tomas-tavella/Proyecto-Final/README.md

# Proyecto-Final
Repositorio para todo lo que respecta al proyecto final de pilas de hidrogeno
