tomas-tavella/Proyecto-Final/Bibliografia/Datasheets - Notas de aplicacion/Datasheets/DSP/Info ControlCARD TMS320F28335/F28335controlCARD HWDevPkg PGF [R1.0]/TMDSCNCD28335r1.0PGF/README.TXT

README.TXT               C2000 Marketing Group - Texas Instruments
==========				 files supplied by www.wstscorp.com

=====================================================================

=====================================================================

  This file has been divided into the following sections for easy
  reference:

	* =	JOB TRACKING NUMBER		  eg. TEX001DAT.zip

        1.  *DAT.ZIP - Pads V2007.4 Databse and Backups
        2.  *FAB.ZIP - Gerber Data for Fabracation House
        3.  *DWG.ZIP - AutoCad 2000, Assembly and Fabrication Drawings
        4.  *ASY.ZIP - Pads V2007.4 Data for Assembly House
        5.  *LIB.ZIP - Pads V2007.4 Decal and Part Library Files
		6.  *SCH.ZIP - Orcad/Powerlogic Schematic files
