tomas-tavella/Proyecto-Final/Bibliografia/Datasheets - Notas de aplicacion/Datasheets/DSP/Info ControlCARD TMS320F28335/F28335controlCARD HWDevPkg PGF [R1.0]/TMDSCNCD28335r1.0PGF/TEX24FAB/Readme.txt

Company Name:		TEXAS INSTRUMENTS
PC Board Name:		F28335 PGF ControlSTICK BOARD        
PC Board Number:	TMDSCNCD28335PGF
Revision:			1.0
Design House:		Willow Spring Technical Services, Corp.

Designed by:          Carl Sangiolo
Contact Number:       (508) 947 - 2709
e-mail:               carl@wstscorp.com
Files Included:

Filename		Description						Format
--------		-----------						------
L1.PHO			Primary Side Cu					Gerber 8.5
L2.PHO			Gnd Plane						Gerber 8.5
L3.PHO			Internal Signal					Gerber 8.5
L4.PHO			Internal Signal					Gerber 8.5
L5.PHO			Pwr Plane 						Gerber 8.5
L6.PHO			Secondary Side Cu				Gerber 8.5
PSS.PHO			Primary Silkscreen A/W			Gerber 8.5
PSM.PHO			Primary Soldermask A/W			Gerber 8.5
SSM.PHO			Secondary Soldermask A/W 		Gerber 8.5
PST.PHO			Primary Solder Stencil A/W 		Gerber 8.5
DD.PHO			Drill Drawing  					Gerber 8.5
NC_DRILL.DRL		NC Drill Data					NC DRILL ASCII																
NC_DRILL.REP		Drill Tool Listing				ASCII
NC_DRILL.LST		Drill X-Y Listing				ASCII
IPCD356.NET		IPC-D-356 Netlist				IPC-D-356 ASCII
README.TXT   	This File						ASCII

NOTES: 

1) USE FILM OUTLINE CORNERS TO ALIGN ARTWORKS

2) ALL THERMALS ARE O.D.  I.D.= O.D. - .020
   WITH A .015 OPEN AT 45 DEGREES.

3) ALL VIAS SHALL HAVE A DIRECT CONNECTION
   TO THE PLANE. NO THERMALS ON VIAS.
