tomas-tavella/Proyecto-Final/Informe/Secciones/Portada.tex

    \begin{titlepage}
        \AddToShipoutPictureBG*{}
        \begin{center}
            %\vspace*{0.1cm}
            \color{white}
            \HUGE\scshape
            \Bold{Diseño y Desarrollo de una Plataforma Experimental de Evaluación de Sistemas Híbridos Basados en Pilas de Combustible}    % Titulo
            \normalfont
            \\
            \vspace{1cm}
            %\tiny\ \xfill[8pt]{2pt}\ \linebreak
            \Huge
            \texttt{Proyecto Final\hspace{1.8em}\rule[-0.2em]{2pt}{1.1em}\hspace{1.8em}Tomás Tavella}                                       % Subtitulo
            \\
            \vfill
            \begin{figure}[H]
                \centering
                \begin{subfigure}{0.3\textwidth}
                    \centering
                    
                \end{subfigure}
                \hspace{2em}
                \begin{subfigure}{0.3\textwidth}
                    \centering
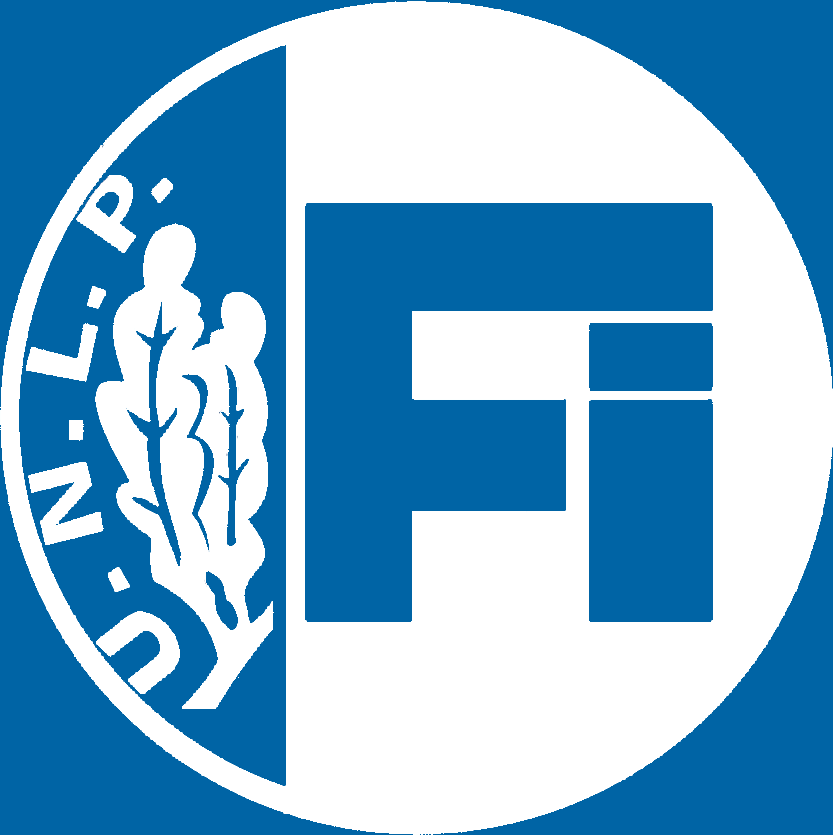
[picture p1: Informe/Imagenes/FI Invertido.png]
                    
                \end{subfigure}
            \end{figure}
            \vspace{0.5cm}
            \begin{multicols}{3}
                \large
                \texttt{Ing. Jorge L. Anderson}
                \\
                \vspace{0.1cm}
                \Large\scshape
                \SemiBold{Director}
                \\
                \normalfont
            \columnbreak
                \Bold\large\scshape
                Instituto LEICI
                \\
                \vspace{0.1cm}
                Facultad de Ingeniería
                \\
                \vspace{0.1cm}
                UNLP
                \\
            \columnbreak
                \vspace{0.1cm}
                \normalfont\large
                \texttt{Dr. Ing. Paul F. Puleston}
                \\
                \vspace{0.1cm}
                \Large\scshape
                \SemiBold{Co-Director}
                \normalfont
            \end{multicols}
        \end{center}
    \end{titlepage}
