tomas-tavella/Proyecto-Final/Informe PPS/Secciones/Portada.tex

    \begin{titlepage}
        \AddToShipoutPictureBG*{}
        \begin{center}
            %\vspace*{0.1cm}
            \color{white}
            \HUGE\scshape
            \Bold{Diseño y Fabricación de una Placa de Circuito Impreso de un Convertidor de Potencia Aislado para Sistema Experimental de Evaluación de Sistemas Híbridos}    % Titulo
            \normalfont
            \\
            \vspace{1cm}
            %\tiny\ \xfill[8pt]{2pt}\ \linebreak
            \Huge
            \texttt{Práctica Profesional Supervisada}\\                                       % Subtitulo
            \vspace{0.2cm}
            \texttt{Tomás Tavella}
            \vfill
            \begin{figure}[H]
                \centering
                \hspace{2.5em}
                \begin{subfigure}
                    \centering
                    
                \end{subfigure}
                \hspace{4em}
                \begin{subfigure}
                    \centering
                    
                \end{subfigure}
            \end{figure}
            \vspace{0.5cm}
            \begin{multicols}{3}
                \large
                \texttt{Ing. Jorge L. Anderson}
                \\
                \vspace{0.1cm}
                \Large\scshape
                \SemiBold{Docente\linebreak Supervisor}
                \\
                \normalfont
            \columnbreak
                \Bold\large\scshape
                Instituto LEICI
                \\
                \vspace{0.1cm}
                Facultad de Ingeniería
                \\
                \vspace{0.1cm}
                UNLP
                \\
            \columnbreak
                \vspace{0.1cm}
                \normalfont\large
                \texttt{Ing. Claus Mancini}
                \\
                \vspace{0.1cm}
                \Large\scshape
                \SemiBold{Profesional Responsable}
                \normalfont
            \end{multicols}
        \end{center}
    \end{titlepage}
