tomas-tavella/Proyecto-Final/Informe PPS/Secciones/2 - Desarrollo/2 - Desarrollo.tex

\section{Desarrollo} \label{desarrollo}
\AddToShipoutPictureBG*{}
\thispagestyle{plain}

\divider

Partiendo de los esquemas circuitales que conforman la plataforma, que en total cuenta con 185 componentes discretos, se procedió a su implementación en una placa de circuito impreso. Como guías generales para su diseño, se estableció que la PCB debía ser de doble capa, con unas dimensiones de aproximadamene \SI[]{15}[]{\centi\metre} x \SI[]{15}[]{\centi\metre}. En tanto a su construcción, se utiliza el sustrato FR-4 estándar (laminado de resina epoxi reforzado con vidrio) y vías de tipo PTH (del inglés \textit{Plated Through-Hole}). En la siguiente figura se puede observar un modelo tridimensional de la plaqueta finalizada, con todos los componentes en sus lugares correspondientes.\\

\begin{figure}[h]
    \centering
    
    \caption{Modelo tridimensional de la implementación en PCB de la plataforma
    con todos sus componentes, vista desde la parte superior.}
    \label{fig:plataforma_det}
\end{figure}

Con este fin se utilizo el software de diseño electrónico {\Medium KiCad}, una suite de software libre, gratuita y de código abierto que incluye todas la funcionalidades necesarias para el diseño electrónico. Cuenta con herramientas de captura de esquemático, diseño de PCB, simulación mediante SPICE o Ngspice, visualización de archivos de fabricación y cálculos de diseño de PCB. Dada la falta de experiencia con este tipo de software, las formas de utilización de la herramienta se aprendieron a medida que se iba completando el trabajo.\\

\newpage

\input{Secciones/2 - Desarrollo/2.1 - Activdades Realizadas.tex}

\newpage

\input{Secciones/2 - Desarrollo/2.2 - Dificultades y Contratiempos.tex}
