tomas-tavella/Proyecto-Final/Reference Designs/Proyecto Irusta-Caravelli/Altium/PCB_2D.PcbDoc.htm

Reporting Options

# File in Previous Format

Date | : | 4/28/2022
Time | : | 11:27:58 PM
Filename | : | D:\Personal\Repositorios\Proyecto-Final\Reference Designs\PF de Convertidor de Potencia\Altium\PCB_2D.PcbDoc

Version | Warning
Release 12 | CAUTION - Air Gap Width previously controlled by Clearance rule is now controlled by Polygon Connect Style rule's newly introduced Air Gap Width (set to default value). Suggest reviewing each Polygon Connect Style rule's Air Gap Width attribute for correctness.
Release 13 | CAUTION - Silkscreen Over Component Pads Rules are converted to Silk To Solder Mask Clearance Rules. Suggest examining rule scopes for accuracy.

This file was generated by an earlier version of the software
