tomas-tavella/Proyecto-Final/Reference Designs/Placa adaptadora TMS320F28335/Proyecto Altium/Project Outputs for Placa adaptadora TMS320F28335/Placa adaptadora TMS320F28335 - PCB.htm

Comment | Description | Designator | Footprint | LibRef | Quantity
C0.1u | Capacitor | C1, C4, C5, C16, C18, C19, C21, C22, C23, C24, C28, C29, C31, C32, C34, C36, C38, C39, C45 | C 1206 | C | 19
C? | Capacitor | C2, C3, C6, C7, C8, C9 | C 1206 | C | 6
C1u | Capacitor | C10, C27, C41 | 0805 | C | 3
C10n | Capacitor | C11, C14, C30, C42 | C 1206 | C | 4
CT2.2u | Tantalum capacitor | C12, C26, C43 | Tantalum | C Tantalum | 3
C27p | Capacitor | C13, C15 | C 1206 | C | 2
C33n | Capacitor | C17 | C 1206 | C | 1
C10u | Capacitor polarzado | C20, C46 | CAP4x7x1.5mm | Capacitor pol | 2
C10u | Capacitor polarzado | C25, C44 | Almn cap | Capacitor pol | 2
C1n | Capacitor | C33 | C 1206 | C | 1
C100p | Capacitor | C35 | C 1206 | C | 1
C0.1uF | Capacitor | C37 | C 1206 | C | 1
C22n | Capacitor | C40 | C 1206 | C | 1
LED | Typical RED GaAs LED | D1 | LED-1 | LED1 | 1
Dpy Amber-CA | 7.62 mm Black Surface Orange 7-Segment Display: CA, RH DP | DS1 | A | Dpy Amber-CA | 1
RJ-45 connector | RJ-45 connector, 8-pins, ethernet | J1 | 15-43-6588 | 15-43-6588 | 1
Jack connector | | J2 | jack | Jack connector | 1
DIM100 | Vertical, DIMM 2P Low Insertion Force, 100 Position | J3 | 390213-1 | 390213-1 | 1
Led smd | LED red, LED green, Led green, Led yellow, Led green, Led yellow | LED1, LED2, LED3, LED4, LED5, LED6 | LED 1206 | LED | 6
USB-B | Conector USB tipo B | P1 | USBB | USB-B | 1
sma | | P2, P3 | sma | sma | 2
Header 5 | Header, 5-Pin | P4, P12 | HDR1X5 | Header 5 | 2
Header 8 | Header, 8-Pin | P5 | HDR1X8 | Header 8 | 1
Header 7X2 | Header, 7-Pin, Dual row | P6 | HDR2X7 | Header 7X2 | 1
5V Header | Header, 2-Pin | P7, P13 | HDR1X2 | Header 2 | 2
5V SW | | P8 | Toggle sw | toggle sw | 1
Jumper 2 | | P9 | Jumper 2 | Jumper 2 | 1
Header 4 | Header, 4-Pin | P10, P11 | HDR1X4 | Header 4 | 2
Header | Header, 3-Pin | P14 | HDR1X3 | Header 3 | 1
IRF7425 | HEXFET Power MOSFET | Q1 | SO-8_L | IRF7425 | 1
R? | Resistencia | R1, R2, R3, R4, R6, R7 | R 1206 | R | 6
R1k | Resistencia | R5, R14, R15, R25, R26, R27, R28, R29, R30, R31, R32, R33, R34, R35, R36, R37, R38, R39, R40 | R 1206 | R | 19
R470 | Resistencia | R8 | R 1206 | R | 1
R27 | Resistencia | R9, R10 | R 1206 | R | 2
R1k5 | Resistencia | R11 | R 1206 | R | 1
R220 | Resistencia | R12, R13, R18, R22, R23, R24 | R 1206 | R | 6
R15 | Resistencia | R16, R17, R20 | R 1206 | R | 3
R10k | Resistencia | R19 | R 1206 | R | 1
R15k | Resistencia | R21, R44 | R 1206 | R | 2
R0 | Resistencia | R41, R42, R43 | R 1206 | R | 3
SW-DIP4 | DIP Switch | S1 | DIP-8 | SW-DIP4 | 1
Switch | | SW1, SW2, SW3, SW4, SW5 | TACT SW | Pulsador NA 4 term | 5
TP TEL3-1211 | | T1 | DIL24 | TP TEL3-1211 | 1
LM324AM | Low Power Quad Operational Amplifier, 14-pin Narrow SOIC | U1 | M14A_N | LM324AM | 1
TXB0104DR | IC VOLT-LEVEL TRANSLATOR 14-SOIC | U2 | SOIC-14 | TXB0104DR | 1
LP2985-33DBVR | Single Output Low Noise LDO, 150 mA, Fixed 3.3 V Output, 2.2 to 16 V Input, with Low IQ, 5-pin SOT-23 (DBV), -40 to 125 degC, Green (RoHS & no Sb/Br) | U3, U7, U10 | TI-DBV5_N | LP2985-10DBVR | 3
FT232BL | USB UART Asynchronous Serial Data Transfer Chip, LQFP-32, Pb-Free | U4 | LQFP-32_N | FT232BL | 1
ISO7631FMDWR | 150 Mbps 6 kVpk Low Power Quad Channels, Digital Isolator, 2.7 V / 3.3 V / 5 V, -40 to +125 degC, 16-pin SOIC (DW), Green (RoHS & no Sb/Br) | U5, U8 | DW0016A_N | ISO7641FMDWR | 2
LM2937-12 | | U6 | DCY4 | LM2937 | 1
uA78M33 | DAC8760 | U9 | PWP | DAC8760 | 1
Jumper | Jumper Wire | W1, W2, W3 | Jumper | Jumper | 3
Cristal de Cuarzo | Cristal de 6Mhz | Y1 | Y TRHU | Cristal de Cuarzo | 1
