tomas-tavella/Proyecto-Final/Reference Designs/Placa adaptadora TMS320F28335/Proyecto Altium/Project Outputs for Placa adaptadora TMS320F28335/Placa adaptadora TMS320F28335.htm

Comment | Description | Designator | Quantity | .PCBCheck
C0.1u | Capacitor | C1, C4, C5, C16, C18, C19, C21, C22, C23, C24, C28, C29, C31, C32, C34, C36, C38, C39, C45 | 19 | Used
C? | Capacitor | C2, C3, C6, C7, C8, C9 | 6 | Used
C1u | Capacitor | C10, C27, C41 | 3 | Used
C10n | Capacitor | C11, C14, C30, C42 | 4 | Used
CT2.2u | Tantalum capacitor | C12, C26, C43 | 3
C27p | Capacitor | C13, C15 | 2 | Used
C33n | Capacitor | C17 | 1 | Used
C10u | Capacitor polarzado | C20, C46 | 2
C10u | Capacitor polarzado | C25, C44 | 2
C1n | Capacitor | C33 | 1 | Used
C100p | Capacitor | C35 | 1 | Used
C0.1uF | Capacitor | C37 | 1 | Used
C22n | Capacitor | C40 | 1 | Used
LED | Typical RED GaAs LED | D1 | 1
Dpy Amber-CA | 7.62 mm Black Surface Orange 7-Segment Display: CA, RH DP | DS1 | 1
RJ-45 connector | RJ-45 connector, 8-pins, ethernet | J1 | 1
Jack connector | | J2 | 1
DIM100 | Vertical, DIMM 2P Low Insertion Force, 100 Position | J3 | 1
Led smd | LED red, LED green, Led green, Led yellow, Led green, Led yellow | LED1, LED2, LED3, LED4, LED5, LED6 | 6 | Used
USB-B | Conector USB tipo B | P1 | 1
sma | | P2, P3 | 2
Header 5 | Header, 5-Pin | P4, P12 | 2
Header 8 | Header, 8-Pin | P5 | 1
Header 7X2 | Header, 7-Pin, Dual row | P6 | 1
5V Header | Header, 2-Pin | P7, P13 | 2
5V SW | | P8 | 1
Jumper 2 | | P9 | 1
Header 4 | Header, 4-Pin | P10, P11 | 2
Header | Header, 3-Pin | P14 | 1
IRF7425 | HEXFET Power MOSFET | Q1 | 1
R? | Resistencia | R1, R2, R3, R4, R6, R7 | 6 | Used
R1k | Resistencia | R5, R14, R15, R25, R26, R27, R28, R29, R30, R31, R32, R33, R34, R35, R36, R37, R38, R39, R40 | 19 | Used
R470 | Resistencia | R8 | 1 | Used
R27 | Resistencia | R9, R10 | 2 | Used
R1k5 | Resistencia | R11 | 1 | Used
R220 | Resistencia | R12, R13, R18, R22, R23, R24 | 6 | Used
R15 | Resistencia | R16, R17, R20 | 3 | Used
R10k | Resistencia | R19 | 1 | Used
R15k | Resistencia | R21, R44 | 2 | Used
R0 | Resistencia | R41, R42, R43 | 3 | Used
SW-DIP4 | DIP Switch | S1 | 1
Switch | | SW1, SW2, SW3, SW4, SW5 | 5 | G
TP TEL3-1211 | | T1 | 1
LM324AM | Low Power Quad Operational Amplifier, 14-pin Narrow SOIC | U1 | 1
TXB0104DR | IC VOLT-LEVEL TRANSLATOR 14-SOIC | U2 | 1
LP2985-33DBVR | Single Output Low Noise LDO, 150 mA, Fixed 3.3 V Output, 2.2 to 16 V Input, with Low IQ, 5-pin SOT-23 (DBV), -40 to 125 degC, Green (RoHS & no Sb/Br) | U3, U7, U10 | 3
FT232BL | USB UART Asynchronous Serial Data Transfer Chip, LQFP-32, Pb-Free | U4 | 1
ISO7631FMDWR | 150 Mbps 6 kVpk Low Power Quad Channels, Digital Isolator, 2.7 V / 3.3 V / 5 V, -40 to +125 degC, 16-pin SOIC (DW), Green (RoHS & no Sb/Br) | U5, U8 | 2
LM2937-12 | | U6 | 1
uA78M33 | DAC8760 | U9 | 1
Jumper | Jumper Wire | W1, W2, W3 | 3
Cristal de Cuarzo | Cristal de 6Mhz | Y1 | 1 | Used
