tomas-tavella/Proyecto-Final/Reference Designs/Placa adaptadora TMS320F28335/Proyecto Altium/Project Outputs for Placa adaptadora TMS320F28335/Placa adaptadora TMS320F28335 - PCB.xls

Sheet: 佂⁍敒潰瑲 UI '
2015-05-13 | 13:56:07
0 | 0:00:00
C 1206 | C0.1u | C | Capacitor
C 1206 | C? | C | Capacitor
0805 | C1u | C | Capacitor
C 1206 | C10n | C | Capacitor
Tantalum | CT2.2u | C Tantalum | Tantalum capacitor
C 1206 | C27p | C | Capacitor
C 1206 | C33n | C | Capacitor
CAP4x7x1.5mm | C10u | Capacitor pol | Capacitor polarzado
Almn cap | C10u | Capacitor pol | Capacitor polarzado
C 1206 | C1n | C | Capacitor
C 1206 | C100p | C | Capacitor
C 1206 | C0.1uF | C | Capacitor
C 1206 | C22n | C | Capacitor
LED-1 | LED | LED1 | Typical RED GaAs LED
A | Dpy Amber-CA | Dpy Amber-CA | 7.62 mm Black Surface Orange 7-Segment Display: CA, RH DP
15-43-6588 | RJ-45 connector | 15-43-6588 | RJ-45 connector, 8-pins, ethernet
jack | Jack connector | Jack connector
390213-1 | DIM100 | 390213-1 | Vertical, DIMM 2P Low Insertion Force, 100 Position
LED 1206 | Led smd | LED | LED red, LED green, Led green, Led yellow, Led green, Led yellow
USBB | USB-B | USB-B | Conector USB tipo B
sma | sma | sma
HDR1X5 | Header 5 | Header 5 | Header, 5-Pin
HDR1X8 | Header 8 | Header 8 | Header, 8-Pin
HDR2X7 | Header 7X2 | Header 7X2 | Header, 7-Pin, Dual row
HDR1X2 | 5V Header | Header 2 | Header, 2-Pin
Toggle sw | 5V SW | toggle sw
Jumper 2 | Jumper 2 | Jumper 2
HDR1X4 | Header 4 | Header 4 | Header, 4-Pin
HDR1X3 | Header | Header 3 | Header, 3-Pin
SO-8_L | IRF7425 | IRF7425 | HEXFET Power MOSFET
R 1206 | R? | R | Resistencia
R 1206 | R1k | R | Resistencia
R 1206 | R470 | R | Resistencia
R 1206 | R27 | R | Resistencia
R 1206 | R1k5 | R | Resistencia
R 1206 | R220 | R | Resistencia
R 1206 | R15 | R | Resistencia
R 1206 | R10k | R | Resistencia
R 1206 | R15k | R | Resistencia
R 1206 | R0 | R | Resistencia
DIP-8 | SW-DIP4 | SW-DIP4 | DIP Switch
TACT SW | Switch | Pulsador NA 4 term
DIL24 | TP TEL3-1211 | TP TEL3-1211
M14A_N | LM324AM | LM324AM | Low Power Quad Operational Amplifier, 14-pin Narrow SOIC
SOIC-14 | TXB0104DR | TXB0104DR | IC VOLT-LEVEL TRANSLATOR 14-SOIC
TI-DBV5_N | LP2985-33DBVR | LP2985-10DBVR | Single Output Low Noise LDO, 150 mA, Fixed 3.3 V Output, 2.2 to 16 V Input, with Low IQ, 5-pin SOT-23 (DBV), -40 to 125 degC, Green (RoHS & no Sb/Br)
LQFP-32_N | FT232BL | FT232BL | USB UART Asynchronous Serial Data Transfer Chip, LQFP-32, Pb-Free
DW0016A_N | ISO7631FMDWR | ISO7641FMDWR | 150 Mbps 6 kVpk Low Power Quad Channels, Digital Isolator, 2.7 V / 3.3 V / 5 V, -40 to +125 degC, 16-pin SOIC (DW), Green (RoHS & no Sb/Br)
DCY4 | LM2937-12 | LM2937
PWP | uA78M33 | DAC8760 | DAC8760
Jumper | Jumper | Jumper | Jumper Wire
Y TRHU | Cristal de Cuarzo | Cristal de Cuarzo | Cristal de 6Mhz
 |  |  |  | 0

Sheet: 牐橯捥⁴湉潦浲瑡潩netPreview
13:56:07
2015-05-13
2015-05-13 13:56
