tomas-tavella/Proyecto-Final/Informe/Informe Trabajo Final.tex

\documentclass[10pt,twoside]{article}                           % Twoside para poder poner números en lados alternados

\usepackage[spanish,es-tabla]{babel}                                     % Configuración de lenguaje
\usepackage[a4paper,top=2cm,bottom=2cm,left=3cm,right=3cm,marginparwidth=1.75cm]{geometry}          % Configurar tamaño de pagina y márgenes
%\usepackage[a4paper, top=2cm, bottom=2cm, outer=0cm, inner=0cm]{geometry}
\usepackage{fancyhdr}
\usepackage[autostyle=true]{csquotes}
\usepackage[backend=biber,sorting=none]{biblatex}               % Paquete para bibliografía 
\addbibresource{Bibliografia.bib}                               % Llamo al archivo que contiene las referencias
\usepackage{amsmath}
\usepackage{amsfonts}
\usepackage{makecell}                                           % Para poder poner line breaks en tablas
\renewcommand\cellgape{\Gape[4pt]}
\usepackage{caption}                                            % Para que "Figura x.y" este en bold
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
    \hspace{-0.05em}\xfill[0.6ex]{1pt}\hspace{-0.05em}%
    \rule[-0.2em]{1pt}{1.1em}\color{AzulFI_dark}\hspace{0.5em}\rightmark\normalcolor\hspace{0.5em}\rule[-0.2em]{1pt}{1.1em}%
    }

\fancyhead[R,L]{}

\renewcommand{\headrulewidth}{0pt}
\setlength{\headheight}{12.60013pt}

\fancypagestyle{plain}{
    \fancyhead[L,C,R]{}
    %\fancyfoot[C]{}                                                    % Sólo va con el estilo viejo
    \renewcommand{\headrulewidth}{0pt}                                  % Para que no haya linea horizontal de encabezado en las páginas de índice y título de sección
}

% Parametros para setear como se muestra el codigo

\lstdefinestyle{mystyle}{                       
    backgroundcolor=\color{backcolour},
    commentstyle=\color{codegreen},
    keywordstyle=\color{magenta},
    numberstyle=\tiny\color{codegray},
    stringstyle=\color{codepurple},
    basicstyle=\ttfamily\scriptsize,
    breakatwhitespace=false,         
    breaklines=true,                 
    captionpos=b,                    
    keepspaces=true,                 
    numbers=left,                    
    numbersep=5pt,                  
    showspaces=false,                
    showstringspaces=false,
    showtabs=false,                  
    tabsize=4
}

\lstset{style=mystyle}

% Macro para divisores horizontales

\newcommand{\divider}                           
{
\vspace{0.4cm}
\begin{center}
    \tiny\ \xfill[8pt]{1pt}\ \ \linebreak
\end{center}
%\vspace{0.25cm}
\normalsize
}

% Macro para usar colorbox en ecuaciones

\newcommand{\highlight}[1]{\colorbox{AzulFI_light}{$\displaystyle #1$}}

% Macro para comillas

\newcommand{\quotes}[1]{``#1''}                 % Comando para double quotes

% Números de figura y ecuación por seccion (1.1 , 2.1, etc.)

\numberwithin{figure}{section}                  % Numeros de figura por seccion
\numberwithin{equation}{section}                % Numeros de ecuacion por seccion
\numberwithin{table}{section}

% Definir formato de titulos de secciones y subsecciones

\titleformat{\section}[display]                                     % display permite el numero en linea separada del nombre
{\raggedright\color{AzulFI_dark}\scshape\Bold\Huge\centering}       % Formato del título de seccion
{\normalcolor\tiny\ \Huge\xfill[8pt]{1pt}\rule[-0.2em]{1pt}{1.1em}\hspace{0.5em}\color{white}\thesection\normalcolor\hspace{0.5em}\rule[-0.2em]{1pt}{1.1em}\xfill[8pt]{1pt}\tiny\ }{0.5em}{}       % Formato del número de seccion

\titleformat{\subsection}[hang]{\raggedright\color{AzulFI_dark}\scshape\huge\Bold}{\thesubsection\quad}{0.5em}{}                      % Se agrega raggedright a todos para que no separe palabras en dos cuando tiene que hacer un line break

\titleformat{\subsubsection}[hang]{\raggedright\color{AzulFI_dark}\scshape\Large\Bold}{\thesubsubsection\quad}{0.5em}{}
\titleformat{\paragraph}[hang]{\raggedright\color{AzulFI_dark}\large\SemiBold}{}{0.5em}{}
\titleformat*{\subparagraph}{\raggedright\SemiBold}

% Formato de captions de figuras

\DeclareCaptionFormat{custom}
{%
    \SemiBold\scshape\color{AzulFI_dark} #1#2 \normalfont\normalcolor \textit{#3}                     % #1 es el número, #2 el separador y #3 el texto
}
\captionsetup{format=custom}

% Formato de Table of Contents (ToC)

\contentsmargin{1em}
\dottedcontents{section}[1.5em]{\large\vspace{0.4cm}\Bold\scshape\color{AzulFI_dark}}{1.5em}{0pc}      % Secciones en Bold en TableofContents
\dottedcontents{subsection}[4em]{\vspace{0.1cm}\Medium}{2.5em}{0.6pc}
\dottedcontents{subsubsection}[7.5em]{}{3.5em}{0.6pc}

\hyphenation{KiCad}         % Para que no separe KiCad en sílabas

%---------------------------------------------------------------------------------------------------------%
%------------------------------------------ Inicio de Documento ------------------------------------------%
%---------------------------------------------------------------------------------------------------------%

\begin{document}

    \nocite{*}                                                      % Se usa para que aparezcan todas la referencias del .bib sin tener que citarlas en el texto

    \newgeometry{top=2.3cm,bottom=2cm,left=1cm,right=1cm,marginparwidth=1.75cm}
    %\newpagecolor{AzulFI}\afterpage{\restorepagecolor\blankpage}    % Página en blanco entre portada y agradecimientos

    \input{Secciones/Portada.tex}
    \restoregeometry\blankpage
    
    \addtocounter{page}{-1}
    \newpage 
    \thispagestyle{empty}                                           % Para que no se muestre el número de página al final (igual contribuye a la cuenta total)
    \afterpage{\ncblankpage}

    \input{Secciones/Agradecimientos.tex}

    \newpage
    \thispagestyle{empty}
    \afterpage{\blankpage}

    \input{Secciones/Abstract.tex}

    \newpage
    \afterpage{\thispagestyle{plain}} 
    \thispagestyle{plain}
    \tableofcontents
    %\afterpage{\blankpage}
    \newpage

    \input{Secciones/1 - Introduccion/1 - Introduccion.tex}
    
    \newpage

    \input{Secciones/2 - Analisis de la Plataforma/2 - Analisis de la Plataforma.tex}

    \newpage

    \input{Secciones/3 - Diseno de la Plataforma/3 - Diseno de la Plataforma.tex}

    \newpage

    \input{Secciones/4 - Implementacion de la Plataforma/4 - Implementacion de la Plataforma.tex}

    \newpage

    \input{Secciones/5 - Puebas y Ensayos/5 - Pruebas y Ensayos.tex}

    \newpage

    \input{Secciones/Conclusiones.tex}

    \afterpage{\blankpage}\newpage
    \thispagestyle{plain}
    \printbibliography[heading=bibintoc,title={Referencias}]
    \thispagestyle{plain}
    
\end{document}
