tomas-tavella/Proyecto-Final/Informe/Secciones/Agradecimientos.tex

\huge
\scshape\color{AzulFI_dark}
\Bold{Agradecimientos}\\

\normalsize\normalfont\normalcolor

\itshape

\noindent
A mis padres, que desde siempre están a mi lado ayudándome para lo que sea,\\
tanto en las buenas como en las malas.\\

\noindent
A mi hermano y mi hermana, los mejores compañeros que podría haber pedido,\\
y con quienes comparto todos mis recuerdos.\\

\noindent
A todos mis amigos, que hicieron de esta fase de mi vida más alegre y disfrutable,\\
y sin quienes no la podría haber completado.\\
