tomas-tavella/Proyecto-Final/Informe/Secciones/5 - Puebas y Ensayos/5.4 - Resumen.tex

\subsection{Resumen}

En este capítulo, se pudo dar un cierre satisfactorio al trabajo llevado a cabo en este proyecto, ya que se pudo comprobar su funcionamiento correcto, operando dentro de los parámetros esperables.\\

Se comenzó por evaluar el funcionamiento de los circuitos de excitación sin ningún tipo de carga ni corriente significativa, de manera de realizar un ensayo inicial seguro, protegiendo los componentes de la placa. El ensayo fue exitoso, y procedió sin fallas, mostrando un comportamiento adecuado de los circuitos evaluados.\\

Una vez exitosos los primeros ensayos, se procedió a relevar el comportamiento del convertidor completo, en condiciones de carga bajas y moderadas que se podrían presentar en el uso de la plataforma. Si bien se identificó un problema significativo en el ringing, que podría amenazar la integridad de los componentes en ciertas condiciones, también se propuso una posible solución de fácil implementación para mitigar el problema. Además, se pudo comprobar el funcionamiento eficiente del sistema, que en ningún ensayo bajó de 90\% su eficiencia energética, incluso para bajas cargas.\\
