tomas-tavella/Proyecto-Final/Informe/Secciones/2 - Analisis de la Plataforma/2 - Analisis de la Plataforma.tex

\section{Análisis de la Plataforma} \label{analisis}
\AddToShipoutPictureBG*{}
\thispagestyle{plain}

\vspace{0.5cm}

\Large\scshape
\begin{center}
    {\Medium Planteo y estudio de la plataforma de evaluación\\ de celdas de combustible}
\end{center}
\normalfont
%\normalsize

\divider

En este capítulo, se realiza un detallado análisis de la Plataforma Experimental de Evaluación de Módulos de Celdas de Combustible de la figura \ref{diag_plataforma}, la cuál consiste en cuatro subsistemas o bloques distintos: 

\begin{itemize}
    \Medium \item Emulador de Celdas de Combustible
    \Medium \item Convertidor CC-CC Conmutado
    \Medium \item Sistema de Control
    \Medium \item Carga Electrónica Variable\\
\end{itemize}

\begin{figure}[h]
    \centering
    
    \caption{Diagrama de la plataforma experimental de evaluación, con sus cuatro bloques principales.}
    \label{diag_plataforma}
\end{figure}

Esta plataforma, con sus distintos bloques, se encarga de evaluar la \textit{performance} de celdas de combustible conectadas a un sistema híbrido de generación. Con este fin, un emulador de celdas de combustible toma el puesto de celdas de combustible reales, y una carga electrónica variable se utiliza para simular cualquier tipo de condiciones de carga que se deseen en el bus de CC. Para poder conectar el emulador a la carga, se debe implementar un subsistema (Convertidor CC-CC Conmutado) que adapte los niveles de tensión de salida del emulador de celdas a la tensión fija de salida en la carga, adicionando un módulo de control que monitorea los estados del convertidor, y los controla mediante los disparos de las llaves del puente completo.\\

El principal objetivo de este proyecto es el diseño e implementación de la etapa de adaptación de tensión (es decir, el convertidor con su sistema de control), pero se hace un estudio detallado de todas los componentes de la plataforma, de manera de obtener un entendimiento más completo de todo el sistema. Por esta razón, a continuación se hace un análisis en profundidad de cada una de las partes individuales, comenzando por el emulador de celdas de combustible.\\

\input{Secciones/2 - Analisis de la Plataforma/2.1 - Celdas de Combustible.tex}

\newpage

\input{Secciones/2 - Analisis de la Plataforma/2.2 - Convertidor CC-CC Conmutado.tex}

\newpage

\input{Secciones/2 - Analisis de la Plataforma/2.3 - Sistema de Control.tex}

\newpage

\input{Secciones/2 - Analisis de la Plataforma/2.4 - Carga Electronica Variable.tex}

\newpage

\input{Secciones/2 - Analisis de la Plataforma/2.5 - Resumen.tex}

\newpage
