tomas-tavella/Proyecto-Final/Informe/Imagenes/Git.pdf

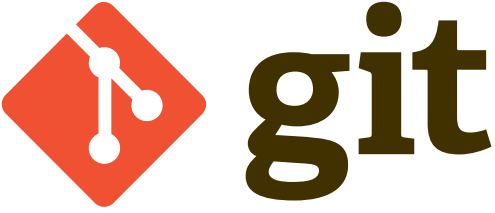
[picture p88: figure]
