tomas-tavella/Proyecto-Final/Informe/Imagenes/Duty Cycle.pdf

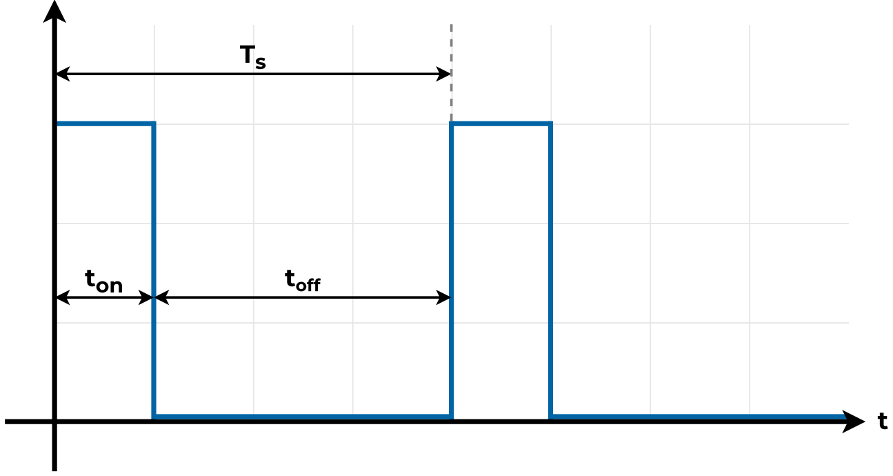
[picture p89: figure]
