tomas-tavella/Proyecto-Final/Reference Designs/Proyecto Irusta-Caravelli/Hojas de datos y notas de aplicación/Capacitores REC SR.pdf

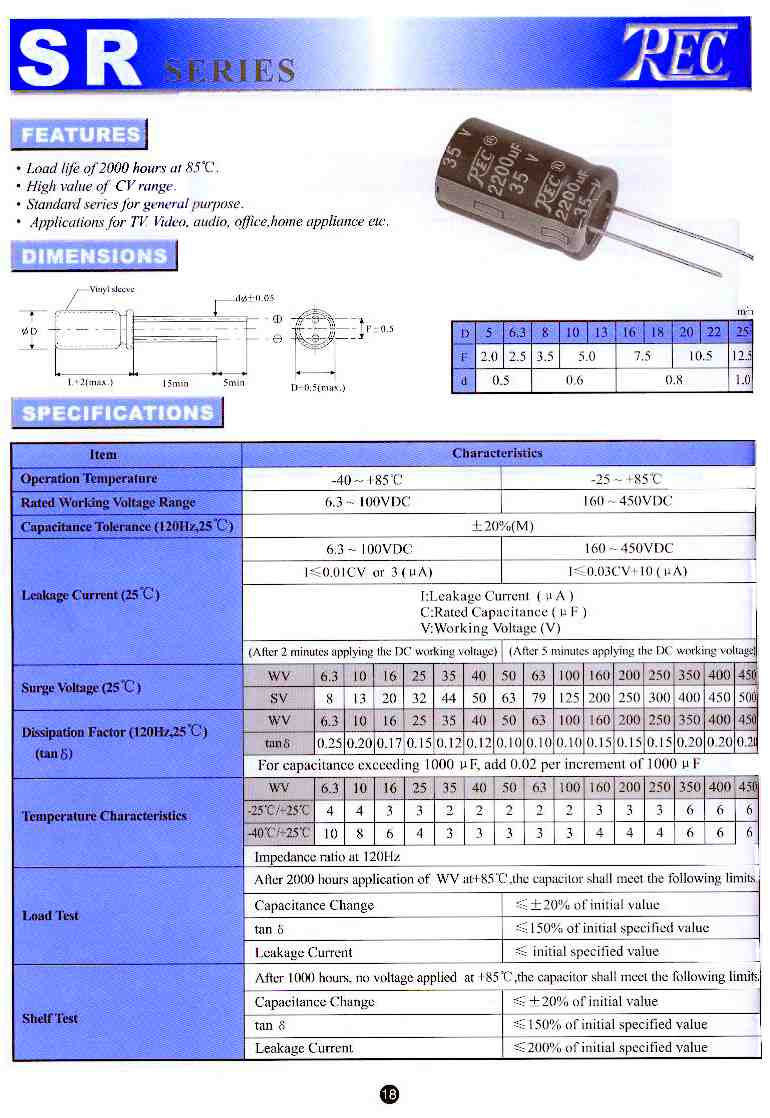
[picture p90: page 1]
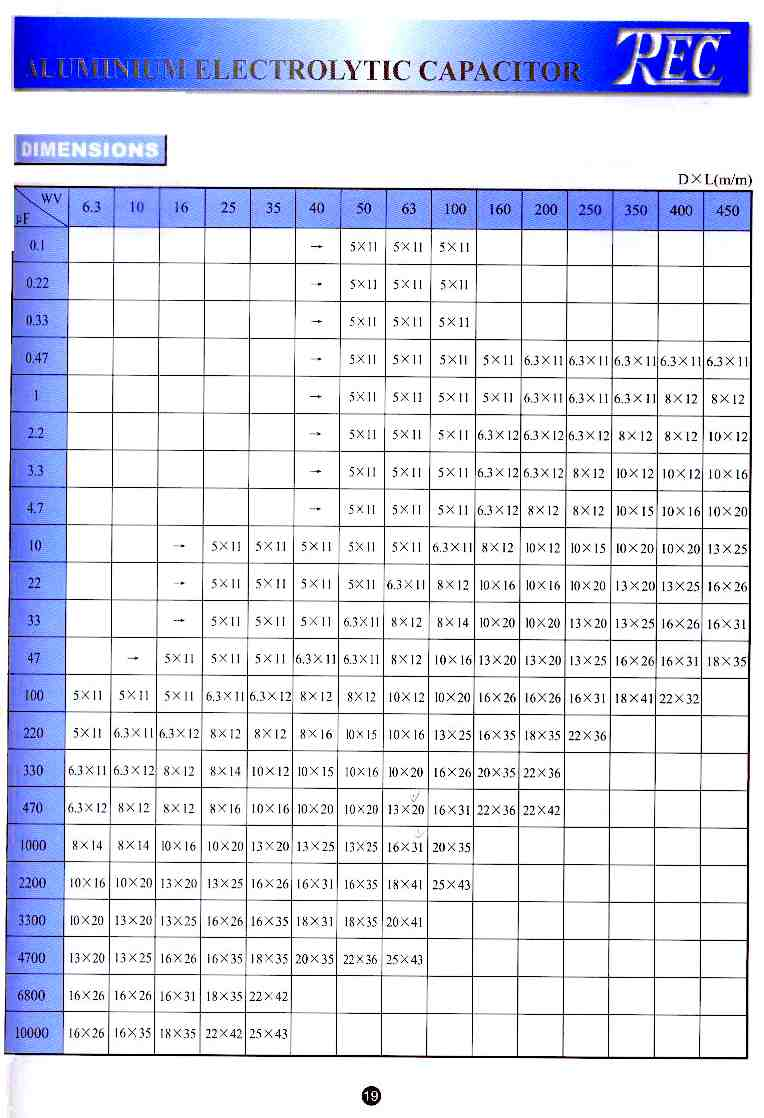
[picture p91: page 2]
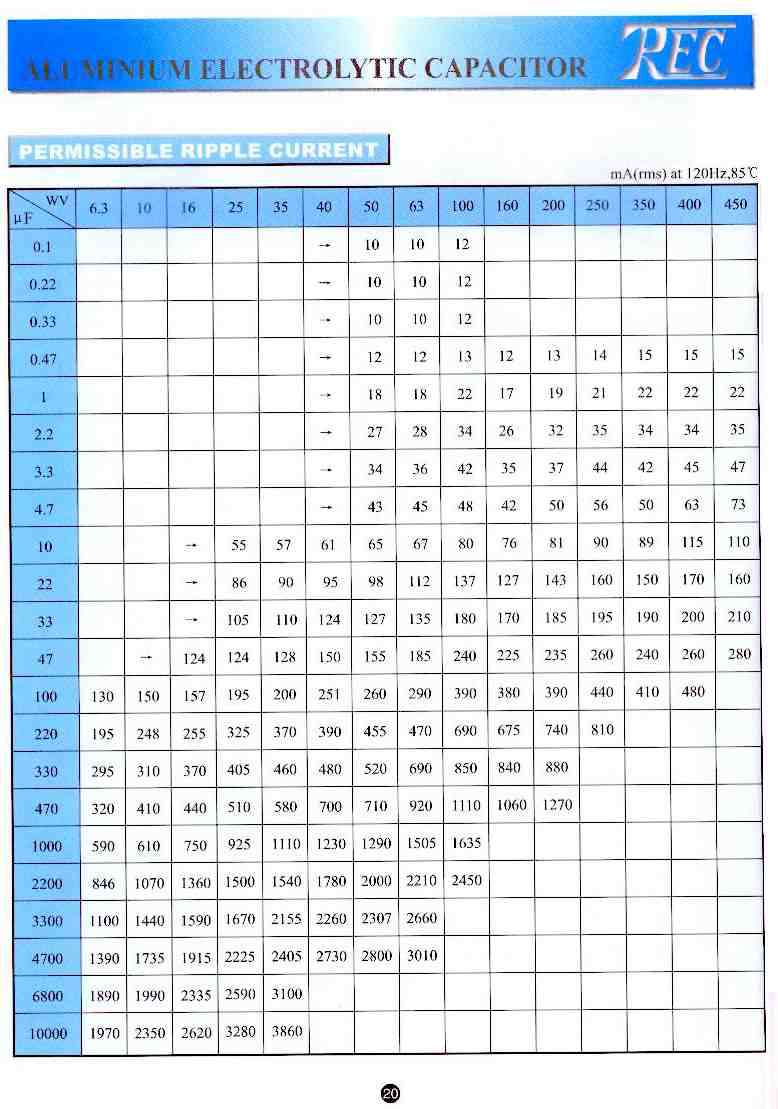
[picture p92: page 3]
