tomas-tavella/Proyecto-Final/Reference Designs/Firmware DSP/Librerias/f2833x/examples/eqep_freqcal/Example_freqcal.xls

150 MHz
 | CPU Freq | 150000000 |  |  | Inputs
 | Maximum Required Freq | 10000 | BaseFreq |  | Output information needed for configuration
 | Minimum Required Freq | 50 |  |  | Information
FREQ_UTIME | Freq measurement rate (Hz) | 100 | UTPRD | Unit Time period to be programmed for100Hz
 | Freq Resolution | 50
 | QEP Count at Max Freq | 200 | freqScalar_fr
FREQ_PRD | QEP edges for avg time measurement(2^k) | 4 | QCAPCTL.UPPS | Unit position prescalar to 1/4
 | Time for selected QEP edges at min RPM(s) | 0.04 | T= edges/(2*Fmin)
 | QEP CAP clock to avoid overflow(Hz) | 1638375 | Fcapmax=maxcnt/T
 | Minimum QEP Clock pre-scalar | 91.55413138
 | QEP Prescalar | 128 | QCAPCTL.CCPS | Capture clock prescaler to 1/128
 | CAP Count value at MAX freq(Freq Scalar) | 234 | freqScaler_pr
100 MHz
 | CPU Freq | 100000000 |  |  | Inputs
 | Maximum Required Freq | 10000 | BaseFreq |  | Output information needed for configuration
 | Minimum Required Freq | 50 |  |  | Information
FREQ_UTIME | Freq measurement rate (Hz) | 100 | UTPRD | Unit Time period to be programmed for100Hz
 | Freq Resolution | 50
 | QEP Count at Max Freq | 200 | freqScalar_fr
FREQ_PRD | QEP edges for avg time measurement(2^k) | 8 | QCAPCTL.UPPS | Unit position prescalar to 1/8
 | Time for selected QEP edges at min RPM(s) | 0.08 | T= edges/(2*Fmin)
 | QEP CAP clock to avoid overflow(Hz) | 819188 | Fcapmax=maxcnt/T
 | Minimum QEP Clock pre-scalar | 122.0721007
 | QEP Prescalar | 128 | QCAPCTL.CCPS | Capture clock prescaler to 1/128
 | CAP Count value at MAX freq(Freq Scalar) | 313 | freqScaler_pr
