tomas-tavella/Proyecto-Final/Reference Designs/Firmware DSP/Librerias/f2833x/examples/eqep_pos_speed/Example_posspeed.xls

150 MHz
 | CPU Freq | 150000000 |  |  | Inputs
 | Encoder Resolution (4xQEP Lines) | 4000 |  |  | Output information needed for configuration
 | Maximum Required Speed (RPM) | 6000 | BaseRpm |  | Information
 | Minimum Required Speed (Rpm) | 10
SPEED_FREQ | Speed measurement rate (Hz) | 100 | UTPRD | Unit Time period to be programmed for100Hz
 | Speed Resolutions(Rpm) | 1.5
SPEED_PRD | QEP edges for avg time measurement(2^k) | 32 | QCAPCTL.UPPS | Unit position prescalar to 1/32
 | Time for selected QEP edges at min RPM(s) | 0.048 | T=(edgecnt/enc_resol)* (fmin_prd) | Time it takes 32 edges to occur
 | QEP CAP clock to avoid overflow(Hz) | 1365313 | QPOSCNTmax/T
 | Minimum QEP Clock pre-scalar | 109.8649174 | SYSCLKOUT/CAPCLK
 | QEP Prescalar | 128 | QCAPCTL.CCPS | Capture clock prescaler to 1/128
 | CAP Count value at MAX speed(Speed Scalar) | 94 | SpeedScaler
100 MHz
 | CPU Freq | 100000000 |  |  | Inputs
 | Encoder Resolution (4xQEP Lines) | 4000 |  |  | Output information needed for configuration
 | Maximum Required Speed (RPM) | 6000 | BaseRpm |  | Information
 | Minimum Required Speed (Rpm) | 10
SPEED_FREQ | Speed measurement rate (Hz) | 100 | UTPRD | Unit Time period to be programmed for100Hz
 | Speed Resolutions(Rpm) | 1.5
SPEED_PRD | QEP edges for avg time measurement(2^k) | 32 | QCAPCTL.UPPS | Unit position prescalar to 1/32
 | Time for selected QEP edges at min RPM(s) | 0.048 | T=(edgecnt/enc_resol)* (fmin_prd) | Time it takes 32 edges to occur
 | QEP CAP clock to avoid overflow(Hz) | 1365313 | QPOSCNTmax/T
 | Minimum QEP Clock pre-scalar | 73.24327828 | SYSCLKOUT/CAPCLK
 | QEP Prescalar | 128 | QCAPCTL.CCPS | Capture clock prescaler to 1/128
 | CAP Count value at MAX speed(Speed Scalar) | 63 | SpeedScaler
