tomas-tavella/Proyecto-Final/Conversor/Cuentas Circuito Proteccion.png

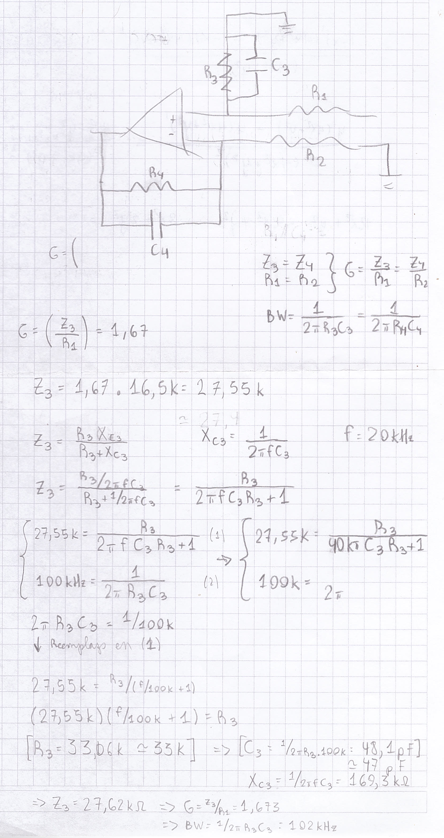
Conversor/Cuentas Circuito Proteccion.png
