tomas-tavella/Proyecto-Final/Conversor/Esquematico/Diagrama.png

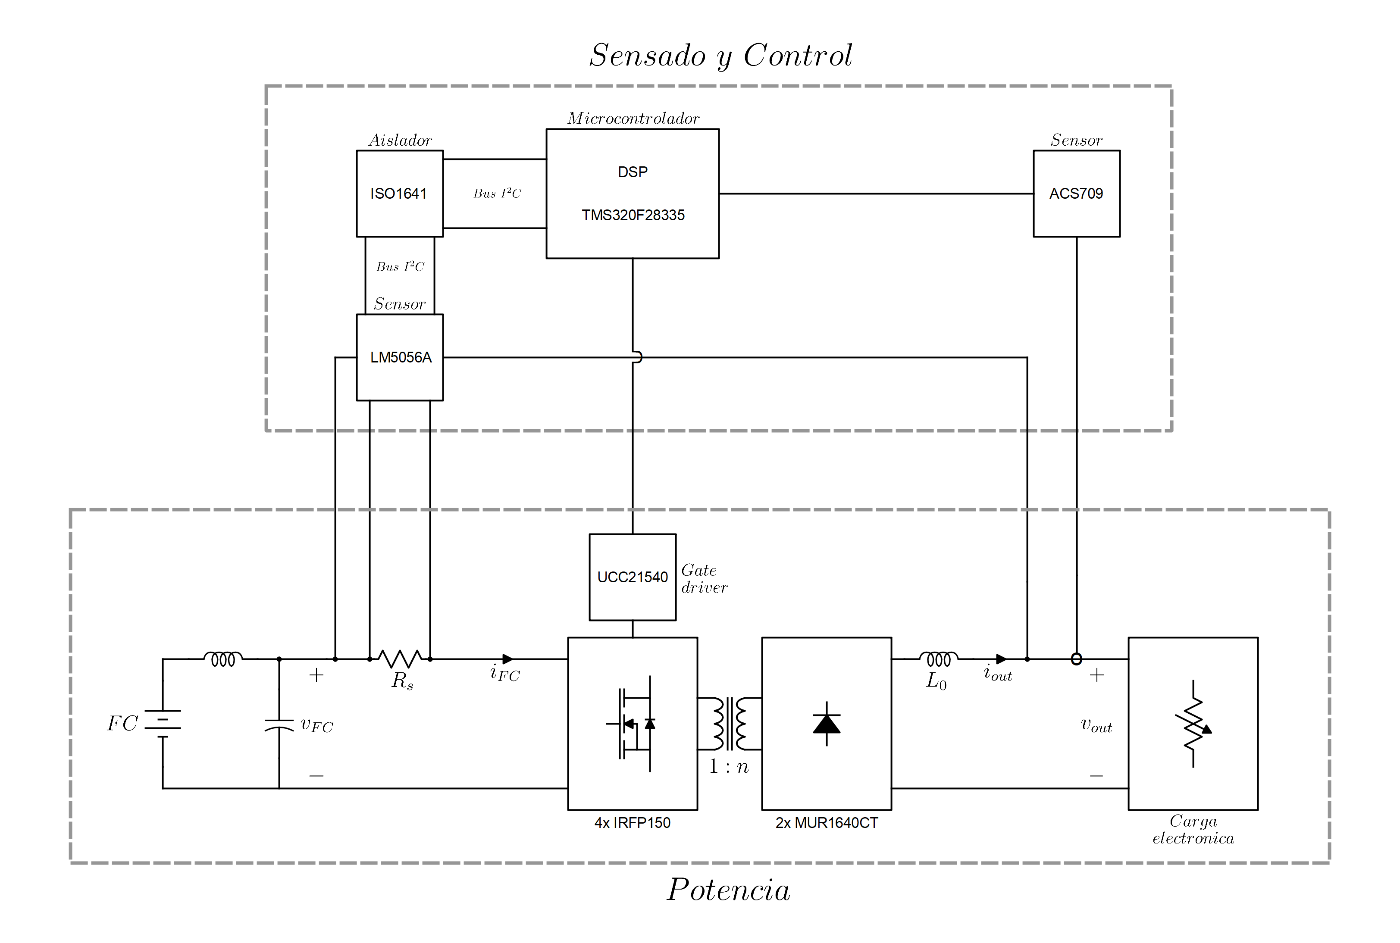
Conversor/Esquematico/Diagrama.png
