tomas-tavella/Proyecto-Final/Reference Designs/Proyecto Irusta-Caravelli/Fotos/P1020036.JPG

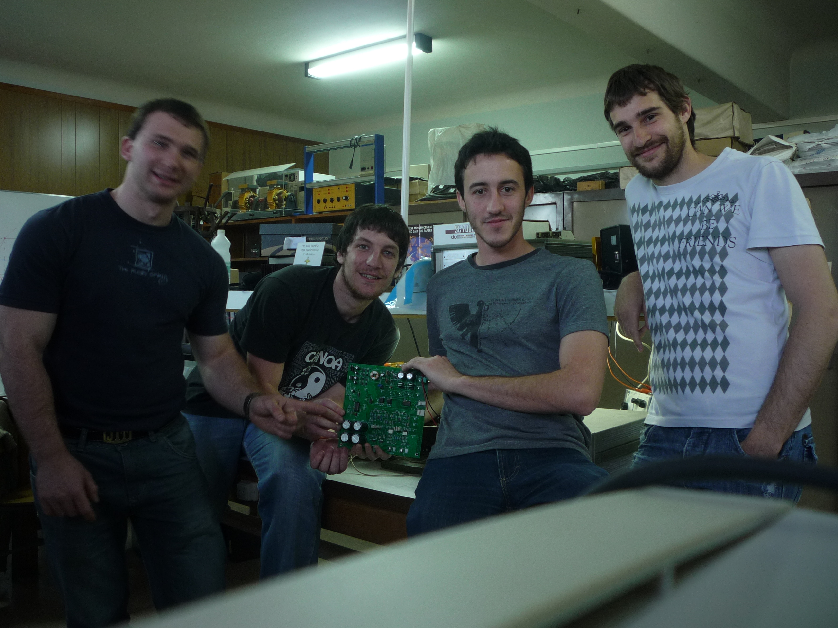
Reference Designs/Proyecto Irusta-Caravelli/Fotos/P1020036.JPG
