tomas-tavella/Proyecto-Final/Reference Designs/Proyecto Irusta-Caravelli/Fotos/P1020132.JPG

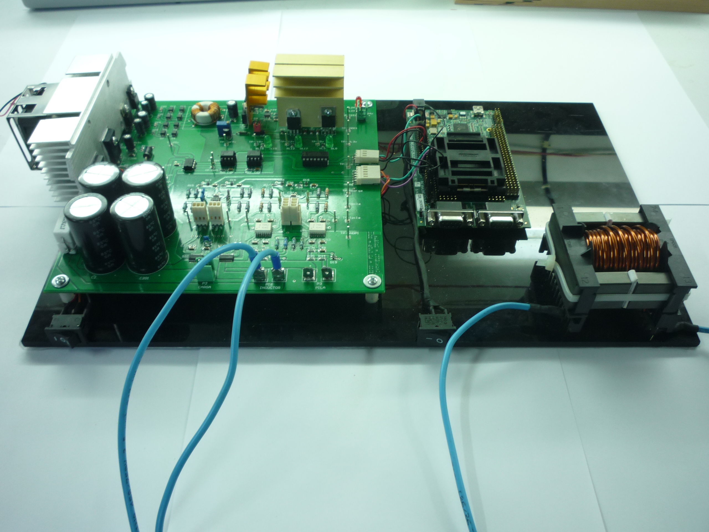
Reference Designs/Proyecto Irusta-Caravelli/Fotos/P1020132.JPG
