tomas-tavella/Proyecto-Final/componentes.md

# Eleccion de componentes para el circuito

- Diodos: MUR860 x4 Ultrafast rectifiers 8.0A, 600V -- Disponible en Elemon (para diodos del puente)
		  MUR160 x2 Ultrafast rectifiers 1.0A, 600V (para Dboot)
		  1N4148 x4 High-speed diodes (para Roff en los drivers)
		  MBR0520 Schottky diode (proteccion de sobretension en salida de op-amp)

- Llaves: MOSFET IRFP150 x4 (100V de Vdsmax, 30A de Idmax y Rds(on) de 55mohm) -- Hay en el laboratorio -- Paquete TO-247AC

- Drivers: Infineon Technologies 2ED21834-S06J 650 V half-bridge gate driver with integrated bootstrap diode -- Paquete DSO-14

- Isolator: Texas Instruments ISO7242C Quad-Channel Digital Isolator -- Paquete SOIC-16 (En el laboratorio)
 	   
- Optoacopladores: Broadcom ACPL-P480 High CMR Intelligent Power Module and Gate Drive Interface Optocoupler  -- Paquete SO-6

- Sensor I/V/P: Texas Instuments LM5056A 3 to 80V, 12-bit, I2C output -- Paquete HSSTOP-28 (con pad abajo)

- Sensor efecto hall: Texas Instruments TMCS1100A4 1% High-Precision, Basic Isolation Hall-Effect Current Sensor With ±600V Working Voltage -- Paquete SOIC-8

- DSP/MCU: Plaqueta Texas Instruments TMDSCNCD28335 -- TMS320F28335 DSP -- Slot DIMM100

- Fuente aislada para parte digital: TRACO THB 3-1211 9-18 Vdc in

- Reguladores: Fairchild Semi LM7805 3-Terminal 1A Positive Voltage Regulator (para +5VP) -- Paquete TO-252/D-PAK
               Texas Instruments LP2985 150-mA, Low-Noise, Low-Dropout Regulator With Shutdown -- Paquete SOT-23-5 (Usado en placa adaptadora)

- Op-Amp: Texas Instruments OPA365AID 50-MHz, Zerø-Crossover, Low-Distortion, High CMRR, RRI/O, Single-Supply Operational Amplifier -- Paquete SOIC-8
