tomas-tavella/Proyecto-Final/Conversor/Compra Componentes/Componentes DICOMSE.xlsx

Capacitores
Tipo | Valor | Cantidad | Empaquetado
Tantalio SMD | 4.7uF - 25V | 10 | 3528
Resistencias
Tipo | Valor | Cantidad | Empaquetado
Diodos
Tipo | Valor | Cantidad | Empaquetado
Transistores
Tipo | Valor | Cantidad | Empaquetado
Circuitos integrados
Tipo | Valor | Cantidad | Empaquetado
Otros
Tipo | Valor | Cantidad | Empaquetado
Tira pines macho | 1x40 | 10 | THT P2.54mm
