tomas-tavella/Proyecto-Final/Conversor/Compra Componentes/Componentes Microelectronica.xlsx

Capacitores
Tipo | Valor | Cantidad | Empaquetado
Cerámico SMD | 0.1uF | 50 | 1206 (3216) | Faltan
Aluminio SMD | 10uF - 10V | 10 | D=3mm L=5.4mm | Hay de 10uF pero son electroliticos THT
Resistencias
Tipo | Valor | Cantidad | Empaquetado
Resistencia SMD | 3.3k (5%) | 50 | 1206 (3216)
Diodos
Tipo | Valor | Cantidad | Empaquetado
Otros
Tipo | Valor | Cantidad | Empaquetado
Cristal | 6MHz | 2 | THT
Switch Pulsador 4 pines | - | 20 | THT
Llave Palanca 3 patas | - | 5 | LP-SW-213CI | https://www.microelectronicash.com/lp-sw-213ci--det--LP-SW-213CI
Conector jack | - | 2 | JK-DC021 | https://www.microelectronicash.com/jk-dc021--det--JK-DC021
