tomas-tavella/Proyecto-Final/Bibliografia/Datasheets - Notas de aplicacion/Datasheets/DSP/DIM100ExperimentersKit-HWdevPkg_v2_0/R2/BH28xxxDockingStn-BOM[R2].xls

Sheet: Sheet1
BH28xxx Docking Station [R2]
Item | Description | Digikey Part # | Mouser Part # | Comments
U1 | Linear - 3.3 Vreg - TPS79533 | 296-13810-1
C1 | Cer. Cap - 1u, 16V, X7R, 0805 | 399-1284-2
C2 | Cer. Cap - 4u7, 10V, X7R, 0805 | 445-1605-2
C3 | Cer. Cap - 100n, X7R, 0805, decoupling
R1 | Res. - 470R, 5%, 0.1W, 0805
LD1 | LED, green, low current, 0805 | P516CT
JP1 | Power jack 2.5 x 5.5 mm | CP-002BH
SW1 | Miniture SPDT switch PCB mount | CKN1072
J1 | 100 pin DIMM socket - Molex 0876301001 |  | 538-87630-1001
J2 | standard 0.1" pin (DIL) headers 14 pin (2x7) |  |  | Remove pin 6
J3, 4,5,6,7,8 | standard 0.1" pin (SIL) headers cut to length
Boot-280xx | standard 0.1" pin (DIL) headers 6 pin (2x3)
Boot-2833x | standard 0.1" pin (DIL) headers 8 pin (2x4)

Sheet: Sheet2
BH28044 | DIM100
C1 | 22u
C1 | 1u
C1 | 4u7
C2 | 10u
C2 | 100n
C2 | 47u
C3 | 330u
C3 | 4u7
C4 | 10n
C4 | 100n
C5 | 330u
C5 | 47u
C6 | 330u
C7 | 330u
C8 | 330u
C9 | 1u
COMMS
J1 | JMP
JP1 | 12V in
JTAG | DIL-14
LED
LED1
LED2
LED3
LED4
LED5
LED6
LED7
LED8
M1 | PTH08D110W
M2 | PTH08D110W
M3 | PTH08D110W
M4 | PTH08D110W
M5 | PTH08D110W
M6 | PTH08D110W
M7 | PTH08D110W
M8 | PTH08D110W
M9 | PTH08080
PR1 | ?
PR2 | ?
PR3 | ?
Q1 | IRFR024N
R1 | 5K
R1 | 330R
R1 | 270R
R1 | 100R
R2 | 10R
R2 | 1K5
R2 | 330R
R3 | 330R
R4 | 5K
R5 | 5K
RL | 330R
RN1 | RNx9
SW1 | SPDT
U1 | TPS79533
U1 | TSOP32238
U1 | UCC27424
U2 | HC595
U3 | SN74LV4051A
