tomas-tavella/Proyecto-Final/Conversor/Proyecto-KiCAD/Proyecto-KiCAD.ods

Component Count: | 185
Ref | Q | Value | Footprint | Description
C1, C2, C3, | 3 | C | Capacitor_THT:CP_Radial_D4.0mm_P2.00mm | Electrolítico pitch 2mm
C4, | 1 | 1nF | Capacitor_SMD:C_1206_3216Metric_Pad1.33x1.80mm_HandSolder | Cerámico SMD 1206 (3216)
C5, C6, C10, C11, C13, C18, C20, C25, C26, C27, C28, C37, C48, C49, C50, C55, C56, C59, | 18 | 0.1uF | Capacitor_SMD:C_1206_3216Metric_Pad1.33x1.80mm_HandSolder | Cerámico SMD 1206 (3216)
C7, | 1 | 10pF | Capacitor_SMD:C_1206_3216Metric_Pad1.33x1.80mm_HandSolder | Cerámico SMD 1206 (3216)
C8, C9, | 2 | 47pF | Capacitor_SMD:C_1206_3216Metric_Pad1.33x1.80mm_HandSolder | Cerámico SMD 1206 (3216)
C12, C23, C29, C30, C54, C58, | 6 | 10nF | Capacitor_SMD:C_1206_3216Metric_Pad1.33x1.80mm_HandSolder | Cerámico SMD 1206 (3216)
C14, C15, C22, C31, C32, C53, | 6 | 1uF | Capacitor_SMD:C_1206_3216Metric_Pad1.33x1.80mm_HandSolder | Cerámico SMD 1206 (3216)
C16, | 1 | 0.33uF | Capacitor_SMD:C_1206_3216Metric_Pad1.33x1.80mm_HandSolder | Cerámico SMD 1206 (3216)
C17, | 1 | 4.7uF | Capacitor_Tantalum_SMD:CP_EIA-3528-12_Kemet-T | Tantalio SMD (3528)
C19, | 1 | 4.7uF | Capacitor_SMD:CP_Elec_3x5.4 | Aluminio SMD pitch 3mm
C21, | 1 | 10uF | Capacitor_SMD:CP_Elec_3x5.4 | Aluminio SMD pitch 3mm
C24, | 1 | 2.2uF | Capacitor_SMD:C_1206_3216Metric_Pad1.33x1.80mm_HandSolder | Cerámico SMD 1206 (3216)
C33, C34, | 2 | 0.2uF | Capacitor_SMD:C_1206_3216Metric_Pad1.33x1.80mm_HandSolder | Cerámico SMD 1206 (3216)
C35, C36, | 2 | 3.3uF | Capacitor_THT:CP_Radial_D4.0mm_P2.00mm | Electrolítico pitch 2mm
C38, C47, | 2 | 680uF | Capacitor_THT:CP_Radial_D25.0mm_P10.00mm_SnapIn | Electrolítico pitch 10mm D25mm (de filtrado de entrada y salida)
C39, C40, C41, C42, | 4 | C | Capacitor_SMD:C_1206_3216Metric_Pad1.33x1.80mm_HandSolder | Cerámico SMD 1206 (3216)
C43, C44, C45, C46, | 4 | C | Capacitor_THT:CP_Radial_Tantal_D4.5mm_P2.50mm | Tantalio THT pitch 2.5mm
C51, C52, | 2 | 27pF | Capacitor_SMD:C_1206_3216Metric_Pad1.33x1.80mm_HandSolder | Cerámico SMD 1206 (3216)
C57, | 1 | 10uF | Capacitor_THT:CP_Radial_D4.0mm_P1.50mm | Electrolítico pitch 1.5mm
C60, | 1 | 2.2uF | Capacitor_THT:CP_Radial_D4.0mm_P2.00mm | Electrolítico pitch 2mm
C61, | 1 | 33nF | Capacitor_SMD:C_1206_3216Metric_Pad1.33x1.80mm_HandSolder | Cerámico SMD 1206 (3216)
D1, D2, D3, D4, | 4 | MUR860 | Package_TO_SOT_THT:TO-220F-2_Vertical | Diodo Potencia TO-220 Vertical
D5, D6, D7, D8, | 4 | 1N4148 | Diode_THT:D_DO-35_SOD27_P7.62mm_Horizontal | Diodo THT pitch 7.62mm
D9, | 1 | MBR0520 | Diode_SMD:D_SOD-123 | Diodo Schottky SMD
D10, D11, | 2 | BAS40-04 | Package_TO_SOT_SMD:SOT-23 | Diodo Schottky SMD SOT-23 (3 Pines)
J3, | 1 | Barrel_Jack_Switch | Connector_BarrelJack:BarrelJack_GCT_DCJ200-10-A_Horizontal | Barrel Jack 3 Pines
J4, J5 | 2 | Header Screw | Phoenix-Contact-2P:Phoenix-Contact-2P | Screw Terminal de +5VD y VDDA (12V)
J6, J7, J8, J9, J10 | 5 | Screw Terminal | DegsonScrewTerminal:Degson_Screw_Terminal_block_01x02 | Screw Terminal Grande (Emulador, trafo, inductor y carga)
J11, | 1 | DIMM100 | 5390213-1:TE_5390213-1
LED1, LED2, LED3, LED4, LED5, LED6, | 6 | Led smd | Diode_SMD:D_1206_3216Metric_Pad1.42x1.75mm_HandSolder | LED SMD 1206 (3216)
P1, P2, | 2 | Switch | Connector_PinHeader_2.54mm:PinHeader_1x03_P2.54mm_Vertical | Switch Selector 5V y VDDA
P3, | 1 | 5V Header | Connector_PinHeader_2.54mm:PinHeader_1x02_P2.54mm_Vertical | Header Vertical pitch 2.54mm – 1x2
P4, | 1 | Jumper 2 | Connector_PinHeader_2.54mm:PinHeader_1x03_P2.54mm_Vertical | Jumper/Header pitch 2.54mm – 1x3
P5, | 1 | Header 7X2 | Connector_PinSocket_2.54mm:PinSocket_2x07_P2.54mm_Vertical | Conector J-TAG pitch 2.54mm – 2x7
P6, | 1 | Header UART | Connector_PinSocket_2.54mm:PinSocket_1x04_P2.54mm_Vertical | Header Vertical pitch 2.54mm - 1x4
P7, | 1 | Header I2C | Connector_PinHeader_2.54mm:PinHeader_1x04_P2.54mm_Vertical | Header Vertical pitch 2.54mm – 1x4
P8, | 1 | Header PWM | Connector_PinHeader_2.54mm:PinHeader_1x08_P2.54mm_Vertical | Header Vertical pitch 2.54mm – 1x8
P9, | 1 | Header ADC | Connector_PinHeader_2.54mm:PinHeader_1x05_P2.54mm_Vertical | Header Vertical pitch 2.54mm – 1x5
P10, | 1 | Header GPIO | Connector_PinHeader_2.54mm:PinHeader_1x08_P2.54mm_Vertical | Header Vertical pitch 2.54mm – 1x8
P11, | 1 | Header SD | Connector_PinSocket_2.54mm:PinSocket_1x06_P2.54mm_Horizontal | Header Socket Horizontal pitch 2.54mm – 1x6 (Lector de SD)
P12, | 1 | USB-B | Connector_USB:USB_B_Lumberg_2411_02_Horizontal | USB Type B connector
Q1, Q2, Q3, Q4, | 4 | IRFP150 | Package_TO_SOT_THT:TO-247-3_Vertical | MOSFET THT TO-247 Vertical - 3 pines (Transistores Potencia)
Q5, | 1 | MMBT3904 | Package_TO_SOT_SMD:SOT-23 | BJT SMD SOT-23 – 3 pines (Adaptación de I2C)
Q6, | 1 | IRF7425 | Package_SO:SOIC-8_3.9x4.9mm_P1.27mm | Power MOSFET SMD SOIC-8 (Circuito del FTDI)
R1, R2, R3, R23, R24, R25, R26, | 7 | R | Resistor_SMD:R_1206_3216Metric_Pad1.30x1.75mm_HandSolder | SMD 1206 (3216)
R4, R5, R15, R49, | 4 | 4.7k | Resistor_SMD:R_1206_3216Metric_Pad1.30x1.75mm_HandSolder | SMD 1206 (3216)
R6, | 1 | 2.49k | Resistor_SMD:R_1206_3216Metric_Pad1.30x1.75mm_HandSolder | SMD 1206 (3216)
R7, | 1 | 612 | Resistor_SMD:R_1206_3216Metric_Pad1.30x1.75mm_HandSolder | SMD 1206 (3216)
R8, | 1 | 22 | Resistor_SMD:R_1206_3216Metric_Pad1.30x1.75mm_HandSolder | SMD 1206 (3216)
R9, | 1 | 3.12k | Resistor_SMD:R_1206_3216Metric_Pad1.30x1.75mm_HandSolder | SMD 1206 (3216)
R10, | 1 | 84.5 | Resistor_SMD:R_1206_3216Metric_Pad1.30x1.75mm_HandSolder | SMD 1206 (3216)
R11, R12, | 2 | 27.4k | Resistor_SMD:R_1206_3216Metric_Pad1.30x1.75mm_HandSolder | SMD 1206 (3216)
R13, R14, | 2 | 16.5k | Resistor_SMD:R_1206_3216Metric_Pad1.30x1.75mm_HandSolder | SMD 1206 (3216)
R16, R17, R18, R19, | 4 | 5.6 | Resistor_SMD:R_1206_3216Metric_Pad1.30x1.75mm_HandSolder | SMD 1206 (3216)
R20, R21, | 2 | 2 | Resistor_SMD:R_1206_3216Metric_Pad1.30x1.75mm_HandSolder | SMD 1206 (3216)
R22, | 1 | 0.004 | Resistor_SMD:R_Shunt_Vishay_WSK2512_6332Metric_T2.21mm | Shunt SMD 2512 (6332) (Resistor 4mohm MercadoLibre)
R27, R28, R29, R30, | 4 | R | Resistor_THT:R_Axial_DIN0204_L3.6mm_D1.6mm_P5.08mm_Horizontal | THT pitch 5.08mm (Paralelo diodos potencia)
R31, R33, R35, R37, R45, R46, | 6 | 220 | Resistor_SMD:R_1206_3216Metric_Pad1.30x1.75mm_HandSolder | SMD 1206 (3216)
R32, R34, R36, R38, R39, R41, | 6 | 1k | Resistor_SMD:R_1206_3216Metric_Pad1.30x1.75mm_HandSolder | SMD 1206 (3216)
R40, | 1 | 470 | Resistor_SMD:R_1206_3216Metric_Pad1.30x1.75mm_HandSolder | SMD 1206 (3216)
R42, R43, | 2 | 27 | Resistor_SMD:R_1206_3216Metric_Pad1.30x1.75mm_HandSolder | SMD 1206 (3216)
R44, | 1 | 1k5 | Resistor_SMD:R_1206_3216Metric_Pad1.30x1.75mm_HandSolder | SMD 1206 (3216)
R47, R48, R50, | 3 | 0 | Resistor_SMD:R_1206_3216Metric_Pad1.30x1.75mm_HandSolder | SMD 1206 (3216)
SW1, SW2, SW3, SW4, SW5, | 5 | Switch | Button_Switch_THT:SW_PUSH_6mm | Pulsador THT pitch 6mm
TP1, | 1 | TP-GNDD | TestPoint:TestPoint_THTPad_2.0x2.0mm_Drill1.0mm | test point
TP2, | 1 | TP-VG1 | TestPoint:TestPoint_THTPad_2.0x2.0mm_Drill1.0mm | test point
TP3, | 1 | TP-VG3 | TestPoint:TestPoint_THTPad_2.0x2.0mm_Drill1.0mm | test point
TP4, | 1 | TP-VG2 | TestPoint:TestPoint_THTPad_2.0x2.0mm_Drill1.0mm | test point
TP5, | 1 | TP-VG4 | TestPoint:TestPoint_THTPad_2.0x2.0mm_Drill1.0mm | test point
TP6, | 1 | TP-GND1 | TestPoint:TestPoint_THTPad_2.0x2.0mm_Drill1.0mm | test point
TP7, | 1 | TP-GND2 | TestPoint:TestPoint_THTPad_2.0x2.0mm_Drill1.0mm | test point
TP8, | 1 | VAUX | TestPoint:TestPoint_THTPad_2.0x2.0mm_Drill1.0mm | test point
U1, | 1 | OPA365xxD | Package_SO:SOIC-8_3.9x4.9mm_P1.27mm | Op-Amp Acondicionamiento ADC
U2, | 1 | ISO7242C | Package_SO:SOIC-16W_7.5x10.3mm_P1.27mm | Aislador I2C
U3, | 1 | LM5056APMH/NOPB | Package_SO:HTSSOP-28-1EP_4.4x9.7mm_P0.65mm_EP2.85x5.4mm | Sensor Tensión/Corriente
U4, | 1 | TMCS1100A4 | Package_SO:SOIC-8_3.9x4.9mm_P1.27mm | Sensor Corriente Efecto Hall
U5, | 1 | LM7805_TO252 | Package_TO_SOT_SMD:TO-252-2 | Regulador Lineal +5VP
U6, | 1 | THB3-1211 | Package_DIP:DIP-24_W15.24mm | Fuente TRACO
U7, U15, | 2 | LP2985-3.3 | Package_TO_SOT_SMD:SOT-23-5 | Regulador Lineal 3V3
U8, U9, U10, U11, | 4 | ACPL-P480 | Package_SO:SSO-6_6.8x4.6mm_P1.27mm_Clearance7mm | Optoacopladores para drivers
U12, U13, | 2 | 2ED21834-S06J | Package_SO:SO-14_3.9x8.65mm_P1.27mm | Drivers de MOSET
U14, | 1 | FT232BL | Package_QFP:LQFP-32_7x7mm_P0.8mm | FTDI
Y1, | 1 | 6 MHz | Crystal:Crystal_HC18-U_Vertical | Cristal/Oscilador
