tomas-tavella/Proyecto-Final/Conversor/Cuentas componentes conversor.pdf

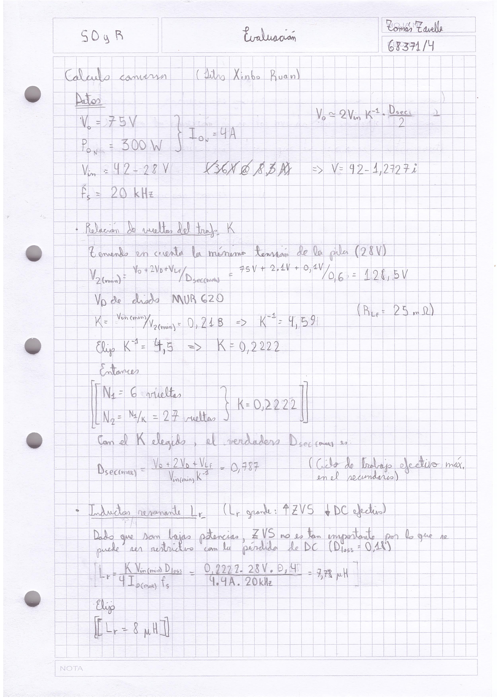
[picture p98: page 1]
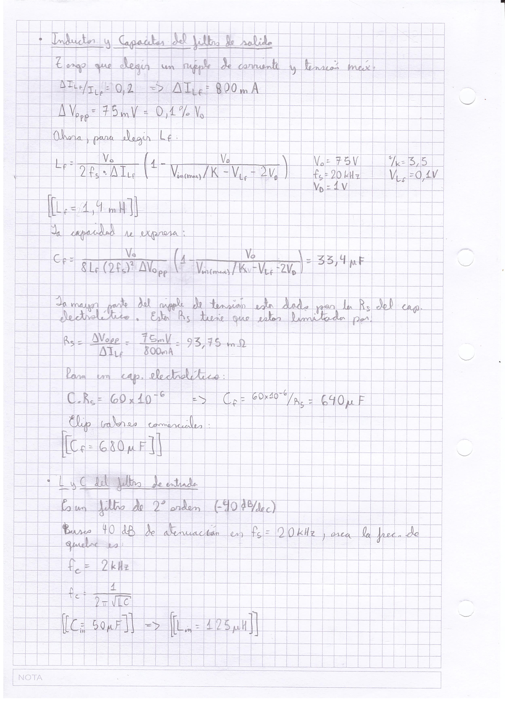
[picture p99: page 2]
