tomas-tavella/Proyecto-Final/Reference Designs/Placa adaptadora TMS320F28335/Proyecto Altium/Models 3d/BT/User Library-HC-06.STEP

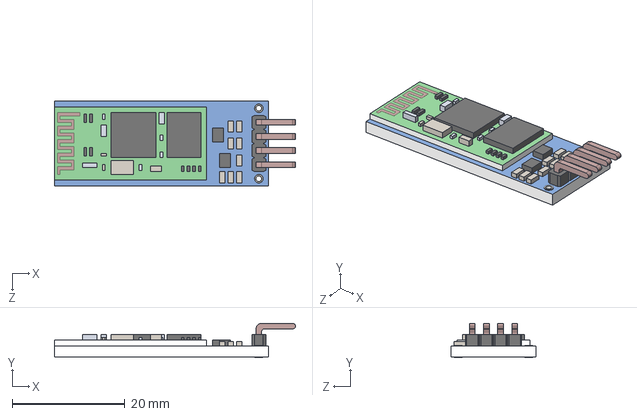
[picture p100: CAD file, 2022-05-13]
Reference Designs/Placa adaptadora TMS320F28335/Proyecto Altium/Models 3d/BT/User Library-HC-06.STEP
42.8 x 6.10 x 15.0 mm
