tomas-tavella/Proyecto-Final/Reference Designs/Placa adaptadora TMS320F28335/Proyecto Altium/Models 3d/C0805/User Library-0805(2012M) Cap.STEP

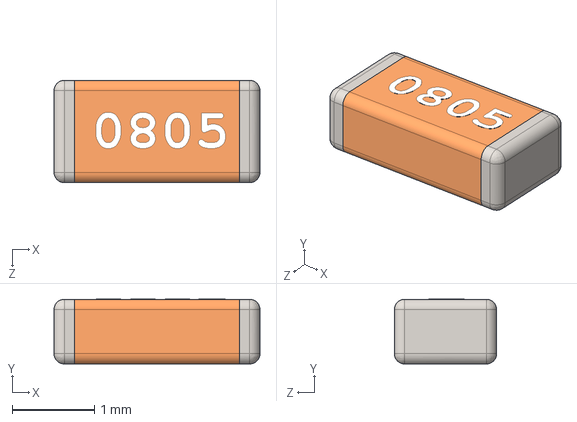
[picture p101: CAD file, 2022-05-13]
Reference Designs/Placa adaptadora TMS320F28335/Proyecto Altium/Models 3d/C0805/User Library-0805(2012M) Cap.STEP
2.51 x 0.79 x 1.24 mm
