tomas-tavella/Proyecto-Final/Reference Designs/Placa adaptadora TMS320F28335/Proyecto Altium/Models 3d/Card control/SW3dPS-pc2100s_256mb.STEP

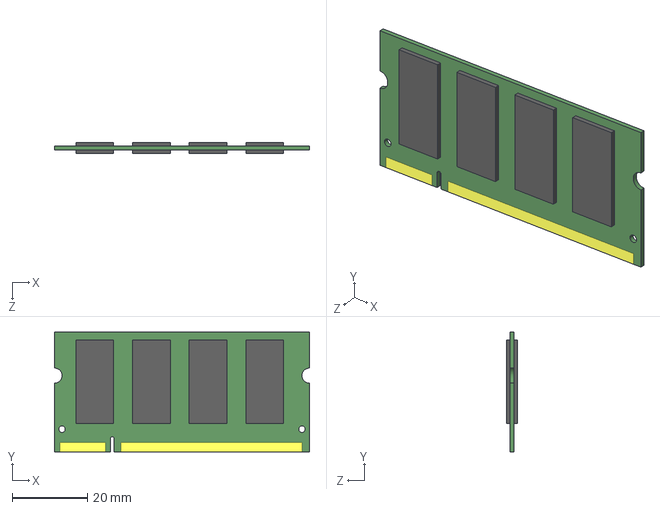
[picture p102: CAD file, 2022-05-13]
Reference Designs/Placa adaptadora TMS320F28335/Proyecto Altium/Models 3d/Card control/SW3dPS-pc2100s_256mb.STEP
67.6 x 31.7 x 3.00 mm
