tomas-tavella/Proyecto-Final/Reference Designs/Placa adaptadora TMS320F28335/Proyecto Altium/Models 3d/Header 10/User Library-SIL_Socket10_.STEP

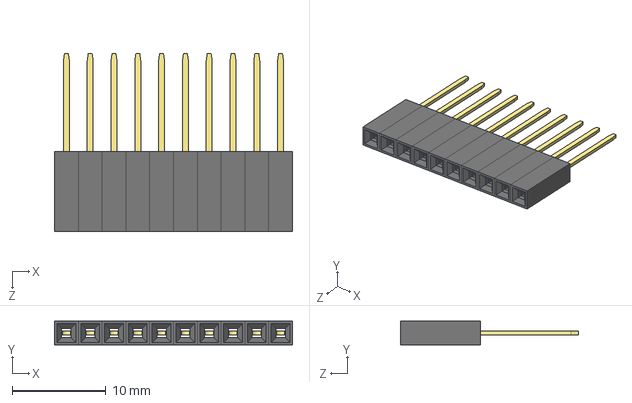
[picture p103: CAD file, 2022-05-13]
Reference Designs/Placa adaptadora TMS320F28335/Proyecto Altium/Models 3d/Header 10/User Library-SIL_Socket10_.STEP
25.4 x 2.54 x 19.0 mm
User Library-SIL_Socket10__SIL_Socket_Body x 10
User Library-SIL_Socket10__SIL_SocketPin x 10
