tomas-tavella/Proyecto-Final/Reference Designs/Placa adaptadora TMS320F28335/Proyecto Altium/Models 3d/Header 14/5915.stp

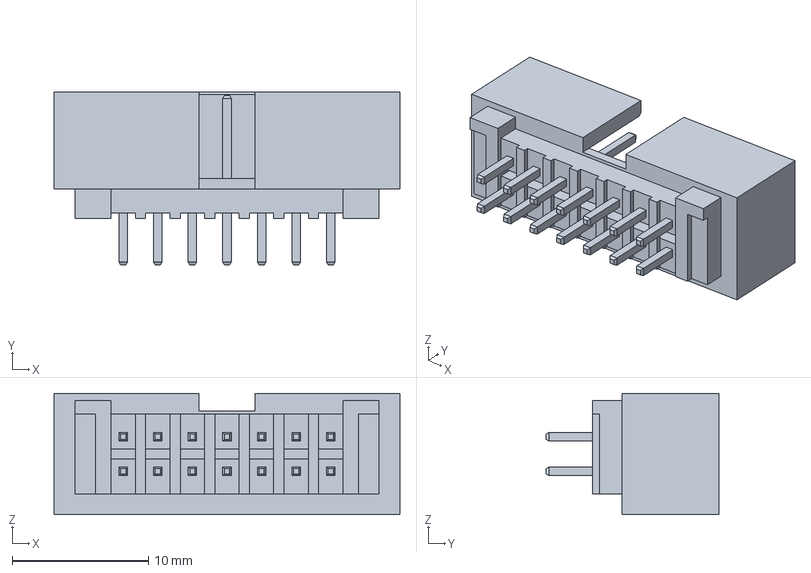
[picture p104: CAD file, 2022-05-13]
Reference Designs/Placa adaptadora TMS320F28335/Proyecto Altium/Models 3d/Header 14/5915.stp
25.4 x 12.7 x 8.89 mm
