tomas-tavella/Proyecto-Final/Reference Designs/Placa adaptadora TMS320F28335/Proyecto Altium/Models 3d/Jack/User Library-KLDVX-0202-A Kycon.step

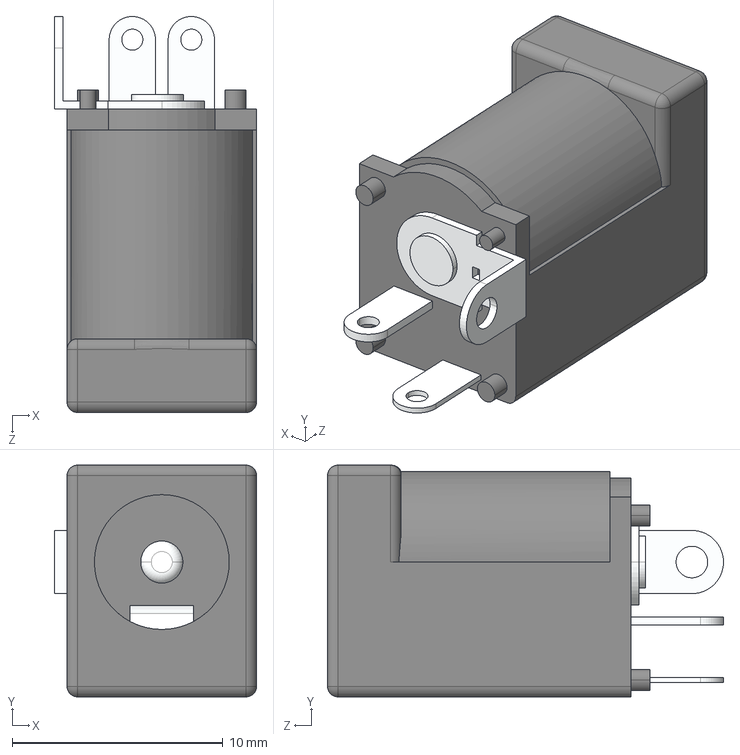
[picture p105: CAD file, 2022-05-13]
Reference Designs/Placa adaptadora TMS320F28335/Proyecto Altium/Models 3d/Jack/User Library-KLDVX-0202-A Kycon.step
9.60 x 11.0 x 18.8 mm
