tomas-tavella/Proyecto-Final/Reference Designs/Placa adaptadora TMS320F28335/Proyecto Altium/Models 3d/RJ-45/SW3dPS-bothhandusalu1t516-43-lf.STEP

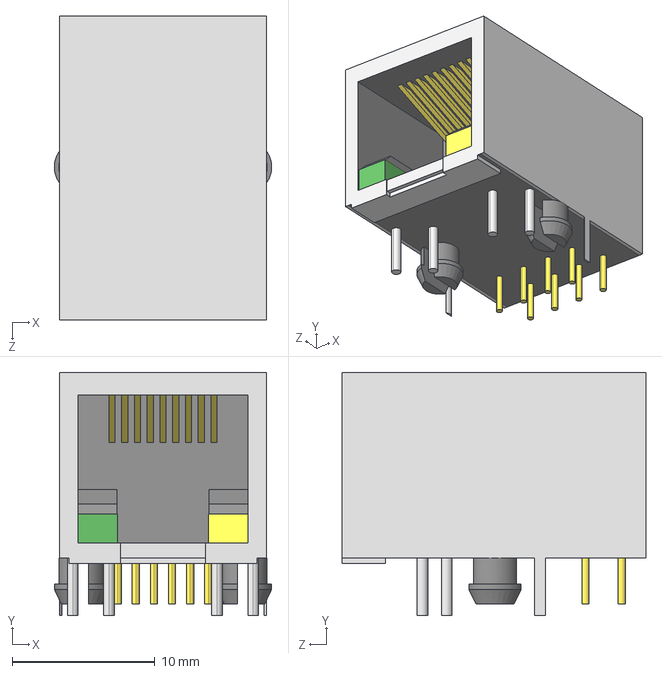
[picture p106: CAD file, 2022-05-13]
Reference Designs/Placa adaptadora TMS320F28335/Proyecto Altium/Models 3d/RJ-45/SW3dPS-bothhandusalu1t516-43-lf.STEP
15.2 x 17.0 x 21.3 mm
