tomas-tavella/Proyecto-Final/Reference Designs/Placa adaptadora TMS320F28335/Proyecto Altium/Models 3d/SOC-16/User Library-SOIC-16-1.step

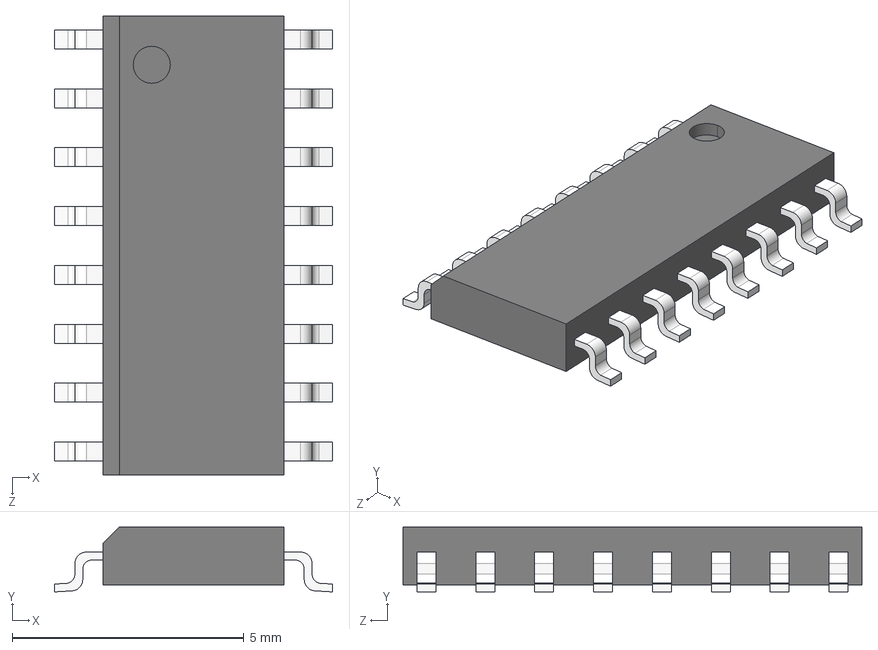
[picture p107: CAD file, 2022-05-13]
Reference Designs/Placa adaptadora TMS320F28335/Proyecto Altium/Models 3d/SOC-16/User Library-SOIC-16-1.step
6.00 x 1.40 x 9.90 mm
