tomas-tavella/Proyecto-Final/Reference Designs/Placa adaptadora TMS320F28335/Proyecto Altium/Models 3d/Toggle sw/SW3dPS-m2011ss1w01.STEP

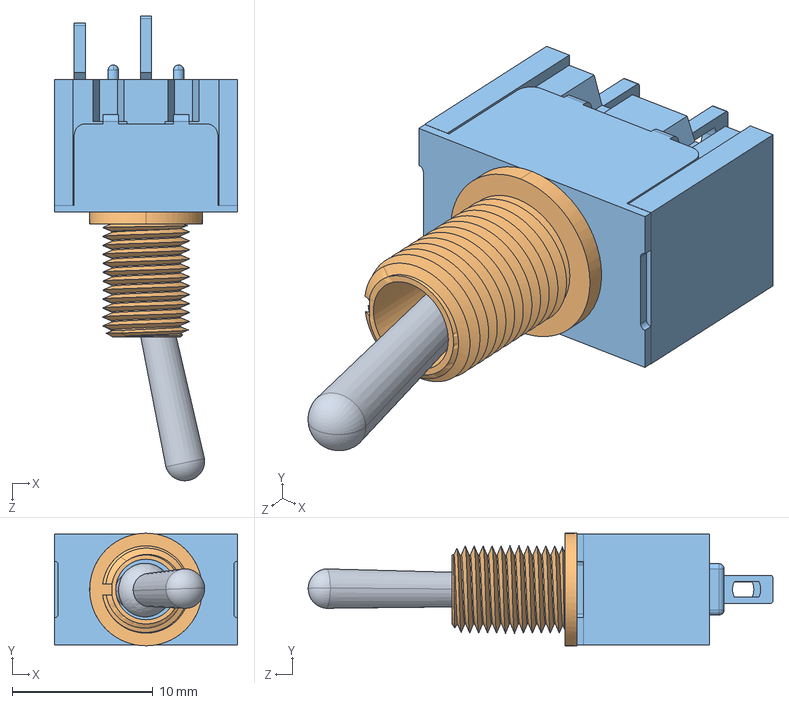
[picture p108: CAD file, 2022-05-13]
Reference Designs/Placa adaptadora TMS320F28335/Proyecto Altium/Models 3d/Toggle sw/SW3dPS-m2011ss1w01.STEP
13.0 x 8.00 x 33.0 mm
SW3dPS-m2011ss1w01_SToggle-
SW3dPS-m2011ss1w01_S1-Barrel
SW3dPS-m2011ss1w01_Body&Terminals
