tomas-tavella/Proyecto-Final/Reference Designs/Placa adaptadora TMS320F28335/Proyecto Altium/Models 3d/User Library-CONB127P-2R-20W_TH.step

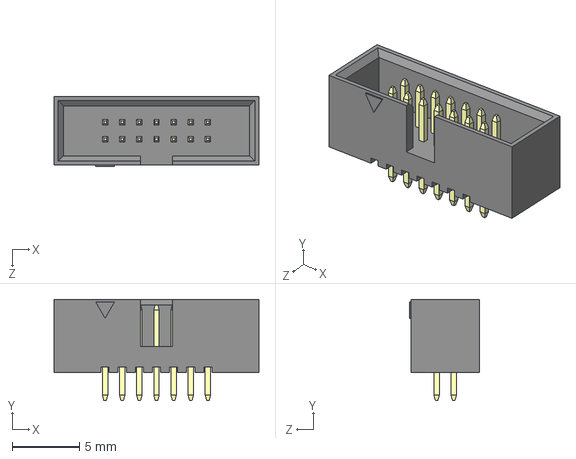
[picture p109: CAD file, 2022-05-13]
Reference Designs/Placa adaptadora TMS320F28335/Proyecto Altium/Models 3d/User Library-CONB127P-2R-20W_TH.step
15.2 x 7.50 x 5.20 mm
