tomas-tavella/Proyecto-Final/Reference Designs/Proyecto Irusta-Caravelli/Altium/ALTIUM_EMBEDDED_MODELS/jumper_akspt_z-black.stp

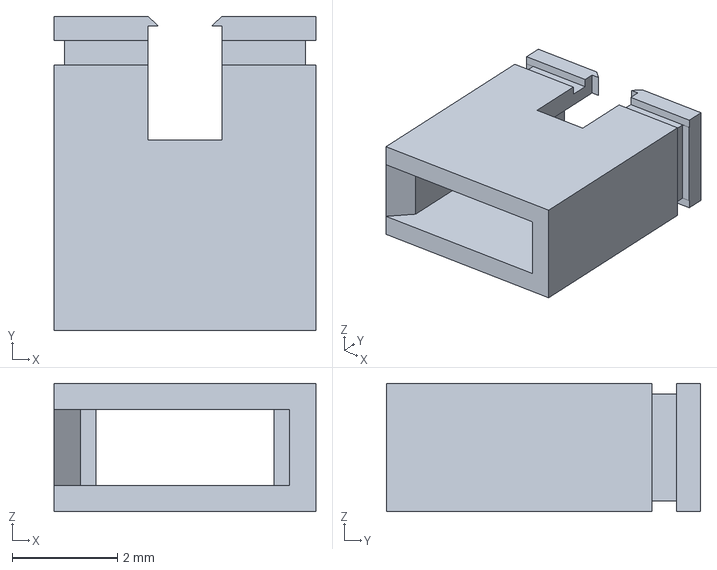
[picture p110: CAD file, 2022-04-29]
Reference Designs/Proyecto Irusta-Caravelli/Altium/ALTIUM_EMBEDDED_MODELS/jumper_akspt_z-black.stp
4.98 x 5.97 x 2.44 mm
