tomas-tavella/Proyecto-Final/Reference Designs/Placa adaptadora TMS320F28335/Proyecto Altium/ALTIUM_EMBEDDED_MODELS/H-1X2.STEP

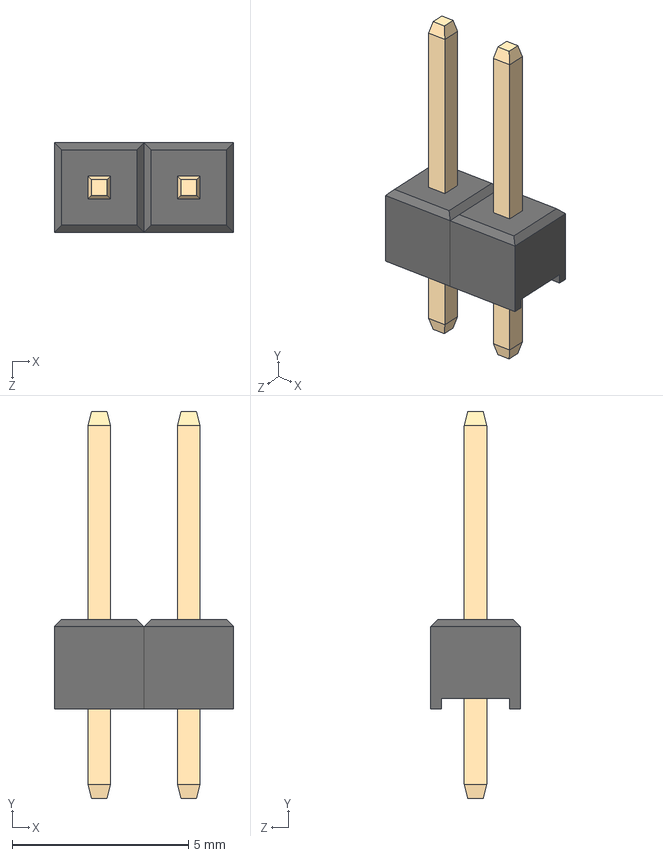
[picture p111: CAD file, 2022-05-13]
Reference Designs/Placa adaptadora TMS320F28335/Proyecto Altium/ALTIUM_EMBEDDED_MODELS/H-1X2.STEP
5.08 x 11.0 x 2.54 mm
User Library-Header1x2_Header1_1 x 2
