tomas-tavella/Proyecto-Final/Reference Designs/Placa adaptadora TMS320F28335/Proyecto Altium/Models 3d/C0805/User Library-0805 SMD Capacitor.STEP

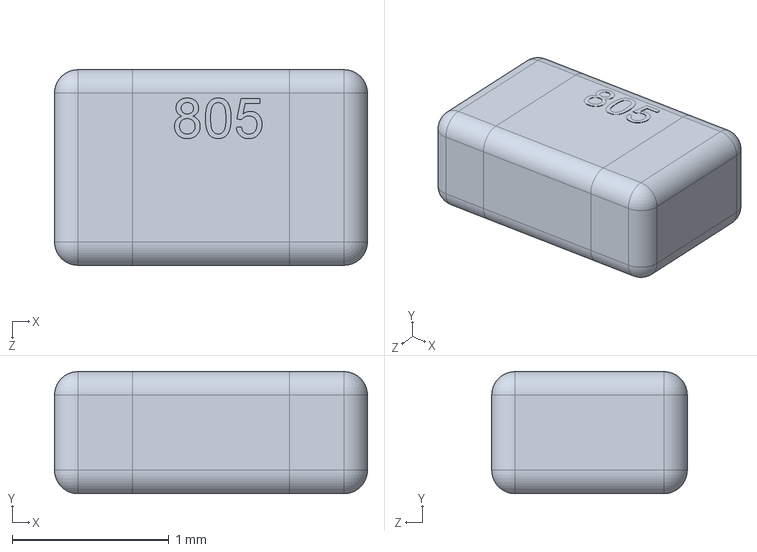
[picture p112: CAD file, 2022-05-13]
Reference Designs/Placa adaptadora TMS320F28335/Proyecto Altium/Models 3d/C0805/User Library-0805 SMD Capacitor.STEP
2.00 x 0.782 x 1.25 mm
