tomas-tavella/Proyecto-Final/Reference Designs/Placa adaptadora TMS320F28335/Proyecto Altium/Models 3d/Toggle sw/User Library-P2011B-RO.STEP

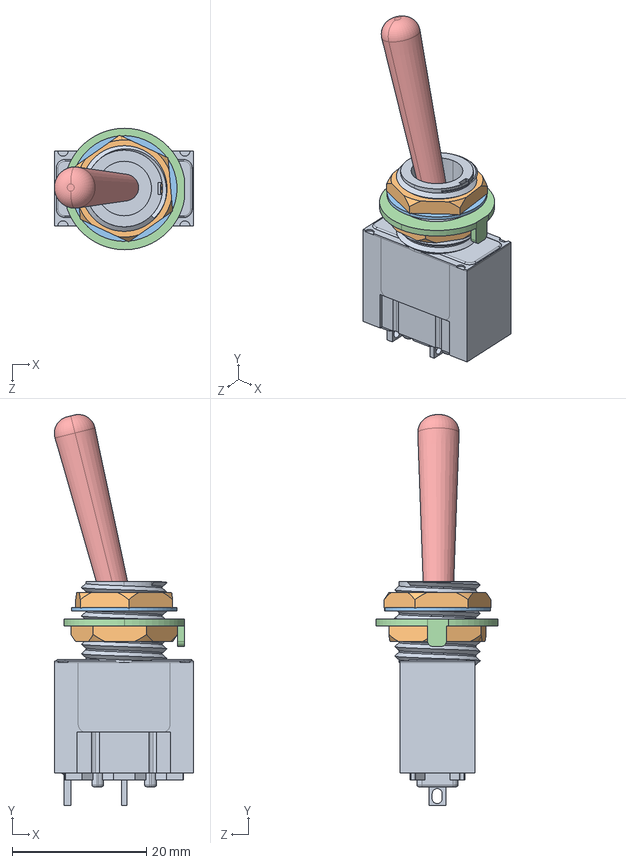
[picture p113: CAD file, 2022-05-13]
Reference Designs/Placa adaptadora TMS320F28335/Proyecto Altium/Models 3d/Toggle sw/User Library-P2011B-RO.STEP
20.8 x 58.3 x 18.1 mm
User Library-P2011B-RO_Body
User Library-P2011B-RO_Nut x 2
User Library-P2011B-RO_washer
User Library-P2011B-RO_anti-rotation
User Library-P2011B-RO_stem
