tomas-tavella/Proyecto-Final/Reference Designs/Proyecto Irusta-Caravelli/Altium/ALTIUM_EMBEDDED_MODELS/cap 12.5mm lead.STEP

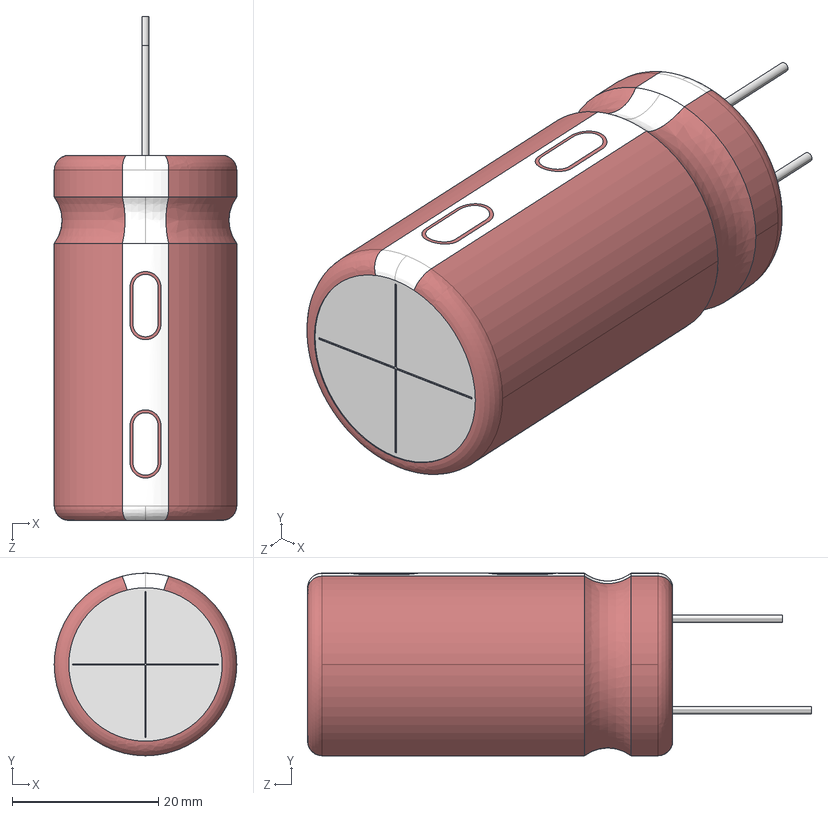
[picture p114: CAD file, 2022-04-29]
Reference Designs/Proyecto Irusta-Caravelli/Altium/ALTIUM_EMBEDDED_MODELS/cap 12.5mm lead.STEP
25.0 x 25.0 x 69.0 mm
User Library-Cap 25x50_9_1
User Library-Cap 25x50_3_1
User Library-Cap 25x50_4_1
User Library-Cap 25x50_2_1
User Library-Cap 25x50_5_1
User Library-Cap 25x50_1_1
User Library-Cap 25x50_10_1
User Library-Cap 25x50_6_1
User Library-Cap 25x50_8_1
User Library-Cap 25x50_7_1
