tomas-tavella/Proyecto-Final/Reference Designs/Placa adaptadora TMS320F28335/Proyecto Altium/ALTIUM_EMBEDDED_MODELS/C-1206.STEP

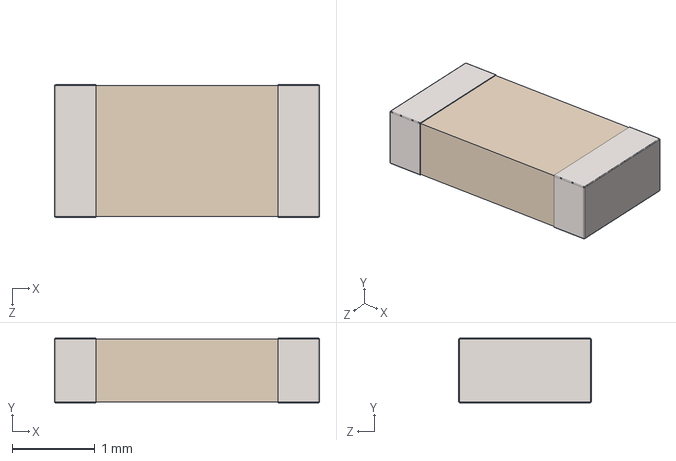
[picture p115: CAD file, 2022-05-13]
Reference Designs/Placa adaptadora TMS320F28335/Proyecto Altium/ALTIUM_EMBEDDED_MODELS/C-1206.STEP
3.20 x 0.78 x 1.60 mm
