tomas-tavella/Proyecto-Final/Reference Designs/Proyecto Irusta-Caravelli/Altium/ALTIUM_EMBEDDED_MODELS/SOT143.STEP

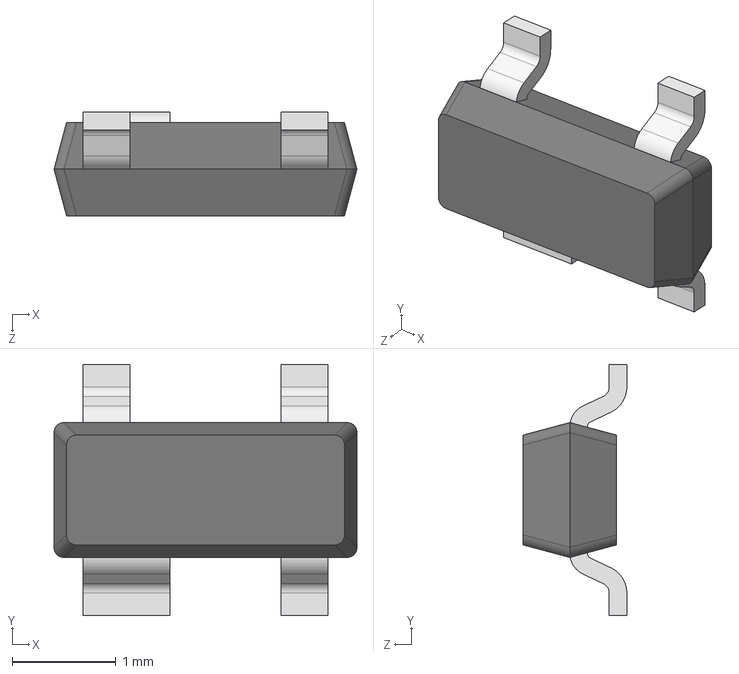
[picture p116: CAD file, 2022-04-29]
Reference Designs/Proyecto Irusta-Caravelli/Altium/ALTIUM_EMBEDDED_MODELS/SOT143.STEP
2.92 x 2.42 x 1.00 mm
