tomas-tavella/Proyecto-Final/Reference Designs/Placa adaptadora TMS320F28335/Proyecto Altium/ALTIUM_EMBEDDED_MODELS/SMA SMD.STEP

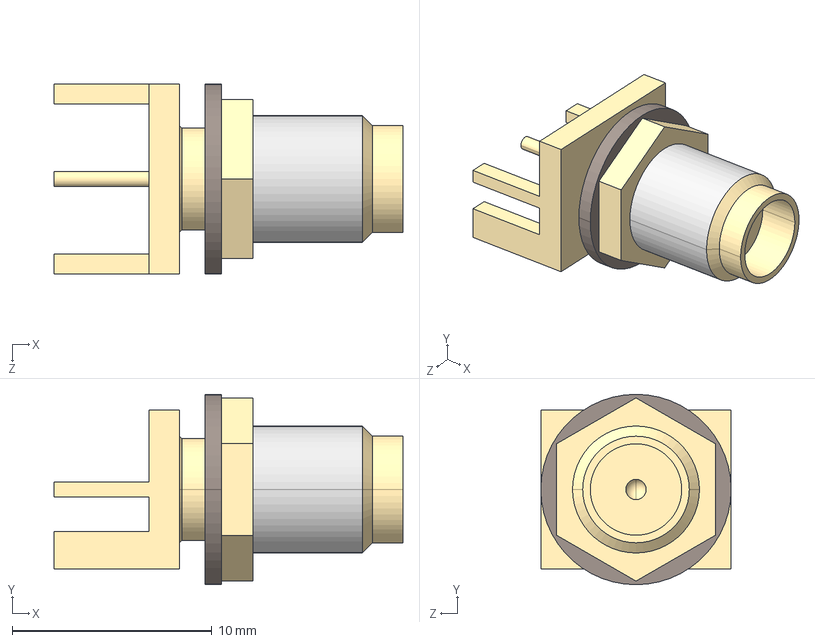
[picture p117: CAD file, 2022-05-13]
Reference Designs/Placa adaptadora TMS320F28335/Proyecto Altium/ALTIUM_EMBEDDED_MODELS/SMA SMD.STEP
17.5 x 9.53 x 9.53 mm
