tomas-tavella/Proyecto-Final/Reference Designs/Proyecto Irusta-Caravelli/Altium/ALTIUM_EMBEDDED_MODELS/User Library-Diode Molded Body3.STEP

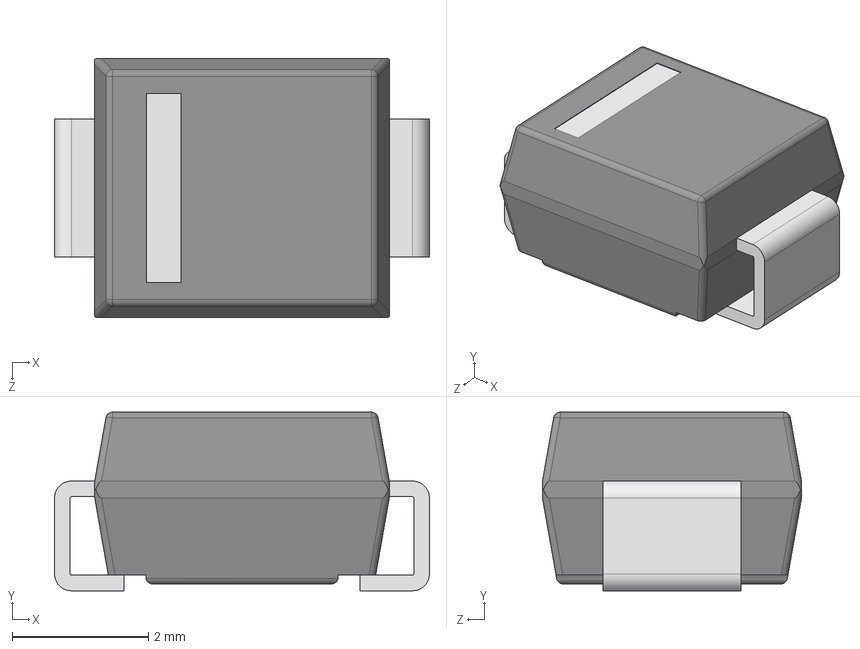
[picture p118: CAD file, 2022-04-29]
Reference Designs/Proyecto Irusta-Caravelli/Altium/ALTIUM_EMBEDDED_MODELS/User Library-Diode Molded Body3.STEP
5.50 x 2.62 x 3.80 mm
