tomas-tavella/Proyecto-Final/Reference Designs/Placa adaptadora TMS320F28335/Proyecto Altium/ALTIUM_EMBEDDED_MODELS/User Library-Cap 4x7.STEP

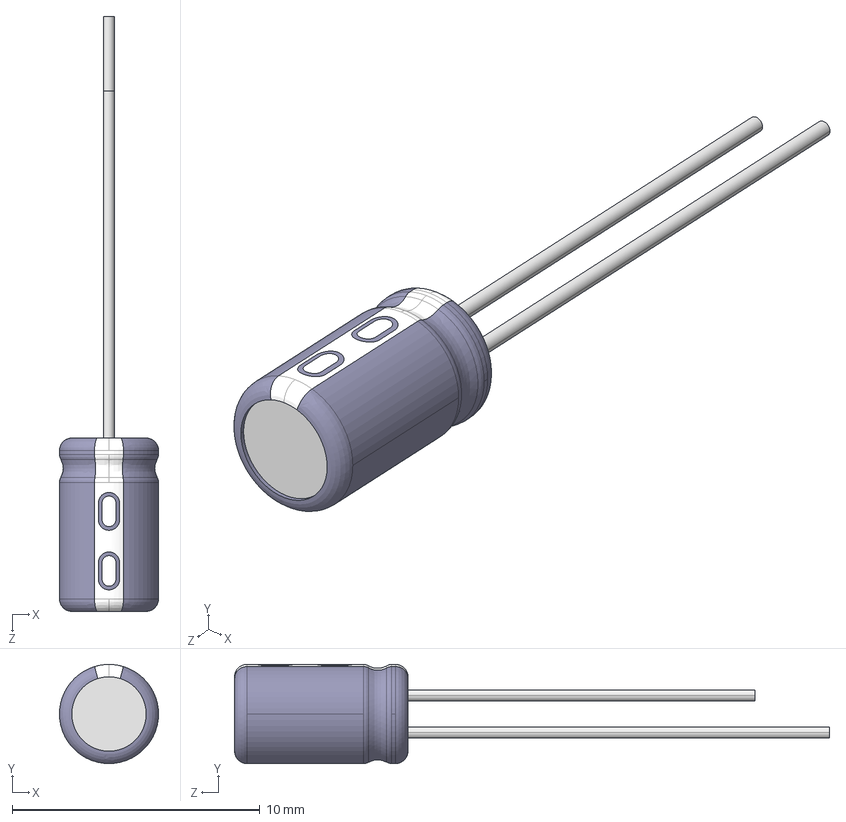
[picture p119: CAD file, 2022-05-13]
Reference Designs/Placa adaptadora TMS320F28335/Proyecto Altium/ALTIUM_EMBEDDED_MODELS/User Library-Cap 4x7.STEP
4.00 x 4.00 x 24.0 mm
User Library-Cap 4x7_1_1
User Library-Cap 4x7_2_1
User Library-Cap 4x7_3_1
User Library-Cap 4x7_4_1
User Library-Cap 4x7_5_1
User Library-Cap 4x7_6_1
User Library-Cap 4x7_7_1
User Library-Cap 4x7_8_1
User Library-Cap 4x7_9_1
User Library-Cap 4x7_10_1
