tomas-tavella/Proyecto-Final/Reference Designs/Proyecto Irusta-Caravelli/Altium/ALTIUM_EMBEDDED_MODELS/SW3dPS-LEDd5R.STEP

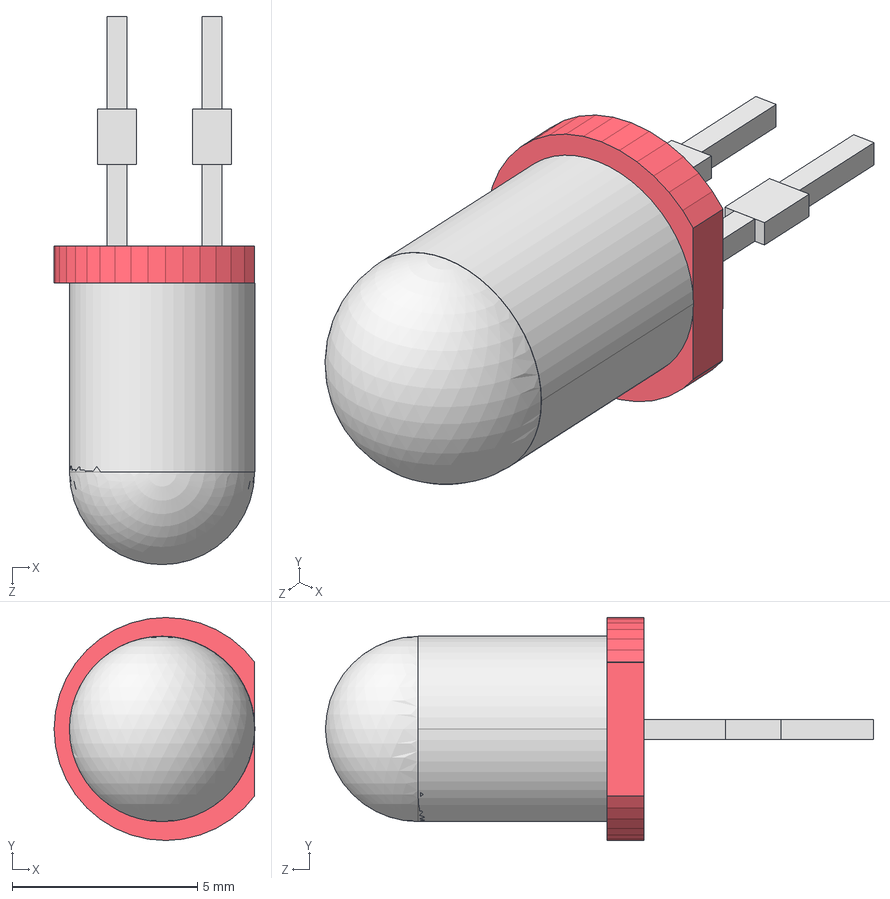
[picture p120: CAD file, 2022-04-29]
Reference Designs/Proyecto Irusta-Caravelli/Altium/ALTIUM_EMBEDDED_MODELS/SW3dPS-LEDd5R.STEP
5.42 x 6.02 x 14.8 mm
SW3dPS-LEDd5R_Extruded3
SW3dPS-LEDd5R_Extruded x 2
SW3dPS-LEDd5R_Cylinder
SW3dPS-LEDd5R_Extruded4
SW3dPS-LEDd5R_Sphere
SW3dPS-LEDd5R_Extruded2 x 2
SW3dPS-LEDd5R_Extruded1
