tomas-tavella/Proyecto-Final/Reference Designs/Placa adaptadora TMS320F28335/Proyecto Altium/ALTIUM_EMBEDDED_MODELS/User Library-so14-1.step

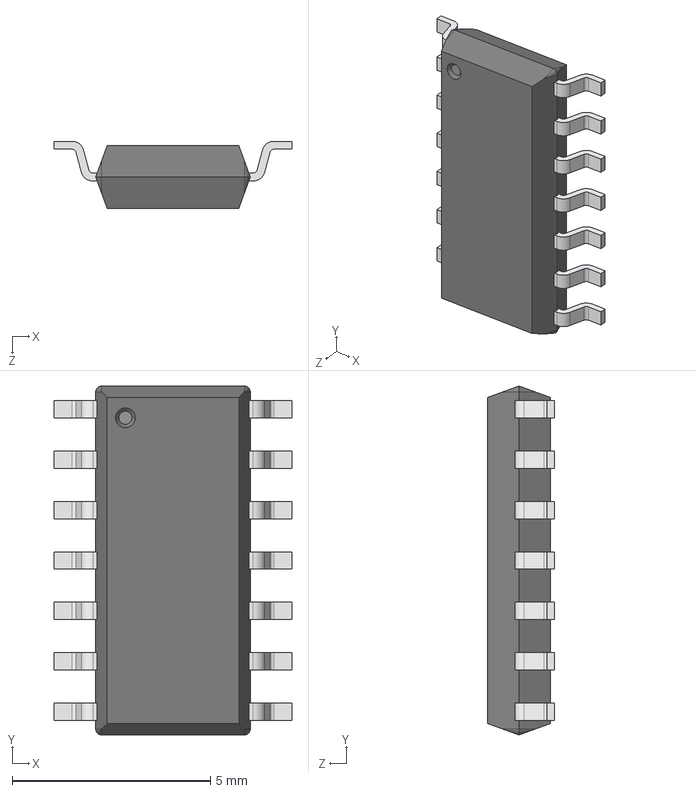
[picture p121: CAD file, 2022-05-13]
Reference Designs/Placa adaptadora TMS320F28335/Proyecto Altium/ALTIUM_EMBEDDED_MODELS/User Library-so14-1.step
6.00 x 8.80 x 1.70 mm
