tomas-tavella/Proyecto-Final/Reference Designs/Proyecto Irusta-Caravelli/Altium/ALTIUM_EMBEDDED_MODELS/SW3dPS-222-0001.STEP

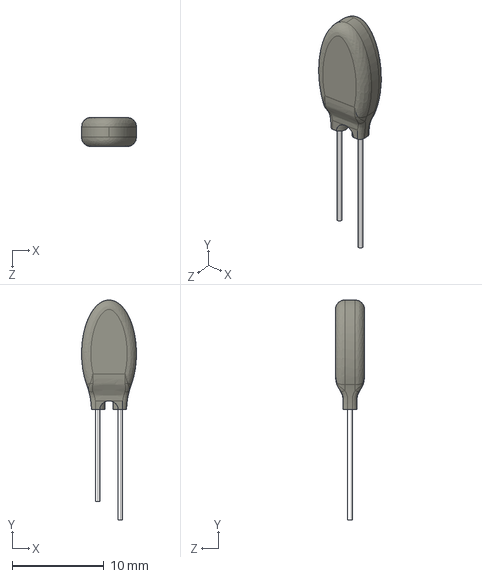
[picture p122: CAD file, 2022-04-29]
Reference Designs/Proyecto Irusta-Caravelli/Altium/ALTIUM_EMBEDDED_MODELS/SW3dPS-222-0001.STEP
5.99 x 24.0 x 3.18 mm
