tomas-tavella/Proyecto-Final/Reference Designs/Proyecto Irusta-Caravelli/Altium/ALTIUM_EMBEDDED_MODELS/SOP-8 - TLC2272.STEP

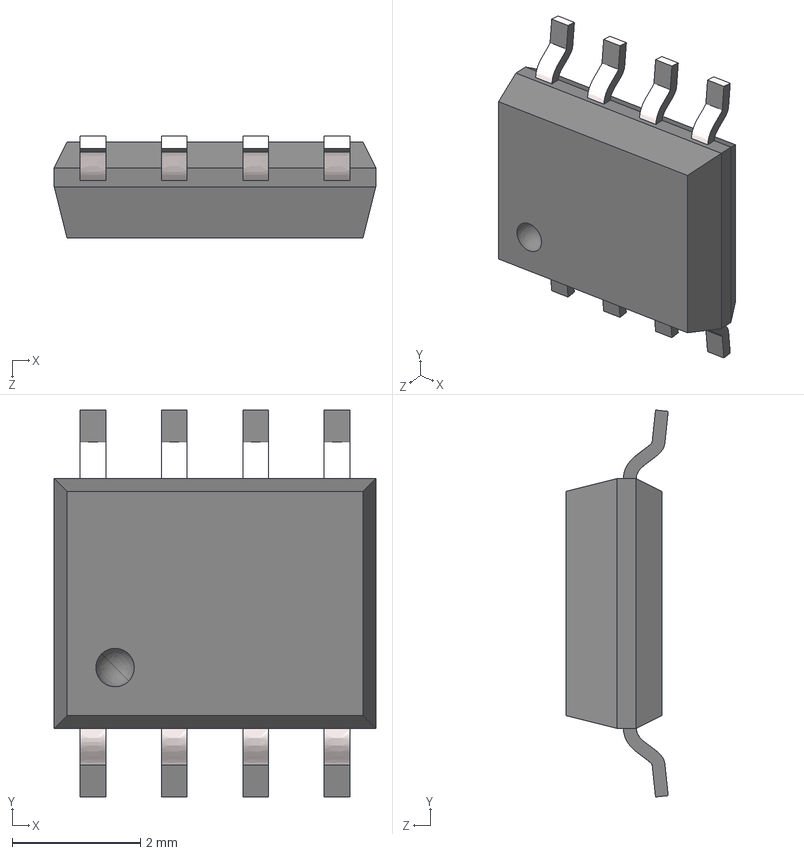
[picture p124: CAD file, 2022-04-29]
Reference Designs/Proyecto Irusta-Caravelli/Altium/ALTIUM_EMBEDDED_MODELS/SOP-8 - TLC2272.STEP
5.02 x 6.04 x 1.60 mm
