tomas-tavella/Proyecto-Final/Reference Designs/Proyecto Irusta-Caravelli/Altium/ALTIUM_EMBEDDED_MODELS/DIP-14-HC7400.STEP

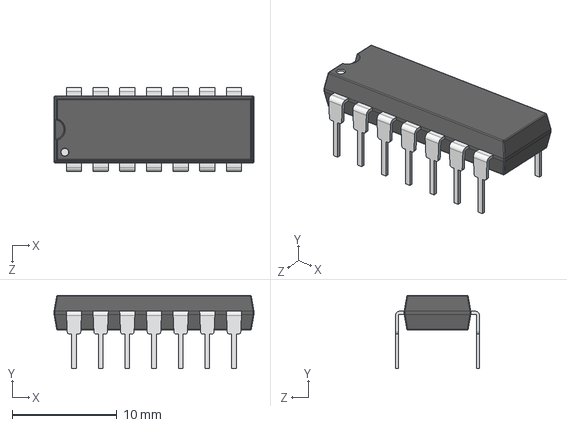
[picture p127: CAD file, 2022-04-29]
Reference Designs/Proyecto Irusta-Caravelli/Altium/ALTIUM_EMBEDDED_MODELS/DIP-14-HC7400.STEP
19.1 x 6.98 x 8.00 mm
