tomas-tavella/Proyecto-Final/Reference Designs/Placa adaptadora TMS320F28335/Proyecto Altium/ALTIUM_EMBEDDED_MODELS/User Library-DISPLAY KIMBRIGHT MINI.STEP

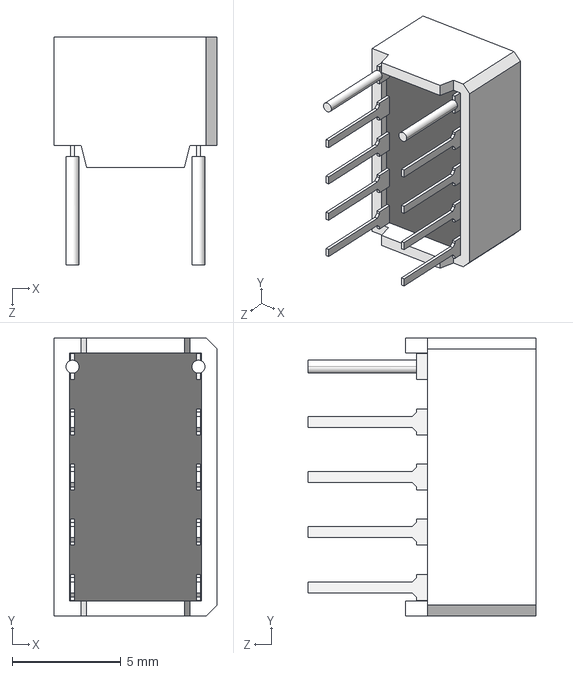
[picture p128: CAD file, 2022-05-13]
Reference Designs/Placa adaptadora TMS320F28335/Proyecto Altium/ALTIUM_EMBEDDED_MODELS/User Library-DISPLAY KIMBRIGHT MINI.STEP
7.50 x 12.8 x 10.5 mm
