tomas-tavella/Proyecto-Final/Reference Designs/Proyecto Irusta-Caravelli/Altium/ALTIUM_EMBEDDED_MODELS/User Library-DIP8test.STEP

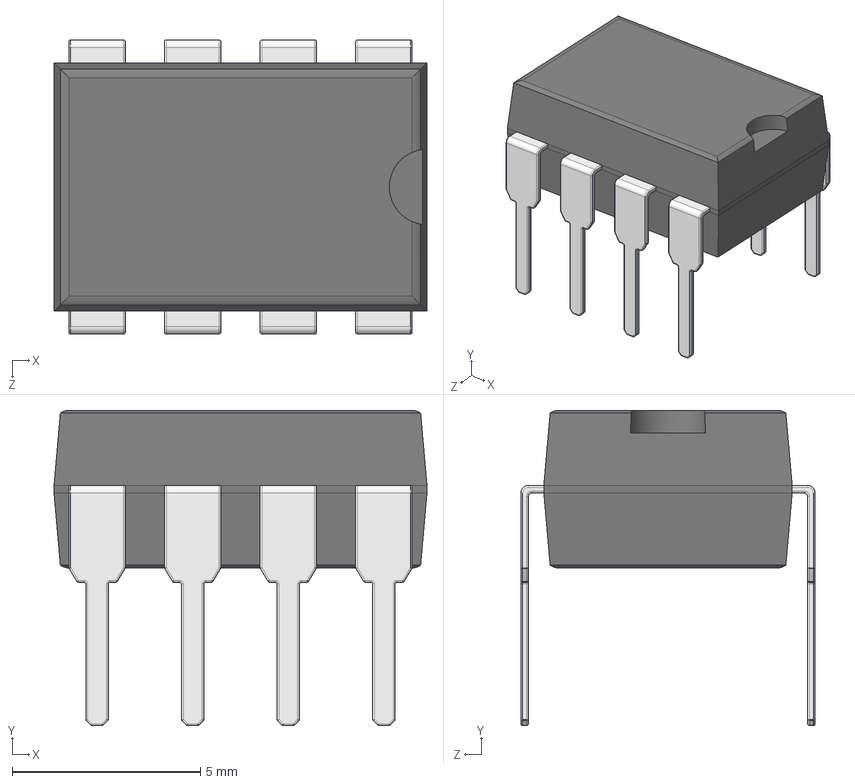
[picture p130: CAD file, 2022-04-29]
Reference Designs/Proyecto Irusta-Caravelli/Altium/ALTIUM_EMBEDDED_MODELS/User Library-DIP8test.STEP
9.91 x 8.38 x 7.82 mm
User Library-DIP8test_Pins Narrow_1 x 8
User Library-DIP8test_K_X_F6rper DIP8_1
