tomas-tavella/Proyecto-Final/Reference Designs/Proyecto Irusta-Caravelli/Altium/ALTIUM_EMBEDDED_MODELS/RESISTOR, 0.25 W, 0.4 .STEP

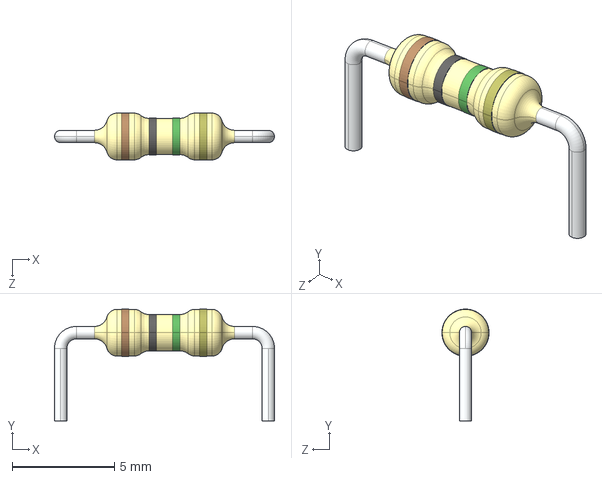
[picture p132: CAD file, 2022-04-29]
Reference Designs/Proyecto Irusta-Caravelli/Altium/ALTIUM_EMBEDDED_MODELS/RESISTOR, 0.25 W, 0.4 .STEP
10.8 x 5.47 x 2.31 mm
