tomas-tavella/Proyecto-Final/Reference Designs/Proyecto Irusta-Caravelli/Altium/ALTIUM_EMBEDDED_MODELS/User Library-INDUCTOR - 2100HT series SOFT-LEAD.STEP

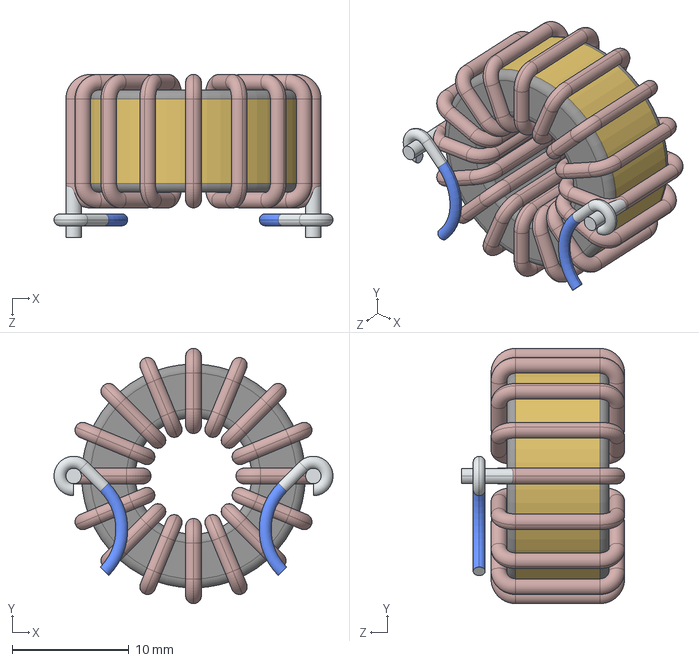
[picture p134: CAD file, 2022-04-29]
Reference Designs/Proyecto Irusta-Caravelli/Altium/ALTIUM_EMBEDDED_MODELS/User Library-INDUCTOR - 2100HT series SOFT-LEAD.STEP
23.9 x 21.8 x 14.0 mm
