tomas-tavella/Proyecto-Final/Reference Designs/Placa adaptadora TMS320F28335/Proyecto Altium/ALTIUM_EMBEDDED_MODELS/H1X3.STEP

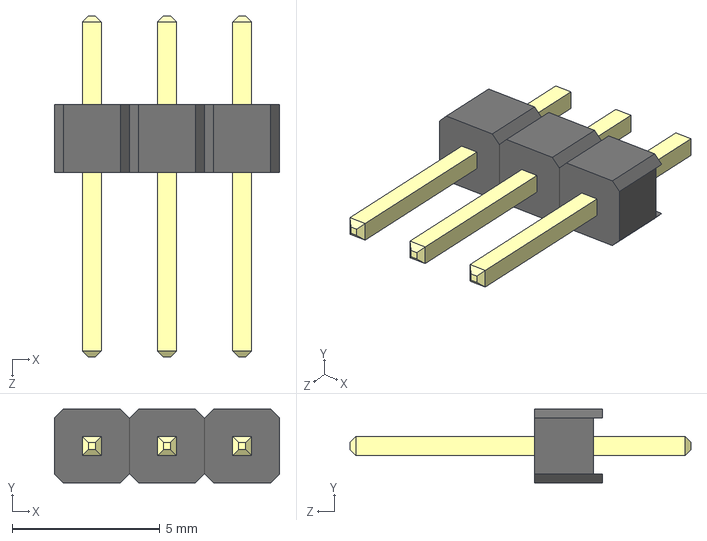
[picture p137: CAD file, 2022-05-13]
Reference Designs/Placa adaptadora TMS320F28335/Proyecto Altium/ALTIUM_EMBEDDED_MODELS/H1X3.STEP
7.62 x 2.49 x 11.5 mm
User Library-Header_Male_3Pin_PinArray
User Library-Header_Male_3Pin_BodyArray
