tomas-tavella/Proyecto-Final/Reference Designs/Proyecto Irusta-Caravelli/Altium/ALTIUM_EMBEDDED_MODELS/1206 SMD Capacitor.STEP

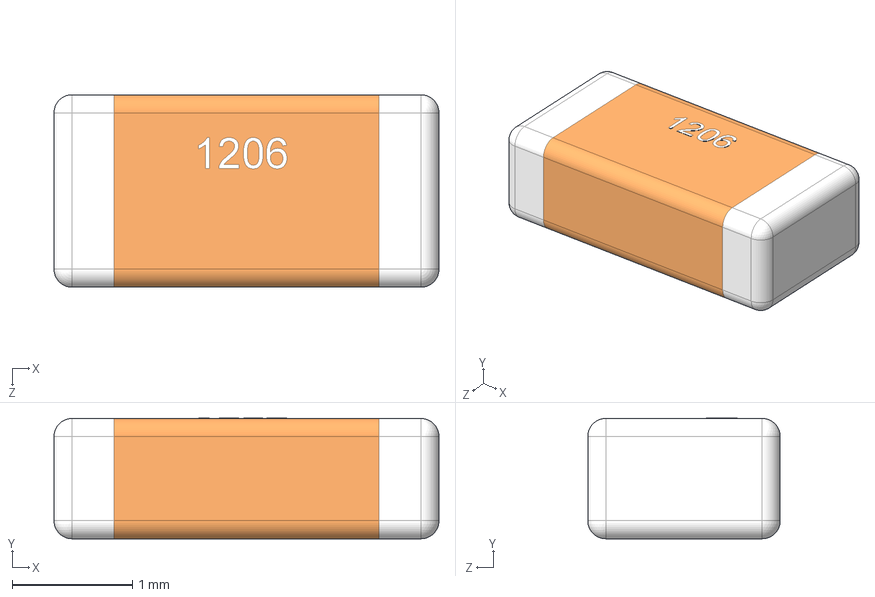
[picture p139: CAD file, 2022-04-29]
Reference Designs/Proyecto Irusta-Caravelli/Altium/ALTIUM_EMBEDDED_MODELS/1206 SMD Capacitor.STEP
3.20 x 1.00 x 1.60 mm
