tomas-tavella/Proyecto-Final/Reference Designs/Proyecto Irusta-Caravelli/Altium/ALTIUM_EMBEDDED_MODELS/cap 7.5mm lead.STEP

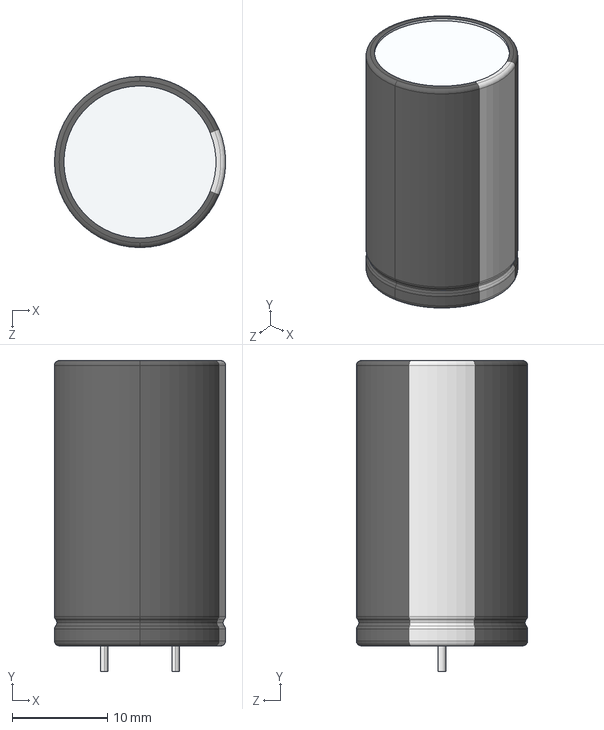
[picture p141: CAD file, 2022-04-29]
Reference Designs/Proyecto Irusta-Caravelli/Altium/ALTIUM_EMBEDDED_MODELS/cap 7.5mm lead.STEP
18.0 x 32.7 x 18.0 mm
