tomas-tavella/Proyecto-Final/Reference Designs/Placa adaptadora TMS320F28335/Proyecto Altium/ALTIUM_EMBEDDED_MODELS/User Library-SOIC16_Wide_JEDEC_MS-013AA.step

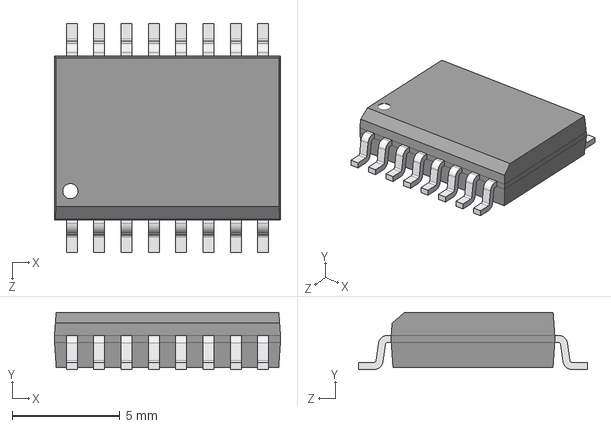
[picture p142: CAD file, 2022-05-13]
Reference Designs/Placa adaptadora TMS320F28335/Proyecto Altium/ALTIUM_EMBEDDED_MODELS/User Library-SOIC16_Wide_JEDEC_MS-013AA.step
10.5 x 2.65 x 10.6 mm
