tomas-tavella/Proyecto-Final/Reference Designs/Placa adaptadora TMS320F28335/Proyecto Altium/ALTIUM_EMBEDDED_MODELS/Tact Switch THT 5.0mm stem.STEP

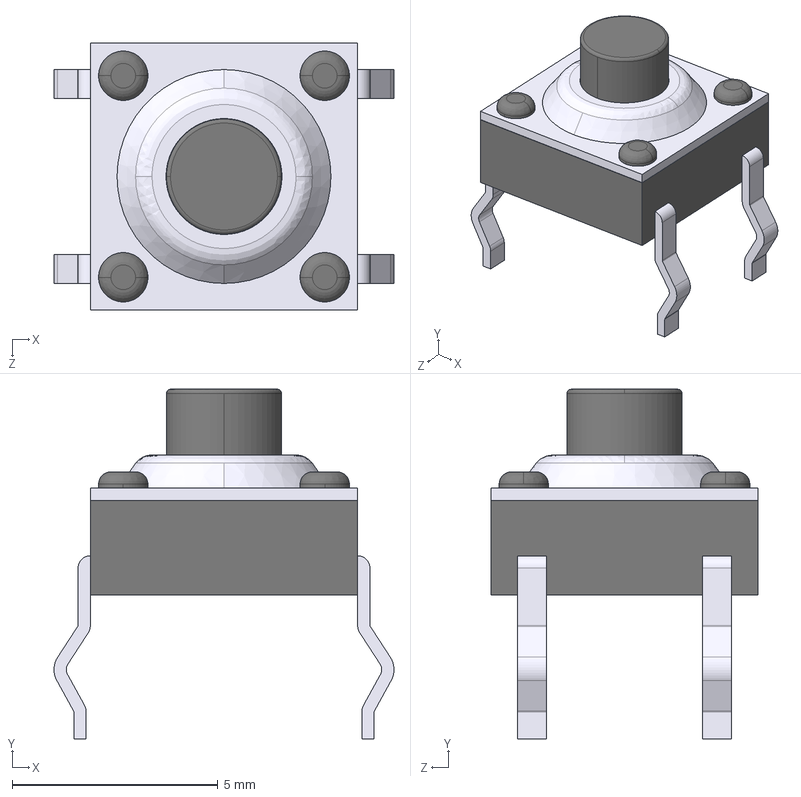
[picture p143: CAD file, 2022-05-13]
Reference Designs/Placa adaptadora TMS320F28335/Proyecto Altium/ALTIUM_EMBEDDED_MODELS/Tact Switch THT 5.0mm stem.STEP
8.27 x 8.50 x 6.50 mm
User Library-TS-1150-WP_TS-1180-WP_Plastic_1
User Library-TS-1150-WP_TS-1180-WP_Metal_1
