tomas-tavella/Proyecto-Final/Reference Designs/Proyecto Irusta-Caravelli/Altium/ALTIUM_EMBEDDED_MODELS/SW3DPS-DIODE0_71-DEFAULT.STEP

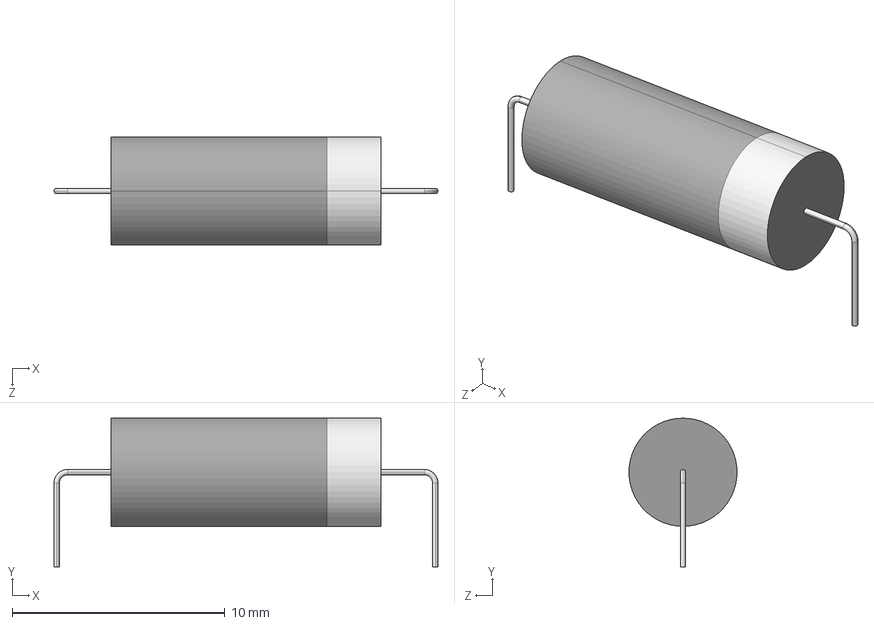
[picture p144: CAD file, 2022-04-29]
Reference Designs/Proyecto Irusta-Caravelli/Altium/ALTIUM_EMBEDDED_MODELS/SW3DPS-DIODE0_71-DEFAULT.STEP
18.0 x 6.99 x 5.08 mm
