tomas-tavella/Proyecto-Final/Reference Designs/Placa adaptadora TMS320F28335/Proyecto Altium/ALTIUM_EMBEDDED_MODELS/CircuitWorks-SOT-23-5.step

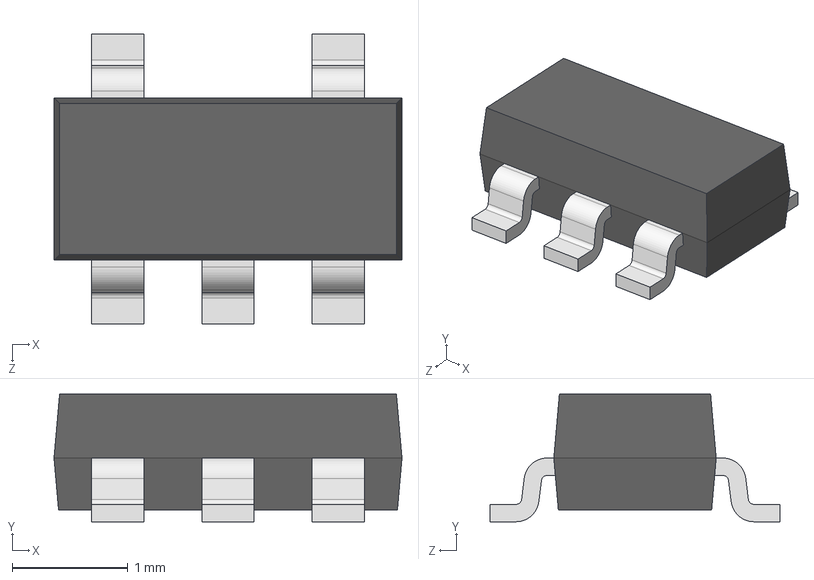
[picture p145: CAD file, 2022-05-13]
Reference Designs/Placa adaptadora TMS320F28335/Proyecto Altium/ALTIUM_EMBEDDED_MODELS/CircuitWorks-SOT-23-5.step
3.00 x 1.10 x 2.50 mm
