tomas-tavella/Proyecto-Final/Reference Designs/Proyecto Irusta-Caravelli/Altium/ALTIUM_EMBEDDED_MODELS/SW3dPS-SOIC16-300.STEP

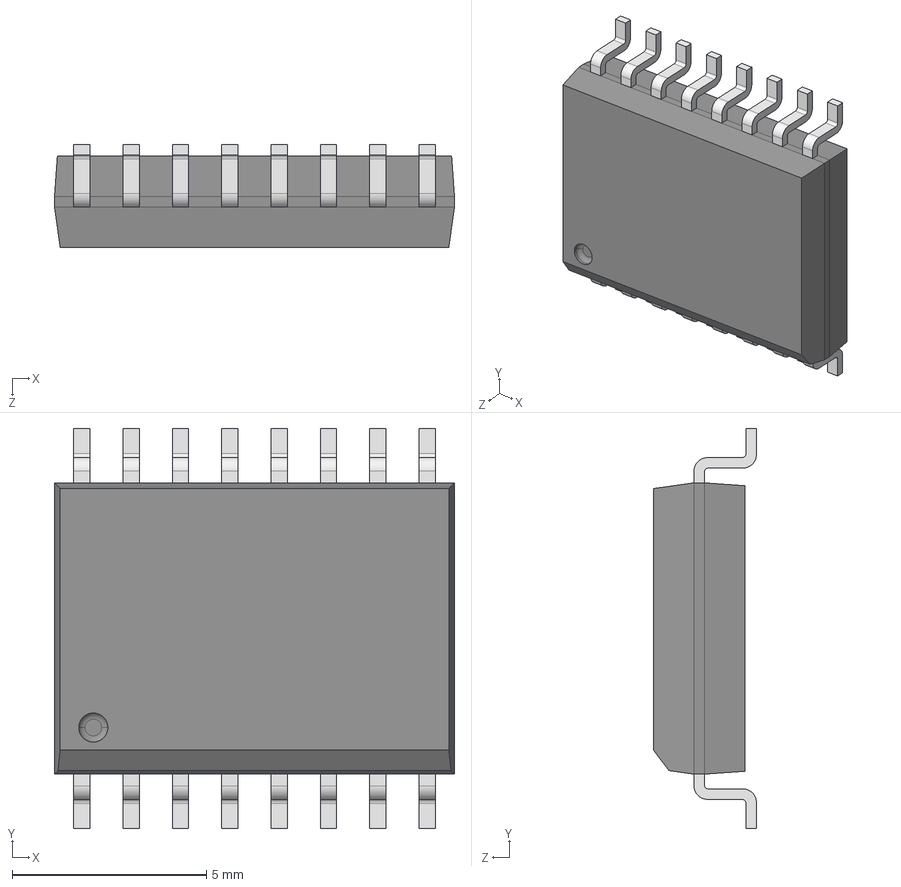
[picture p148: CAD file, 2022-04-29]
Reference Designs/Proyecto Irusta-Caravelli/Altium/ALTIUM_EMBEDDED_MODELS/SW3dPS-SOIC16-300.STEP
10.3 x 10.3 x 2.65 mm
