tomas-tavella/Proyecto-Final/Reference Designs/Proyecto Irusta-Caravelli/Altium/ALTIUM_EMBEDDED_MODELS/User Library-1n4148-1.STEP

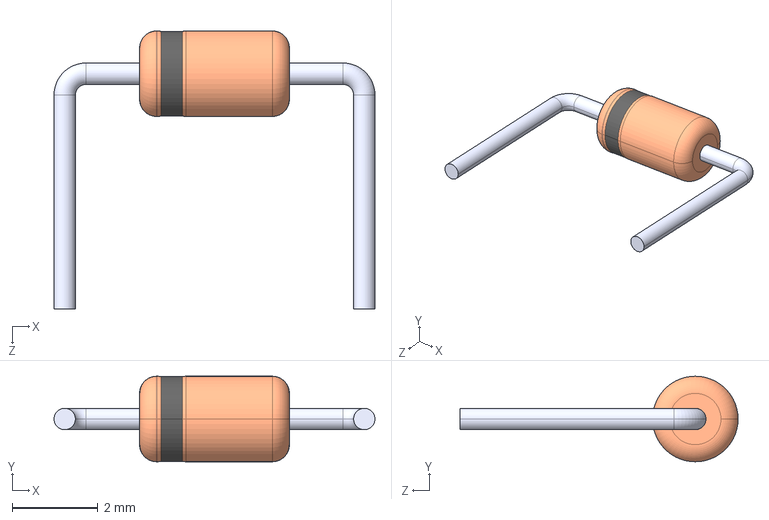
[picture p150: CAD file, 2022-04-29]
Reference Designs/Proyecto Irusta-Caravelli/Altium/ALTIUM_EMBEDDED_MODELS/User Library-1n4148-1.STEP
7.50 x 2.00 x 6.50 mm
