tomas-tavella/Proyecto-Final/Reference Designs/Proyecto Irusta-Caravelli/Altium/ALTIUM_EMBEDDED_MODELS/User Library-Header Vertical 2_54mm Pitch2-1.STEP

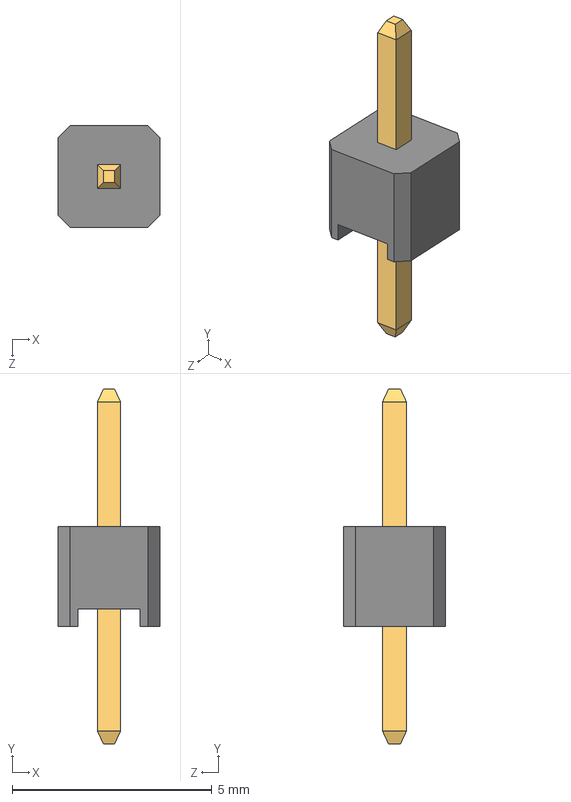
[picture p155: CAD file, 2022-04-29]
Reference Designs/Proyecto Irusta-Caravelli/Altium/ALTIUM_EMBEDDED_MODELS/User Library-Header Vertical 2_54mm Pitch2-1.STEP
2.54 x 8.88 x 2.54 mm
