tomas-tavella/Proyecto-Final/Reference Designs/Proyecto Irusta-Caravelli/Altium/ALTIUM_EMBEDDED_MODELS/SW3dPS-Potenciometro Vertical.STEP

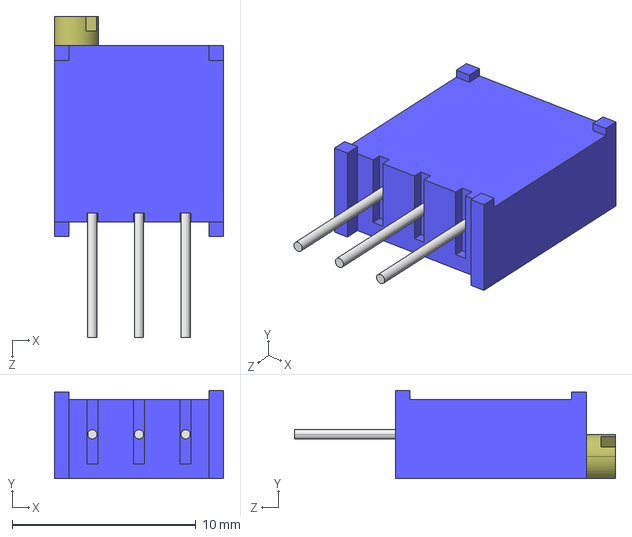
[picture p156: CAD file, 2022-04-29]
Reference Designs/Proyecto Irusta-Caravelli/Altium/ALTIUM_EMBEDDED_MODELS/SW3dPS-Potenciometro Vertical.STEP
9.20 x 4.80 x 17.5 mm
