tomas-tavella/Proyecto-Final/Reference Designs/Proyecto Irusta-Caravelli/Altium/ALTIUM_EMBEDDED_MODELS/SW3dPS-POWER MOSFET, NON-SURFACE-MOUNT.STEP

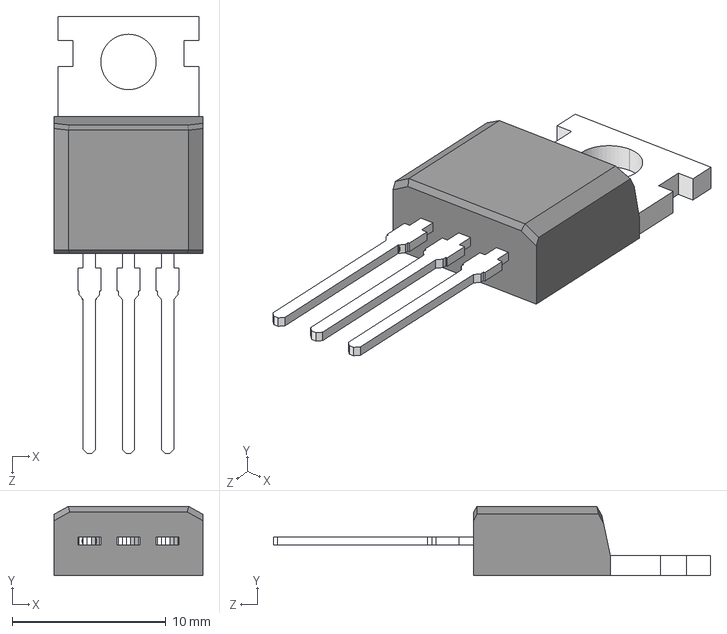
[picture p157: CAD file, 2022-04-29]
Reference Designs/Proyecto Irusta-Caravelli/Altium/ALTIUM_EMBEDDED_MODELS/SW3dPS-POWER MOSFET, NON-SURFACE-MOUNT.STEP
9.65 x 4.50 x 28.4 mm
