tomas-tavella/Proyecto-Final/Reference Designs/Proyecto Irusta-Caravelli/Altium/ALTIUM_EMBEDDED_MODELS/User Library-Capacitor Radial Electrolitic.STEP

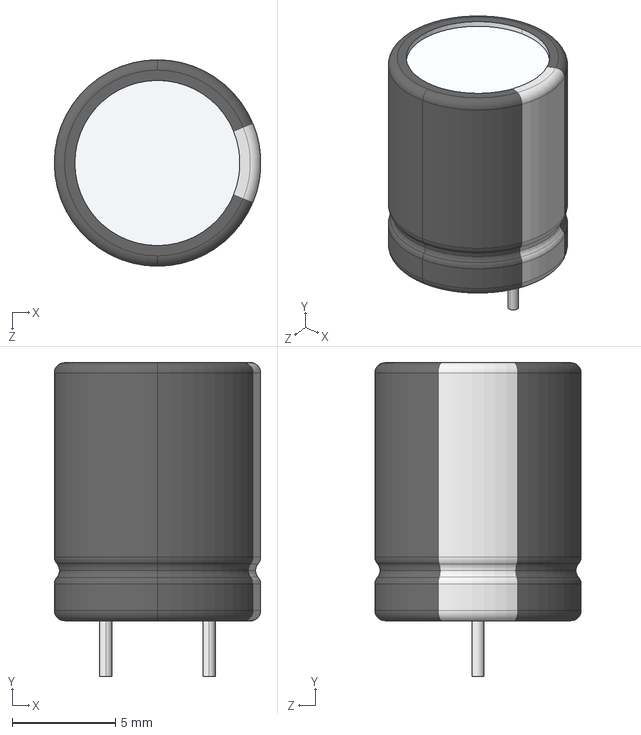
[picture p158: CAD file, 2022-04-29]
Reference Designs/Proyecto Irusta-Caravelli/Altium/ALTIUM_EMBEDDED_MODELS/User Library-Capacitor Radial Electrolitic.STEP
10.0 x 15.2 x 10.00 mm
