tomas-tavella/Proyecto-Final/(list of files, cad)

Other CAD files:
Reference Designs/Placa adaptadora TMS320F28335/Proyecto Altium/Models 3d/7 seg/User Library-FYS-3912.STEP
Reference Designs/Placa adaptadora TMS320F28335/Proyecto Altium/ALTIUM_EMBEDDED_MODELS/SW3dPS-0805 SMD Capacitor.STEP
Reference Designs/Proyecto Irusta-Caravelli/Altium/ALTIUM_EMBEDDED_MODELS/LED 5mm VERDE.STEP
Reference Designs/Placa adaptadora TMS320F28335/Proyecto Altium/ALTIUM_EMBEDDED_MODELS/R1206.STEP
Reference Designs/Placa adaptadora TMS320F28335/Proyecto Altium/ALTIUM_EMBEDDED_MODELS/14640.stp
Reference Designs/Placa adaptadora TMS320F28335/Proyecto Altium/ALTIUM_EMBEDDED_MODELS/19623.stp
Reference Designs/Placa adaptadora TMS320F28335/Proyecto Altium/Models 3d/HTSSOP/29207.stp
Reference Designs/Proyecto Irusta-Caravelli/Altium/ALTIUM_EMBEDDED_MODELS/11386.stp
Reference Designs/Proyecto Irusta-Caravelli/Altium/ALTIUM_EMBEDDED_MODELS/12664.stp
