tomas-tavella/Proyecto-Final/Informe/Secciones/5 - Puebas y Ensayos/5 - Pruebas y Ensayos.tex

\section{Pruebas y Ensayos} \label{ensayos}
\AddToShipoutPictureBG*{}
\thispagestyle{plain}

\vspace{0.5cm}

\Large\scshape
\begin{center}
    {\Medium Relevamiento experimental del funcionamiento\\ de la plataforma resultante}
\end{center}
\normalfont
%\normalsize

\divider

Para darle cierre a este proyecto, con la plataforma ya diseñada e implementada exitosamente en la placa de circuito impreso, incluyendo el soldado de todos sus componentes, se avanzó con una serie de pruebas y ensayos con el fin de verificar el diseño que se desarrolló. Estas son pruebas apuntadas a verificar que las distintas partes del sistema funcionen de la manera que se espera.\\

\begin{figure}[h]
    \centering
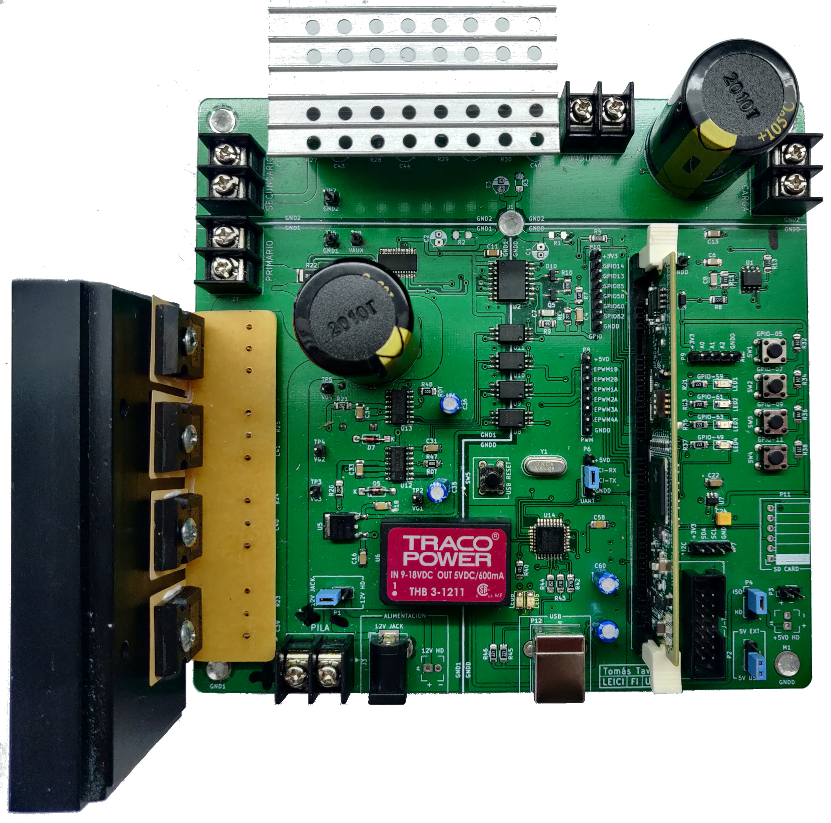
[picture p159: Informe/Imagenes/Placa Final.jpg]
    
    \caption{La plataforma de evaluación en su estado final. Se puede ver el puente de MOSFET montado sobre la placa adaptadora a la izquierda, el rectificador en la parte superior, ocultado por el disipador, y la controlCARD en su socket a la derecha.}
    \label{plataforma_completa}
\end{figure}

Por limitaciones de tiempo, no se pudieron hacer las pruebas de todos los componentes: se realizaron ensayos sobre módulo de generación de ondas PWM, el circuito driver para el disparo de las llaves, y finalmente se llevó a cabo una evaluación del convertidor CC-CC puente completo para distintas condiciones de carga. Con el éxito de estos ensayos, también se demostró indirectamente el funcionamiento satisfactorio de todos los circuitos de alimentación y del controlador digital de señales.\\

\input{Secciones/5 - Puebas y Ensayos/5.1 - Configuracion Experimental.tex}

\newpage

\input{Secciones/5 - Puebas y Ensayos/5.2 - Ensayo sin Carga.tex}

\newpage

\input{Secciones/5 - Puebas y Ensayos/5.3 - Ensayo con Carga.tex}

\newpage

\input{Secciones/5 - Puebas y Ensayos/5.4 - Resumen.tex}

\afterpage{\blankpage}\newpage
