tomas-tavella/Proyecto-Final/Capturas y Ensayos/Capturas Osciloscopio/Pruebas Sistema Completo - Con Carga/ALL0001/F0001CH1.CSV

Record Length | 2.500000e+03 | 0.015971000000 | -0.20000
Sample Interval | 2.000000e-08 | 0.015971020000 | 0.00000
Trigger Point | -7.985500000000e+05 | 0.015971040000 | -0.20000
 |  | 0.015971060000 | -0.20000
 |  | 0.015971080000 | 0.00000
 |  | 0.015971100000 | -0.20000
Source | CH1 | 0.015971120000 | 0.00000
Vertical Units | V | 0.015971140000 | 0.00000
Vertical Scale | 5.000000e+00 | 0.015971160000 | -0.20000
Vertical Offset | 0.000000e+00 | 0.015971180000 | -0.20000
Horizontal Units | s | 0.015971200000 | 0.00000
Horizontal Scale | 5.000000e-06 | 0.015971220000 | -0.20000
Pt Fmt | Y | 0.015971240000 | -0.20000
Yzero | 0.000000e+00 | 0.015971260000 | 0.00000
Probe Atten | 1.000000e+01 | 0.015971280000 | -0.40000
Model Number | TBS1102B | 0.015971300000 | -0.20000
Serial Number | C033696 | 0.015971320000 | -0.20000
Firmware Version | FV:v4.06 | 0.015971340000 | 0.00000
 |  | 0.015971360000 | 0.00000
 |  | 0.015971380000 | -0.20000
 |  | 0.015971400000 | 0.00000
 |  | 0.015971420000 | -0.20000
 |  | 0.015971440000 | 0.00000
 |  | 0.015971460000 | -0.20000
 |  | 0.015971480000 | 0.00000
 |  | 0.015971500000 | -0.20000
 |  | 0.015971520000 | 0.20000
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
