tomas-tavella/Proyecto-Final/Capturas y Ensayos/Capturas Osciloscopio/Pruebas Sistema Completo - Con Carga/ALL0014/F0014CH2.CSV

Record Length | 2.500000e+03 | 0.015943200000 | 0.09600
Sample Interval | 4.000000e-08 | 0.015943240000 | 0.09600
Trigger Point | -3.985800000000e+05 | 0.015943280000 | 0.09800
 |  | 0.015943320000 | 0.09600
 |  | 0.015943360000 | 0.09800
 |  | 0.015943400000 | 0.09800
Source | CH2 | 0.015943440000 | 0.10400
Vertical Units | V | 0.015943480000 | 0.09600
Vertical Scale | 5.000000e-02 | 0.015943520000 | 0.09200
Vertical Offset | 5.000000e-02 | 0.015943560000 | 0.09400
Horizontal Units | s | 0.015943600000 | 0.09800
Horizontal Scale | 1.000000e-05 | 0.015943640000 | 0.09600
Pt Fmt | Y | 0.015943680000 | 0.09200
Yzero | 0.000000e+00 | 0.015943720000 | 0.09800
Probe Atten | 1.000000e+00 | 0.015943760000 | 0.10000
Model Number | TBS1102B | 0.015943800000 | 0.09800
Serial Number | C033696 | 0.015943840000 | 0.10000
Firmware Version | FV:v4.06 | 0.015943880000 | 0.09800
 |  | 0.015943920000 | 0.09600
 |  | 0.015943960000 | 0.09600
 |  | 0.015944000000 | 0.09600
 |  | 0.015944040000 | 0.09200
 |  | 0.015944080000 | 0.09400
 |  | 0.015944120000 | 0.09600
 |  | 0.015944160000 | 0.09600
 |  | 0.015944200000 | 0.09600
 |  | 0.015944240000 | 0.09800
 |  | 0.015944280000 | 0.09200
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
