tomas-tavella/Proyecto-Final/Capturas y Ensayos/Capturas Osciloscopio/Pruebas Sistema Completo - Con Carga/ALL0018/F0018CH1.CSV

Record Length | 2.500000e+03 | 0.015968400000 | 14.80000
Sample Interval | 4.000000e-08 | 0.015968440000 | 15.00000
Trigger Point | -3.992100000000e+05 | 0.015968480000 | 14.80000
 |  | 0.015968520000 | 14.60000
 |  | 0.015968560000 | 15.00000
 |  | 0.015968600000 | 15.00000
Source | CH1 | 0.015968640000 | 14.80000
Vertical Units | V | 0.015968680000 | 14.80000
Vertical Scale | 5.000000e+00 | 0.015968720000 | 14.80000
Vertical Offset | 0.000000e+00 | 0.015968760000 | 14.80000
Horizontal Units | s | 0.015968800000 | 14.60000
Horizontal Scale | 1.000000e-05 | 0.015968840000 | 14.60000
Pt Fmt | Y | 0.015968880000 | 15.00000
Yzero | 0.000000e+00 | 0.015968920000 | 15.20000
Probe Atten | 1.000000e+01 | 0.015968960000 | 14.80000
Model Number | TBS1102B | 0.015969000000 | 14.80000
Serial Number | C033696 | 0.015969040000 | 14.80000
Firmware Version | FV:v4.06 | 0.015969080000 | 15.00000
 |  | 0.015969120000 | 15.00000
 |  | 0.015969160000 | 14.80000
 |  | 0.015969200000 | 15.00000
 |  | 0.015969240000 | 15.00000
 |  | 0.015969280000 | 15.00000
 |  | 0.015969320000 | 15.20000
 |  | 0.015969360000 | 14.60000
 |  | 0.015969400000 | 14.80000
 |  | 0.015969440000 | 15.00000
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
