tomas-tavella/Proyecto-Final/Capturas y Ensayos/Capturas Osciloscopio/Pruebas Sistema Completo - Con Carga/ALL0020/F0020CH1.CSV

Record Length | 2.500000e+03 | 0.015999400000 | -0.80000
Sample Interval | 2.000000e-08 | 0.015999420000 | -0.80000
Trigger Point | -7.999700000000e+05 | 0.015999440000 | -0.80000
 |  | 0.015999460000 | -0.80000
 |  | 0.015999480000 | 0.00000
 |  | 0.015999500000 | -0.80000
Source | CH1 | 0.015999520000 | -0.80000
Vertical Units | V | 0.015999540000 | 0.00000
Vertical Scale | 2.000000e+01 | 0.015999560000 | -1.60000
Vertical Offset | -3.920000e+01 | 0.015999580000 | -0.80000
Horizontal Units | s | 0.015999600000 | -0.80000
Horizontal Scale | 5.000000e-06 | 0.015999620000 | -1.60000
Pt Fmt | Y | 0.015999640000 | -0.80000
Yzero | 0.000000e+00 | 0.015999660000 | -1.60000
Probe Atten | 1.000000e+01 | 0.015999680000 | -0.80000
Model Number | TBS1102B | 0.015999700000 | -0.80000
Serial Number | C033696 | 0.015999720000 | -1.60000
Firmware Version | FV:v4.06 | 0.015999740000 | -0.80000
 |  | 0.015999760000 | -0.80000
 |  | 0.015999780000 | -0.80000
 |  | 0.015999800000 | 0.00000
 |  | 0.015999820000 | 0.00000
 |  | 0.015999840000 | -1.60000
 |  | 0.015999860000 | -0.80000
 |  | 0.015999880000 | -0.80000
 |  | 0.015999900000 | 0.00000
 |  | 0.015999920000 | -1.60000
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
