tomas-tavella/Proyecto-Final/Capturas y Ensayos/Capturas Osciloscopio/Pruebas Sistema Completo - Con Carga/ALL0022/F0022CH2.CSV

Record Length | 2.500000e+03 | 0.015993600000 | 0.29200
Sample Interval | 2.000000e-08 | 0.015993620000 | 0.29200
Trigger Point | -7.996800000000e+05 | 0.015993640000 | 0.29200
 |  | 0.015993660000 | 0.28400
 |  | 0.015993680000 | 0.28800
 |  | 0.015993700000 | 0.28800
Source | CH2 | 0.015993720000 | 0.28400
Vertical Units | V | 0.015993740000 | 0.28800
Vertical Scale | 1.000000e-01 | 0.015993760000 | 0.28000
Vertical Offset | -3.760000e-01 | 0.015993780000 | 0.29200
Horizontal Units | s | 0.015993800000 | 0.28800
Horizontal Scale | 5.000000e-06 | 0.015993820000 | 0.28800
Pt Fmt | Y | 0.015993840000 | 0.28400
Yzero | 0.000000e+00 | 0.015993860000 | 0.28800
Probe Atten | 1.000000e+00 | 0.015993880000 | 0.28400
Model Number | TBS1102B | 0.015993900000 | 0.28800
Serial Number | C033696 | 0.015993920000 | 0.28400
Firmware Version | FV:v4.06 | 0.015993940000 | 0.28000
 |  | 0.015993960000 | 0.27600
 |  | 0.015993980000 | 0.28000
 |  | 0.015994000000 | 0.28400
 |  | 0.015994020000 | 0.28000
 |  | 0.015994040000 | 0.28400
 |  | 0.015994060000 | 0.28800
 |  | 0.015994080000 | 0.29200
 |  | 0.015994100000 | 0.28400
 |  | 0.015994120000 | 0.28000
 |  | 0.015994140000 | 0.28800
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
