tomas-tavella/Proyecto-Final/Capturas y Ensayos/Capturas Osciloscopio/Pruebas Sistema Completo - Con Carga/ALL0023/F0023CH2.CSV

Record Length | 2.500000e+03 | 0.015981200000 | 0.00800
Sample Interval | 4.000000e-08 | 0.015981240000 | 0.00400
Trigger Point | -3.995300000000e+05 | 0.015981280000 | 0.00400
 |  | 0.015981320000 | 0.00400
 |  | 0.015981360000 | 0.00800
 |  | 0.015981400000 | 0.00000
Source | CH2 | 0.015981440000 | 0.01200
Vertical Units | V | 0.015981480000 | 0.00800
Vertical Scale | 1.000000e-01 | 0.015981520000 | 0.00400
Vertical Offset | -3.760000e-01 | 0.015981560000 | 0.00800
Horizontal Units | s | 0.015981600000 | 0.00400
Horizontal Scale | 1.000000e-05 | 0.015981640000 | 0.00800
Pt Fmt | Y | 0.015981680000 | 0.01200
Yzero | 0.000000e+00 | 0.015981720000 | 0.00800
Probe Atten | 1.000000e+00 | 0.015981760000 | 0.00400
Model Number | TBS1102B | 0.015981800000 | 0.00800
Serial Number | C033696 | 0.015981840000 | 0.00800
Firmware Version | FV:v4.06 | 0.015981880000 | 0.00400
 |  | 0.015981920000 | 0.00800
 |  | 0.015981960000 | 0.00400
 |  | 0.015982000000 | 0.00800
 |  | 0.015982040000 | 0.00800
 |  | 0.015982080000 | 0.00800
 |  | 0.015982120000 | 0.00800
 |  | 0.015982160000 | 0.00800
 |  | 0.015982200000 | 0.00800
 |  | 0.015982240000 | 0.00800
 |  | 0.015982280000 | 0.00800
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
