tomas-tavella/Proyecto-Final/Capturas y Ensayos/Capturas Osciloscopio/Pruebas Sistema Completo - Con Carga/ALL0024/F0024CH1.CSV

Record Length | 2.500000e+03 | 0.015981200000 | -102.00000
Sample Interval | 4.000000e-08 | 0.015981240000 | -106.00000
Trigger Point | -3.995300000000e+05 | 0.015981280000 | -102.00000
 |  | 0.015981320000 | -104.00000
 |  | 0.015981360000 | -106.00000
 |  | 0.015981400000 | -106.00000
Source | CH1 | 0.015981440000 | -104.00000
Vertical Units | V | 0.015981480000 | -106.00000
Vertical Scale | 5.000000e+01 | 0.015981520000 | -102.00000
Vertical Offset | 0.000000e+00 | 0.015981560000 | -104.00000
Horizontal Units | s | 0.015981600000 | -104.00000
Horizontal Scale | 1.000000e-05 | 0.015981640000 | -106.00000
Pt Fmt | Y | 0.015981680000 | -104.00000
Yzero | 0.000000e+00 | 0.015981720000 | -104.00000
Probe Atten | 1.000000e+01 | 0.015981760000 | -104.00000
Model Number | TBS1102B | 0.015981800000 | -102.00000
Serial Number | C033696 | 0.015981840000 | -102.00000
Firmware Version | FV:v4.06 | 0.015981880000 | -104.00000
 |  | 0.015981920000 | -104.00000
 |  | 0.015981960000 | -104.00000
 |  | 0.015982000000 | -104.00000
 |  | 0.015982040000 | -104.00000
 |  | 0.015982080000 | -104.00000
 |  | 0.015982120000 | -106.00000
 |  | 0.015982160000 | -104.00000
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
