tomas-tavella/Proyecto-Final/Capturas y Ensayos/Capturas Osciloscopio/Pruebas Sistema Completo - Con Carga/ALL0026/F0026CH2.CSV

Record Length | 2.500000e+03 | 0.015981200000 | 0.38800
Sample Interval | 4.000000e-08 | 0.015981240000 | 0.38400
Trigger Point | -3.995300000000e+05 | 0.015981280000 | 0.38400
 |  | 0.015981320000 | 0.38800
 |  | 0.015981360000 | 0.38800
 |  | 0.015981400000 | 0.38800
Source | CH2 | 0.015981440000 | 0.38800
Vertical Units | V | 0.015981480000 | 0.38400
Vertical Scale | 1.000000e-01 | 0.015981520000 | 0.37600
Vertical Offset | -3.800000e-01 | 0.015981560000 | 0.38400
Horizontal Units | s | 0.015981600000 | 0.38400
Horizontal Scale | 1.000000e-05 | 0.015981640000 | 0.38400
Pt Fmt | Y | 0.015981680000 | 0.38000
Yzero | 0.000000e+00 | 0.015981720000 | 0.37600
Probe Atten | 1.000000e+00 | 0.015981760000 | 0.37600
Model Number | TBS1102B | 0.015981800000 | 0.38000
Serial Number | C033696 | 0.015981840000 | 0.38400
Firmware Version | FV:v4.06 | 0.015981880000 | 0.38400
 |  | 0.015981920000 | 0.38000
 |  | 0.015981960000 | 0.38800
 |  | 0.015982000000 | 0.38400
 |  | 0.015982040000 | 0.38000
 |  | 0.015982080000 | 0.38400
 |  | 0.015982120000 | 0.38400
 |  | 0.015982160000 | 0.38800
 |  | 0.015982200000 | 0.38400
 |  | 0.015982240000 | 0.38400
 |  | 0.015982280000 | 0.38400
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
