tomas-tavella/Proyecto-Final/Capturas y Ensayos/Capturas Osciloscopio/Pruebas Sistema Completo - Con Carga/ALL0030/F0030CH1.CSV

Record Length | 2.500000e+03 | 0.015971000000 | -0.80000
Sample Interval | 4.000000e-08 | 0.015971040000 | -0.80000
Trigger Point | -3.992750000000e+05 | 0.015971080000 | 0.00000
 |  | 0.015971120000 | 0.00000
 |  | 0.015971160000 | -0.80000
 |  | 0.015971200000 | 0.00000
Source | CH1 | 0.015971240000 | 0.00000
Vertical Units | V | 0.015971280000 | 0.00000
Vertical Scale | 2.000000e+01 | 0.015971320000 | 0.00000
Vertical Offset | -7.200000e+01 | 0.015971360000 | 0.00000
Horizontal Units | s | 0.015971400000 | -0.80000
Horizontal Scale | 1.000000e-05 | 0.015971440000 | 0.00000
Pt Fmt | Y | 0.015971480000 | -0.80000
Yzero | 0.000000e+00 | 0.015971520000 | -1.60000
Probe Atten | 1.000000e+01 | 0.015971560000 | -0.80000
Model Number | TBS1102B | 0.015971600000 | 0.80000
Serial Number | C033696 | 0.015971640000 | 0.00000
Firmware Version | FV:v4.06 | 0.015971680000 | 0.00000
 |  | 0.015971720000 | 0.00000
 |  | 0.015971760000 | 0.80000
 |  | 0.015971800000 | 0.00000
 |  | 0.015971840000 | -0.80000
 |  | 0.015971880000 | 0.00000
 |  | 0.015971920000 | -0.80000
 |  | 0.015971960000 | -0.80000
 |  | 0.015972000000 | 0.00000
 |  | 0.015972040000 | -0.80000
 |  | 0.015972080000 | -0.80000
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
