tomas-tavella/Proyecto-Final/Capturas y Ensayos/Capturas Osciloscopio/Pruebas Sistema Completo - Con Carga/ALL0032/F0032CH1.CSV

Record Length | 2.500000e+03 | 0.015996200000 | -0.80000
Sample Interval | 2.000000e-08 | 0.015996220000 | -0.80000
Trigger Point | -7.998100000000e+05 | 0.015996240000 | -0.80000
 |  | 0.015996260000 | 0.00000
 |  | 0.015996280000 | -1.60000
 |  | 0.015996300000 | 0.00000
Source | CH1 | 0.015996320000 | -0.80000
Vertical Units | V | 0.015996340000 | 0.00000
Vertical Scale | 2.000000e+01 | 0.015996360000 | -0.80000
Vertical Offset | -7.200000e+01 | 0.015996380000 | 0.00000
Horizontal Units | s | 0.015996400000 | -0.80000
Horizontal Scale | 5.000000e-06 | 0.015996420000 | 0.00000
Pt Fmt | Y | 0.015996440000 | -0.80000
Yzero | 0.000000e+00 | 0.015996460000 | -0.80000
Probe Atten | 1.000000e+01 | 0.015996480000 | -1.60000
Model Number | TBS1102B | 0.015996500000 | -0.80000
Serial Number | C033696 | 0.015996520000 | -0.80000
Firmware Version | FV:v4.06 | 0.015996540000 | -0.80000
 |  | 0.015996560000 | -0.80000
 |  | 0.015996580000 | 0.00000
 |  | 0.015996600000 | 0.00000
 |  | 0.015996620000 | 0.00000
 |  | 0.015996640000 | -0.80000
 |  | 0.015996660000 | -0.80000
 |  | 0.015996680000 | -0.80000
 |  | 0.015996700000 | -0.80000
 |  | 0.015996720000 | -1.60000
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
