tomas-tavella/Proyecto-Final/Capturas y Ensayos/Capturas Osciloscopio/Pruebas Llaves/12 - Tensión Pata - Neutro (Fase 0°)/F0012MTH.CSV

Record Length | 2.500000e+03 | -0.000074800000 | -2.00000
Sample Interval | 4.000000e-08 | -0.000074760000 | 0.00000
Trigger Point | 1.870000000000e+03 | -0.000074720000 | -20.00000
 |  | -0.000074680000 | -2.00000
 |  | -0.000074640000 | 2.00000
 |  | -0.000074600000 | -2.00000
Source | MATH | -0.000074560000 | 0.00000
Vertical Units | V | -0.000074520000 | 2.00000
Vertical Scale | 5.000000e+01 | -0.000074480000 | -4.00000
Vertical Offset | 2.000000e+00 | -0.000074440000 | 0.00000
Horizontal Units | s | -0.000074400000 | -2.00000
Horizontal Scale | 1.000000e-05 | -0.000074360000 | -2.00000
Pt Fmt | Y | -0.000074320000 | -2.00000
Yzero | 0.000000e+00 | -0.000074280000 | -2.00000
Probe Atten | 1.000000e+00 | -0.000074240000 | -2.00000
Model Number | TBS1102B | -0.000074200000 | -4.00000
Serial Number | C033696 | -0.000074160000 | -2.00000
Firmware Version | FV:v4.06 | -0.000074120000 | -2.00000
 |  | -00.000074080000 | 0.00000
 |  | -00.000074040000 | -2.00000
 |  | -00.000074000000 | 0.00000
 |  | -00.000073960000 | -2.00000
 |  | -00.000073920000 | 0.00000
 |  | -00.000073880000 | -4.00000
 |  | -00.000073840000 | -2.00000
 |  | -00.000073800000 | -4.00000
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
