tomas-tavella/Proyecto-Final/Capturas y Ensayos/Capturas Osciloscopio/Pruebas PWM y Drivers/3 - Dead-Time DSP RE/F0002CH2.CSV

Record Length | 2.500000e+03 | -0.000000500000 | 0.04000
Sample Interval | 4.000000e-10 | -0.000000499600 | 0.04000
Trigger Point | 1.250000000000e+03 | -0.000000499200 | 0.08000
 |  | -0.000000498800 | 0.08000
 |  | -0.000000498400 | 0.08000
 |  | -0.000000498000 | 0.12000
Source | CH2 | -0.000000497600 | 0.08000
Vertical Units | V | -0.000000497200 | 0.08000
Vertical Scale | 1.000000e+00 | -0.000000496800 | 0.12000
Vertical Offset | -1.640000e+00 | -0.000000496400 | 0.08000
Horizontal Units | s | -0.000000496000 | 0.04000
Horizontal Scale | 1.000000e-07 | -0.000000495600 | 0.08000
Pt Fmt | Y | -0.000000495200 | 0.12000
Yzero | 0.000000e+00 | -0.000000494800 | 0.12000
Probe Atten | 1.000000e+01 | -0.000000494400 | 0.08000
Model Number | TBS1102B | -0.000000494000 | 0.08000
Serial Number | C033696 | -0.000000493600 | 0.08000
Firmware Version | FV:v4.06 | -0.000000493200 | 0.04000
 |  | -00.000000492800 | 0.04000
 |  | -00.000000492400 | 0.04000
 |  | -00.000000492000 | 0.04000
 |  | -00.000000491600 | 0.04000
 |  | -00.000000491200 | 0.04000
 |  | -00.000000490800 | 0.04000
 |  | -00.000000490400 | 0.04000
 |  | -00.000000490000 | 0.08000
 |  | -00.000000489600 | 0.04000
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
