tomas-tavella/Proyecto-Final/Capturas y Ensayos/Capturas Osciloscopio/Pruebas PWM y Drivers/4 - Dead-Time DSP FE/F0003CH1.CSV

Record Length | 2.500000e+03 | 0.000024300000 | 3.32000
Sample Interval | 4.000000e-10 | 0.000024300400 | 3.32000
Trigger Point | -6.075000000000e+04 | 0.000024300800 | 3.32000
 |  | 0.000024301200 | 3.28000
 |  | 0.000024301600 | 3.28000
 |  | 0.000024302000 | 3.28000
Source | CH1 | 0.000024302400 | 3.28000
Vertical Units | V | 0.000024302800 | 3.32000
Vertical Scale | 1.000000e+00 | 0.000024303200 | 3.28000
Vertical Offset | -1.640000e+00 | 0.000024303600 | 3.24000
Horizontal Units | s | 0.000024304000 | 3.28000
Horizontal Scale | 1.000000e-07 | 0.000024304400 | 3.28000
Pt Fmt | Y | 0.000024304800 | 3.28000
Yzero | 0.000000e+00 | 0.000024305200 | 3.28000
Probe Atten | 1.000000e+01 | 0.000024305600 | 3.28000
Model Number | TBS1102B | 0.000024306000 | 3.32000
Serial Number | C033696 | 0.000024306400 | 3.32000
Firmware Version | FV:v4.06 | 0.000024306800 | 3.32000
 |  | 0.000024307200 | 3.32000
 |  | 0.000024307600 | 3.32000
 |  | 0.000024308000 | 3.32000
 |  | 0.000024308400 | 3.36000
 |  | 0.000024308800 | 3.36000
 |  | 0.000024309200 | 3.36000
 |  | 0.000024309600 | 3.32000
 |  | 0.000024310000 | 3.32000
 |  | 0.000024310400 | 3.32000
 |  | 0.000024310800 | 3.32000
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
