tomas-tavella/Proyecto-Final/Capturas y Ensayos/Capturas Osciloscopio/Pruebas PWM y Drivers/5 - Salidas Driver Izq/F0004CH1.CSV

Record Length | 2.500000e+03 | -0.000100200000 | 0.20000
Sample Interval | 1.000000e-07 | -0.000100100000 | 0.00000
Trigger Point | 1.002000000000e+03 | -0.000100000000 | 0.00000
 |  | -0.000099900000 | -0.20000
 |  | -0.000099800000 | 0.00000
 |  | -0.000099700000 | 0.00000
Source | CH1 | -0.000099600000 | -0.20000
Vertical Units | V | -0.000099500000 | 0.20000
Vertical Scale | 5.000000e+00 | -0.000099400000 | 0.20000
Vertical Offset | 1.000000e+00 | -0.000099300000 | 12.60000
Horizontal Units | s | -0.000099200000 | 12.20000
Horizontal Scale | 2.500000e-05 | -0.000099100000 | 12.40000
Pt Fmt | Y | -0.000099000000 | 12.40000
Yzero | 0.000000e+00 | -0.000098900000 | 12.40000
Probe Atten | 1.000000e+01 | -0.000098800000 | 12.40000
Model Number | TBS1102B | -0.000098700000 | 12.40000
Serial Number | C033696 | -0.000098600000 | 12.40000
Firmware Version | FV:v4.06 | -0.000098500000 | 12.40000
 |  | -00.000098400000 | 12.20000
 |  | -00.000098300000 | 12.40000
 |  | -00.000098200000 | 12.60000
 |  | -00.000098100000 | 12.40000
 |  | -00.000098000000 | 12.60000
 |  | -00.000097900000 | 12.40000
 |  | -00.000097800000 | 12.20000
 |  | -00.000097700000 | 12.40000
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
