tomas-tavella/Proyecto-Final/Capturas y Ensayos/Capturas Osciloscopio/Pruebas PWM y Drivers/6 - Dead-Time Driver Izq/F0005CH2.CSV

Record Length | 2.500000e+03 | -0.000012600000 | 11.40000
Sample Interval | 2.000000e-08 | -0.000012580000 | 11.60000
Trigger Point | 6.300000000000e+02 | -0.000012560000 | 11.60000
 |  | -0.000012540000 | 11.60000
 |  | -0.000012520000 | 11.20000
 |  | -0.000012500000 | 11.60000
Source | CH2 | -0.000012480000 | 11.40000
Vertical Units | V | -0.000012460000 | 11.40000
Vertical Scale | 5.000000e+00 | -0.000012440000 | 11.60000
Vertical Offset | -1.240000e+01 | -0.000012420000 | 11.40000
Horizontal Units | s | -0.000012400000 | 11.40000
Horizontal Scale | 5.000000e-06 | -0.000012380000 | 11.20000
Pt Fmt | Y | -0.000012360000 | 11.40000
Yzero | 0.000000e+00 | -0.000012340000 | 11.60000
Probe Atten | 1.000000e+01 | -0.000012320000 | 11.60000
Model Number | TBS1102B | -0.000012300000 | 11.40000
Serial Number | C033696 | -0.000012280000 | 11.40000
Firmware Version | FV:v4.06 | -0.000012260000 | 11.40000
 |  | -00.000012240000 | 11.20000
 |  | -00.000012220000 | 11.80000
 |  | -00.000012200000 | 11.60000
 |  | -00.000012180000 | 11.60000
 |  | -00.000012160000 | 11.60000
 |  | -00.000012140000 | 11.80000
 |  | -00.000012120000 | 11.80000
 |  | -00.000012100000 | 11.20000
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
