tomas-tavella/Proyecto-Final/Capturas y Ensayos/Capturas Osciloscopio/Pruebas PWM y Drivers/7 - Dead-Time Driver Izq (FE y RE)/F0006CH1.CSV

Record Length | 2.500000e+03 | 0.000023326000 | 12.60000
Sample Interval | 1.000000e-09 | 0.000023327000 | 12.40000
Trigger Point | -2.332600000000e+04 | 0.000023328000 | 12.60000
 |  | 0.000023329000 | 12.60000
 |  | 0.000023330000 | 12.60000
 |  | 0.000023331000 | 12.40000
Source | CH1 | 0.000023332000 | 12.40000
Vertical Units | V | 0.000023333000 | 12.40000
Vertical Scale | 5.000000e+00 | 0.000023334000 | 12.60000
Vertical Offset | 1.000000e+00 | 0.000023335000 | 12.60000
Horizontal Units | s | 0.000023336000 | 12.60000
Horizontal Scale | 2.500000e-07 | 0.000023337000 | 12.60000
Pt Fmt | Y | 0.000023338000 | 12.40000
Yzero | 0.000000e+00 | 0.000023339000 | 12.60000
Probe Atten | 1.000000e+01 | 0.000023340000 | 12.60000
Model Number | TBS1102B | 0.000023341000 | 12.80000
Serial Number | C033696 | 0.000023342000 | 12.60000
Firmware Version | FV:v4.06 | 0.000023343000 | 12.60000
 |  | 0.000023344000 | 12.60000
 |  | 0.000023345000 | 12.60000
 |  | 0.000023346000 | 12.60000
 |  | 0.000023347000 | 12.40000
 |  | 0.000023348000 | 12.40000
 |  | 0.000023349000 | 12.60000
 |  | 0.000023350000 | 12.40000
 |  | 0.000023351000 | 12.40000
 |  | 0.000023352000 | 12.60000
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
