tomas-tavella/Proyecto-Final/Capturas y Ensayos/Capturas Osciloscopio/Pruebas PWM y Drivers/7 - Dead-Time Driver Izq (RE y FE)/F0007CH1.CSV

Record Length | 2.500000e+03 | -0.000001610000 | 0.20000
Sample Interval | 1.000000e-09 | -0.000001609000 | 0.40000
Trigger Point | 1.610000000000e+03 | -0.000001608000 | 0.20000
 |  | -0.000001607000 | 0.00000
 |  | -0.000001606000 | 0.20000
 |  | -0.000001605000 | 0.00000
Source | CH1 | -0.000001604000 | 0.20000
Vertical Units | V | -0.000001603000 | 0.20000
Vertical Scale | 5.000000e+00 | -0.000001602000 | 0.20000
Vertical Offset | 1.000000e+00 | -0.000001601000 | 0.00000
Horizontal Units | s | -0.000001600000 | 0.20000
Horizontal Scale | 2.500000e-07 | -0.000001599000 | 0.20000
Pt Fmt | Y | -0.000001598000 | 0.00000
Yzero | 0.000000e+00 | -0.000001597000 | 0.00000
Probe Atten | 1.000000e+01 | -0.000001596000 | 0.20000
Model Number | TBS1102B | -0.000001595000 | 0.20000
Serial Number | C033696 | -0.000001594000 | 0.20000
Firmware Version | FV:v4.06 | -0.000001593000 | 0.00000
 |  | -00.000001592000 | 0.00000
 |  | -00.000001591000 | 0.20000
 |  | -00.000001590000 | 0.40000
 |  | -00.000001589000 | 0.20000
 |  | -00.000001588000 | 0.20000
 |  | -00.000001587000 | 0.00000
 |  | -00.000001586000 | 0.20000
 |  | -00.000001585000 | 0.00000
 |  | -00.000001584000 | 0.00000
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
