tomas-tavella/Proyecto-Final/Capturas y Ensayos/Capturas Osciloscopio/Pruebas PWM y Drivers/7 - Dead-Time Driver Izq (RE y FE)/F0007CH2.CSV

Record Length | 2.500000e+03 | -0.000001610000 | 11.20000
Sample Interval | 1.000000e-09 | -0.000001609000 | 11.60000
Trigger Point | 1.610000000000e+03 | -0.000001608000 | 11.40000
 |  | -0.000001607000 | 11.60000
 |  | -0.000001606000 | 11.00000
 |  | -0.000001605000 | 11.20000
Source | CH2 | -0.000001604000 | 11.60000
Vertical Units | V | -0.000001603000 | 11.40000
Vertical Scale | 5.000000e+00 | -0.000001602000 | 11.00000
Vertical Offset | -1.240000e+01 | -0.000001601000 | 11.20000
Horizontal Units | s | -0.000001600000 | 11.40000
Horizontal Scale | 2.500000e-07 | -0.000001599000 | 11.40000
Pt Fmt | Y | -0.000001598000 | 11.60000
Yzero | 0.000000e+00 | -0.000001597000 | 11.40000
Probe Atten | 1.000000e+01 | -0.000001596000 | 11.40000
Model Number | TBS1102B | -0.000001595000 | 11.60000
Serial Number | C033696 | -0.000001594000 | 11.40000
Firmware Version | FV:v4.06 | -0.000001593000 | 11.40000
 |  | -00.000001592000 | 11.40000
 |  | -00.000001591000 | 11.40000
 |  | -00.000001590000 | 11.40000
 |  | -00.000001589000 | 11.40000
 |  | -00.000001588000 | 11.40000
 |  | -00.000001587000 | 11.80000
 |  | -00.000001586000 | 11.60000
 |  | -00.000001585000 | 11.60000
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
