tomas-tavella/Proyecto-Final/Capturas y Ensayos/Capturas Osciloscopio/Pruebas PWM y Drivers/8 - Salidas Driver Der/F0008CH1.CSV

Record Length | 2.500000e+03 | -0.000125000000 | 12.20000
Sample Interval | 1.000000e-07 | -0.000124900000 | 12.20000
Trigger Point | 1.250000000000e+03 | -0.000124800000 | -0.20000
 |  | -0.000124700000 | -0.20000
 |  | -0.000124600000 | -0.20000
 |  | -0.000124500000 | -0.20000
Source | CH1 | -0.000124400000 | -0.20000
Vertical Units | V | -0.000124300000 | -0.40000
Vertical Scale | 5.000000e+00 | -0.000124200000 | 0.00000
Vertical Offset | 1.000000e+00 | -0.000124100000 | 0.00000
Horizontal Units | s | -0.000124000000 | -0.20000
Horizontal Scale | 2.500000e-05 | -0.000123900000 | 0.00000
Pt Fmt | Y | -0.000123800000 | 0.00000
Yzero | 0.000000e+00 | -0.000123700000 | 0.40000
Probe Atten | 1.000000e+01 | -0.000123600000 | -0.20000
Model Number | TBS1102B | -0.000123500000 | 0.00000
Serial Number | C033696 | -0.000123400000 | 0.00000
Firmware Version | FV:v4.06 | -0.000123300000 | 0.00000
 |  | -00.000123200000 | 0.00000
 |  | -00.000123100000 | 0.00000
 |  | -00.000123000000 | -0.20000
 |  | -00.000122900000 | 0.00000
 |  | -00.000122800000 | 0.00000
 |  | -00.000122700000 | -0.20000
 |  | -00.000122600000 | 0.00000
 |  | -00.000122500000 | 0.20000
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
