tomas-tavella/Proyecto-Final/Capturas y Ensayos/Capturas Osciloscopio/Pruebas PWM y Drivers/9 - Dead-Time Driver Der (FE y RE)/F0009CH2.CSV

Record Length | 2.500000e+03 | 0.000023330000 | 0.20000
Sample Interval | 1.000000e-09 | 0.000023331000 | 0.20000
Trigger Point | -2.333000000000e+04 | 0.000023332000 | 0.00000
 |  | 0.000023333000 | 0.20000
 |  | 0.000023334000 | 0.20000
 |  | 0.000023335000 | 0.20000
Source | CH2 | 0.000023336000 | 0.20000
Vertical Units | V | 0.000023337000 | 0.40000
Vertical Scale | 5.000000e+00 | 0.000023338000 | 0.20000
Vertical Offset | -1.240000e+01 | 0.000023339000 | 0.20000
Horizontal Units | s | 0.000023340000 | 0.40000
Horizontal Scale | 2.500000e-07 | 0.000023341000 | 0.40000
Pt Fmt | Y | 0.000023342000 | 0.00000
Yzero | 0.000000e+00 | 0.000023343000 | 0.20000
Probe Atten | 1.000000e+01 | 0.000023344000 | 0.40000
Model Number | TBS1102B | 0.000023345000 | 0.40000
Serial Number | C033696 | 0.000023346000 | 0.20000
Firmware Version | FV:v4.06 | 0.000023347000 | 0.20000
 |  | 0.000023348000 | 0.20000
 |  | 0.000023349000 | 0.00000
 |  | 0.000023350000 | 0.20000
 |  | 0.000023351000 | 0.20000
 |  | 0.000023352000 | 0.00000
 |  | 0.000023353000 | 0.20000
 |  | 0.000023354000 | 0.20000
 |  | 0.000023355000 | 0.00000
 |  | 0.000023356000 | 0.20000
 |  | 0.000023357000 | 0.20000
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
