tomas-tavella/Proyecto-Final/Capturas y Ensayos/Capturas Osciloscopio/Pruebas PWM y Drivers/10 - Dead-Time Driver Der (RE y FE)/F0010CH1.CSV

Record Length | 2.500000e+03 | -0.000001620000 | 0.00000
Sample Interval | 1.000000e-09 | -0.000001619000 | 0.20000
Trigger Point | 1.620000000000e+03 | -0.000001618000 | 0.20000
 |  | -0.000001617000 | 0.00000
 |  | -0.000001616000 | 0.00000
 |  | -0.000001615000 | 0.00000
Source | CH1 | -0.000001614000 | 0.40000
Vertical Units | V | -0.000001613000 | 0.40000
Vertical Scale | 5.000000e+00 | -0.000001612000 | 0.20000
Vertical Offset | 1.000000e+00 | -0.000001611000 | 0.00000
Horizontal Units | s | -0.000001610000 | 0.00000
Horizontal Scale | 2.500000e-07 | -0.000001609000 | 0.20000
Pt Fmt | Y | -0.000001608000 | 0.00000
Yzero | 0.000000e+00 | -0.000001607000 | 0.20000
Probe Atten | 1.000000e+01 | -0.000001606000 | 0.20000
Model Number | TBS1102B | -0.000001605000 | 0.00000
Serial Number | C033696 | -0.000001604000 | 0.20000
Firmware Version | FV:v4.06 | -0.000001603000 | 0.20000
 |  | -00.000001602000 | -0.20000
 |  | -00.000001601000 | -0.20000
 |  | -00.000001600000 | 0.00000
 |  | -00.000001599000 | 0.00000
 |  | -00.000001598000 | 0.00000
 |  | -00.000001597000 | 0.20000
 |  | -00.000001596000 | 0.00000
 |  | -00.000001595000 | 0.20000
 |  | -00.000001594000 | 0.40000
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
