tomas-tavella/Proyecto-Final/Capturas y Ensayos/Capturas Osciloscopio/Pruebas PWM y Drivers/1 - Pata Izq DSP/F0000TEK.JPG

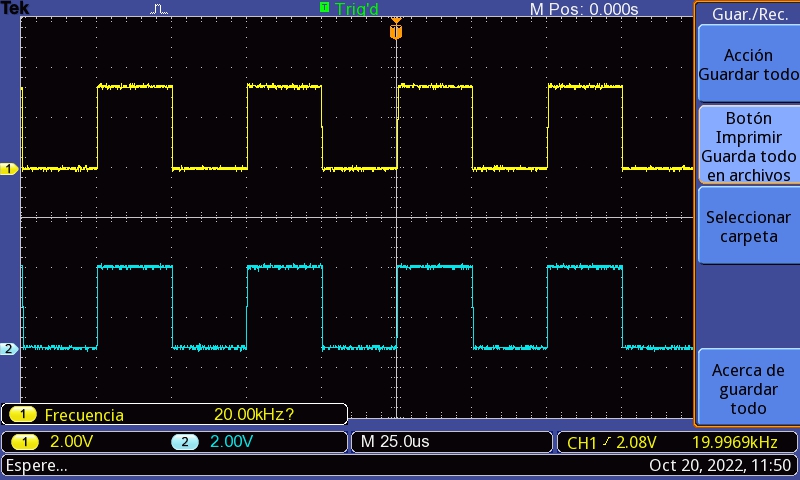
Capturas y Ensayos/Capturas Osciloscopio/Pruebas PWM y Drivers/1 - Pata Izq DSP/F0000TEK.JPG
