tomas-tavella/Proyecto-Final/Capturas y Ensayos/Capturas Osciloscopio/Pruebas PWM y Drivers/2 - PWM Diagonales DSP/F0001TEK.JPG

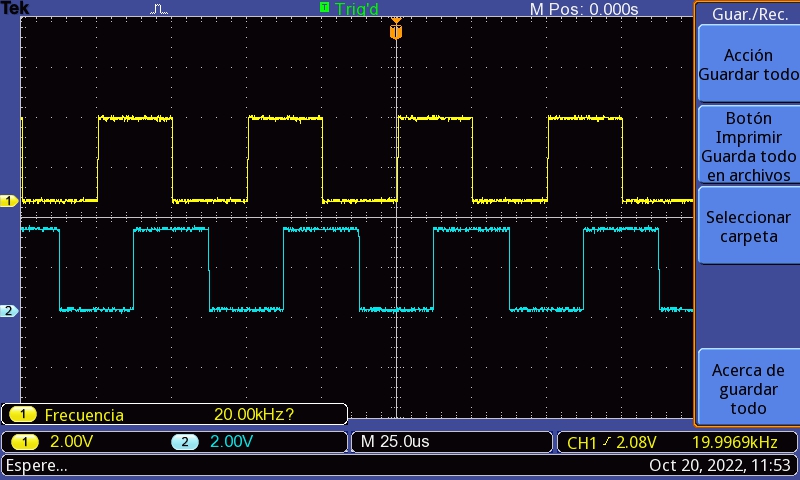
Capturas y Ensayos/Capturas Osciloscopio/Pruebas PWM y Drivers/2 - PWM Diagonales DSP/F0001TEK.JPG
