tomas-tavella/Proyecto-Final/Capturas y Ensayos/Capturas Osciloscopio/Pruebas PWM y Drivers/3 - Dead-Time DSP RE/F0002TEK.JPG

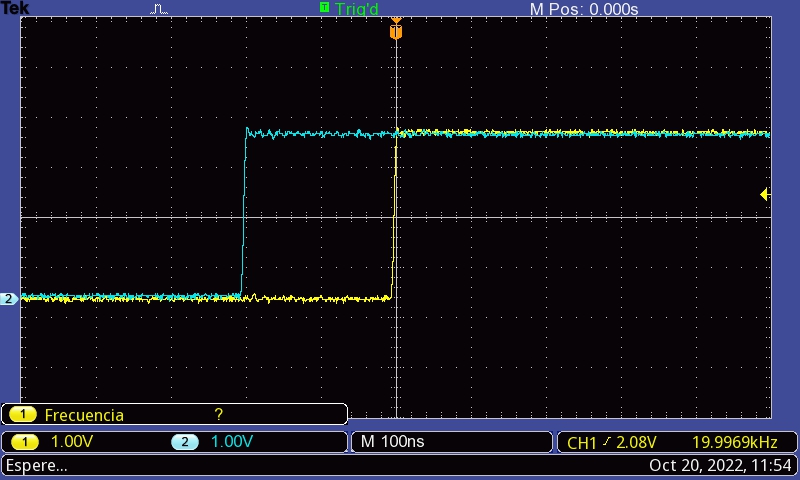
Capturas y Ensayos/Capturas Osciloscopio/Pruebas PWM y Drivers/3 - Dead-Time DSP RE/F0002TEK.JPG
