tomas-tavella/Proyecto-Final/Capturas y Ensayos/Capturas Osciloscopio/Pruebas PWM y Drivers/4 - Dead-Time DSP FE/F0003TEK.JPG

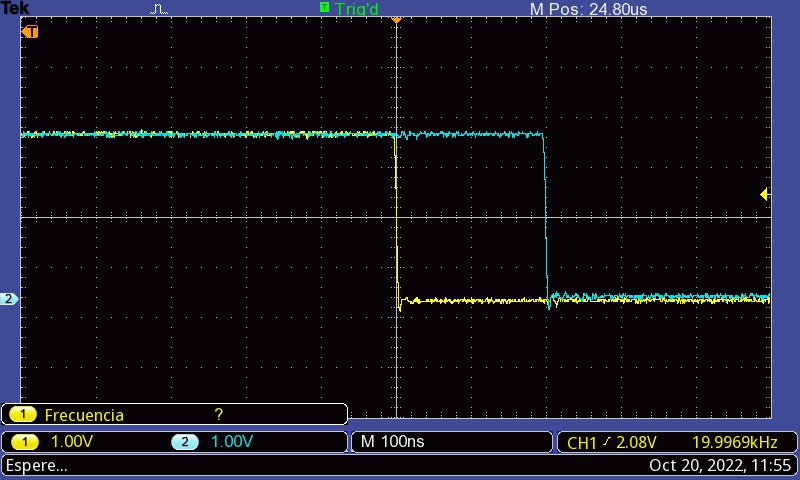
Capturas y Ensayos/Capturas Osciloscopio/Pruebas PWM y Drivers/4 - Dead-Time DSP FE/F0003TEK.JPG
