tomas-tavella/Proyecto-Final/Capturas y Ensayos/Capturas Osciloscopio/Pruebas PWM y Drivers/5 - Salidas Driver Izq/F0004TEK.JPG

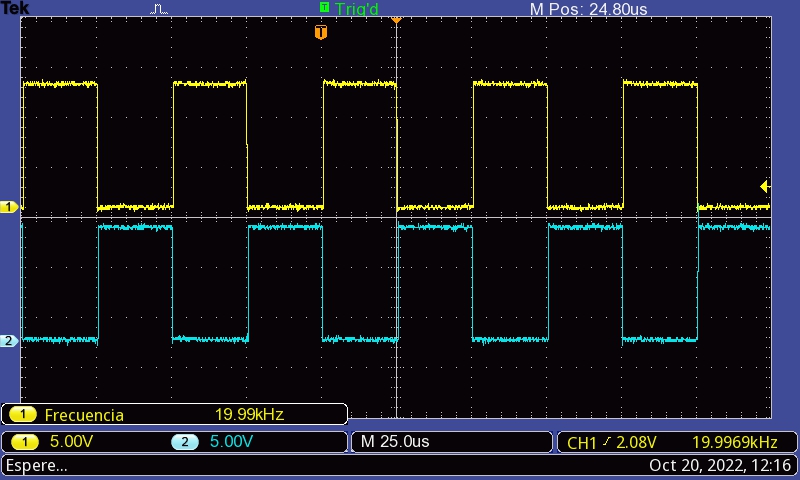
Capturas y Ensayos/Capturas Osciloscopio/Pruebas PWM y Drivers/5 - Salidas Driver Izq/F0004TEK.JPG
