tomas-tavella/Proyecto-Final/Capturas y Ensayos/Capturas Osciloscopio/Pruebas PWM y Drivers/6 - Dead-Time Driver Izq/F0005TEK.JPG

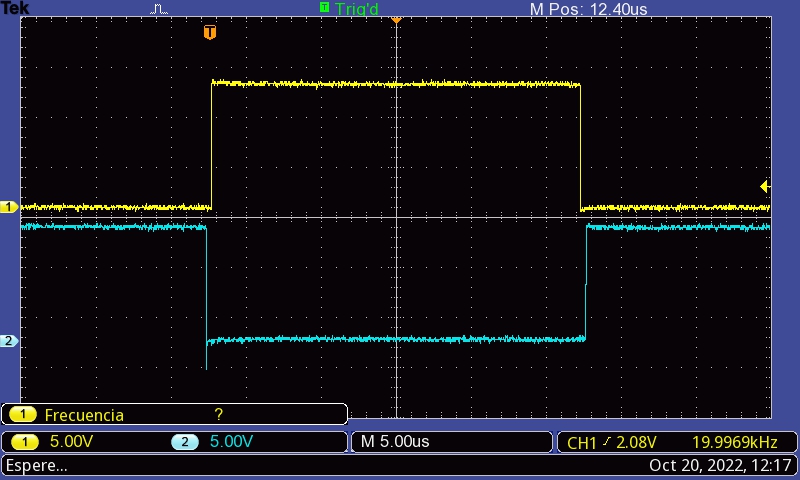
Capturas y Ensayos/Capturas Osciloscopio/Pruebas PWM y Drivers/6 - Dead-Time Driver Izq/F0005TEK.JPG
