tomas-tavella/Proyecto-Final/Capturas y Ensayos/Capturas Osciloscopio/Pruebas PWM y Drivers/7 - Dead-Time Driver Izq (FE y RE)/F0006TEK.JPG

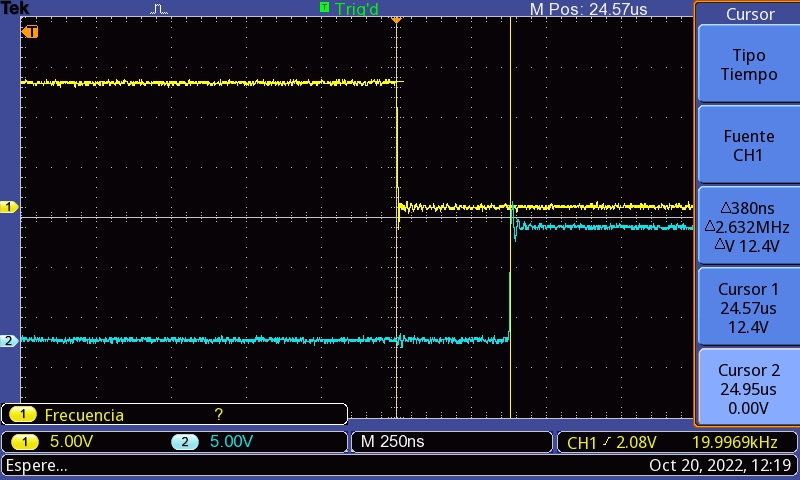
Capturas y Ensayos/Capturas Osciloscopio/Pruebas PWM y Drivers/7 - Dead-Time Driver Izq (FE y RE)/F0006TEK.JPG
