tomas-tavella/Proyecto-Final/Capturas y Ensayos/Capturas Osciloscopio/Pruebas PWM y Drivers/9 - Dead-Time Driver Der (FE y RE)/F0009TEK.JPG

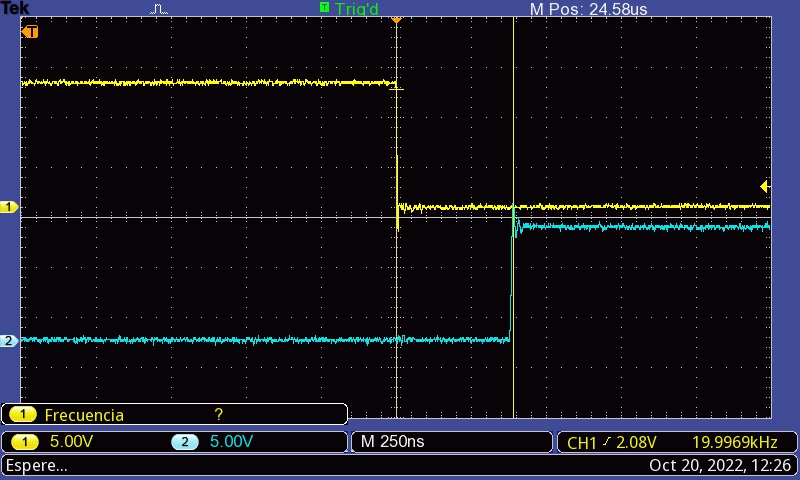
Capturas y Ensayos/Capturas Osciloscopio/Pruebas PWM y Drivers/9 - Dead-Time Driver Der (FE y RE)/F0009TEK.JPG
