tomas-tavella/Proyecto-Final/Capturas y Ensayos/Capturas Osciloscopio/Pruebas PWM y Drivers/10 - Dead-Time Driver Der (RE y FE)/F0010TEK.JPG

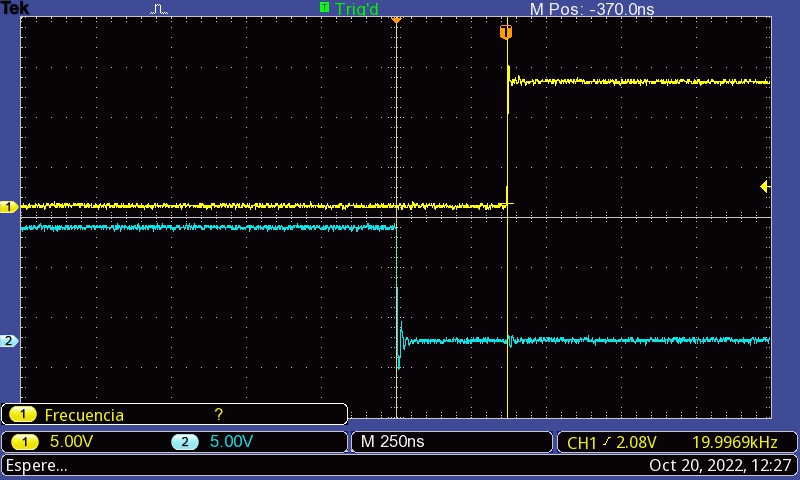
Capturas y Ensayos/Capturas Osciloscopio/Pruebas PWM y Drivers/10 - Dead-Time Driver Der (RE y FE)/F0010TEK.JPG
