tomas-tavella/Proyecto-Final/Informe PPS/Imagenes/Plataforma Detallada.pdf

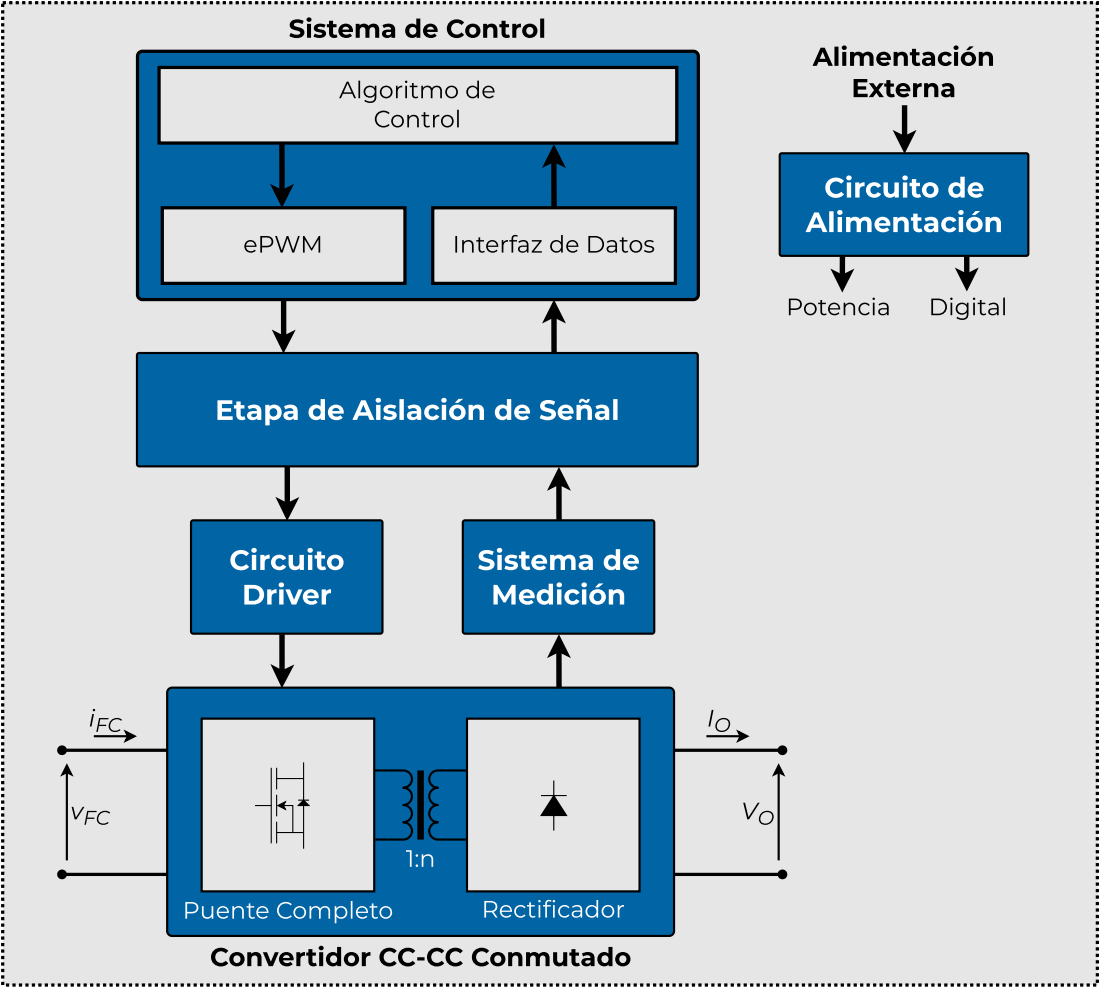
[picture p200: page 1]
Rectificador; Puente Completo; Circuito; Driver; Algoritmo de; Control; ePWM; Interfaz de Datos; Sistema de; Medición; Circuito de; Alimentación; vFC; iFC; Externa; Potencia; Digital

Sistema de Control

Etapa de Aislación de Señal

Convertidor CC-CC Conmutado
