tomas-tavella/Proyecto-Final/Reference Designs/Placa adaptadora TMS320F28335/Proyecto Altium/Placa adaptadora TMS320F28335.pdf

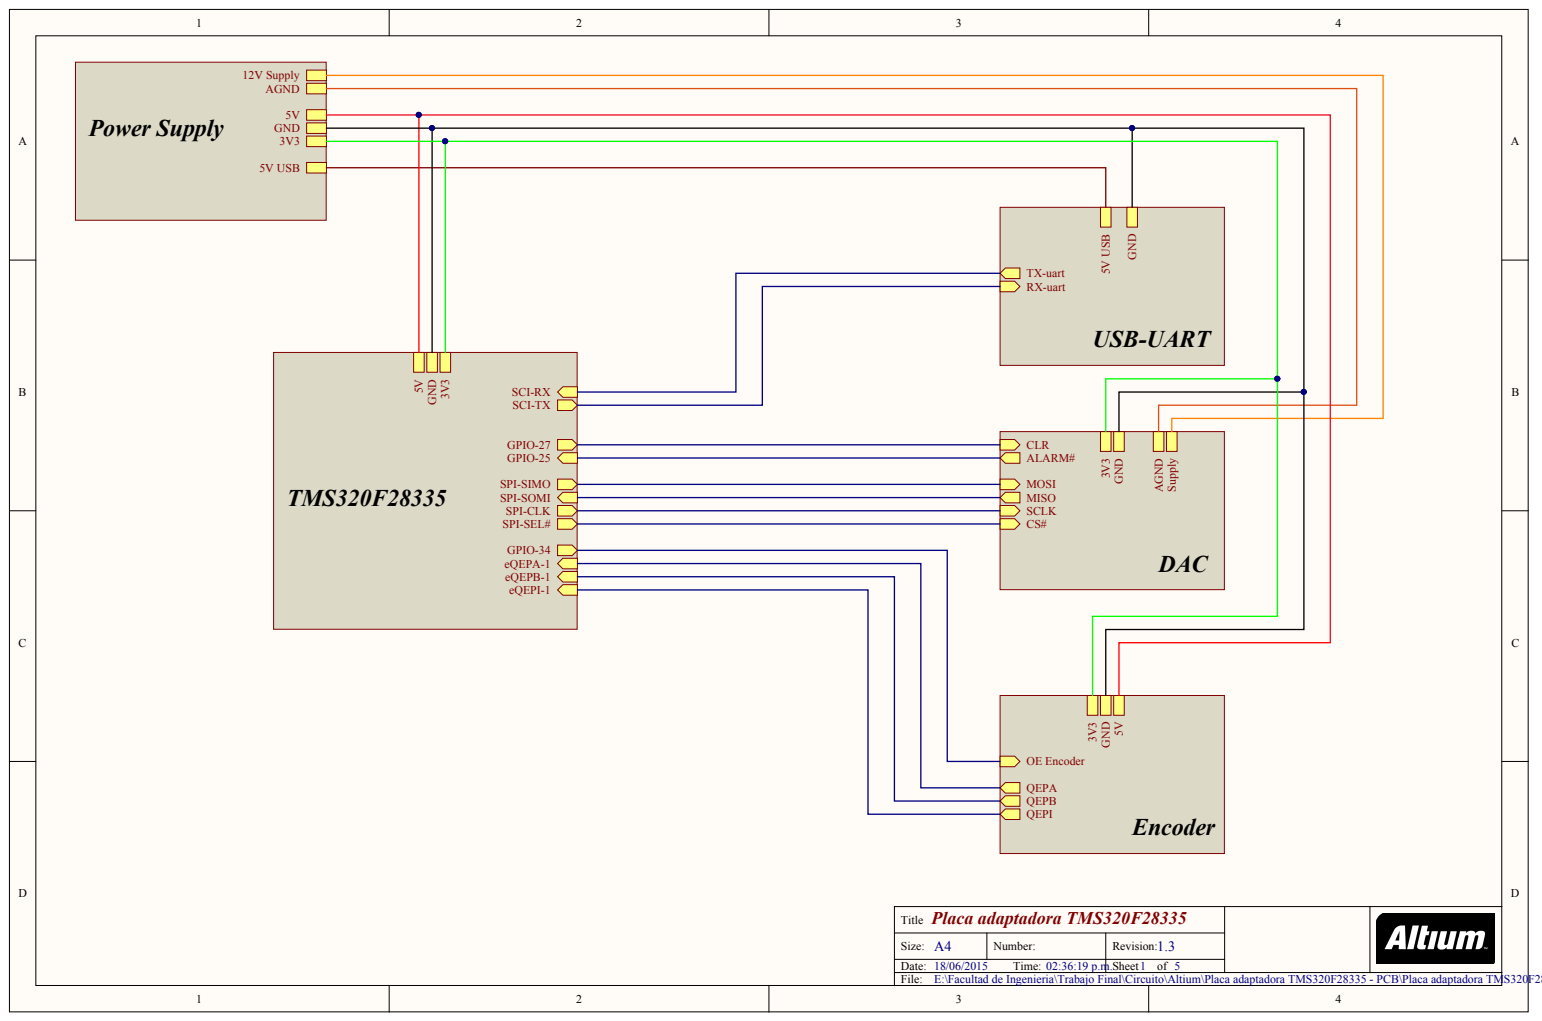
[picture p201: page 1]

Placa adaptadora TMS320F28335 Title

Size: A4 | Number: | Revision: 1.3
Date: 18/06/2015 Time: 02:36:19 p.m. | | Sheet of

E:\Facultad de Ingenieria\Trabajo Final\Circuito\Altium\Placa adaptadora TMS320F28335 - PCB\Placa adaptadora TMS320F28335.SchDoc

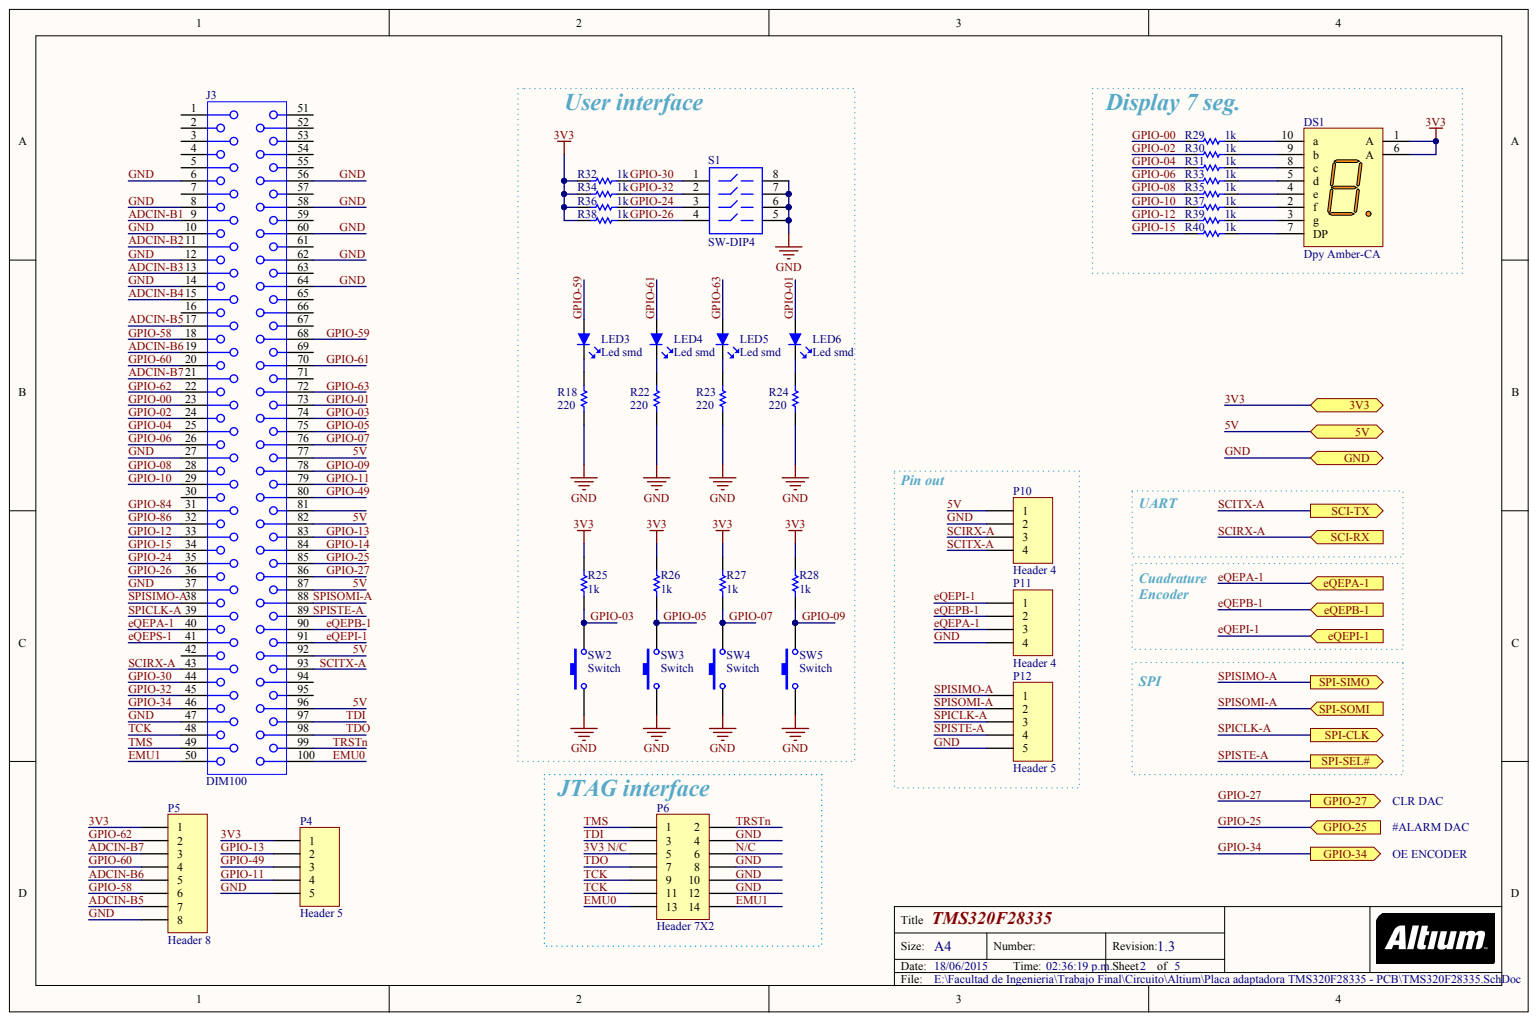
[picture p202: page 2]

TMS320F28335 Title

Size: A4 | Number: | Revision: 1.3

E:\Facultad de Ingenieria\Trabajo Final\Circuito\Altium\Placa adaptadora TMS320F28335 - PCB\TMS320F28335.SchDoc

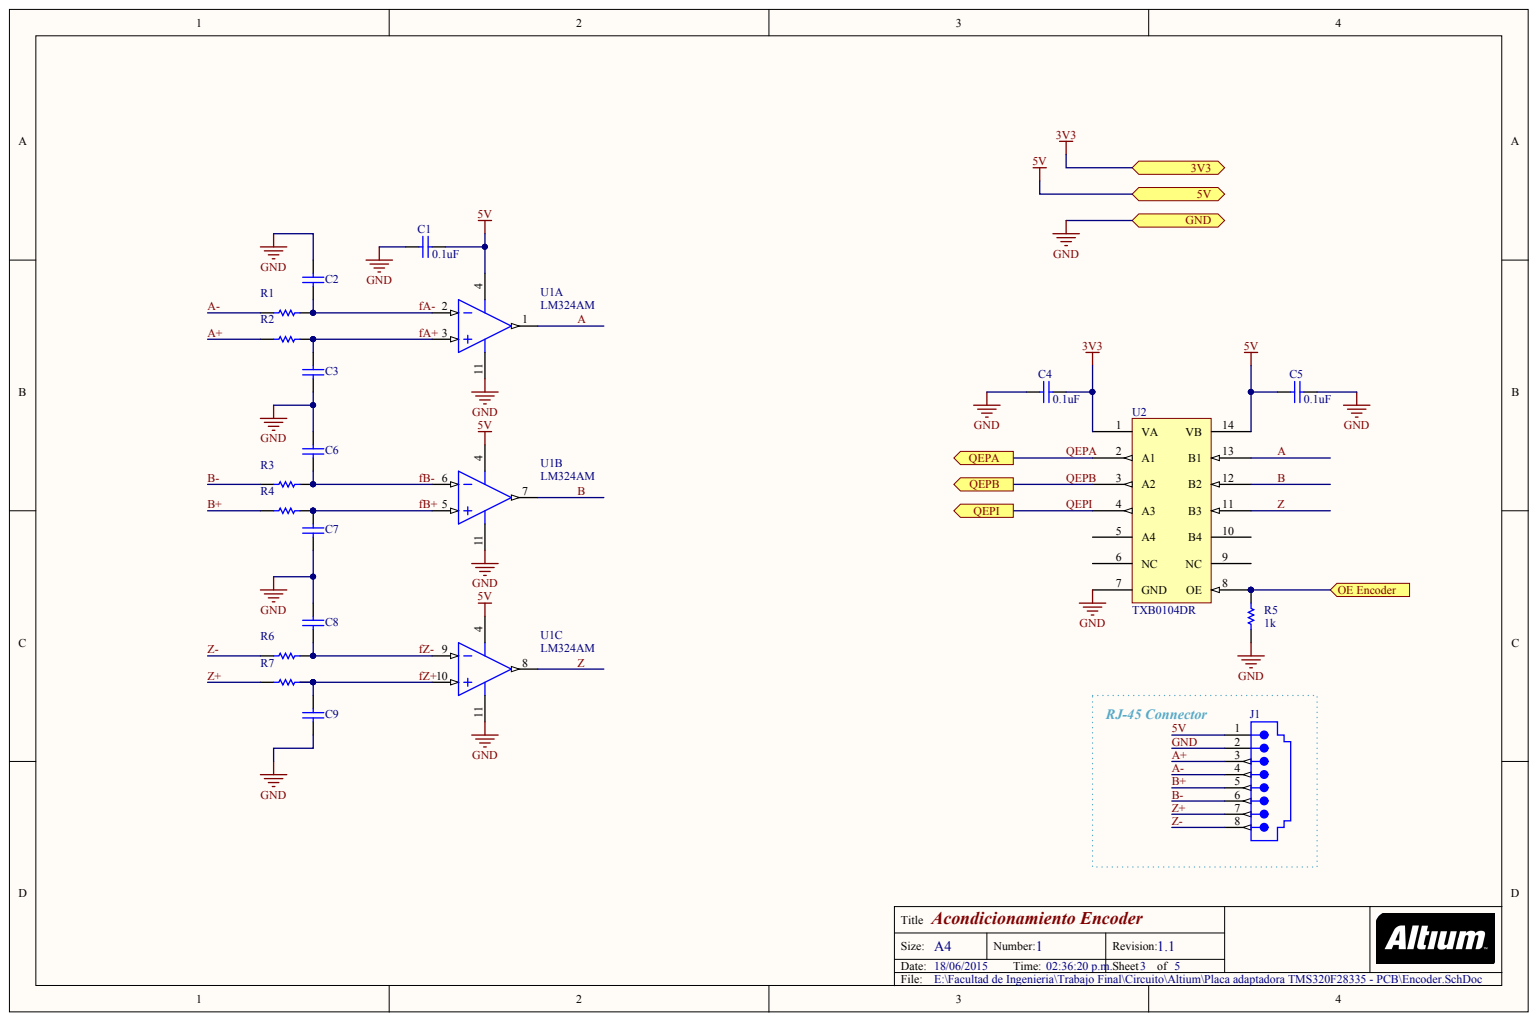
[picture p203: page 3]

Title

Size: A4 | Number: | Revision:

E:\Facultad de Ingenieria\Trabajo Final\Circuito\Altium\Placa adaptadora TMS320F28335 - PCB\Encoder.SchDoc

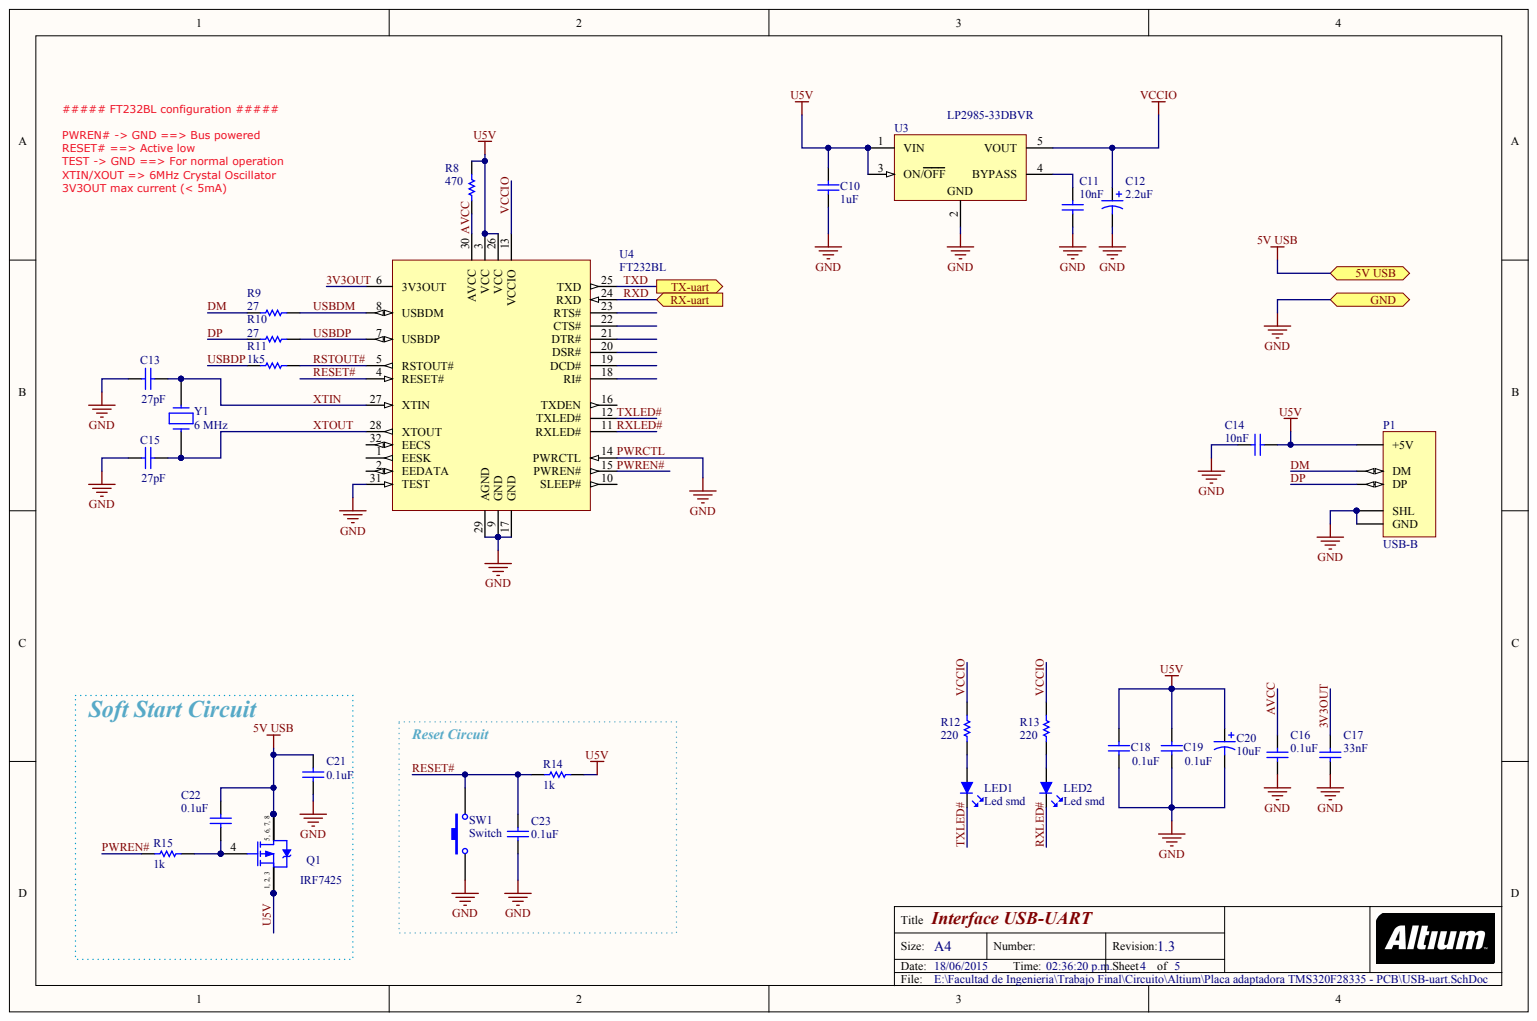
[picture p204: page 4]

PWREN# -> GND ==> Bus powered
RESET# ==> Active low
TEST -> GND ==> For normal operation
XTIN/XOUT => 6MHz Crystal Oscillator
3V3OUT max current (< 5mA)

Interface USB-UART Title

Size: A4 | Number: | Revision: 1.3

E:\Facultad de Ingenieria\Trabajo Final\Circuito\Altium\Placa adaptadora TMS320F28335 - PCB\USB-uart.SchDoc

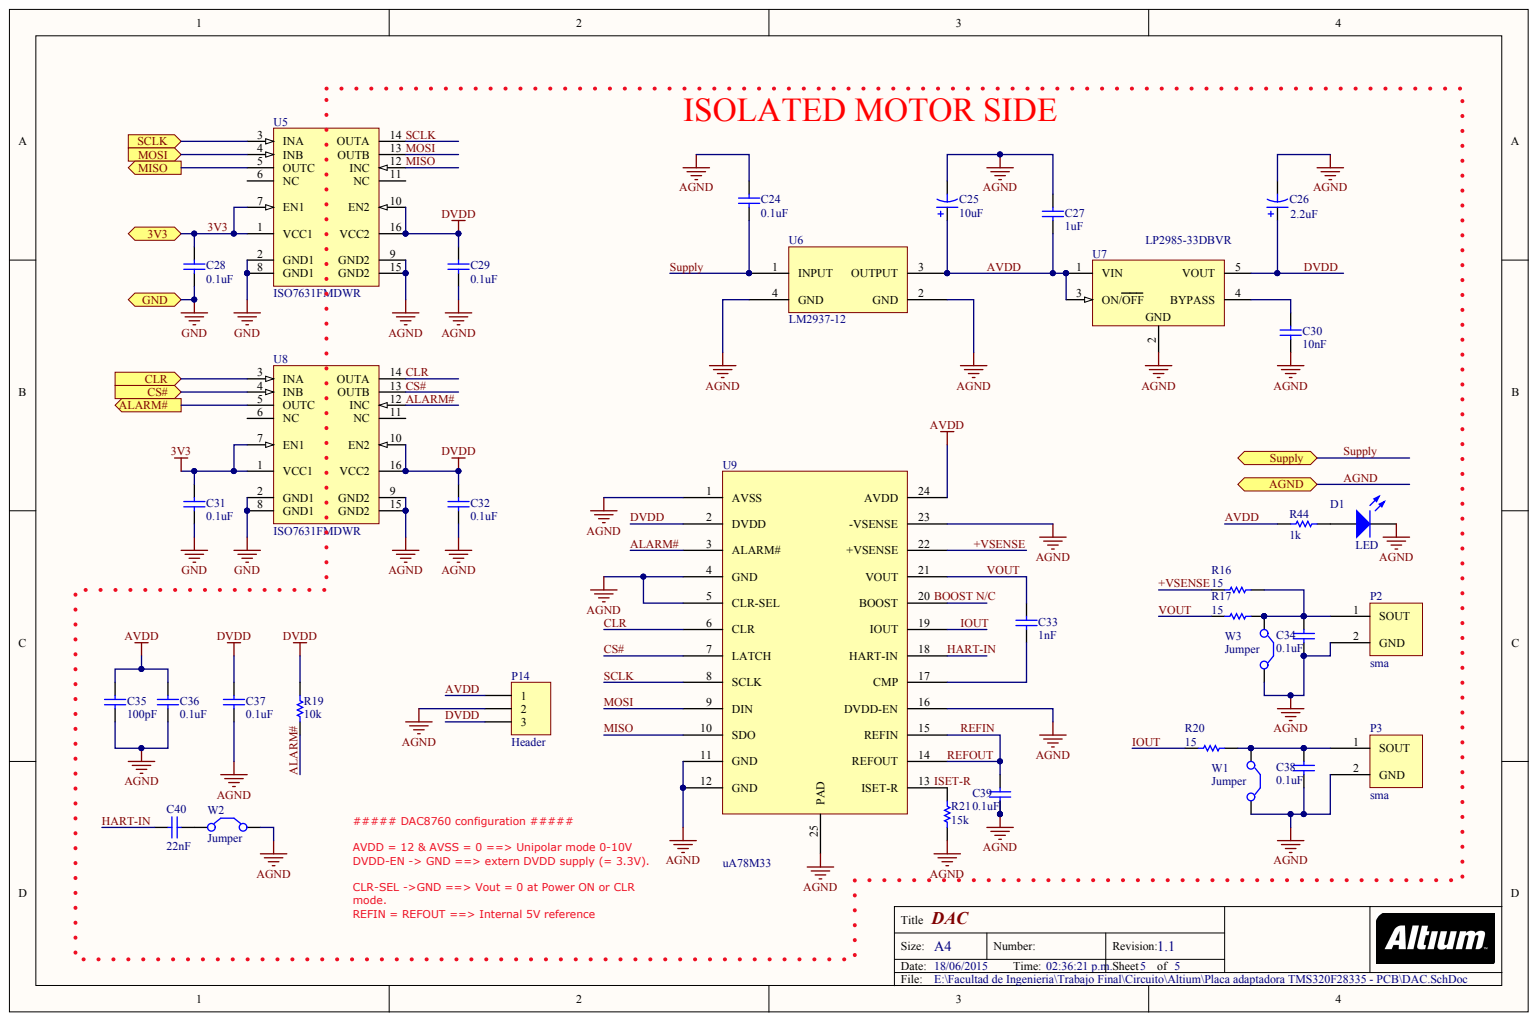
[picture p205: page 5]

1 | | DVDD

AVDD = 12 & AVSS = 0 ==> Unipol
DVDD-EN -> GND ==> extern DVDD supply (= 3.3V). CLR-SEL ->GND ==> Vout = 0 at Power ON or CLR

DAC Title

Size: A4 | Number: | Revision: 1.1

E:\Facultad de Ingenieria\Trabajo Final\Circuito\Altium\Placa adaptadora TMS320F28335 - PCB\DAC.SchDoc

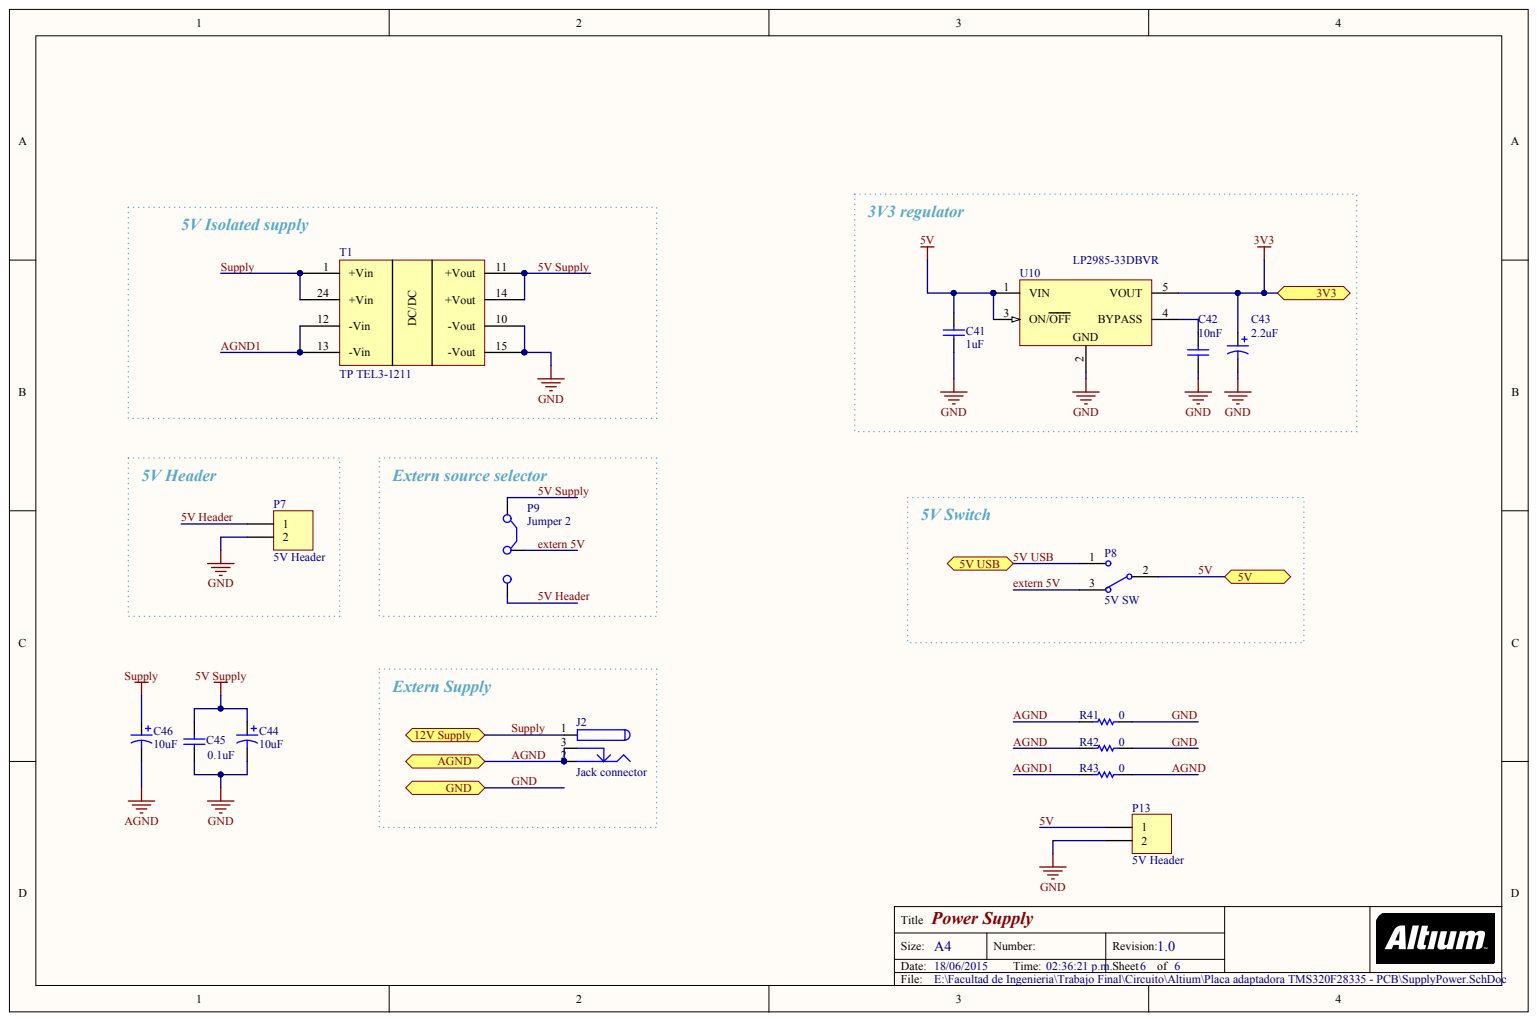
[picture p206: page 6]

Power Supply Title

Size: A4 | Number: | Revision: 1.0

E:\Facultad de Ingenieria\Trabajo Final\Circuito\Altium\Placa adaptadora TMS320F28335 - PCB\SupplyPower.SchDoc

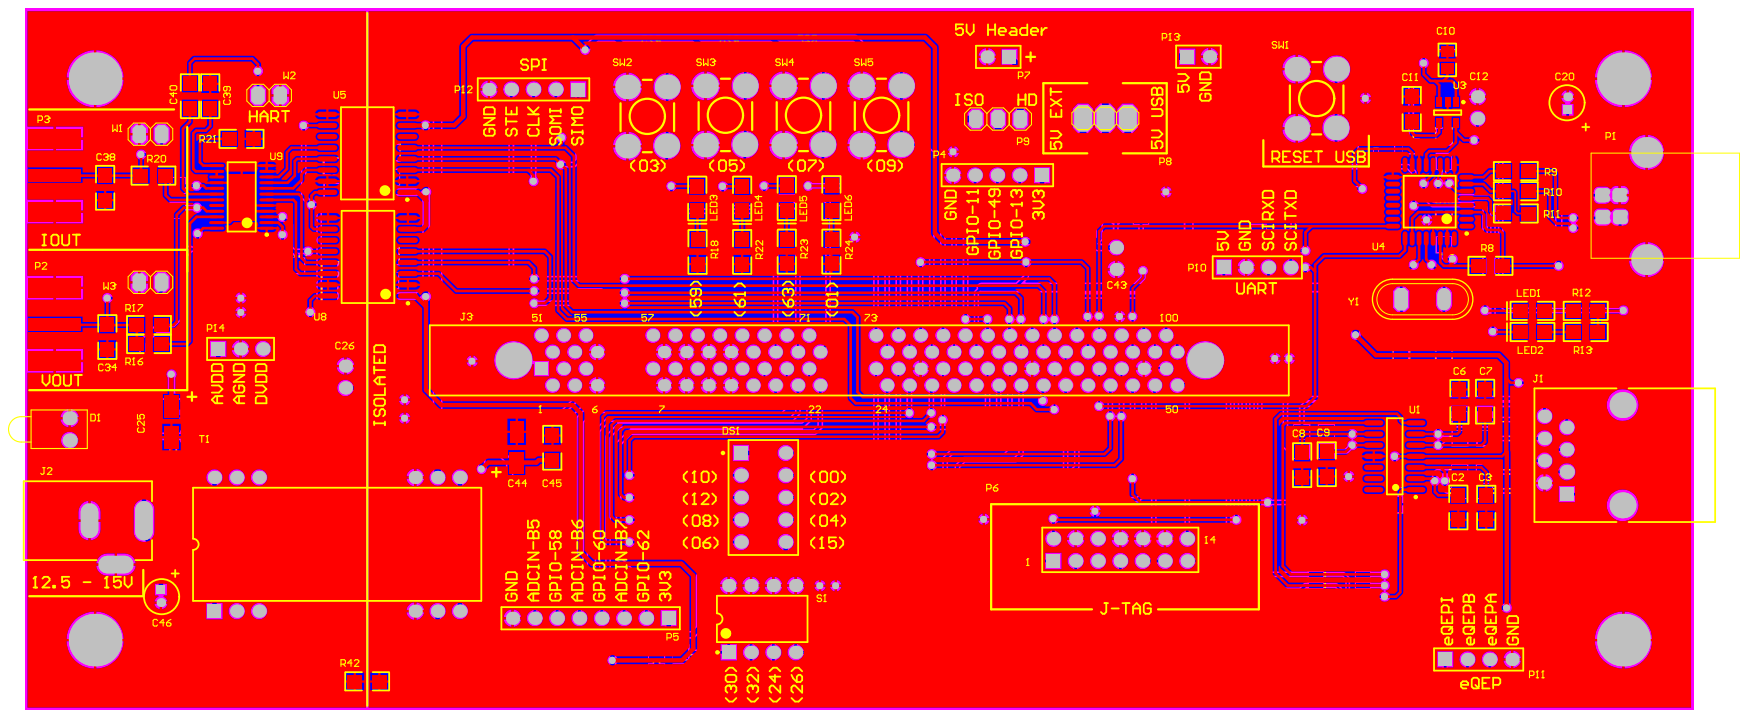
[picture p207: page 7]
