tomas-tavella/Proyecto-Final/Reference Designs/Proyecto Irusta-Caravelli/Altium/Esquematicos/sensor de corriente.pdf

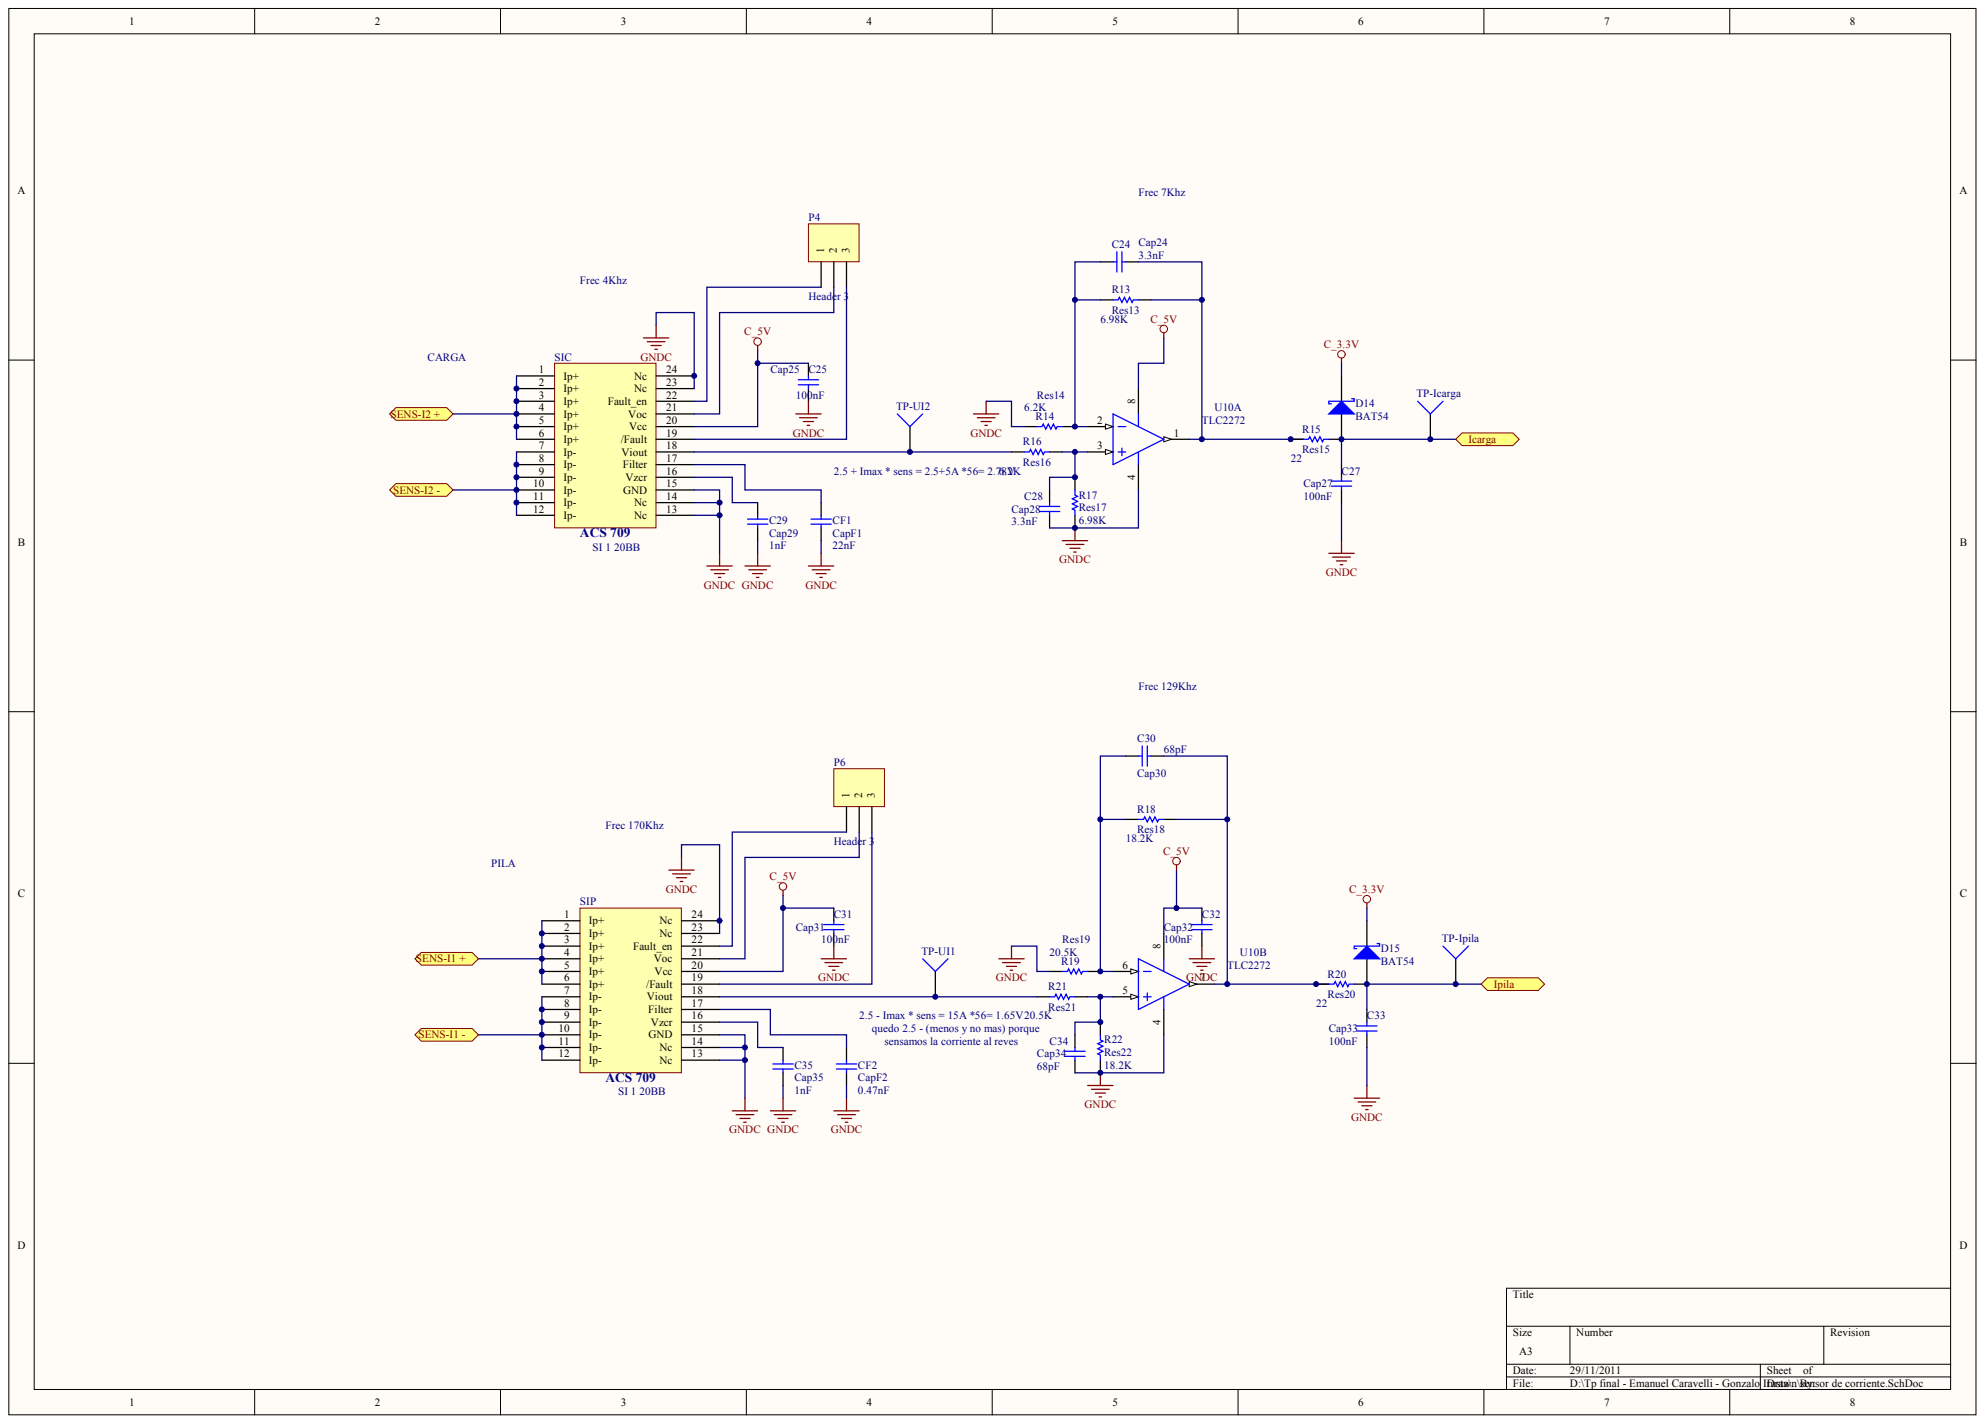
[picture p208: page 1]

2.5 - Imax * sens = 15A *56= 1.65V
quedo 2.5 - (menos y no mas) porque
sensamos la corriente al reves
