tomas-tavella/Proyecto-Final/Reference Designs/Proyecto Irusta-Caravelli/Altium/Esquematicos/sensor de tension.pdf

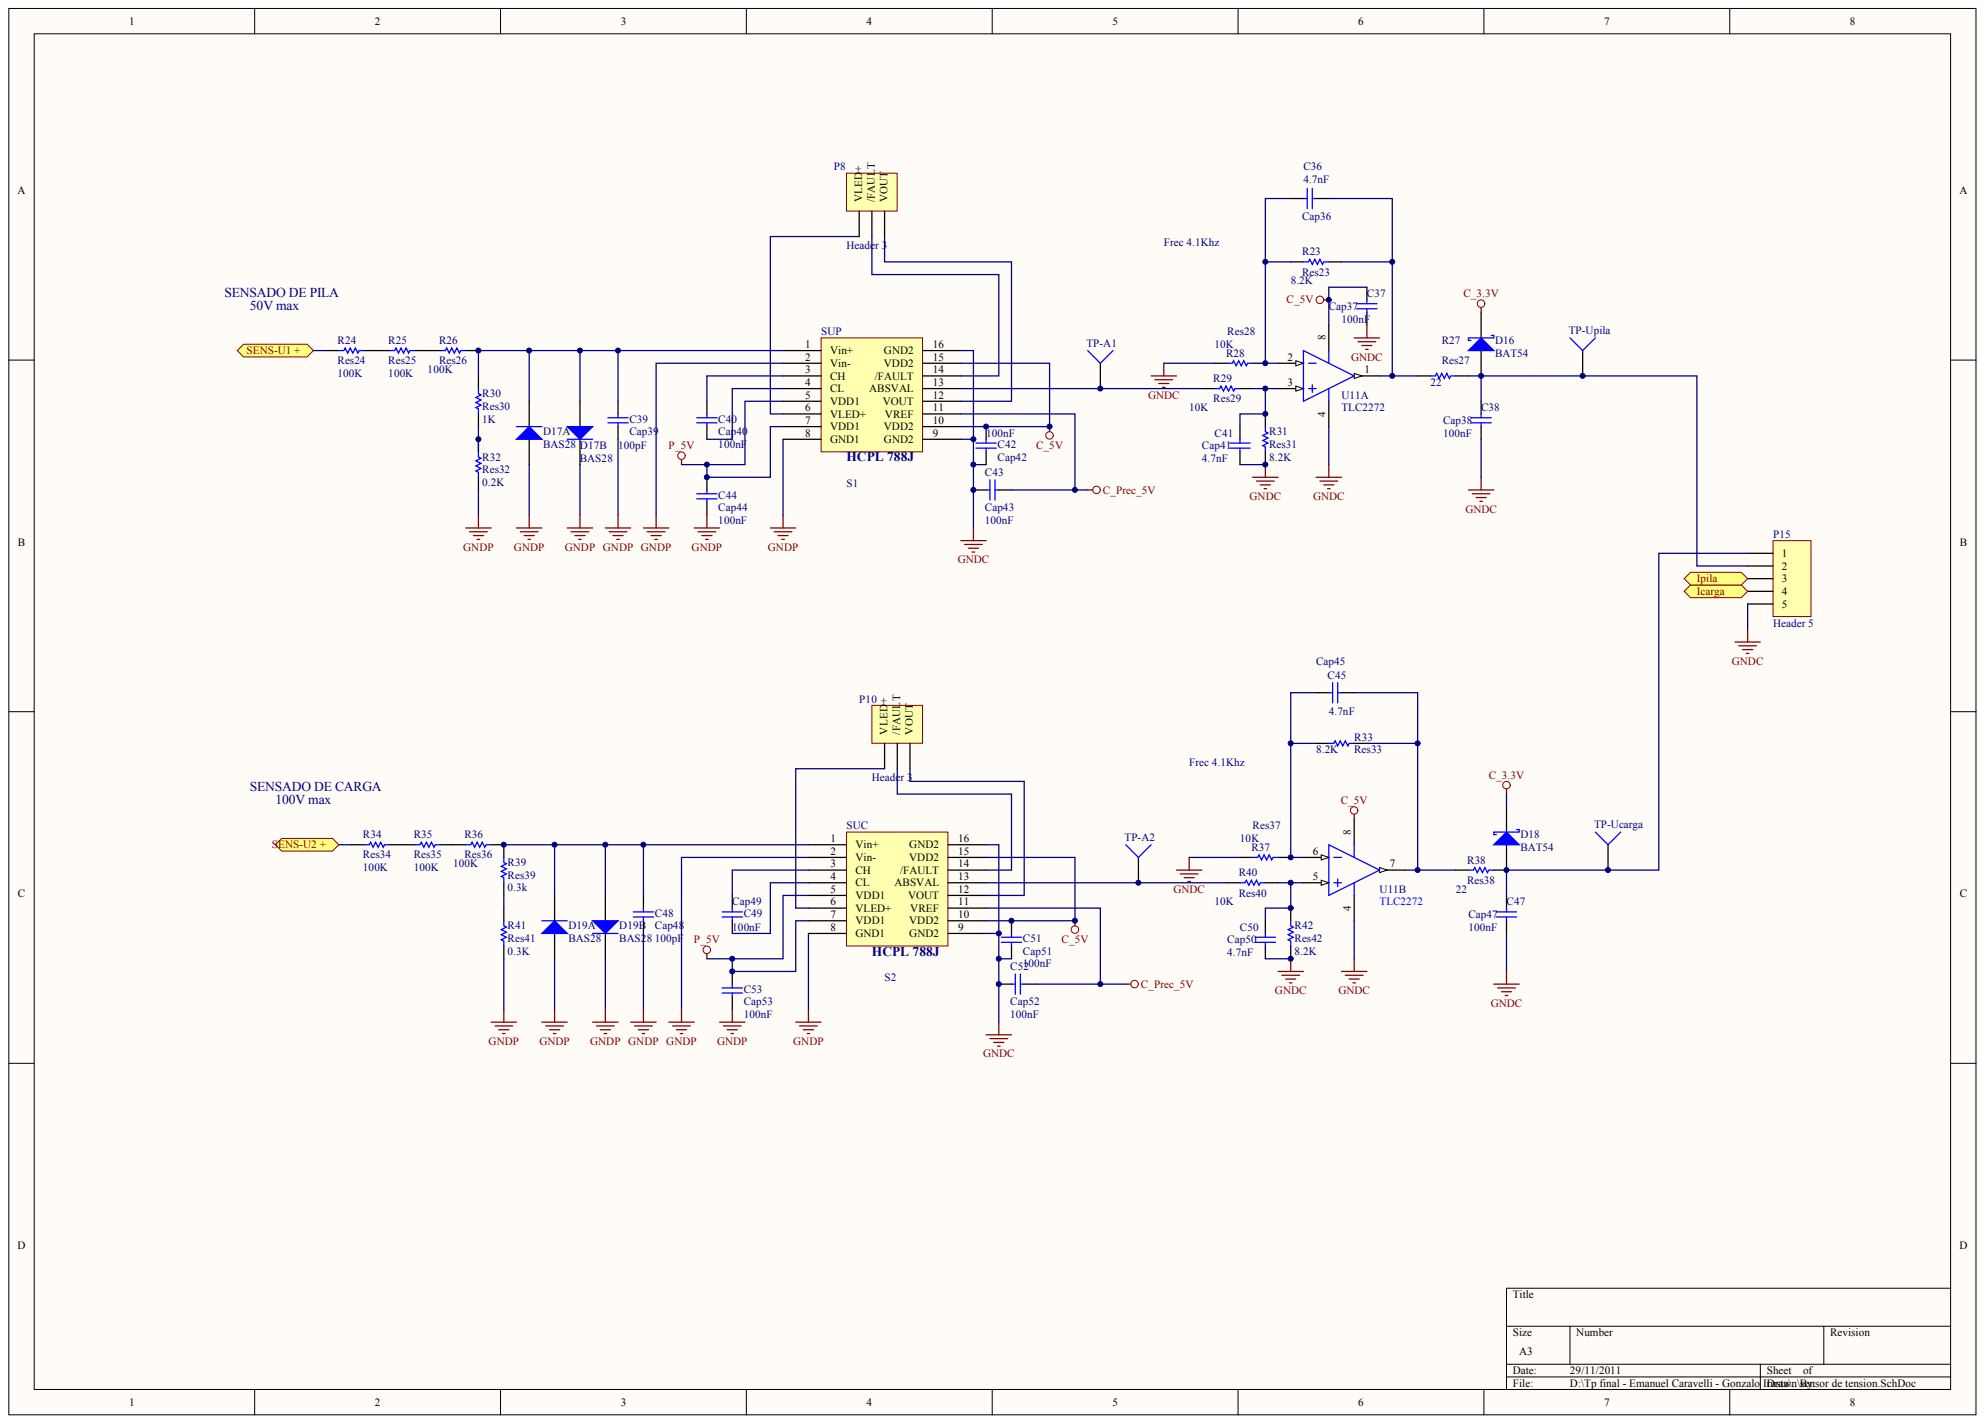
[picture p209: page 1]

Vin+ 1 Vin- 2

Header 3 SENSADO DE CARGA
100V max

CH 3
CL 4
VDD1 5

C49 | | VLED+ 6
