tomas-tavella/Proyecto-Final/Informe/Imagenes/Con Carga - Caso 3.pdf

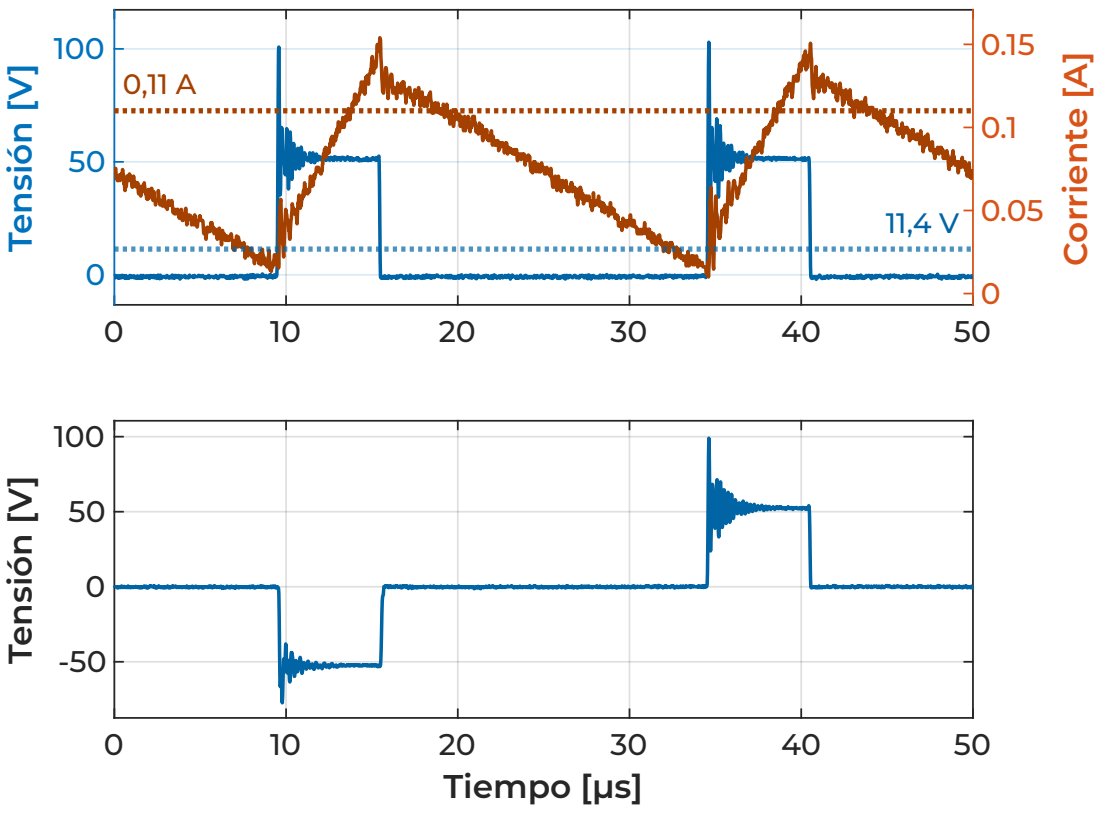
[picture p210: page 1]
sió; orrie; nte [A]; Tiempo [μs]
