tomas-tavella/Proyecto-Final/Informe/Imagenes/Con Carga - Caso 1.pdf

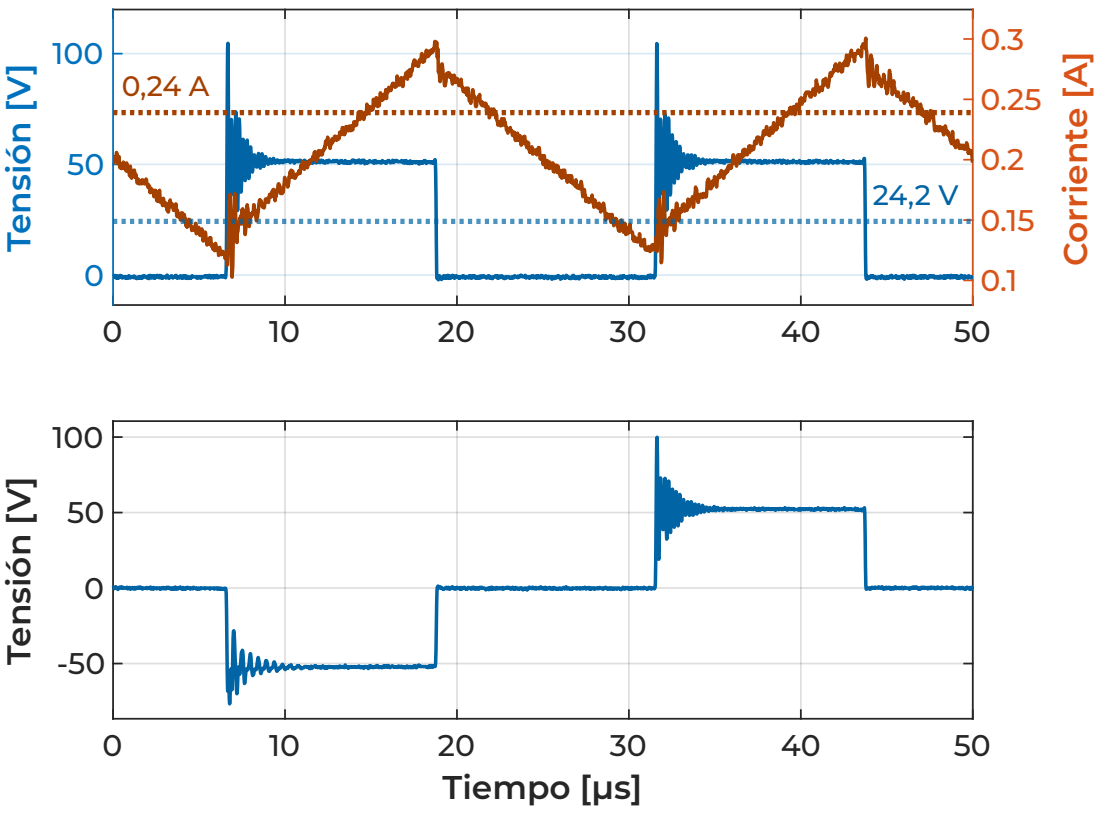
[picture p211: page 1]
sió; orrie; nte [A]; Tiempo [μs]
