tomas-tavella/Proyecto-Final/Informe/Imagenes/Con Carga - Caso 10.pdf

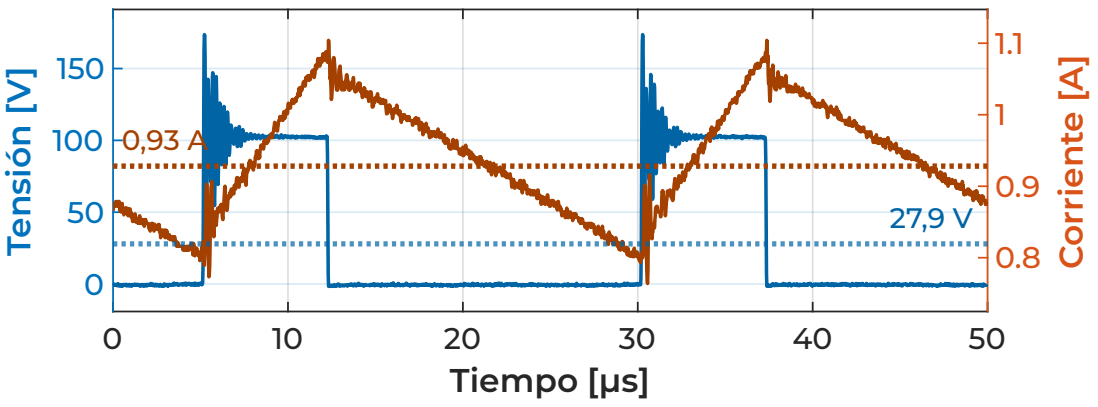
[picture p212: page 1]
Tiempo [μs]; sió; orrie; nte [A]
