tomas-tavella/Proyecto-Final/Informe/Imagenes/Con Carga - Caso 2.pdf

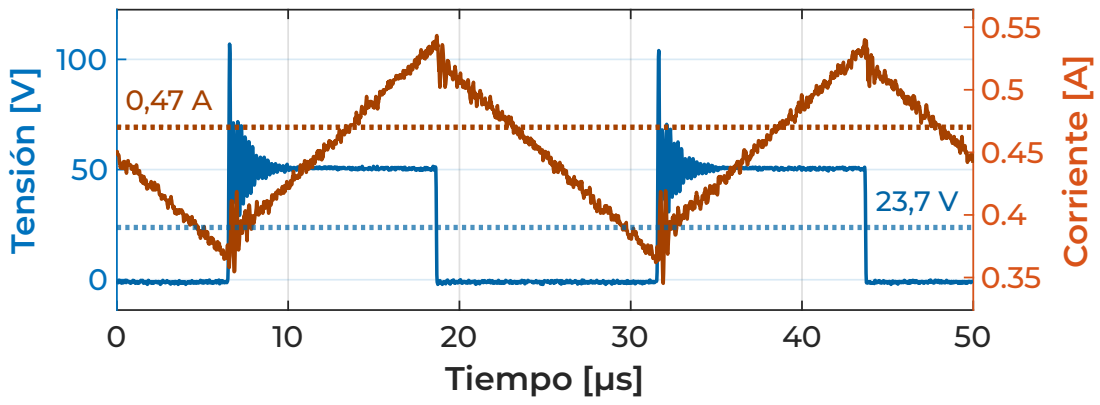
[picture p213: page 1]
Tiempo [μs]; sió; orrie; nte [A]
