tomas-tavella/Proyecto-Final/Informe/Imagenes/Con Carga - Caso 5.pdf

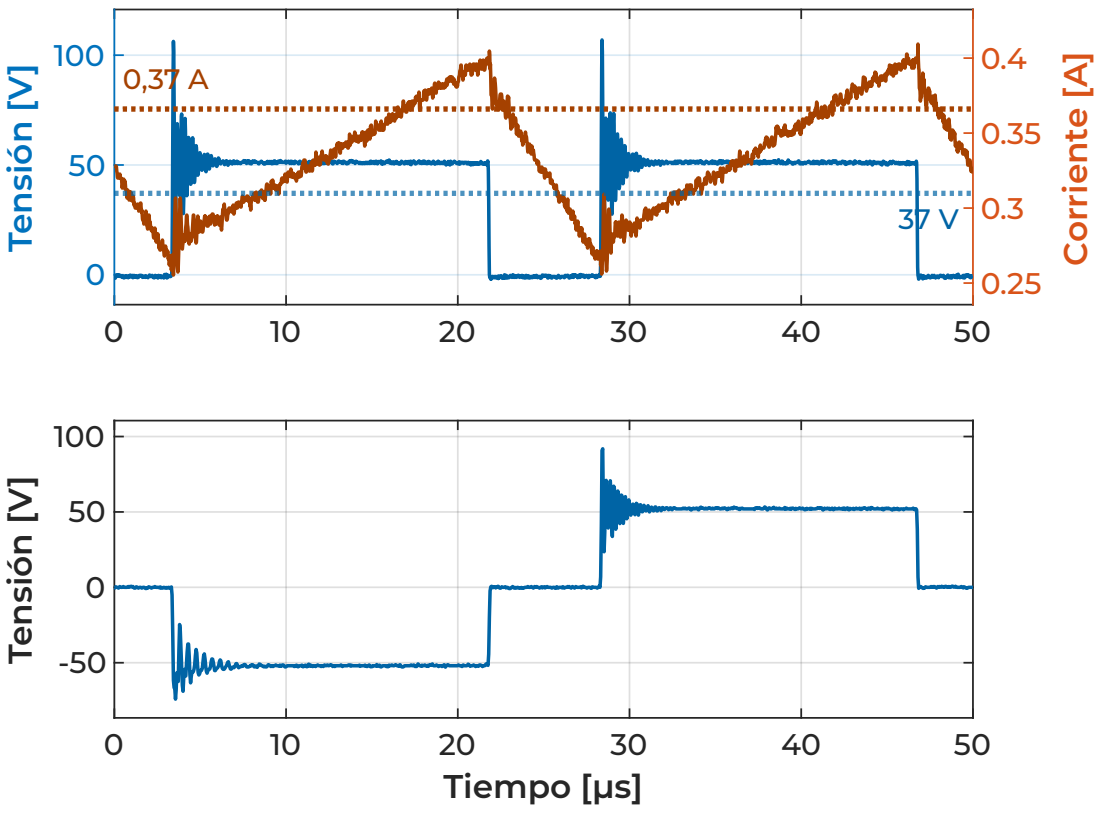
[picture p214: page 1]
sió; orrie; nte [A]; Tiempo [μs]
