tomas-tavella/Proyecto-Final/Informe/Imagenes/Con Carga - Caso 7.pdf

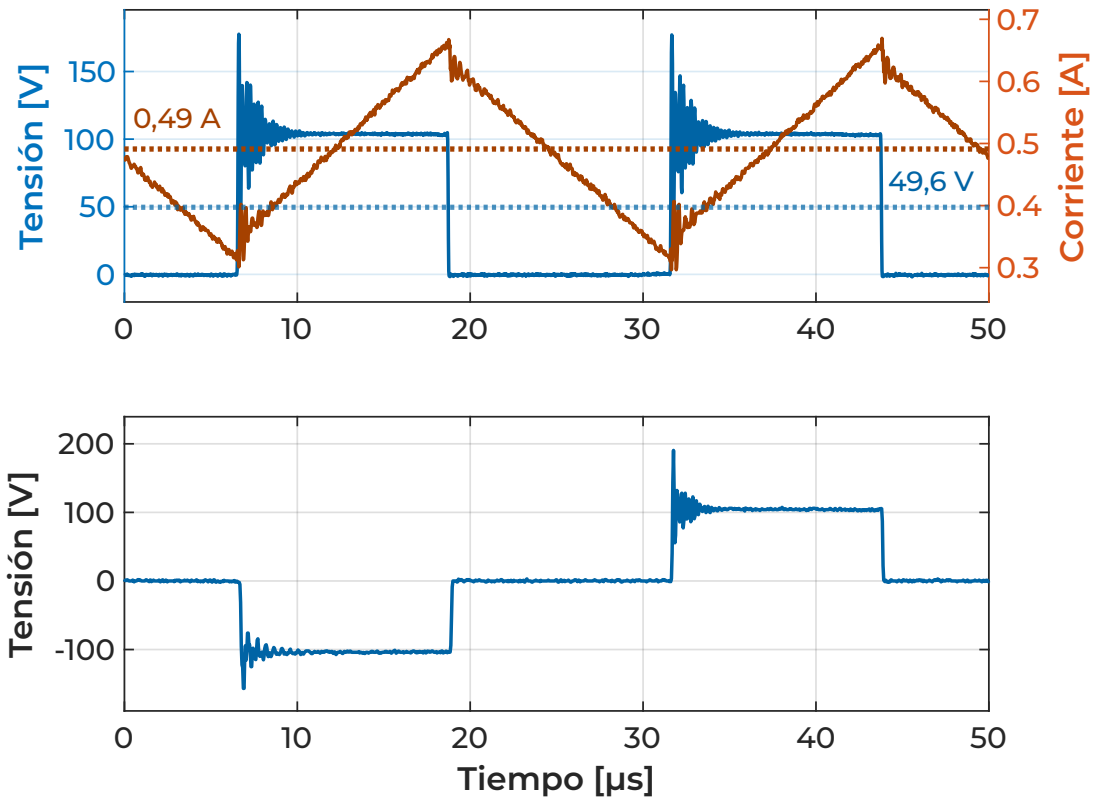
[picture p215: page 1]
sió; orrie; nte [A]; Tiempo [μs]
