tomas-tavella/Proyecto-Final/Informe/Imagenes/Con Carga - Caso 9.pdf

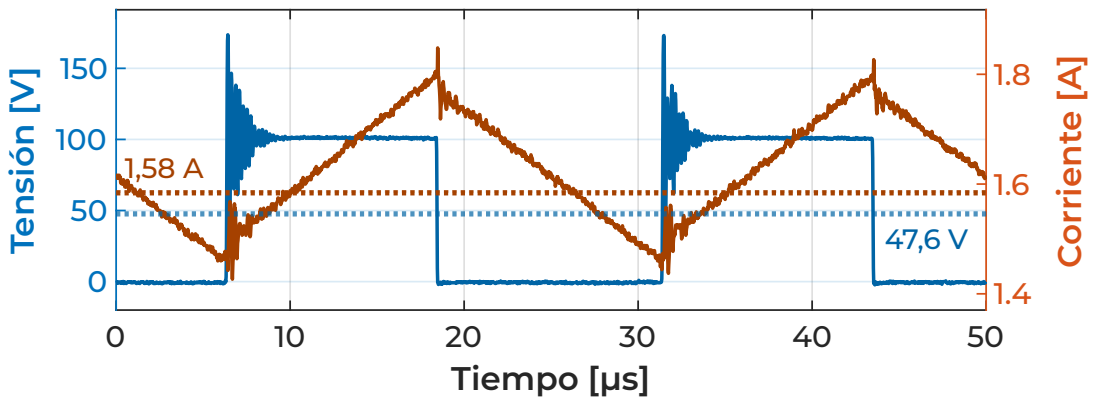
[picture p216: page 1]
Tiempo [μs]; sió; orrie; nte [A]
