tomas-tavella/Proyecto-Final/Informe/Imagenes/Sin Carga - Fase 0.pdf

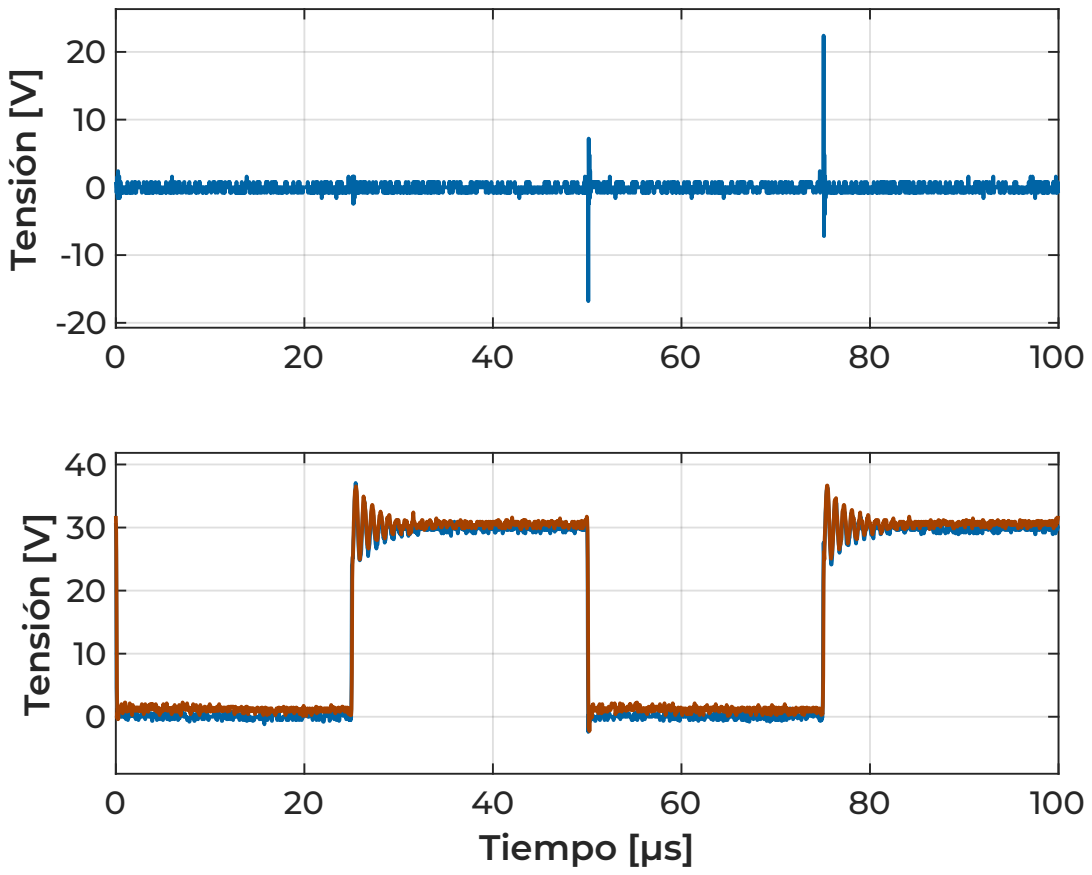
[picture p217: page 1]
sió; Tiempo [μs]
