tomas-tavella/Proyecto-Final/Informe/Imagenes/Sin Carga - Fase 120.pdf

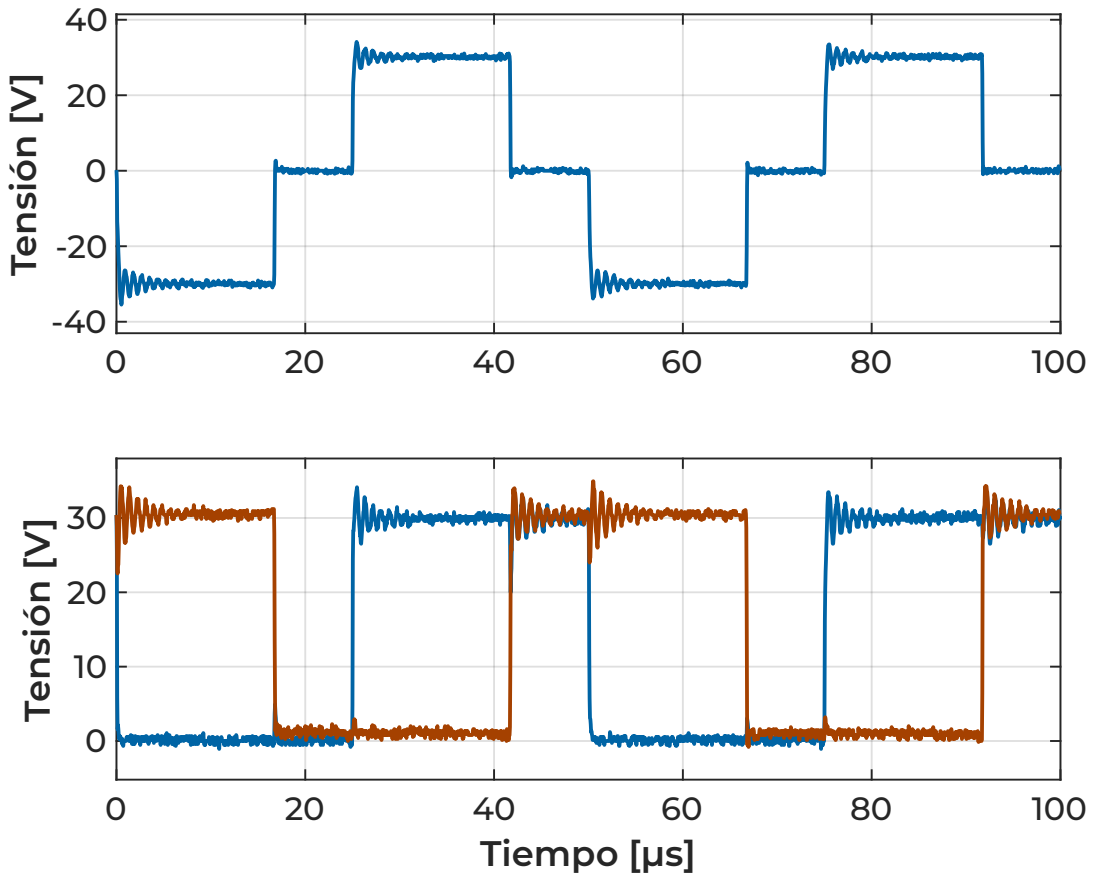
[picture p218: page 1]
sió; Tiempo [μs]
