tomas-tavella/Proyecto-Final/Informe/Imagenes/Sin Carga - Fase 180.pdf

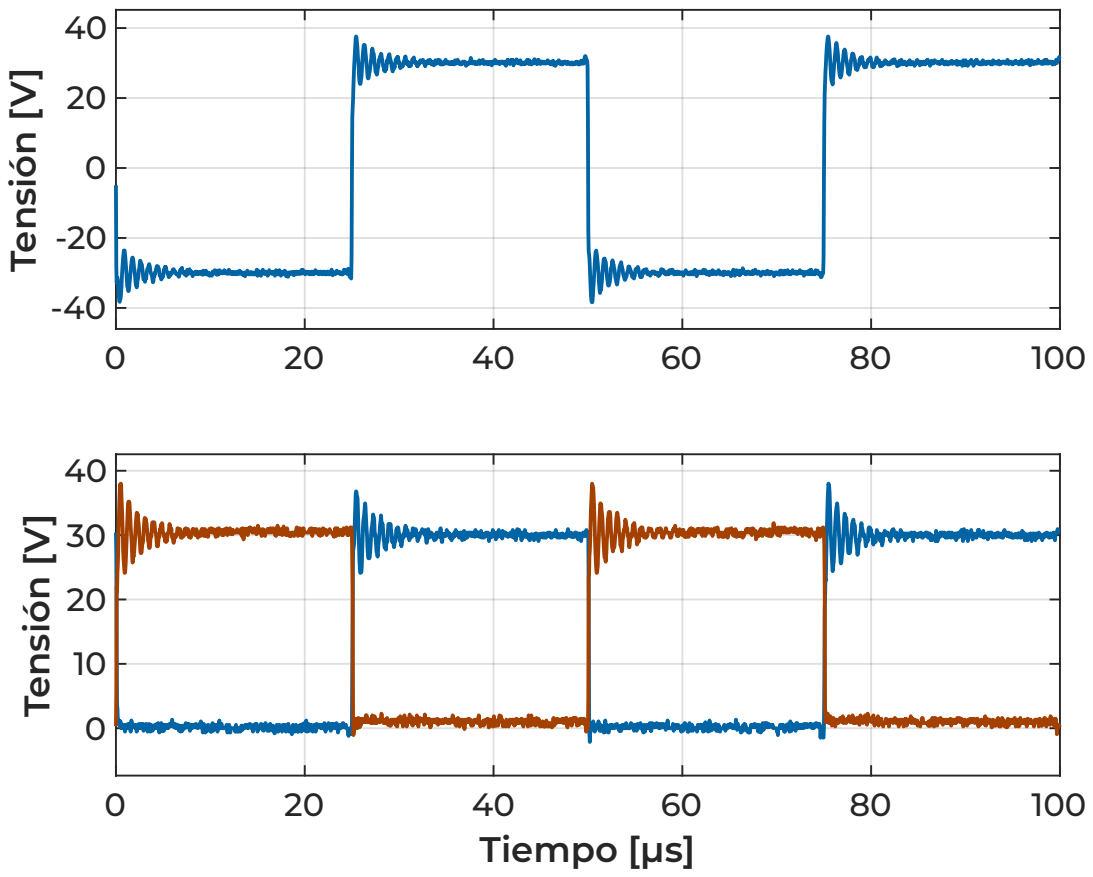
[picture p219: page 1]
sió; Tiempo [μs]
