tomas-tavella/Proyecto-Final/Informe/Imagenes/Sin Carga - Fase 30.pdf

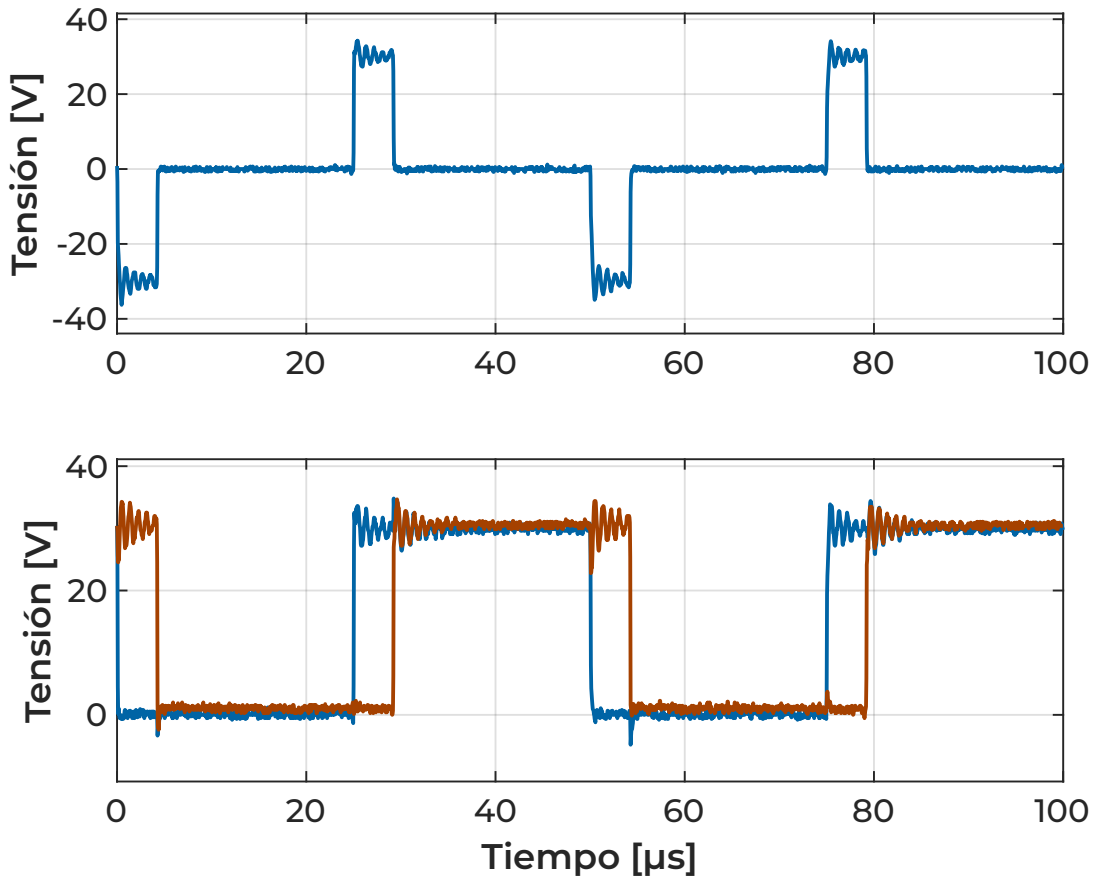
[picture p220: page 1]
sió; Tiempo [μs]
