tomas-tavella/Proyecto-Final/Informe/Imagenes/Sin Carga - Fase 60.pdf

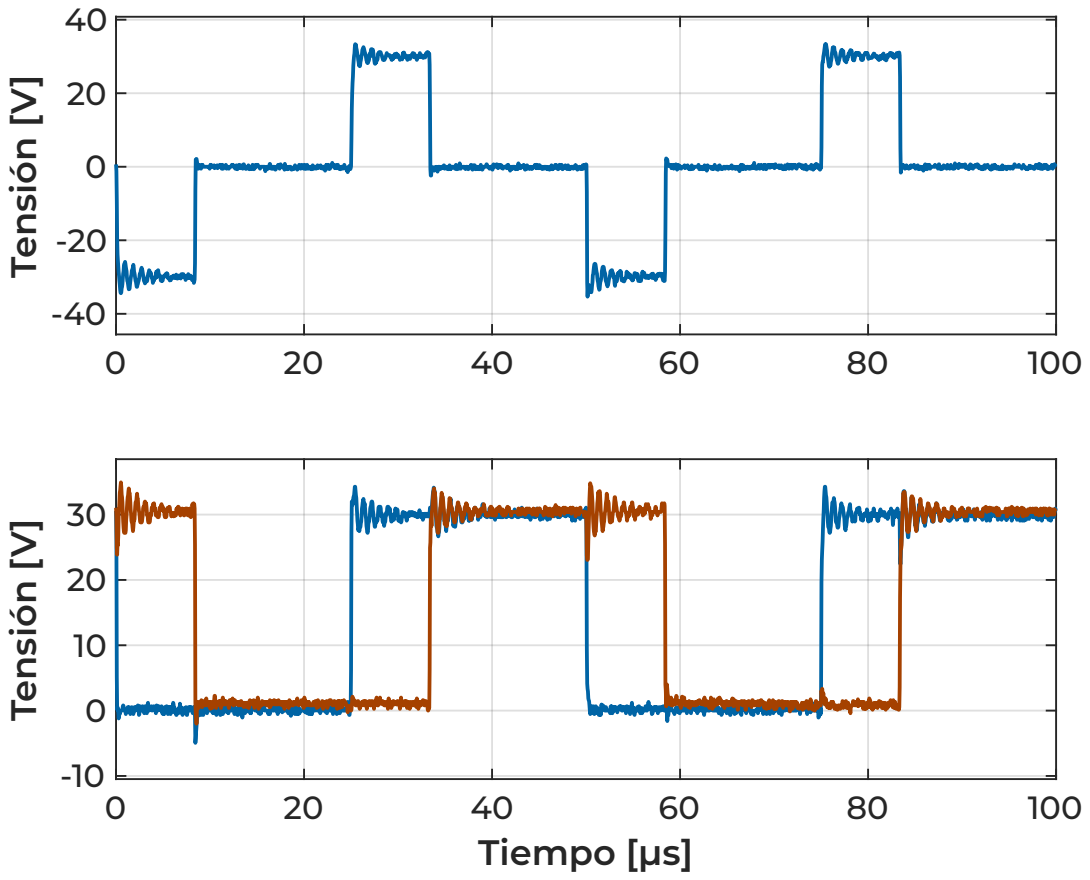
[picture p221: page 1]
sió; Tiempo [μs]
