tomas-tavella/Proyecto-Final/Informe/Imagenes/Sin Carga - Fase 90.pdf

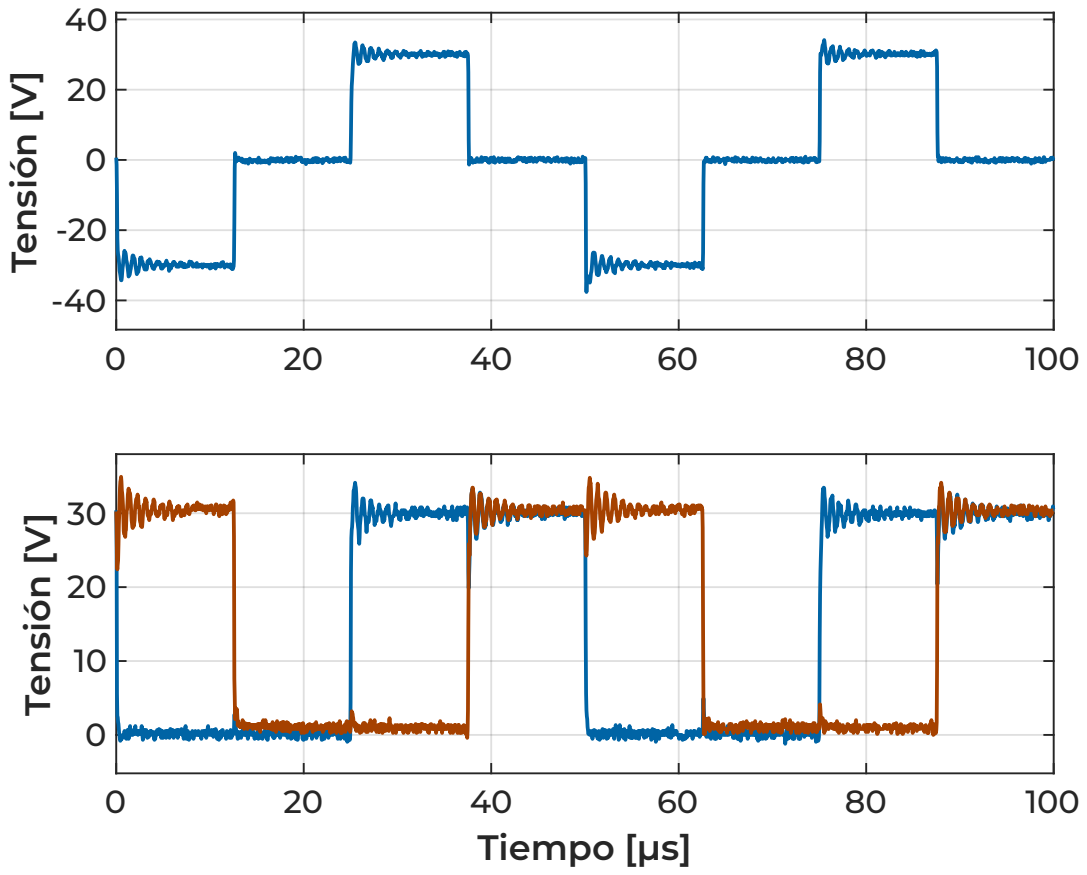
[picture p222: page 1]
sió; Tiempo [μs]
