tomas-tavella/Proyecto-Final/Informe/Imagenes/Placa Adaptadora.pdf

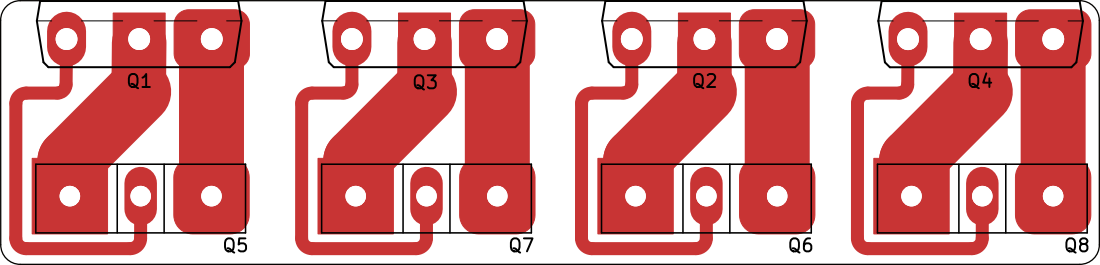
[picture p223: page 1]
