tomas-tavella/Proyecto-Final/Informe PPS/Imagenes/Fondo Portada.pdf

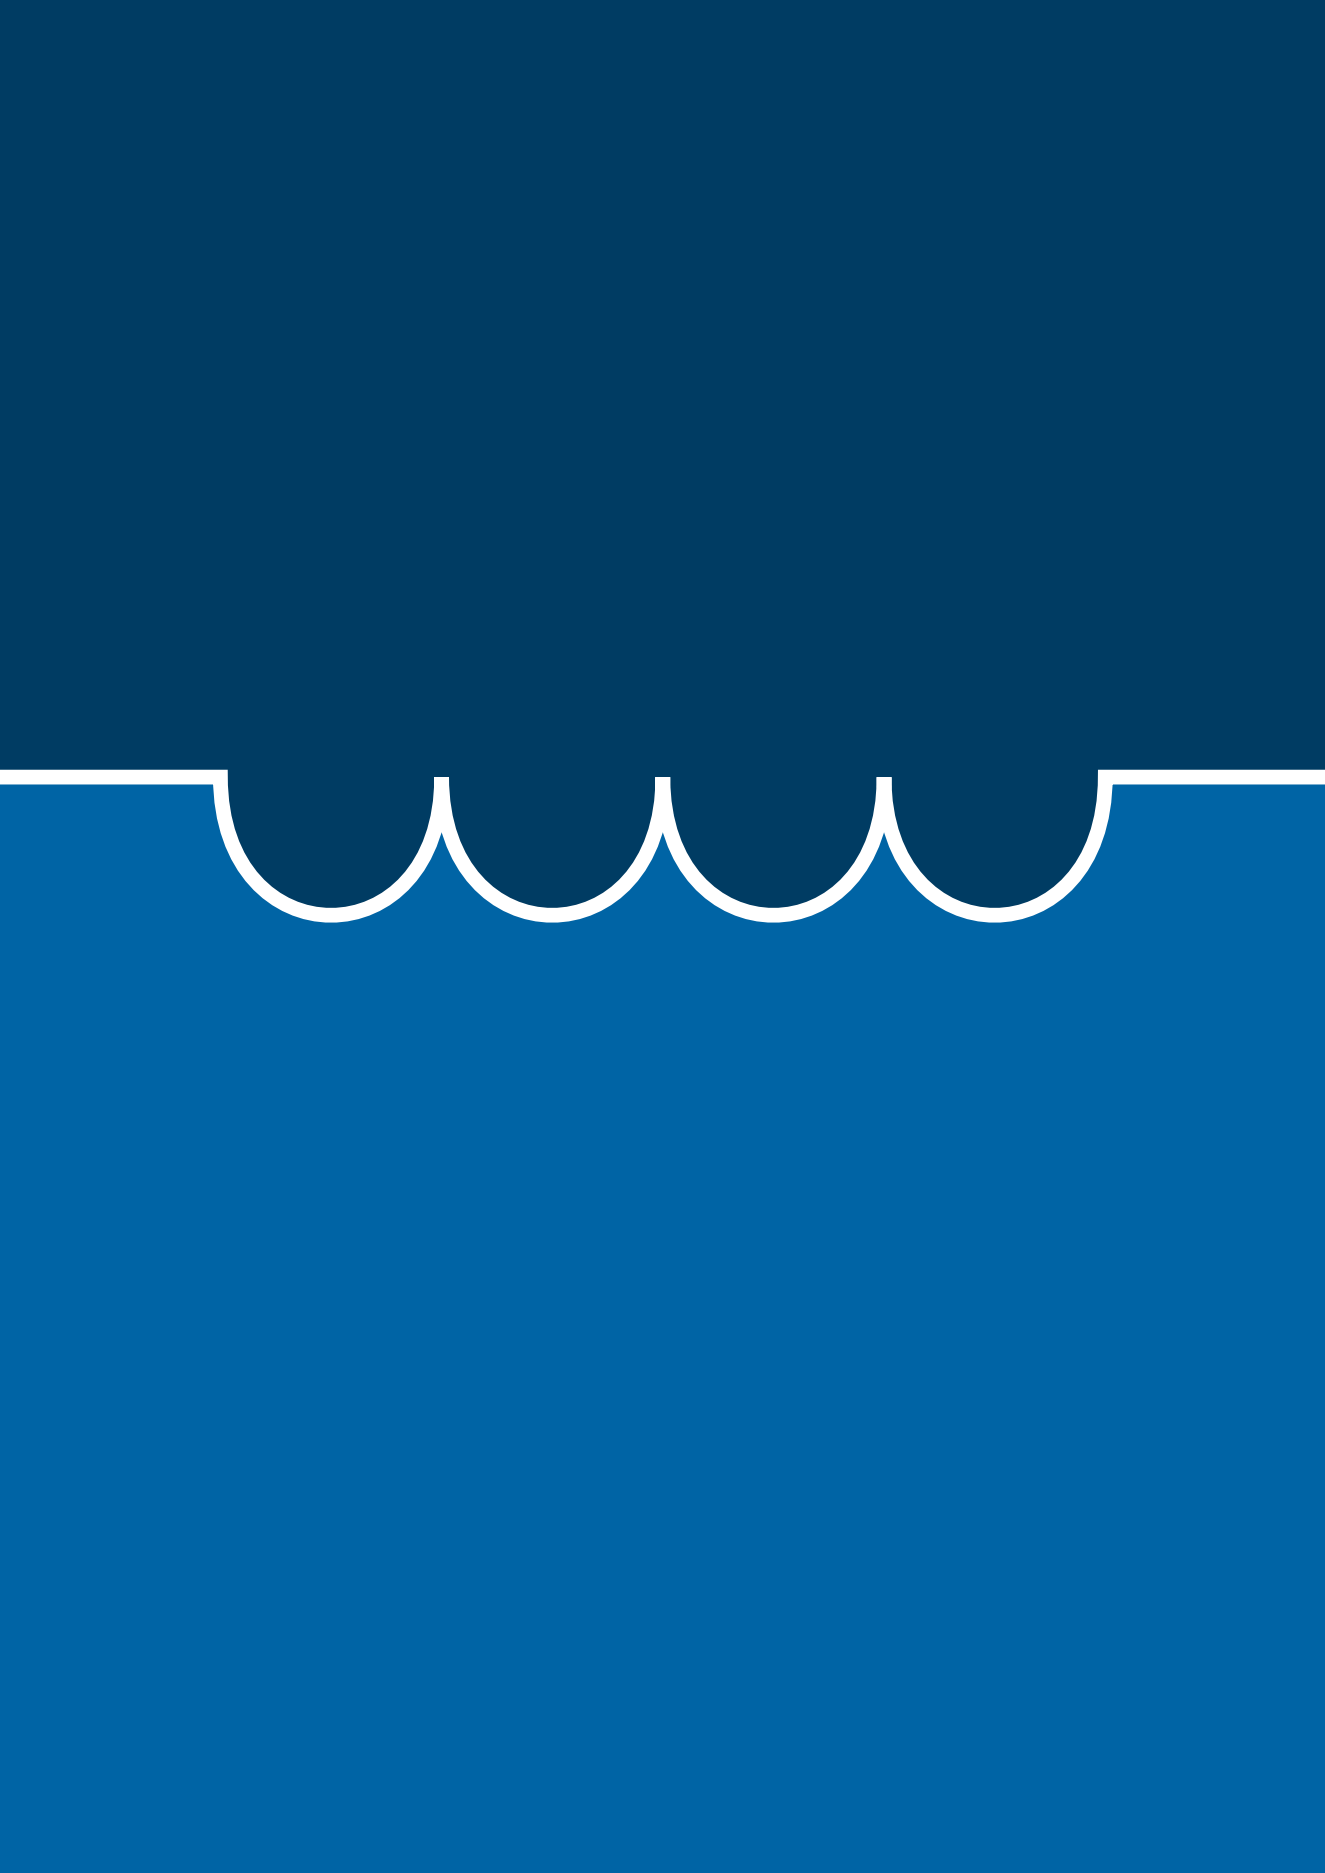
[picture p224: page 1]
