tomas-tavella/Proyecto-Final/Informe/Imagenes/Desarrollo Full-Bridge.pdf

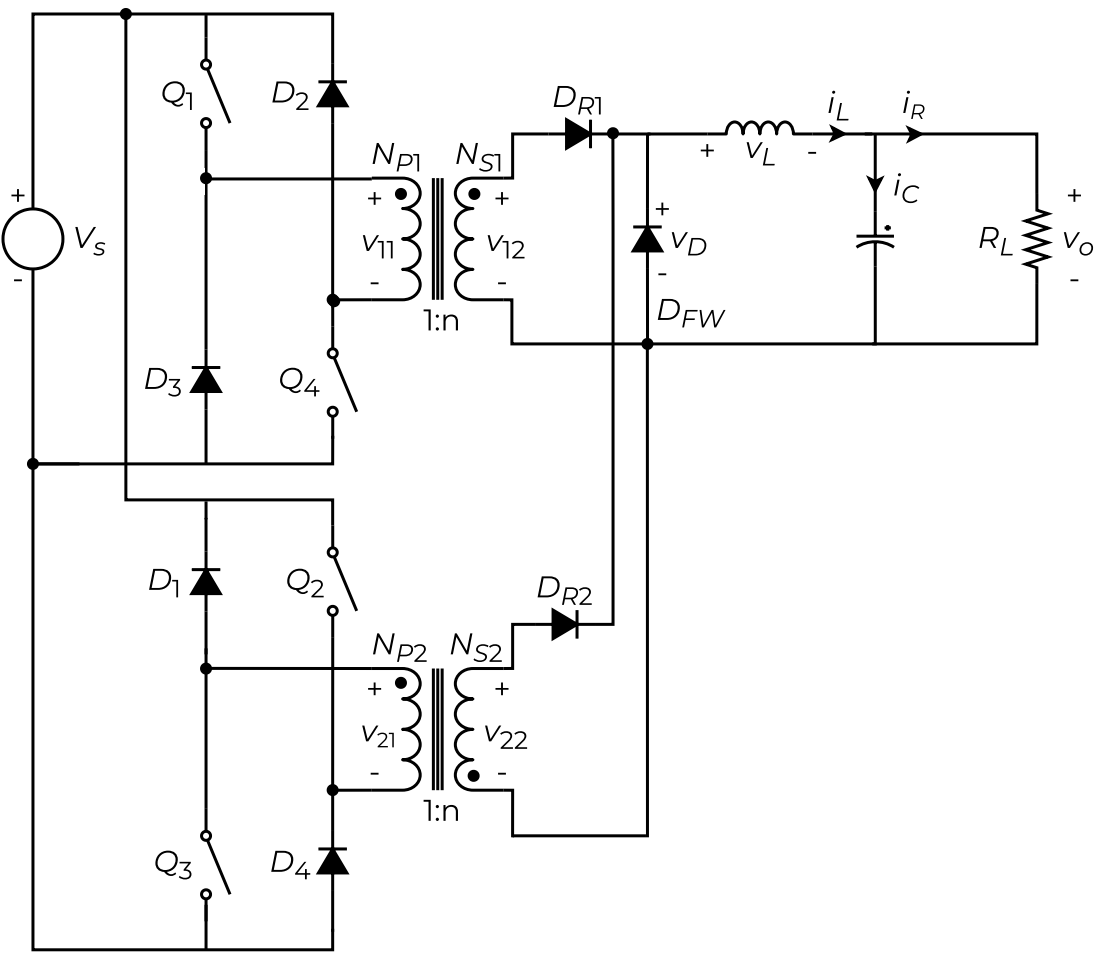
[picture p225: page 1]
