tomas-tavella/Proyecto-Final/Informe/Imagenes/Full Bridge Onda Completa.pdf

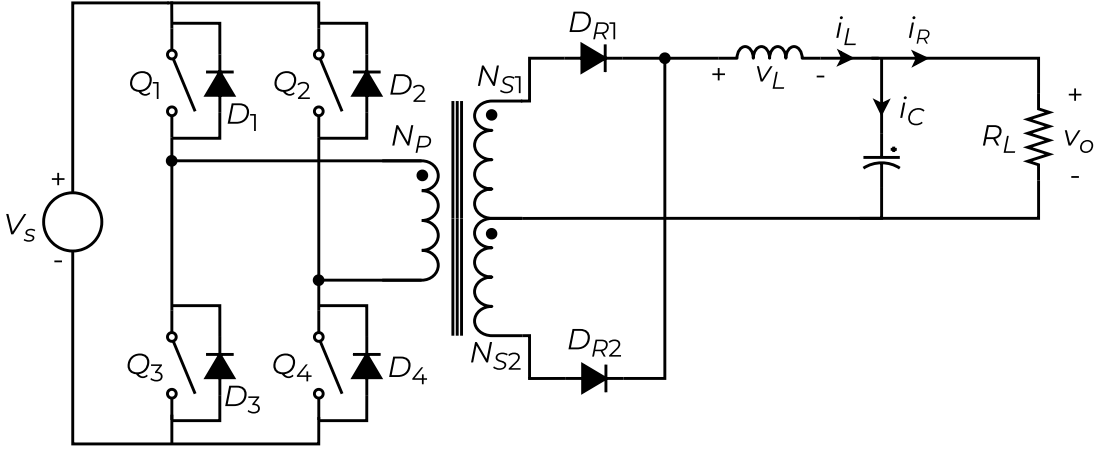
[picture p226: page 1]
