tomas-tavella/Proyecto-Final/Informe/Imagenes/Logo I2C.pdf

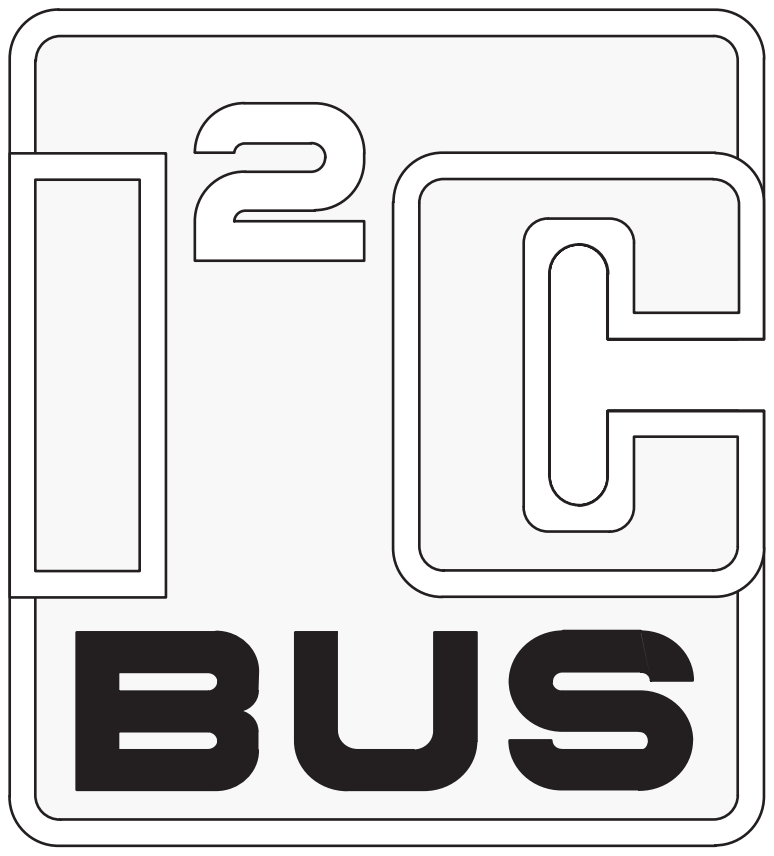
[picture p227: page 1]
