tomas-tavella/Proyecto-Final/Informe/Imagenes/Sistema Medicion.pdf

# Sistema de Medición

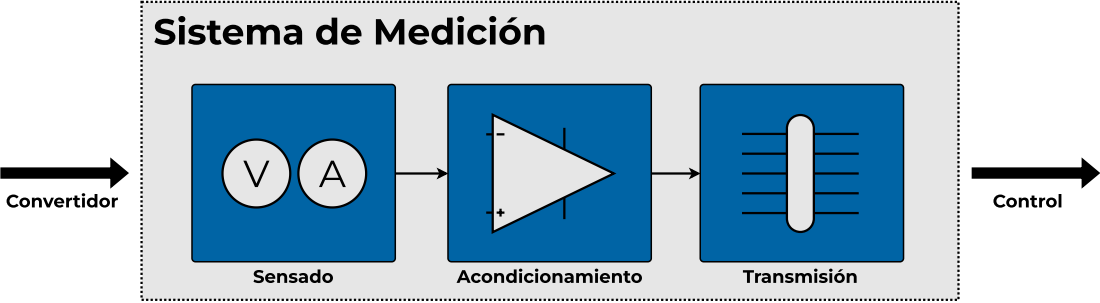
[picture p228: page 1]
Sensado; Acondicionamiento; Transmisión; Convertidor; Control
