tomas-tavella/Proyecto-Final/Informe/Imagenes/Fondo Portada.pdf

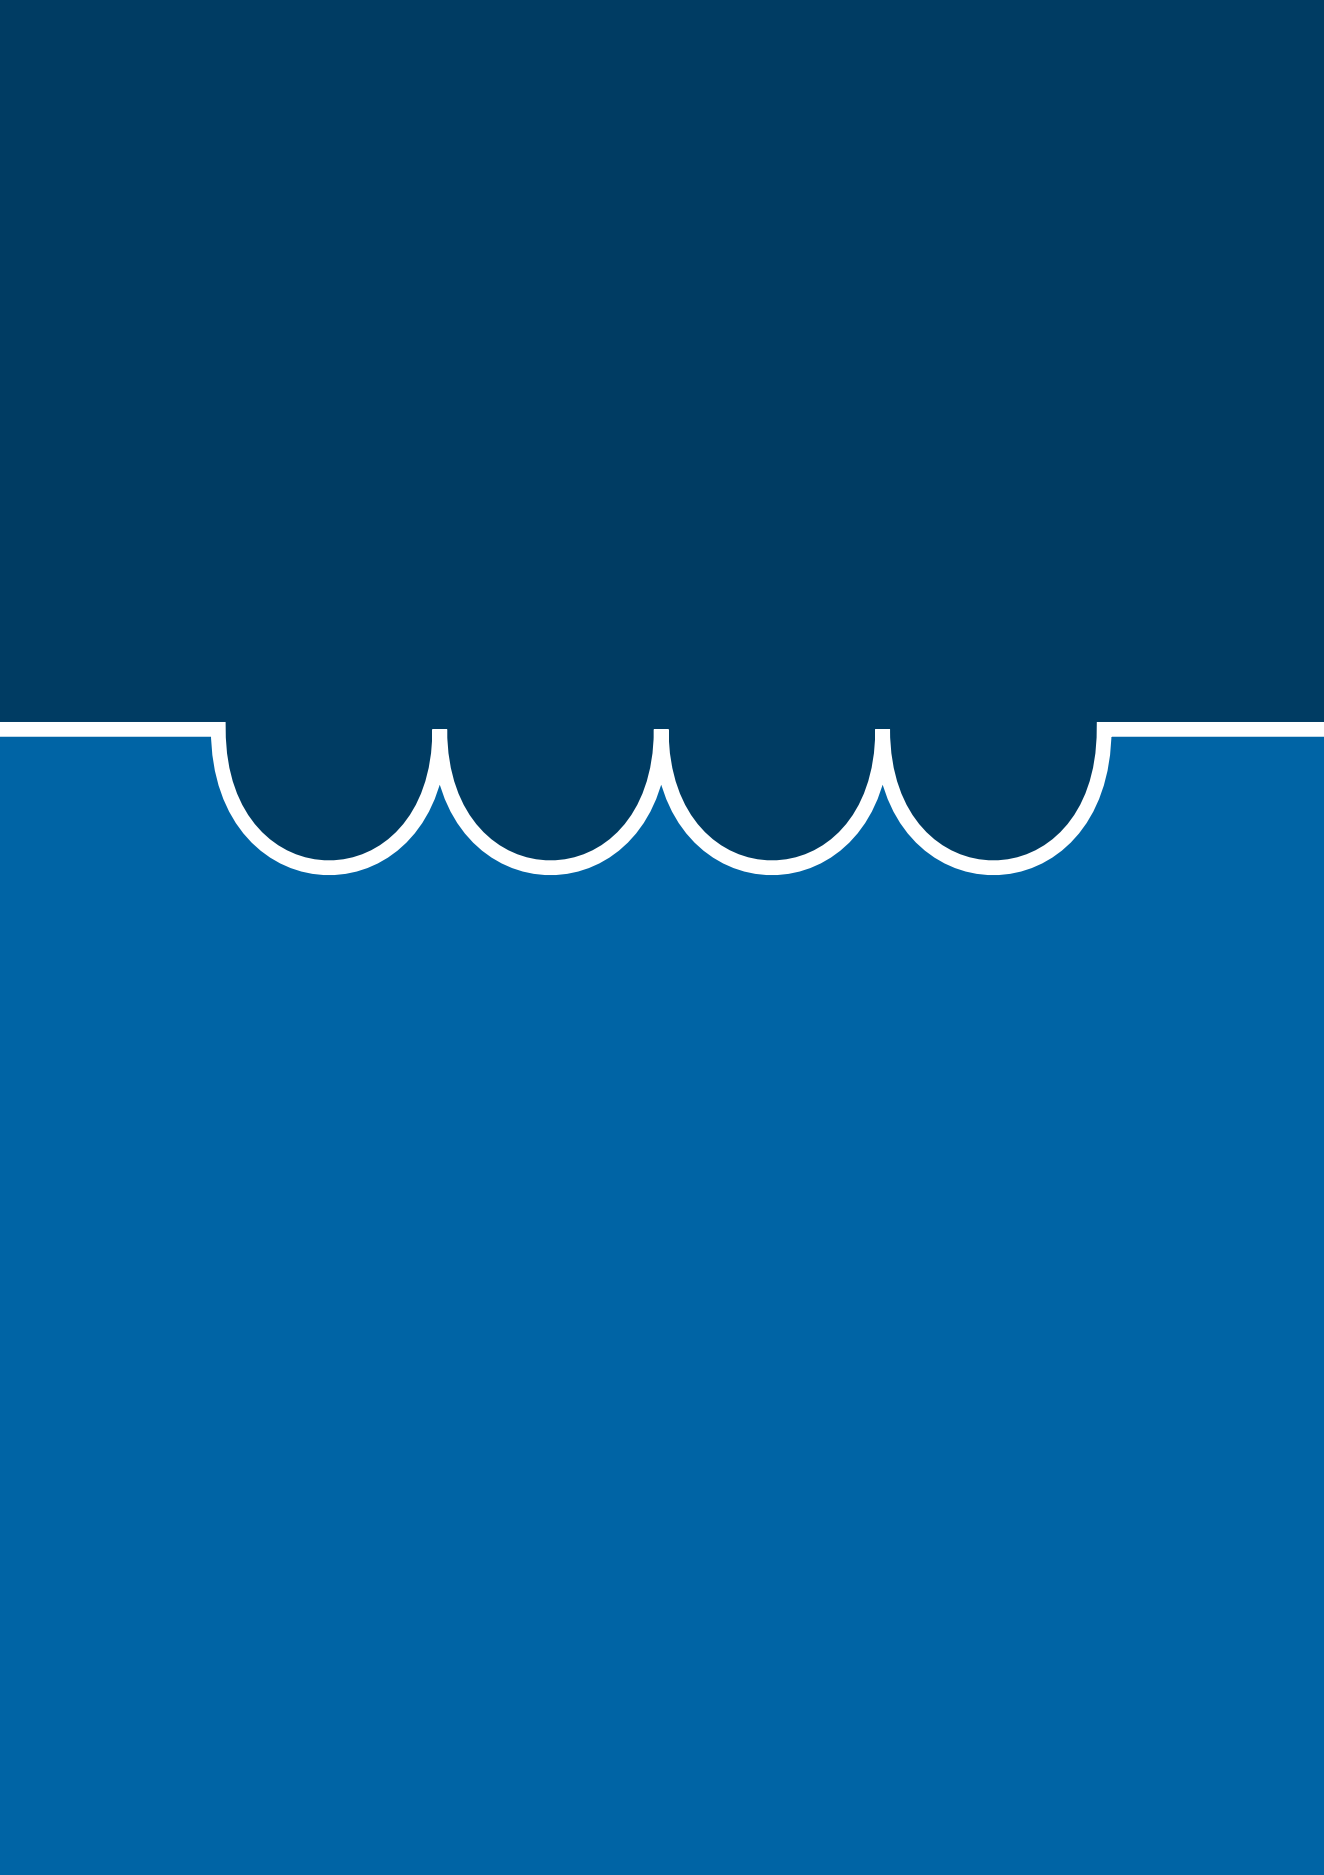
[picture p229: page 1]
