tomas-tavella/Proyecto-Final/Informe/Imagenes/Desarrollo Forward 1.pdf

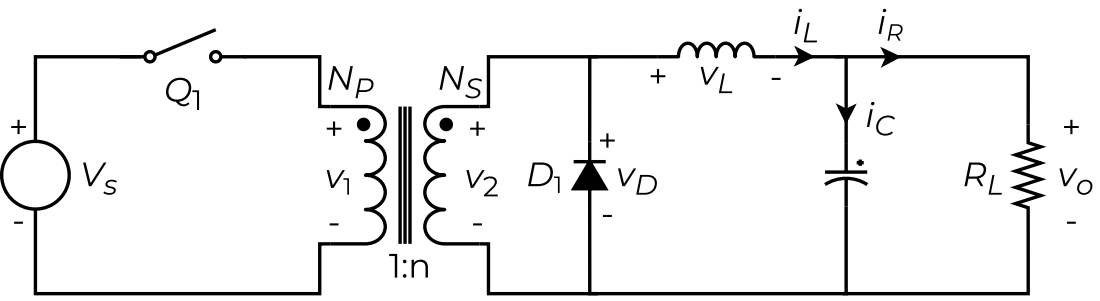
[picture p230: page 1]
