tomas-tavella/Proyecto-Final/Informe/Imagenes/Desarrollo Push-Pull 1.pdf

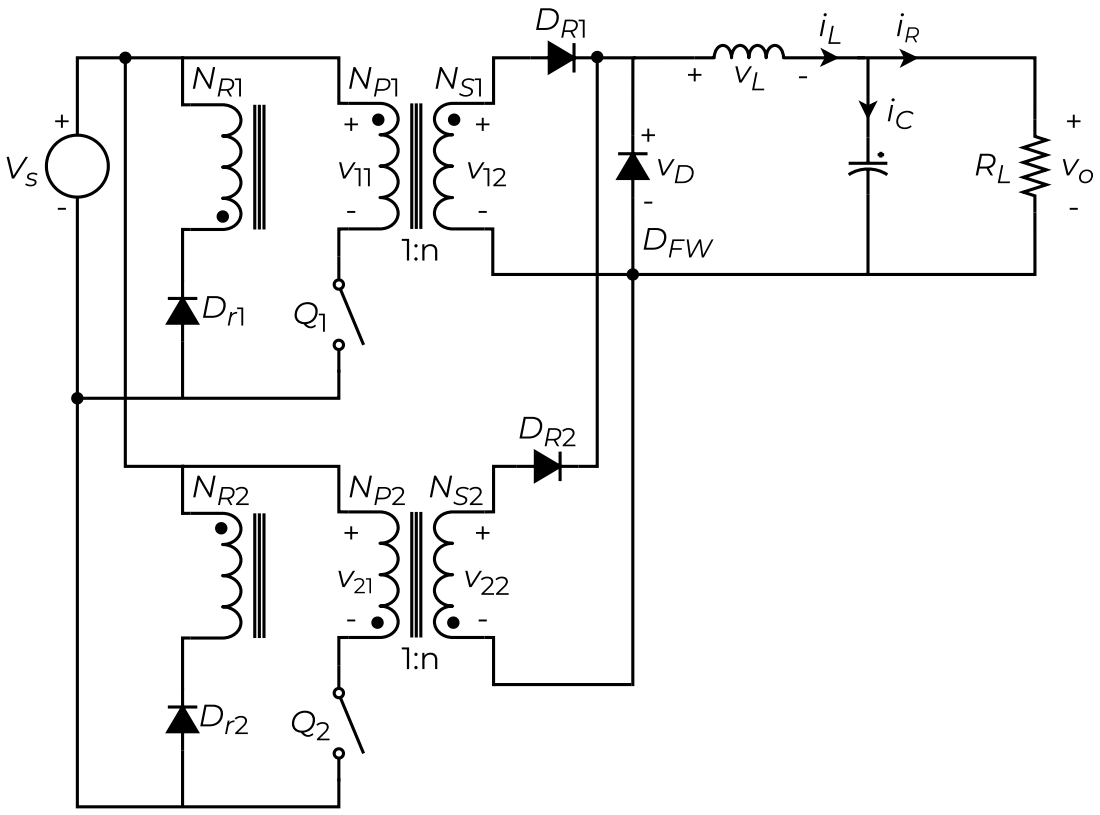
[picture p231: page 1]
DFW
