tomas-tavella/Proyecto-Final/Informe/Imagenes/Forward Double-Ended.pdf

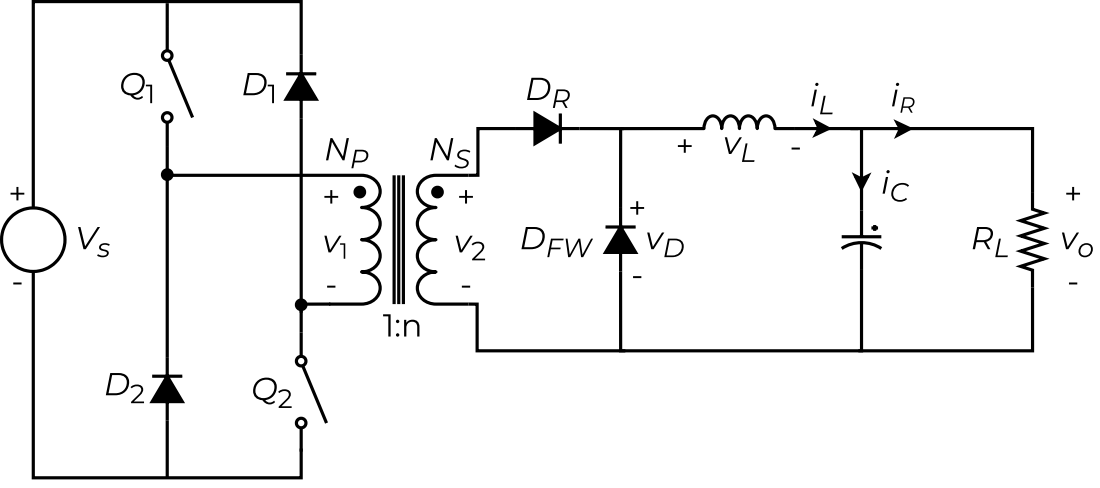
[picture p232: page 1]
