tomas-tavella/Proyecto-Final/Informe/Imagenes/Forward.pdf

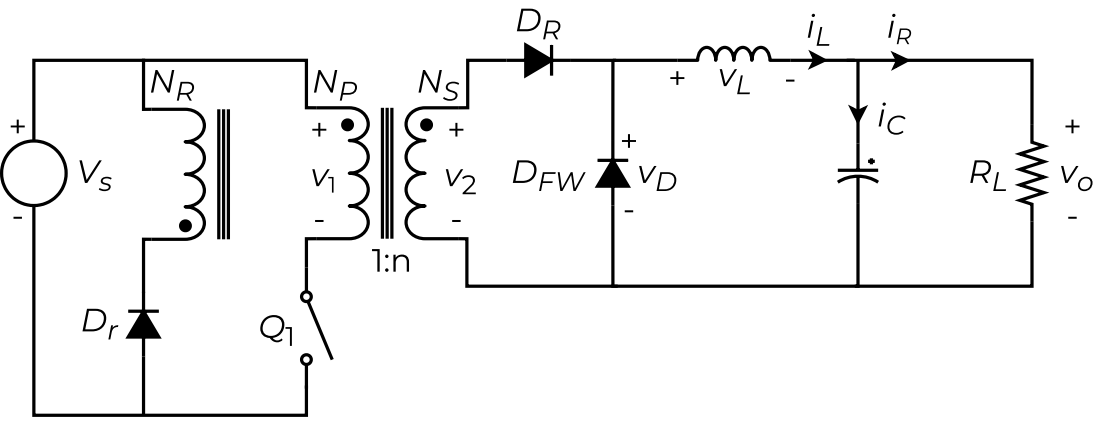
[picture p233: page 1]
