tomas-tavella/Proyecto-Final/Informe/Imagenes/Push-Pull.pdf

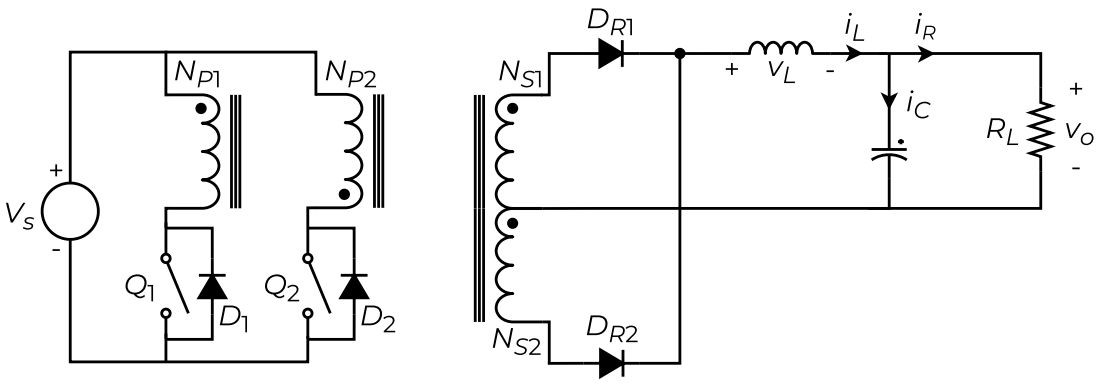
[picture p234: page 1]
