tomas-tavella/Proyecto-Final/Informe/Imagenes/Proto Reductor.pdf

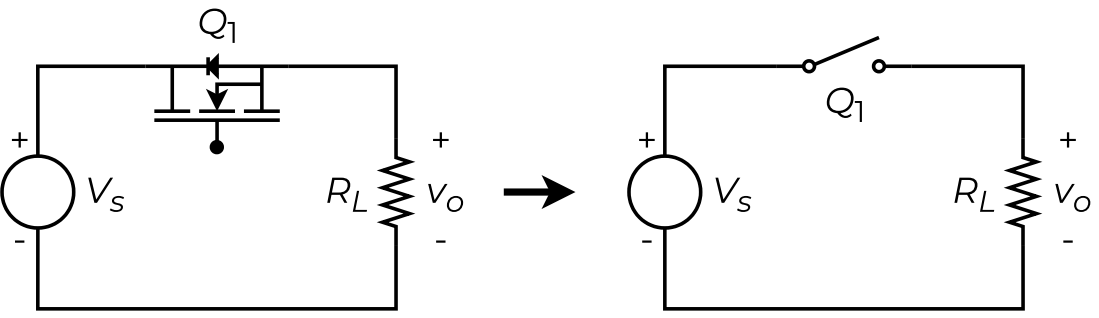
[picture p235: page 1]
