tomas-tavella/Proyecto-Final/Informe/Imagenes/Reductor Llave Abierta.pdf

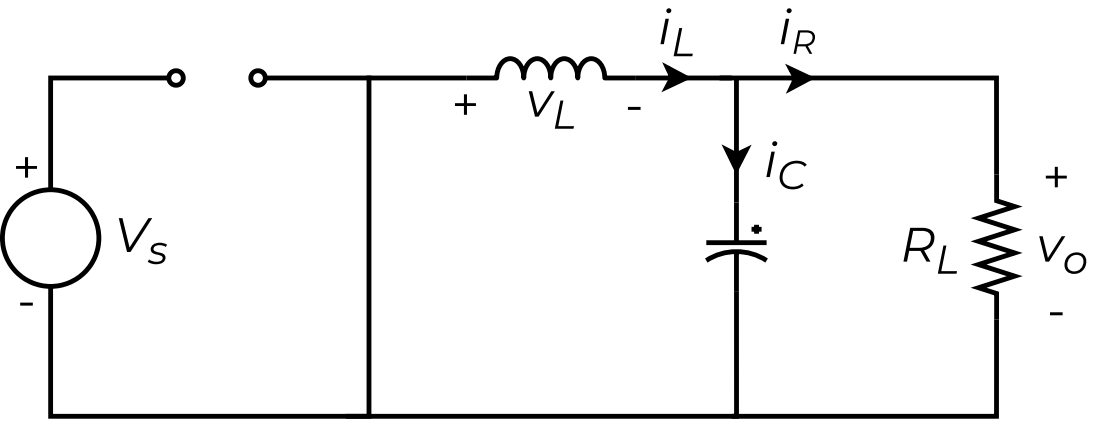
[picture p236: page 1]
