tomas-tavella/Proyecto-Final/Informe/Imagenes/Reductor Llave Cerrada.pdf

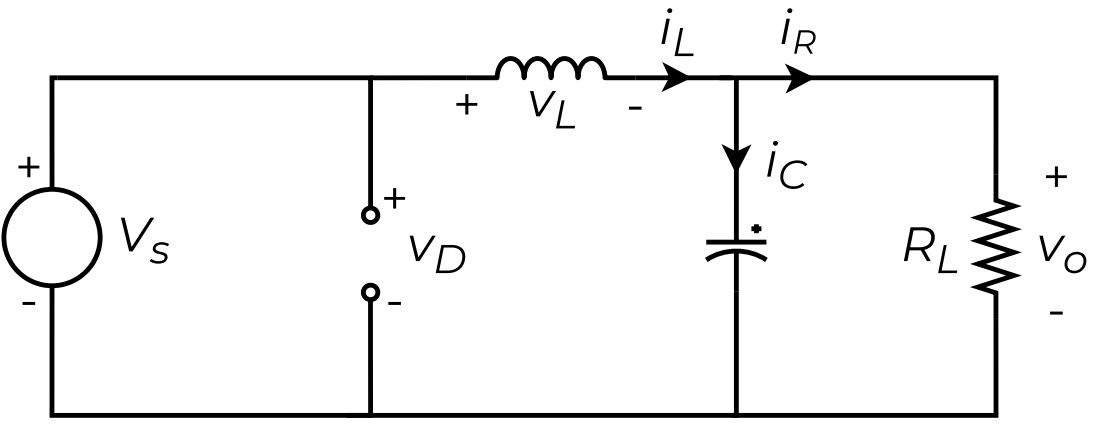
[picture p237: page 1]
