tomas-tavella/Proyecto-Final/Informe/Imagenes/Reductor.pdf

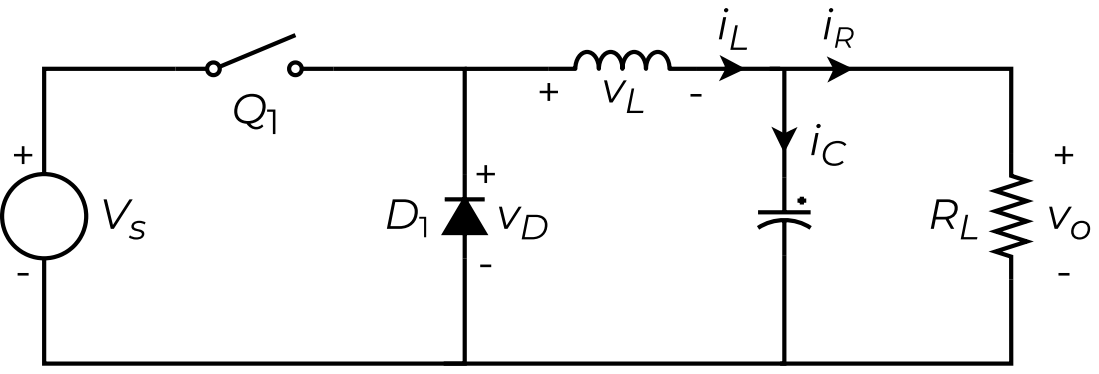
[picture p238: page 1]
