tomas-tavella/Proyecto-Final/Reference Designs/Proyecto Irusta-Caravelli/Altium/Esquematicos/driver y convertidor.pdf

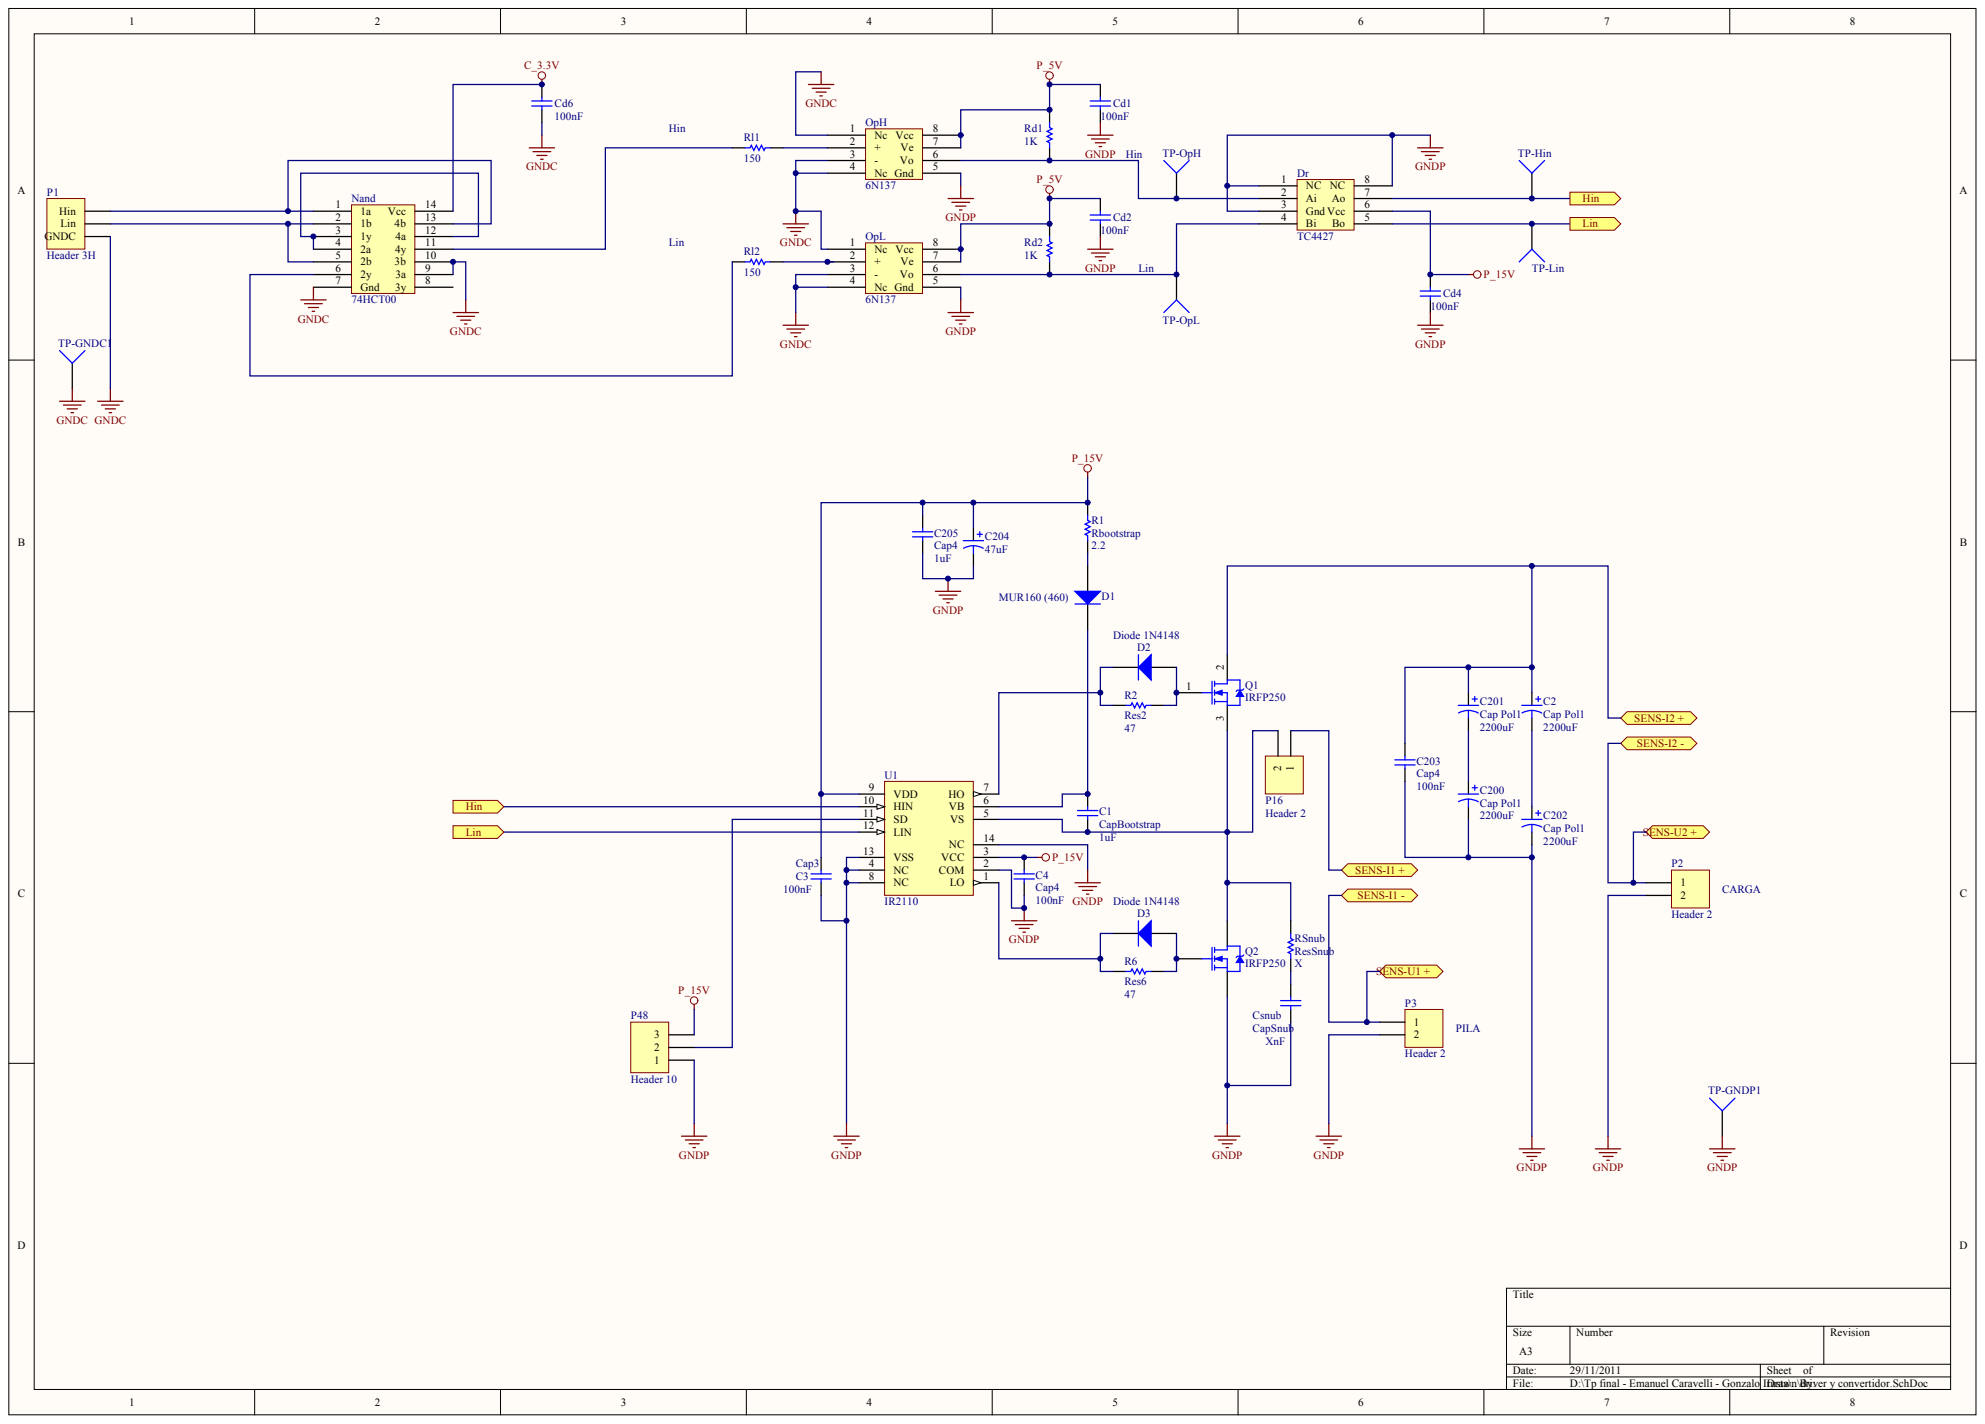
[picture p239: page 1]

C2 Cap P ol1

Cap P ol1
2 200 u F

1 1 | | 5
1 2 | | 1 4
