tomas-tavella/Proyecto-Final/Reference Designs/Proyecto Irusta-Caravelli/Altium/Esquematicos/fuentes_15V_5V_3.3V.pdf

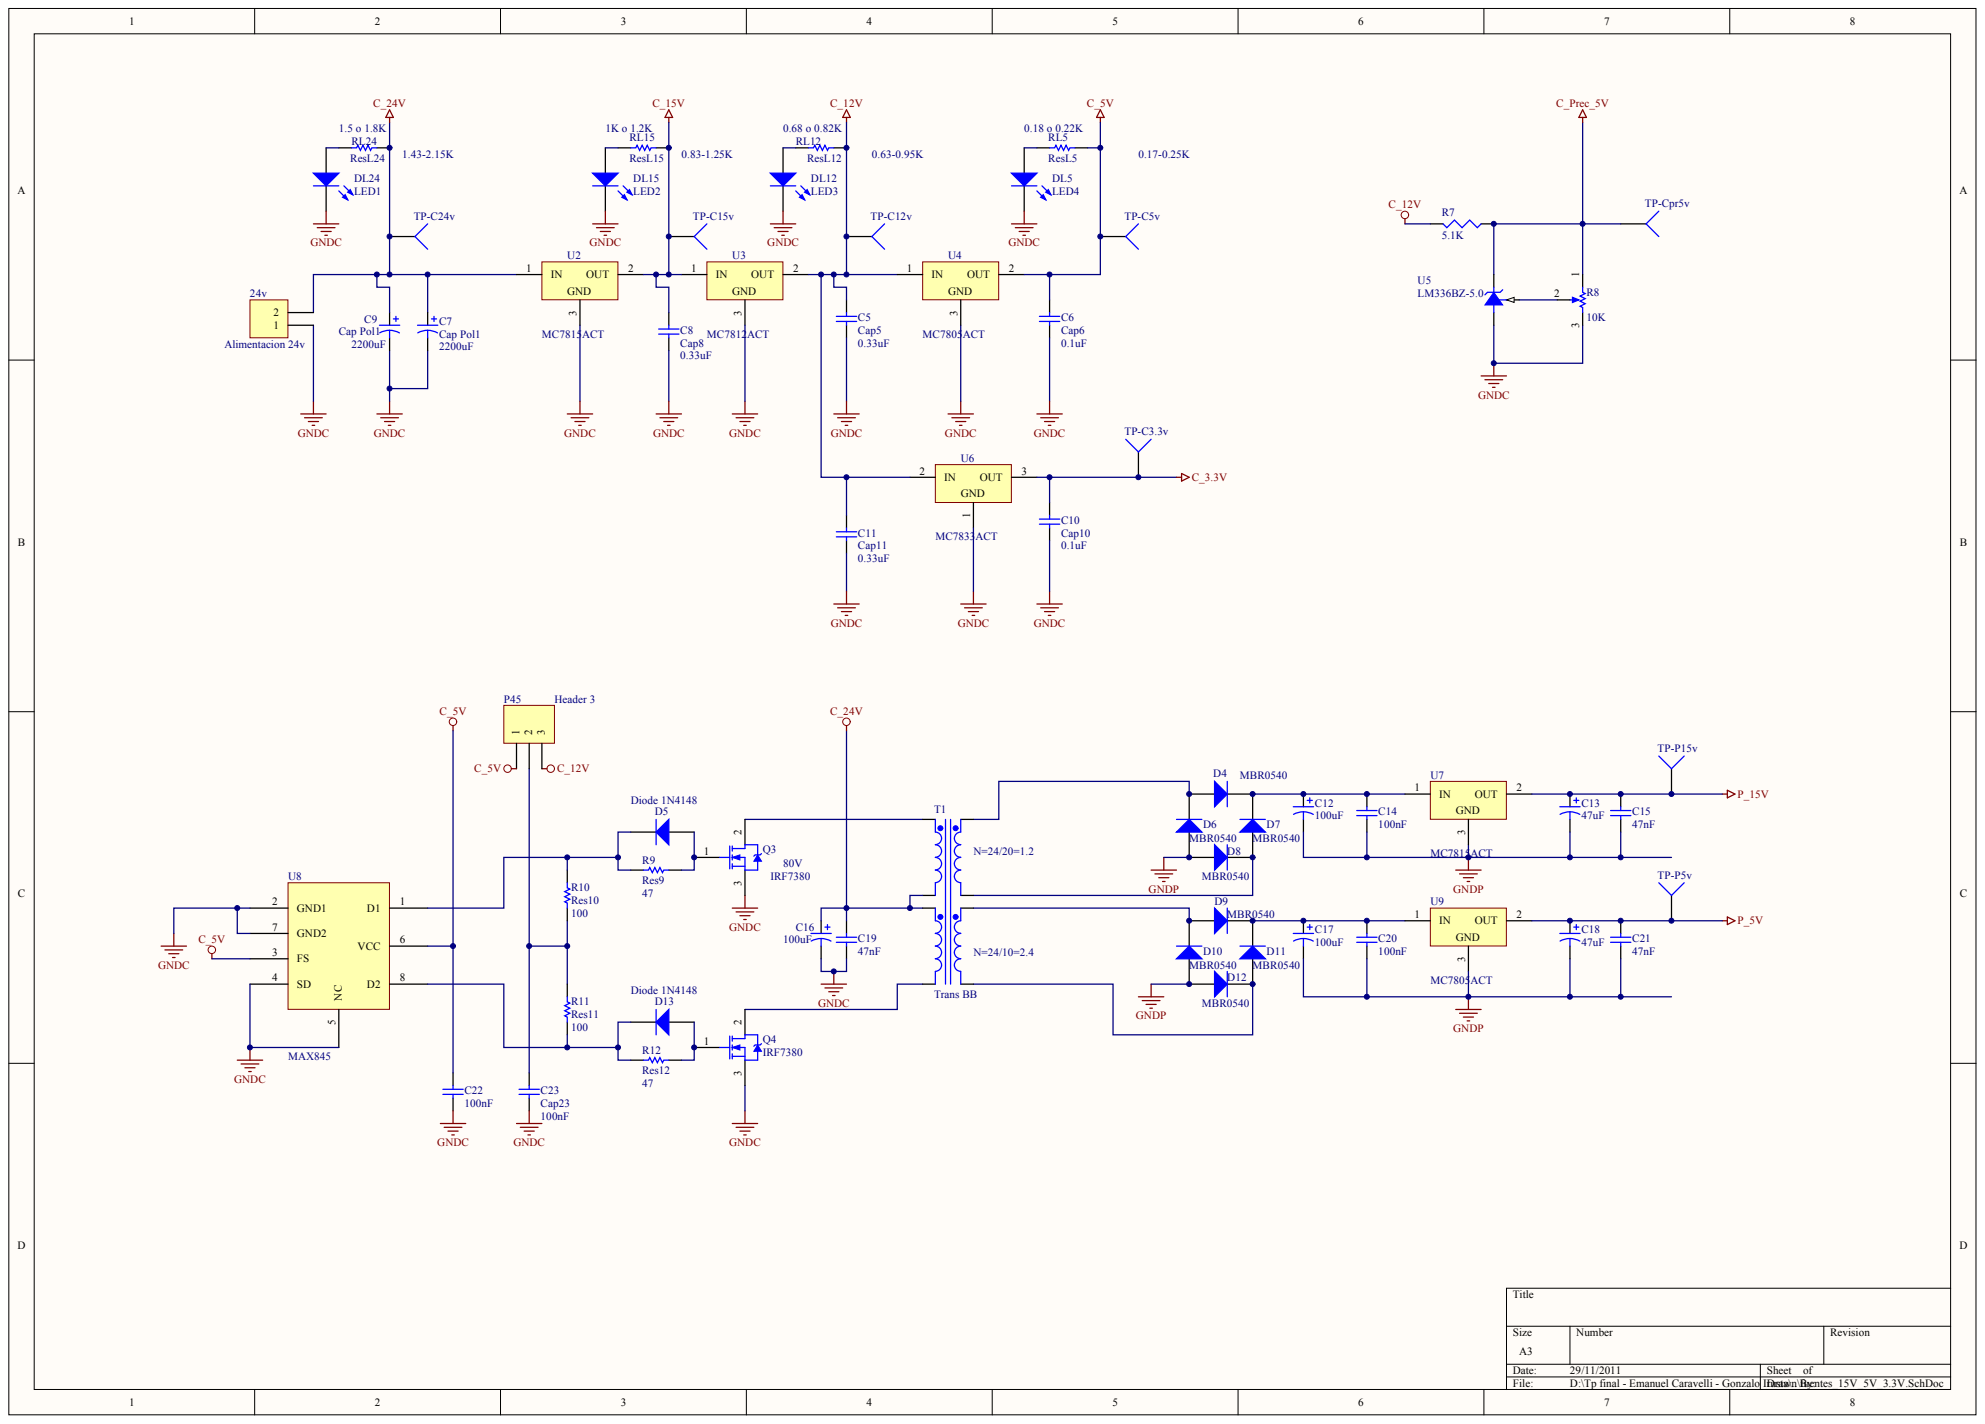
[picture p240: page 1]
