tomas-tavella/Proyecto-Final/Reference Designs/Proyecto Irusta-Caravelli/Altium/Esquematicos/PCB2.pdf

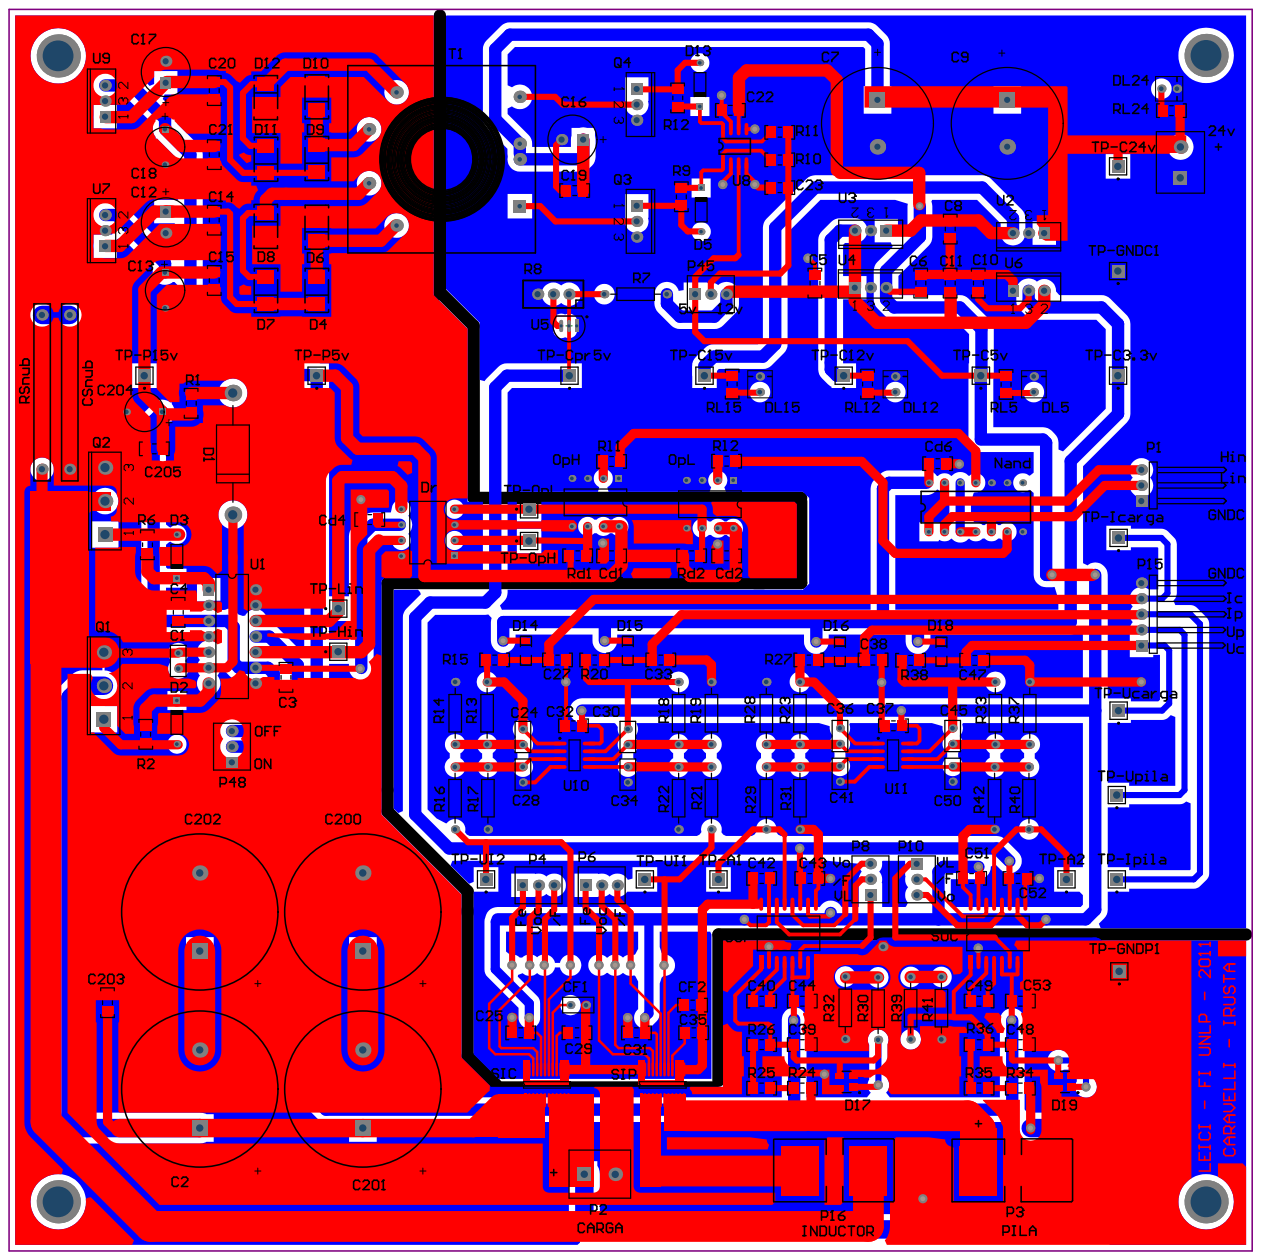
[picture p241: page 1]
