tomas-tavella/Proyecto-Final/(list of files, drawings)

Other design files:
Bibliografia/Datasheets - Notas de aplicacion/Datasheets/DSP/DIM100ExperimentersKit-HWdevPkg_v2_0/R2/BH28xxxDockingStn[R2].pcb
Bibliografia/Datasheets - Notas de aplicacion/Datasheets/DSP/DIM100ExperimentersKit-HWdevPkg_v2_0/R2/BH28xxxQuickSpinTemplate.pcb
Bibliografia/Datasheets - Notas de aplicacion/Datasheets/DSP/DIM100ExperimentersKit-HWdevPkg_v2_0/R3/USB-DockingStn[R3].pcb
Bibliografia/Datasheets - Notas de aplicacion/Datasheets/DSP/ExperimentersKit-HWdevPkg/!Legacy_DockingStation[R2]/BH28xxxDockingStn[R2].pcb
Bibliografia/Datasheets - Notas de aplicacion/Datasheets/DSP/ExperimentersKit-HWdevPkg/!Legacy_DockingStation[R2]/BH28xxxQuickSpinTemplate.pcb
Bibliografia/Datasheets - Notas de aplicacion/Datasheets/DSP/ExperimentersKit-HWdevPkg/USB-DockingStn[R3].pcb
Reference Designs/Placa adaptadora TMS320F28335/Proyecto Altium/DAC.SchDoc
Reference Designs/Placa adaptadora TMS320F28335/Proyecto Altium/Encoder.SchDoc
Reference Designs/Placa adaptadora TMS320F28335/Proyecto Altium/Placa adaptadora TMS320F28335.PrjPcb
Reference Designs/Placa adaptadora TMS320F28335/Proyecto Altium/Placa adaptadora TMS320F28335.SchDoc
Reference Designs/Placa adaptadora TMS320F28335/Proyecto Altium/SupplyPower.SchDoc
Reference Designs/Placa adaptadora TMS320F28335/Proyecto Altium/TMS320F28335.SchDoc
Reference Designs/Placa adaptadora TMS320F28335/Proyecto Altium/USB-uart.SchDoc
Reference Designs/Proyecto Irusta-Caravelli/Altium/driver y convertidor.SchDoc
Reference Designs/Proyecto Irusta-Caravelli/Altium/Esquematico de componentes.SchLib
Reference Designs/Proyecto Irusta-Caravelli/Altium/Etapa de potencia.PrjPcb
Reference Designs/Proyecto Irusta-Caravelli/Altium/Footprints.PcbLib
Reference Designs/Proyecto Irusta-Caravelli/Altium/fuentes_15V_5V_3.3V.SchDoc
Reference Designs/Proyecto Irusta-Caravelli/Altium/PCB_2D.PcbDoc
Reference Designs/Proyecto Irusta-Caravelli/Altium/sensor de corriente.SchDoc
Reference Designs/Proyecto Irusta-Caravelli/Altium/sensor de tension.SchDoc
