tomas-tavella/Proyecto-Final/Conversor/Placa-Adaptadora/Placa-Adaptadora.kicad_pcb

## KiCad design Conversor/Placa-Adaptadora/Placa-Adaptadora.kicad_pcb (2022-10-25)

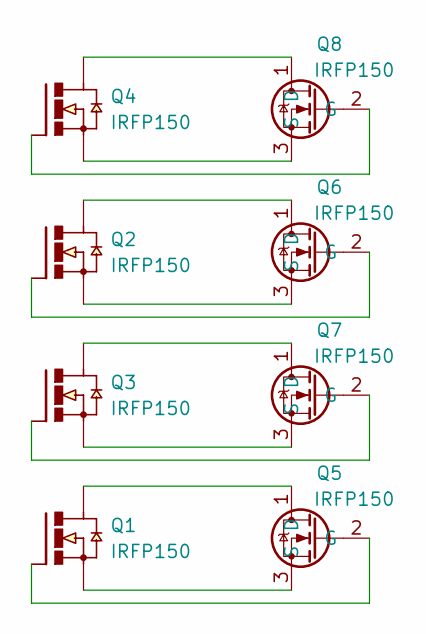
[picture p242: schematic Placa-Adaptadora.kicad_sch]

Parts:
Q1, Q2, Q3, Q4: IRFP150; TO247BV
Q5, Q6, Q7, Q8: IRFP150; TO-247-3_Vertical

Connections:
unnamed: Q2.D, Q6.1 (D)
unnamed: Q2.S, Q6.3 (S)
unnamed: Q4.D, Q8.1 (D)
unnamed: Q4.S, Q8.3 (S)
unnamed: Q1.D, Q5.1 (D)
unnamed: Q1.G, Q5.2 (G)
unnamed: Q1.S, Q5.3 (S)
unnamed: Q2.G, Q6.2 (G)
unnamed: Q3.D, Q7.1 (D)
unnamed: Q3.G, Q7.2 (G)
unnamed: Q3.S, Q7.3 (S)
unnamed: Q4.G, Q8.2 (G)

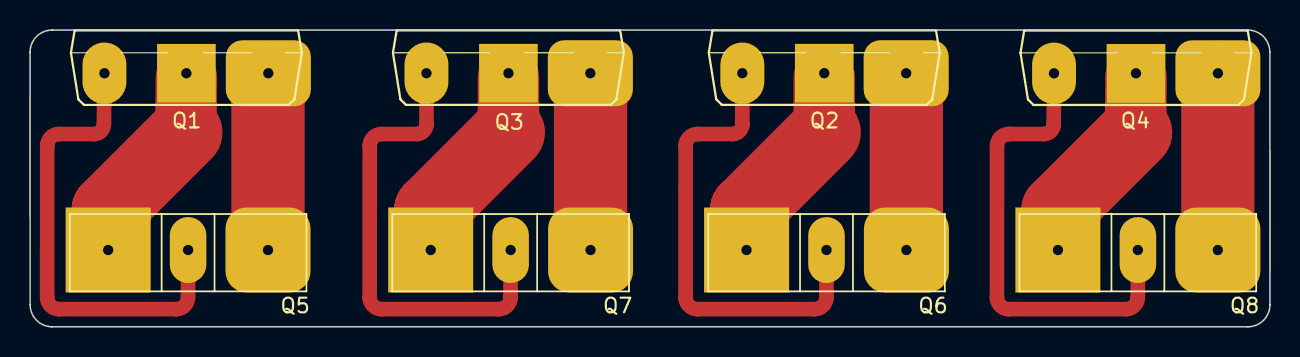
[picture p243: board Placa-Adaptadora.kicad_pcb from above]

Board: 2 copper layers, 84.6 x 20.2 mm, 8 parts (0 on the bottom side), 12 nets.
