tomas-tavella/Proyecto-Final/Reference Designs/aux-convertidor-cc/main.kicad_pcb

## KiCad design Reference Designs/aux-convertidor-cc/main.kicad_pcb (2022-06-30)

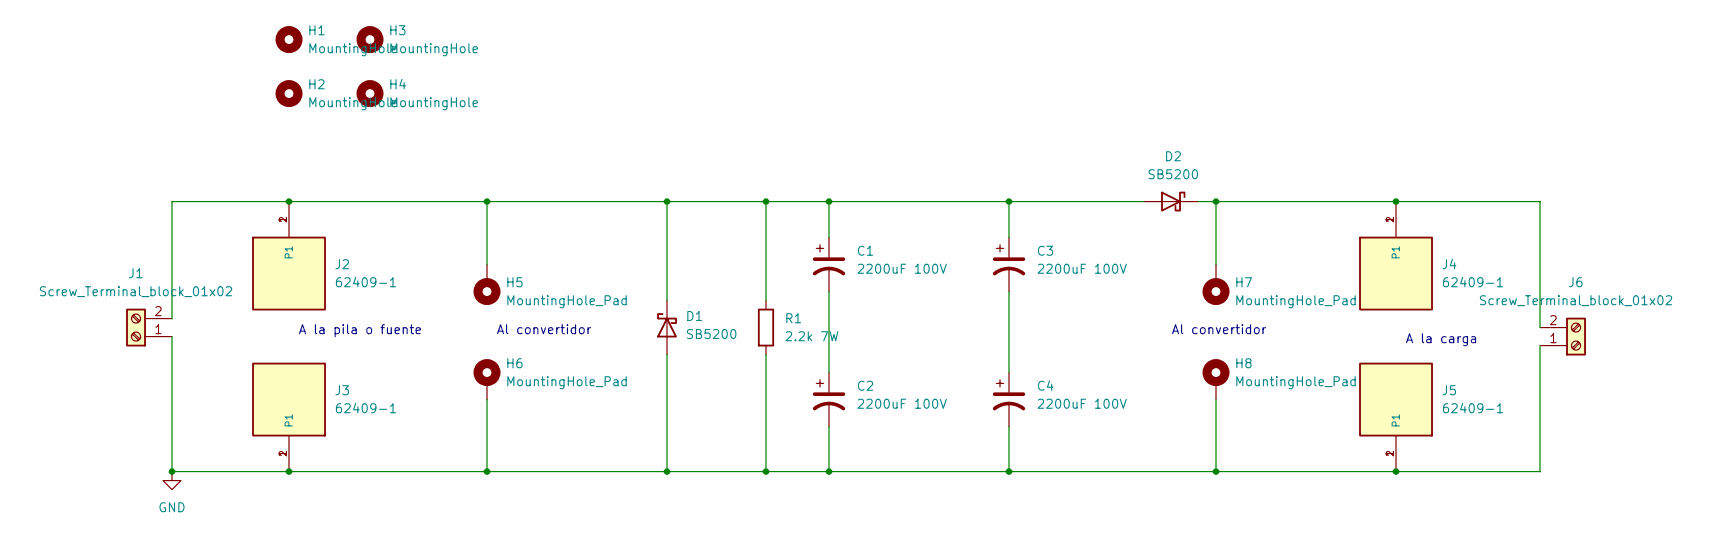
[picture p244: schematic main.kicad_sch]

Parts:
C1, C2, C3, C4: 2200uF 100V; CP_Radial_D25.0mm_P10.00mm_SnapIn
D1, D2: SB5200; D_DO-27_P15.24mm_Horizontal
H1, H2, H3, H4: MountingHole; MountingHole_3.2mm_M3
H5, H6, H7, H8: MountingHole_Pad; MountingHole_3.2mm_M3_Pad
J1, J6: Screw_Terminal_block_01x02; Degson_Screw_Terminal_block_01x02
J2, J3, J4, J5: 62409-1; TE_62409-1
R1: 2.2k 7W; R_Axial_Power_L38.0mm_W9.0mm_P40.64mm

Connections:
GND: C2.2, C4.2, D1.2 (A), H6.1, H8.1, J1.1, J3.1, J3.2 (P1), J5.1, J5.2 (P1), J6.1, R1.2
unnamed: C1.1, C3.1, D1.1 (K), D2.2 (A), H5.1, J1.2, J2.1, J2.2 (P1), R1.1
unnamed: C1.2, C2.1
unnamed: C3.2, C4.1
unnamed: D2.1 (K), H7.1, J4.1, J4.2 (P1), J6.2

Notes on the sheet:
Al convertidor
A la pila o fuente
A la carga

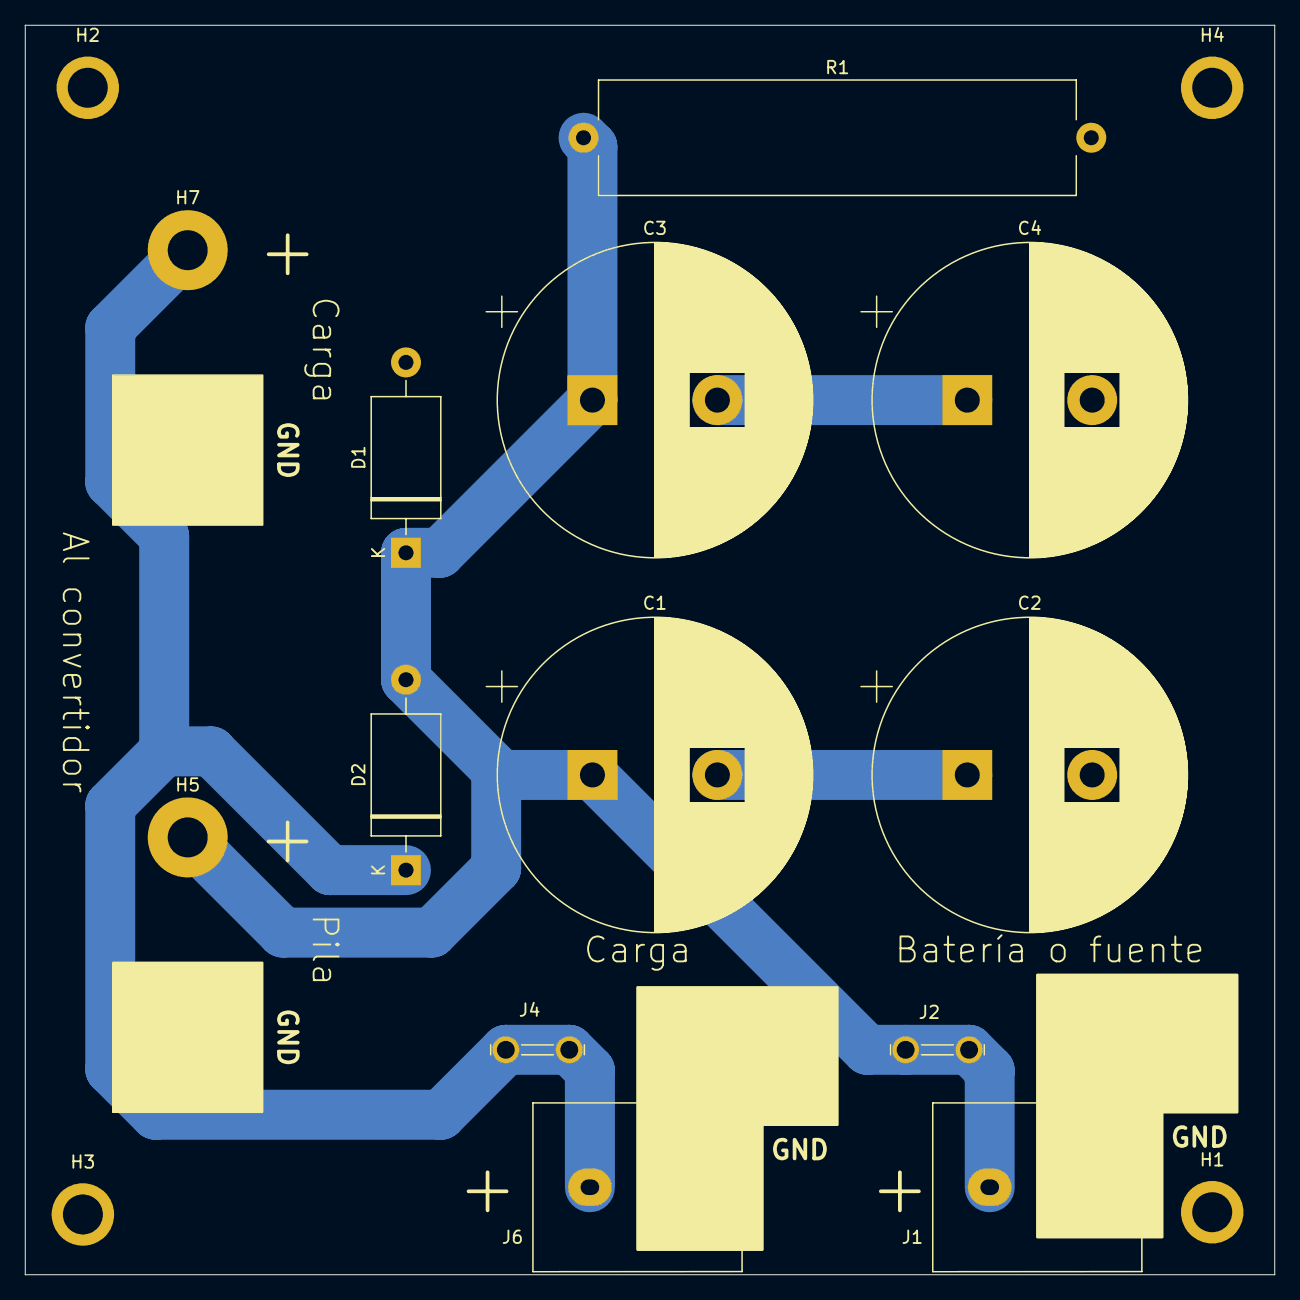
[picture p245: board main.kicad_pcb from above]

Board: 2 copper layers, 100.0 x 100.0 mm, 21 parts (0 on the bottom side), 5 nets.
