tomas-tavella/Proyecto-Final/Conversor/Proyecto-KiCAD/Proyecto-KiCAD.kicad_pcb

## KiCad design Conversor/Proyecto-KiCAD/Proyecto-KiCAD.kicad_pcb (2022-06-23)

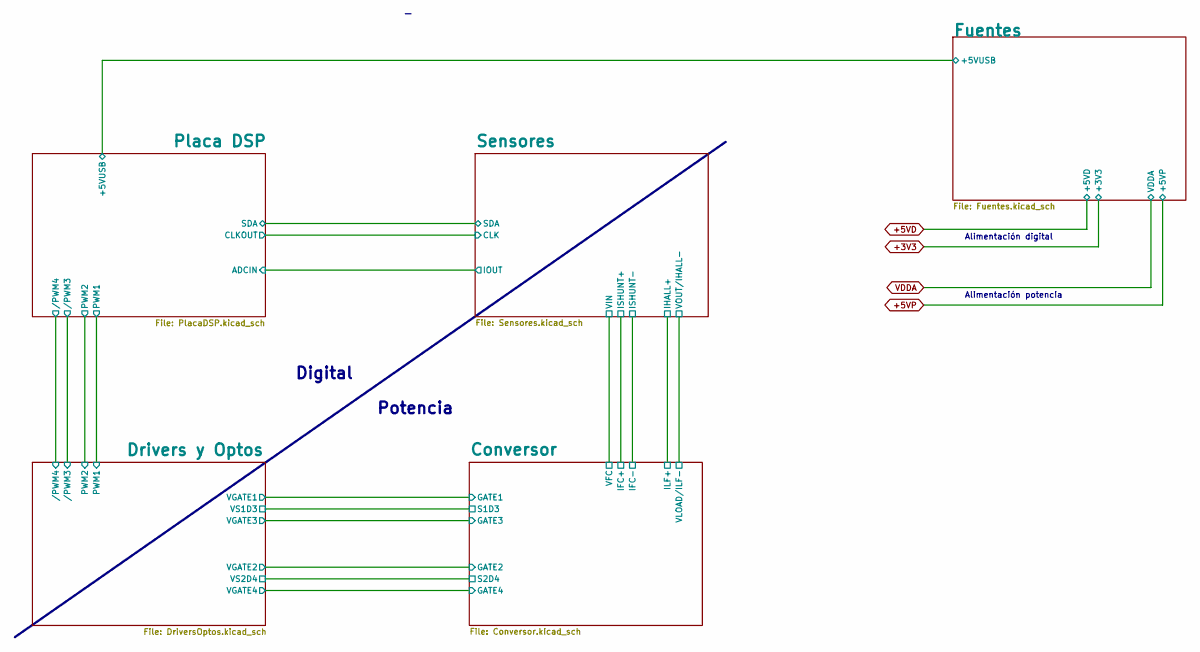
[picture p246: schematic Proyecto-KiCAD.kicad_sch]

Notes on the sheet:
Digital
Alimentación potencia
Potencia
Alimentación digital

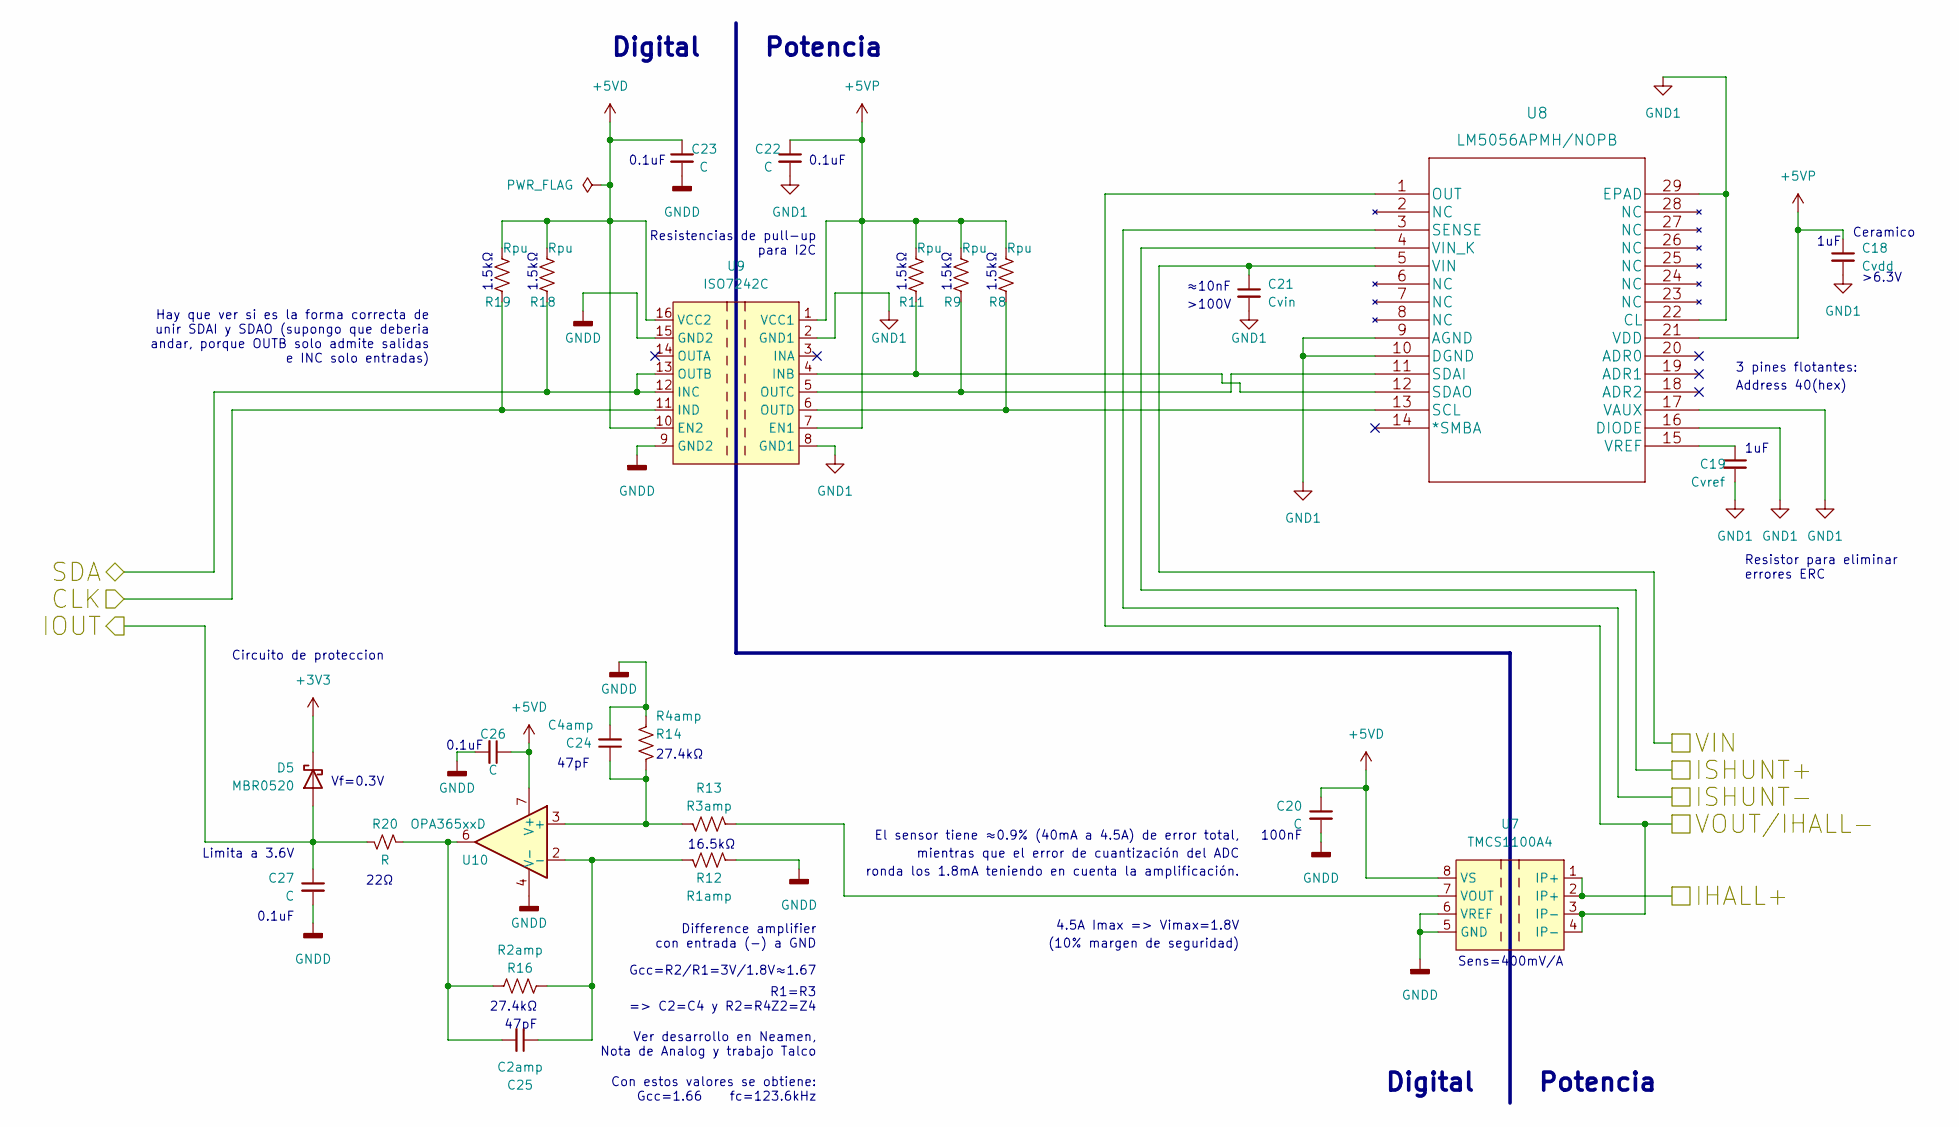
[picture p247: schematic Sensores.kicad_sch]

Parts:
C18: Cvdd; C_1206_3216Metric_Pad1.33x1.80mm_HandSolder
C19: Cvref; C_1206_3216Metric_Pad1.33x1.80mm_HandSolder
C20, C22, C23, C26, C27: C; C_1206_3216Metric_Pad1.33x1.80mm_HandSolder
C21: Cvin; C_1206_3216Metric_Pad1.33x1.80mm_HandSolder
C24: C4amp; C_1206_3216Metric_Pad1.33x1.80mm_HandSolder
C25: C2amp; C_1206_3216Metric_Pad1.33x1.80mm_HandSolder
D5: MBR0520; D_SOD-123
R8, R9, R11, R18, R19: Rpu; R_1206_3216Metric_Pad1.30x1.75mm_HandSolder
R12: R1amp; R_1206_3216Metric_Pad1.30x1.75mm_HandSolder
R13: R3amp; R_1206_3216Metric_Pad1.30x1.75mm_HandSolder
R14: R4amp; R_1206_3216Metric_Pad1.30x1.75mm_HandSolder
R16: R2amp; R_1206_3216Metric_Pad1.30x1.75mm_HandSolder
R20: R; R_1206_3216Metric_Pad1.30x1.75mm_HandSolder
U7: TMCS1100A4; SOIC-8_3.9x4.9mm_P1.27mm
U8: LM5056APMH/NOPB; HTSSOP-28-1EP_4.4x9.7mm_P0.65mm_EP2.85x5.4mm
U9: ISO7242C; SOIC-16W_7.5x10.3mm_P1.27mm
U10: OPA365xxD; SOIC-8_3.9x4.9mm_P1.27mm

Connections:
+3V3: D5.1 (K); also elsewhere on the board
+5VD: C20.1, C23.1, C26.1, R18.1, R19.1, U7.8 (VS), U9.10 (EN2), U9.16 (VCC2), U10.7 (V+); also elsewhere on the board
+5VP: C18.1, C22.1, R8.1, R9.1, R11.1, U8.21 (VDD), U9.1 (VCC1), U9.7 (EN1); also elsewhere on the board
/Conversor/IFC+: C21.1, U8.4 (VIN_K), U8.5 (VIN); also elsewhere on the board
/Conversor/IFC-: U8.3 (SENSE); also elsewhere on the board
/Conversor/ILF+: U7.1 (IP+), U7.2 (IP+); also elsewhere on the board
/Conversor/VLOAD/ILF-: U7.3 (IP-), U7.4 (IP-), U8.1 (OUT); also elsewhere on the board
/Placa DSP/Socket Interfaces/ADCIN-A0: C27.1, D5.2 (A), R20.2; also elsewhere on the board
/Placa DSP/Socket Interfaces/I2CSCL: R19.2, U9.11 (IND); also elsewhere on the board
/Placa DSP/Socket Interfaces/I2CSDA: R18.2, U9.12 (INC), U9.13 (OUTB); also elsewhere on the board
GND1: C18.2, C19.2, C21.2, C22.2, U8.9 (AGND), U8.10 (DGND), U8.16 (DIODE), U8.17 (VAUX), U8.22 (CL), U8.29 (EPAD), U9.2 (GND1), U9.8 (GND1); also elsewhere on the board
GNDD: C20.2, C23.2, C24.2, C26.2, C27.2, R12.1, R14.2, U7.5 (GND), U7.6 (VREF), U9.9 (GND2), U9.15 (GND2), U10.4 (V-); also elsewhere on the board
unnamed: C19.1, U8.15 (VREF)
unnamed: C24.1, R13.2, R14.1, U10.3 (+)
unnamed: C25.1, R12.2, R16.1, U10.2 (-)
unnamed: C25.2, R16.2, R20.1, U10.6
unnamed: R8.2, U8.13 (SCL), U9.6 (OUTD)
unnamed: R9.2, U8.11 (SDAI), U9.5 (OUTC)
unnamed: R11.2, U8.12 (SDAO), U9.4 (INB)
unnamed: R13.1, U7.7 (VOUT)

Notes on the sheet:
Sens=400mV/A
mientras que el error de cuantización del ADC
Ver desarrollo en Neamen, Nota de Analog y trabajo Talco
Gcc=R2/R1=3V/1.8V≈1.67
3 pines flotantes:
1.5kΩ
≈10nF
Vf=0.3V
R1=R3 Z2=Z4
1uF
Con estos valores se obtiene: Gcc=1.66 fc=123.6kHz
16.5kΩ
Limita a 3.6V
0.1uF
>6.3V
22Ω
100nF
=> C2=C4 y R2=R4
Digital
Resistor para eliminar errores ERC
Hay que ver si es la forma correcta de unir SDAI y SDAO (supongo que deberia andar, porque OUTB solo admite salidas e INC solo entradas)
(10% margen de seguridad)
Address 40(hex)
Potencia
Ceramico
47pF
27.4kΩ
Circuito de proteccion
Resistencias de pull-up para I2C
>100V
Difference amplifier con entrada (-) a GND
4.5A Imax => Vimax=1.8V
El sensor tiene ≈0.9% (40mA a 4.5A) de error total,
ronda los 1.8mA teniendo en cuenta la amplificación.

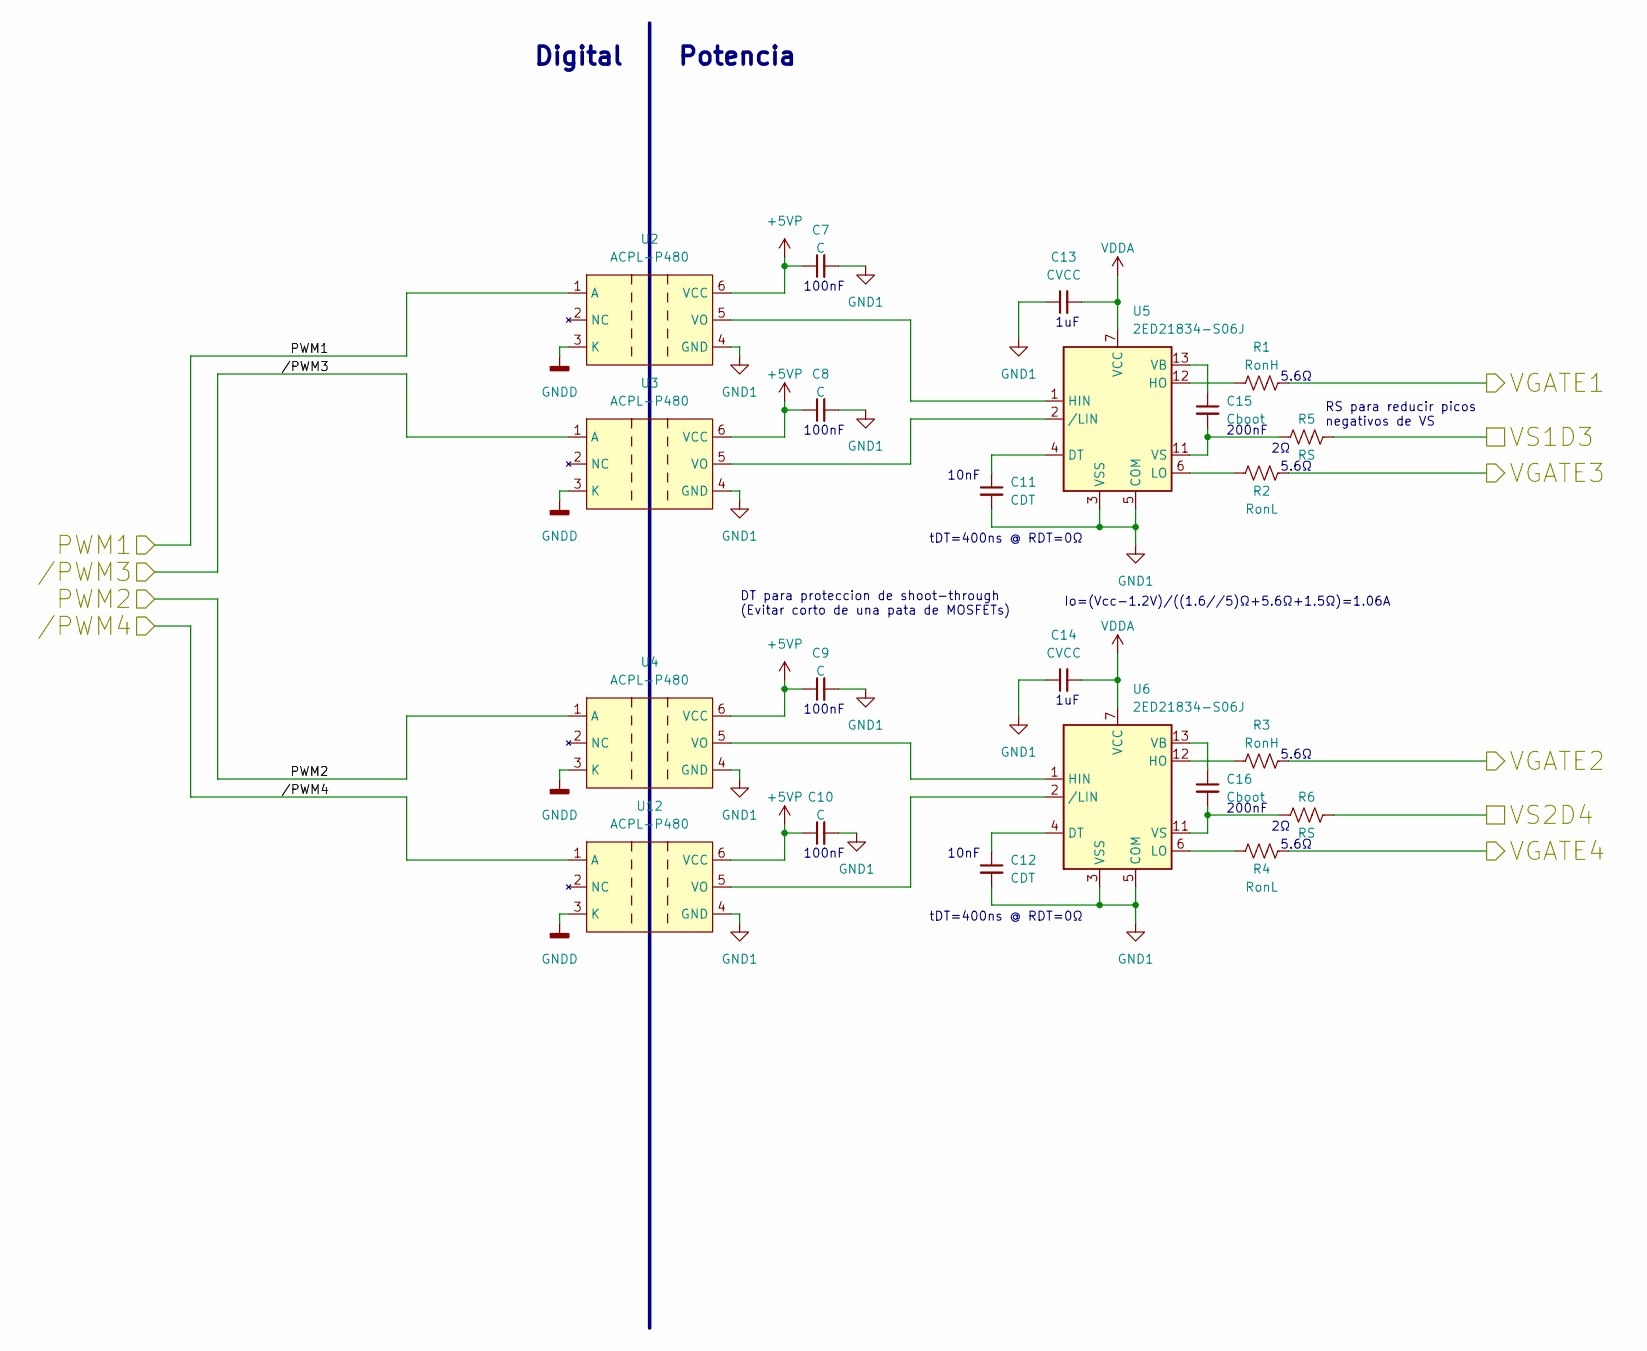
[picture p248: schematic DriversOptos.kicad_sch]

Parts:
C7, C8, C9, C10: C; C_1206_3216Metric_Pad1.33x1.80mm_HandSolder
C11, C12: CDT; C_1206_3216Metric_Pad1.33x1.80mm_HandSolder
C13, C14: CVCC; C_1206_3216Metric_Pad1.33x1.80mm_HandSolder
C15, C16: Cboot; C_1206_3216Metric_Pad1.33x1.80mm_HandSolder
R1, R3: RonH; R_1206_3216Metric_Pad1.30x1.75mm_HandSolder
R2, R4: RonL; R_1206_3216Metric_Pad1.30x1.75mm_HandSolder
R5, R6: RS; R_1206_3216Metric_Pad1.30x1.75mm_HandSolder
U2, U3, U4, U12: ACPL-P480; SSO-6_6.8x4.6mm_P1.27mm_Clearance7mm
U5, U6: 2ED21834-S06J; SO-14_3.9x8.65mm_P1.27mm

Connections:
+5VP: C7.1, C8.1, C9.1, C10.1, U2.6 (VCC), U3.6 (VCC), U4.6 (VCC), U12.6 (VCC); also elsewhere on the board
/Conversor/GATE1: R1.2; also elsewhere on the board
/Conversor/GATE2: R3.2; also elsewhere on the board
/Conversor/GATE3: R2.2; also elsewhere on the board
/Conversor/GATE4: R4.2; also elsewhere on the board
/Conversor/S1D3: R5.2; also elsewhere on the board
/Conversor/S2D4: R6.2; also elsewhere on the board
/Drivers y Optos/PWM1: U2.1 (A); also elsewhere on the board
/Drivers y Optos/PWM2: U4.1 (A); also elsewhere on the board
/Drivers y Optos//PWM3: U3.1 (A); also elsewhere on the board
/Drivers y Optos//PWM4: U12.1 (A); also elsewhere on the board
GND1: C7.2, C8.2, C9.2, C10.2, C11.2, C12.2, C13.1, C14.1, U2.4 (GND), U3.4 (GND), U4.4 (GND), U5.3 (VSS), U5.5 (COM), U6.3 (VSS), U6.5 (COM), U12.4 (GND); also elsewhere on the board
GNDD: U2.3 (K), U3.3 (K), U4.3 (K), U12.3 (K); also elsewhere on the board
unnamed: C11.1, U5.4 (DT)
unnamed: C12.1, U6.4 (DT)
unnamed: C15.1, U5.13 (VB)
unnamed: C15.2, R5.1, U5.11 (VS)
unnamed: C16.1, U6.13 (VB)
unnamed: C16.2, R6.1, U6.11 (VS)
unnamed: R1.1, U5.12 (HO)
unnamed: R2.1, U5.6 (LO)
unnamed: R3.1, U6.12 (HO)
unnamed: R4.1, U6.6 (LO)
unnamed: U2.5 (VO), U5.1 (HIN)
unnamed: U3.5 (VO), U5.2 (/LIN)
unnamed: U4.5 (VO), U6.1 (HIN)
unnamed: U6.2 (/LIN), U12.5 (VO)
VDDA: C13.2, C14.2, U5.7 (VCC), U6.7 (VCC); also elsewhere on the board

Notes on the sheet:
Io=(Vcc-1.2V)/((1.6//5)Ω+5.6Ω+1.5Ω)=1.06A
100nF
200nF
5.6Ω
RS para reducir picos negativos de VS
1uF
DT para proteccion de shoot-through (Evitar corto de una pata de MOSFETs)
tDT=400ns @ RDT=0Ω
Digital
Potencia
10nF

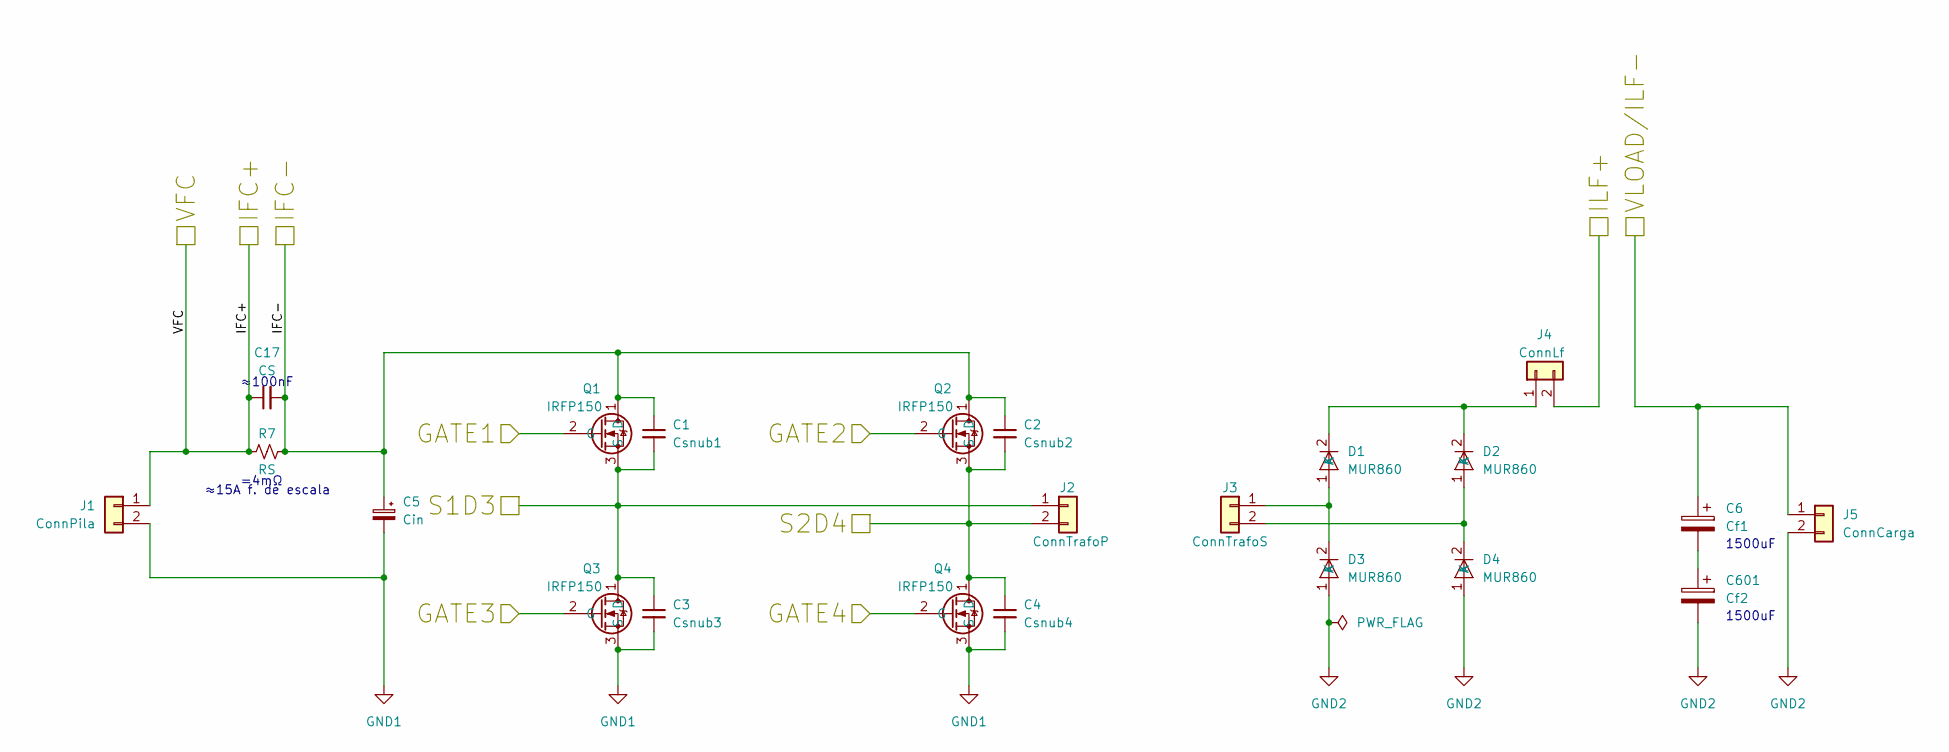
[picture p249: schematic Conversor.kicad_sch]

Parts:
C1: Csnub1; C_1206_3216Metric_Pad1.33x1.80mm_HandSolder
C2: Csnub2; C_1206_3216Metric_Pad1.33x1.80mm_HandSolder
C3: Csnub3; C_1206_3216Metric_Pad1.33x1.80mm_HandSolder
C4: Csnub4; C_1206_3216Metric_Pad1.33x1.80mm_HandSolder
C5: Cin; CP_Radial_D12.5mm_P5.00mm
C6: Cf1; CP_Radial_D18.0mm_P7.50mm
C17: CS; C_1206_3216Metric_Pad1.33x1.80mm_HandSolder
C601: Cf2; CP_Radial_D18.0mm_P7.50mm
D1, D2, D3, D4: MUR860; TO-220F-2_Vertical
J1: ConnPila; TerminalBlock_Wuerth_691311400102_P7.62mm
J2: ConnTrafoP; TerminalBlock_Wuerth_691311400102_P7.62mm
J3: ConnTrafoS; TerminalBlock_Wuerth_691311400102_P7.62mm
J4: ConnLf; TerminalBlock_Wuerth_691311400102_P7.62mm
J5: ConnCarga; TerminalBlock_Wuerth_691311400102_P7.62mm
Q1, Q2, Q3, Q4: IRFP150; TO-247-3_Vertical
R7: RS; R_2512_6332Metric_Pad1.40x3.35mm_HandSolder

Connections:
/Conversor/GATE1: Q1.2 (G); also elsewhere on the board
/Conversor/GATE2: Q2.2 (G); also elsewhere on the board
/Conversor/GATE3: Q3.2 (G); also elsewhere on the board
/Conversor/GATE4: Q4.2 (G); also elsewhere on the board
/Conversor/IFC+: C17.1, J1.1, R7.1; also elsewhere on the board
/Conversor/IFC-: C1.1, C2.1, C5.1, C17.2, Q1.1 (D), Q2.1 (D), R7.2; also elsewhere on the board
/Conversor/ILF+: J4.2; also elsewhere on the board
/Conversor/S1D3: C1.2, C3.1, J2.1, Q1.3 (S), Q3.1 (D); also elsewhere on the board
/Conversor/S2D4: C2.2, C4.1, J2.2, Q2.3 (S), Q4.1 (D); also elsewhere on the board
/Conversor/VLOAD/ILF-: C6.1, J5.1; also elsewhere on the board
GND1: C3.2, C4.2, C5.2, J1.2, Q3.3 (S), Q4.3 (S); also elsewhere on the board
GND2: C601.2, D3.1 (A), D4.1 (A), J5.2; also elsewhere on the board
unnamed: C6.2, C601.1
unnamed: D1.1 (A), D3.2 (K), J3.1
unnamed: D1.2 (K), D2.2 (K), J4.1
unnamed: D2.1 (A), D4.2 (K), J3.2

Notes on the sheet:
=4mΩ
1500uF
≈15A f. de escala
≈100nF

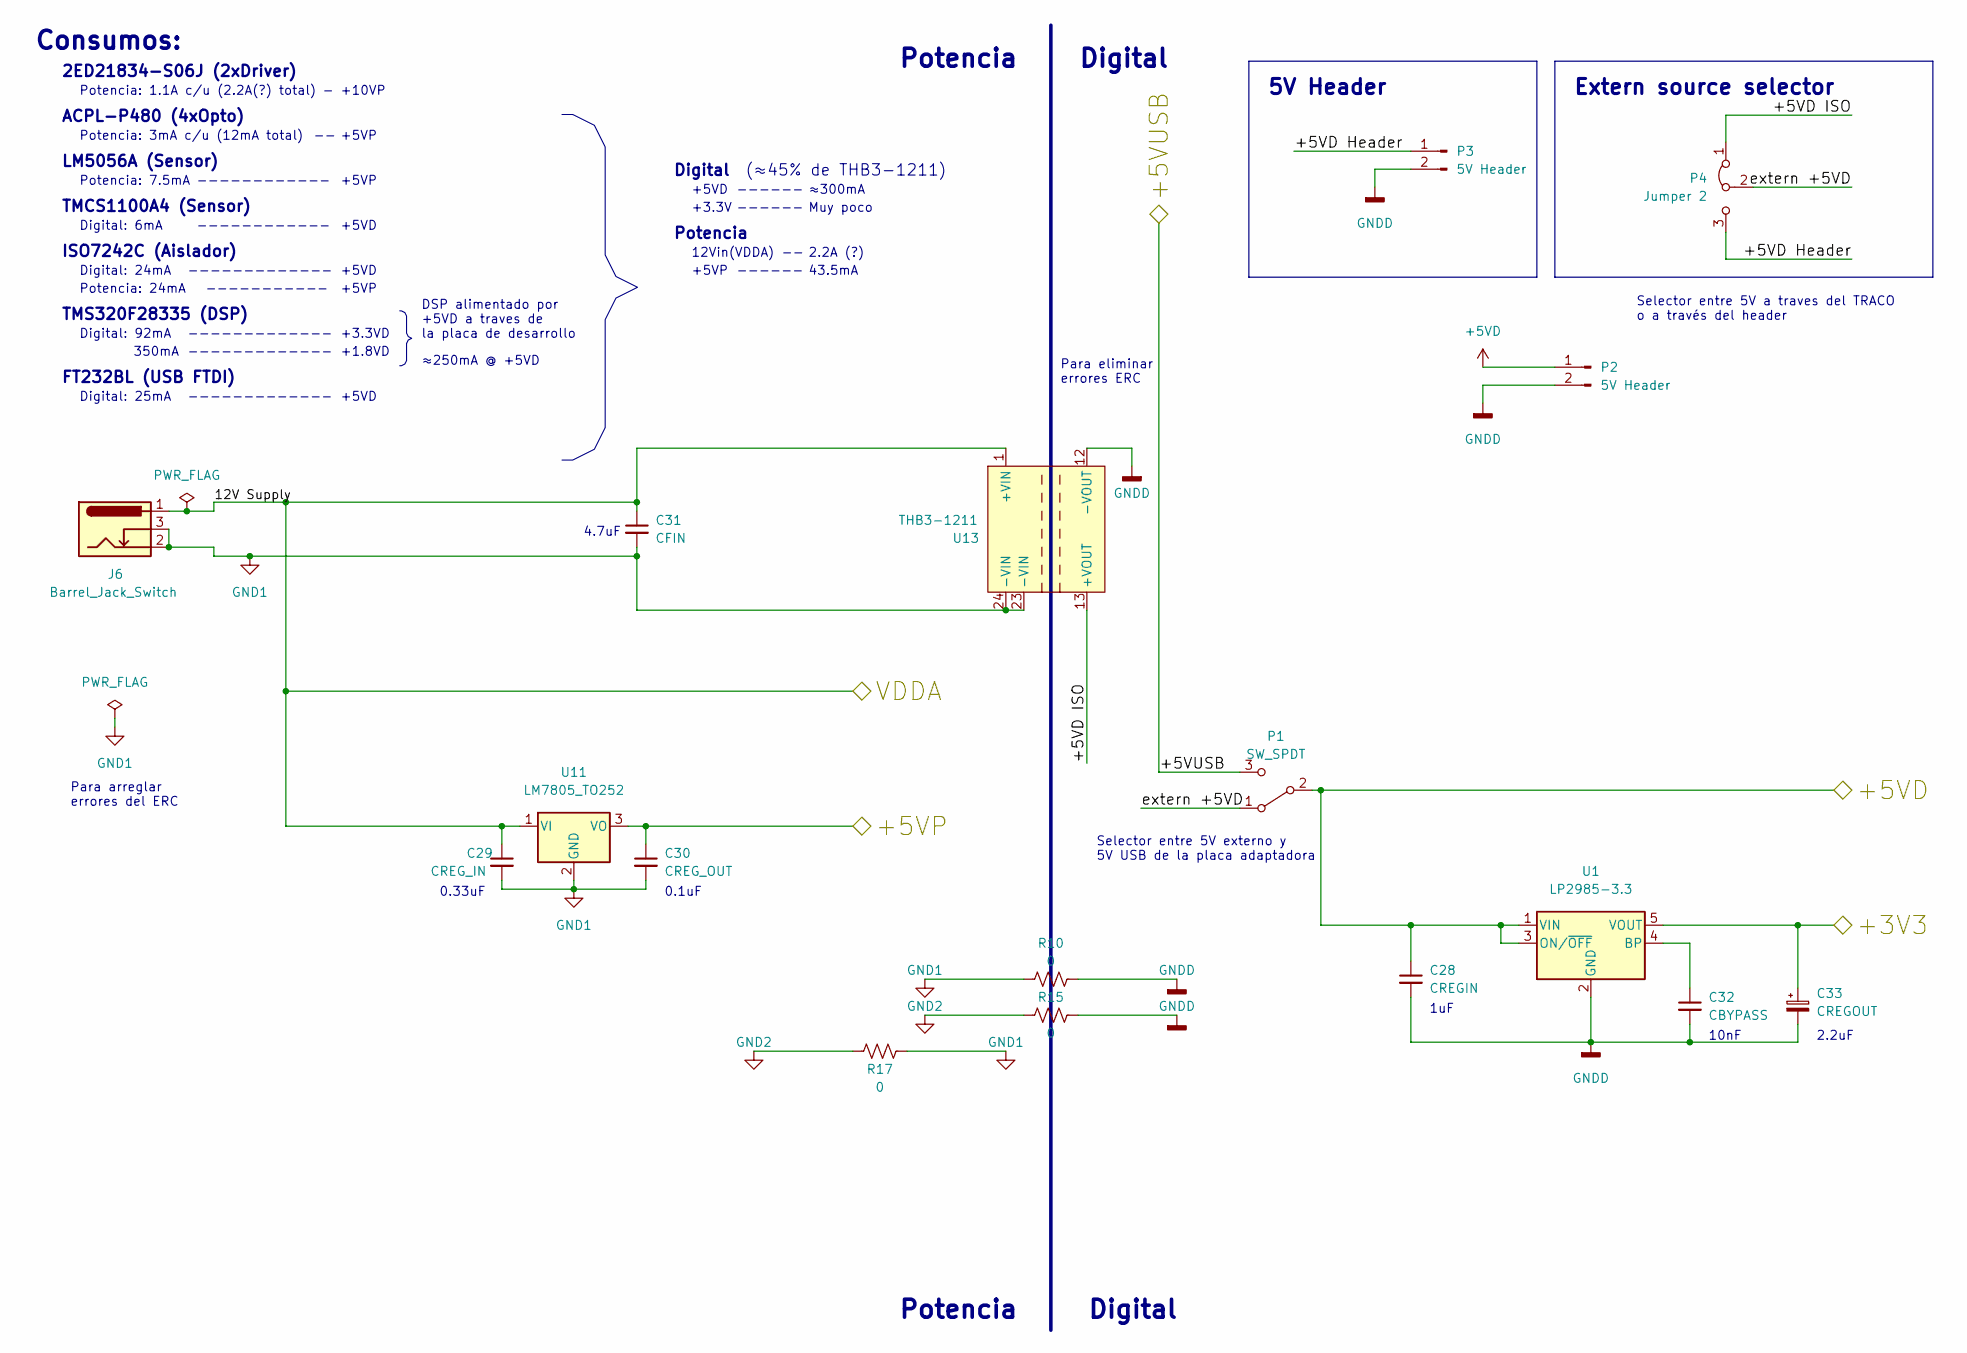
[picture p250: schematic Fuentes.kicad_sch]

Parts:
C28: CREGIN; C_1206_3216Metric_Pad1.33x1.80mm_HandSolder
C29: CREG_IN; C_1206_3216Metric_Pad1.33x1.80mm_HandSolder
C30: CREG_OUT; C_1206_3216Metric_Pad1.33x1.80mm_HandSolder
C31: CFIN; C_1206_3216Metric_Pad1.33x1.80mm_HandSolder
C32: CBYPASS; C_1206_3216Metric_Pad1.33x1.80mm_HandSolder
C33: CREGOUT; C_1206_3216Metric_Pad1.33x1.80mm_HandSolder
J6: Barrel_Jack_Switch; BarrelJack_GCT_DCJ200-10-A_Horizontal
P1: SW_SPDT; PinHeader_1x03_P2.54mm_Vertical
P2, P3: 5V Header; PinHeader_1x02_P2.54mm_Vertical
P4: Jumper 2; PinHeader_1x03_P2.54mm_Vertical
R10, R15, R17: 0; R_1206_3216Metric_Pad1.30x1.75mm_HandSolder
U1: LP2985-3.3; SOT-23-5
U11: LM7805_TO252; TO-252-2
U13: THB3-1211; DIP-24_W15.24mm

Connections:
+3V3: C33.1, U1.5 (VOUT); also elsewhere on the board
+5VD: C28.1, P1.2 (B), P2.1, U1.1 (VIN), U1.3 (ON/~OFF); also elsewhere on the board
+5VP: C30.1, U11.3 (VO); also elsewhere on the board
/Fuentes/+5VD Header: P3.1, P4.3 (B)
/Fuentes/+5VD ISO: P4.1 (A), U13.13 (+VOUT)
/Fuentes/+5VUSB: P1.3 (C); also elsewhere on the board
/Fuentes/extern +5VD: P1.1 (A), P4.2 (C)
GND1: C29.2, C30.2, C31.2, J6.2, J6.3, R10.1, R17.2, U11.2 (GND), U13.23 (-VIN), U13.24 (-VIN); also elsewhere on the board
GND2: R15.1, R17.1; also elsewhere on the board
GNDD: C28.2, C32.2, C33.2, P2.2, P3.2, R10.2, R15.2, U1.2 (GND), U13.12 (-VOUT); also elsewhere on the board
unnamed: C32.1, U1.4 (BP)
VDDA: C29.1, C31.1, J6.1, U11.1 (VI), U13.1 (+VIN); also elsewhere on the board

Notes on the sheet:
350mA
+3.3V
Consumos:
Potencia: 7.5mA
Selector entre 5V externo y 5V USB de la placa adaptadora
Potencia: 3mA c/u (12mA total)
(?)
0.33uF
ISO7242C (Aislador)
Potencia: 1.1A c/u (2.2A(?) total)
Potencia
Selector entre 5V a traves del TRACO o a través del header
+5VD
Digital: 25mA
Digital
5V Header
+5VP
+10VP
TMS320F28335 (DSP)
Potencia: 24mA
≈300mA
-----------
12Vin(VDDA)
LM5056A (Sensor)
43.5mA
1uF
------------
------
ACPL-P480 (4xOpto)
Para eliminar errores ERC
Digital: 92mA
+1.8VD
TMCS1100A4 (Sensor)
Muy poco
Digital: 6mA
Extern source selector
-------------
≈250mA @ +5VD
2.2uF
2ED21834-S06J (2xDriver)
4.7uF
DSP alimentado por +5VD a traves de la placa de desarrollo
0.1uF
FT232BL (USB FTDI)
Para arreglar errores del ERC
10nF
(≈45% de THB3-1211)
Digital: 24mA
+3.3VD
2.2A

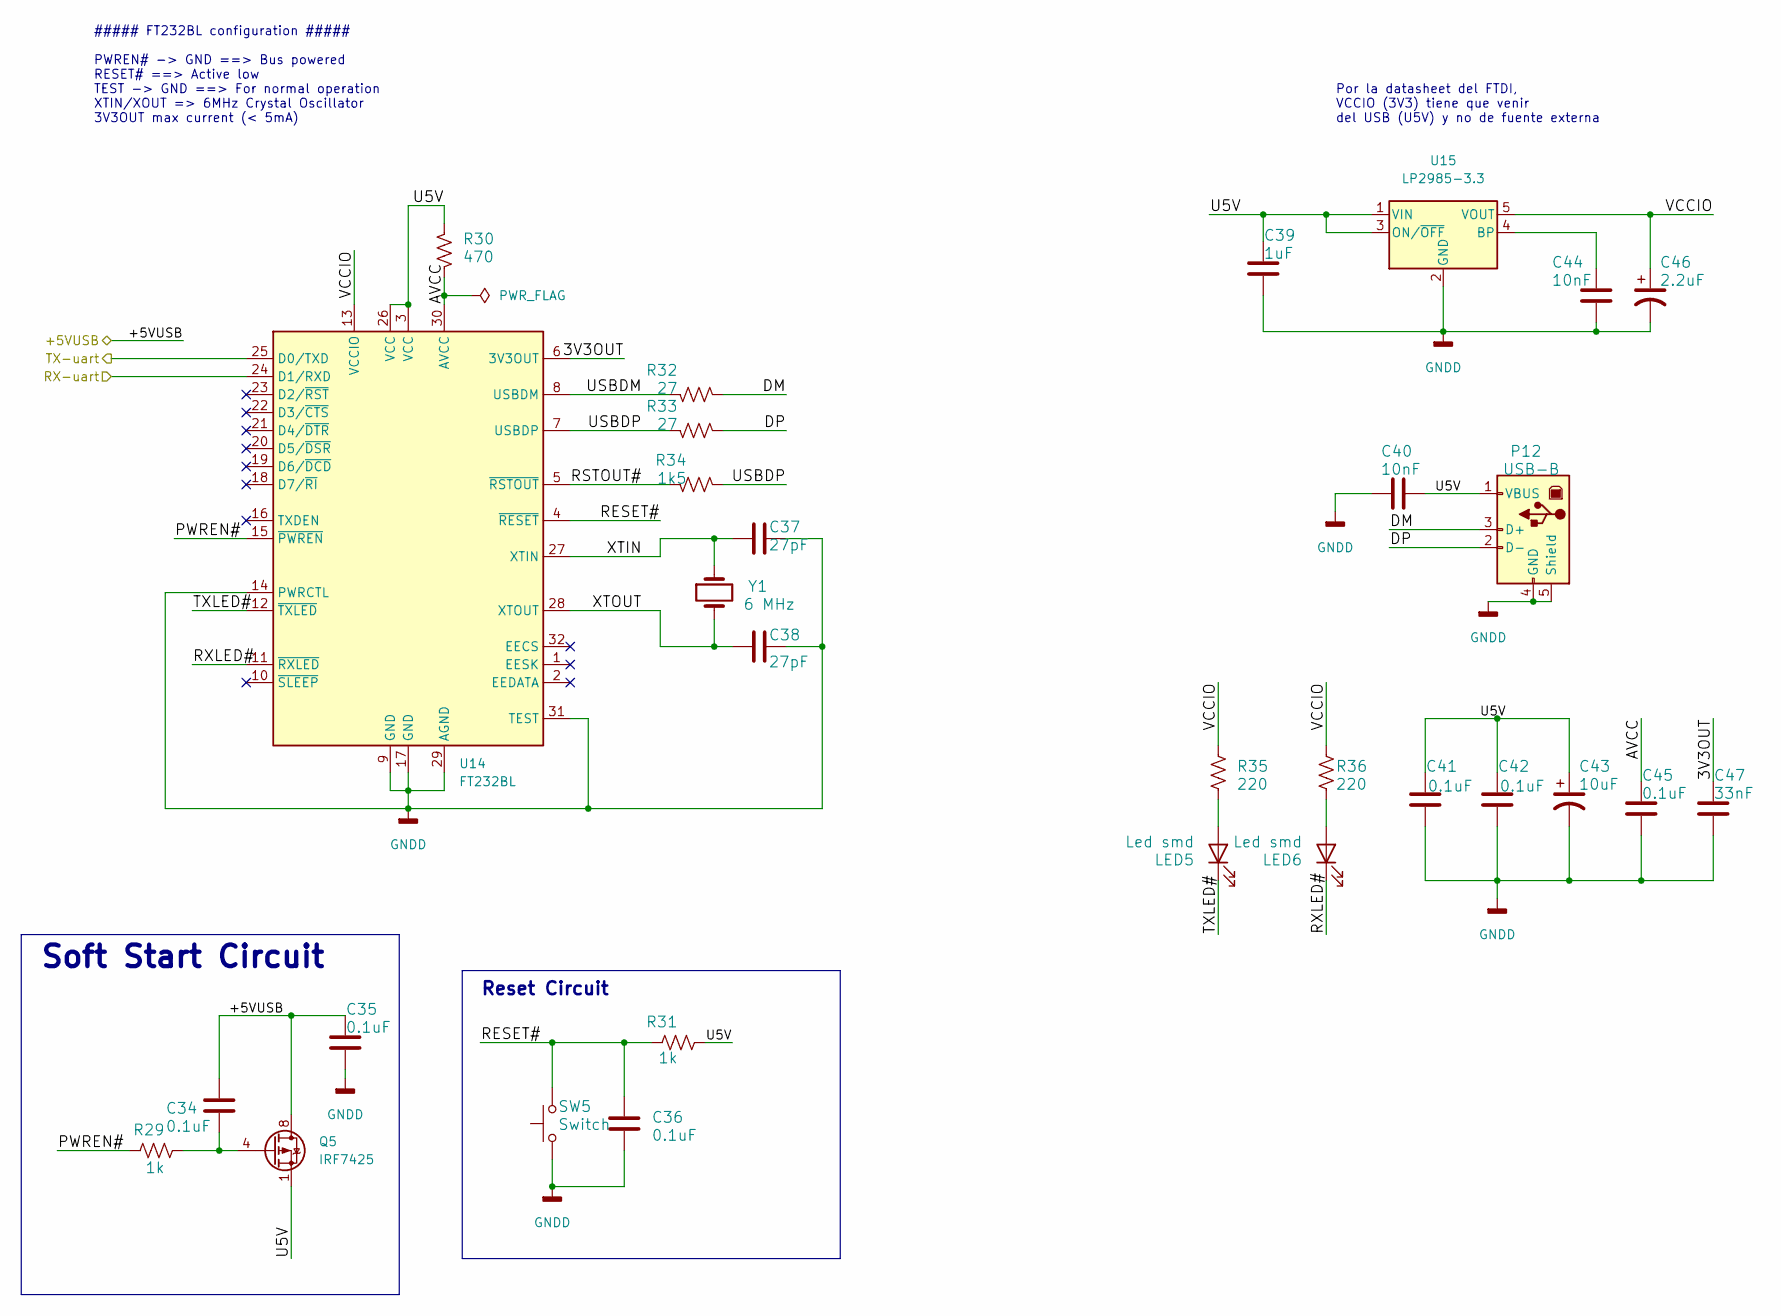
[picture p251: schematic USB-UART.kicad_sch]

Parts:
C34, C35, C36, C41, C42, C45: 0.1uF; C_1206_3216Metric_Pad1.33x1.80mm_HandSolder
C37, C38: 27pF; C_1206_3216Metric_Pad1.33x1.80mm_HandSolder
C39: 1uF; C_1206_3216Metric_Pad1.33x1.80mm_HandSolder
C40, C44: 10nF; C_1206_3216Metric_Pad1.33x1.80mm_HandSolder
C43: 10uF; CP_Radial_D4.0mm_P1.50mm
C46: 2.2uF; CP_Radial_D4.0mm_P2.00mm
C47: 33nF; C_1206_3216Metric_Pad1.33x1.80mm_HandSolder
LED5, LED6: Led smd; D_1206_3216Metric_Pad1.42x1.75mm_HandSolder
P12: USB-B; USB_B_Lumberg_2411_02_Horizontal
Q5: IRF7425; SOIC-8_3.9x4.9mm_P1.27mm
R29, R31: 1k; R_1206_3216Metric_Pad1.30x1.75mm_HandSolder
R30: 470; R_1206_3216Metric_Pad1.30x1.75mm_HandSolder
R32, R33: 27; R_1206_3216Metric_Pad1.30x1.75mm_HandSolder
R34: 1k5; R_1206_3216Metric_Pad1.30x1.75mm_HandSolder
R35, R36: 220; R_1206_3216Metric_Pad1.30x1.75mm_HandSolder
SW5: Switch; SW_PUSH_6mm
U14: FT232BL; LQFP-32_7x7mm_P0.8mm
U15: LP2985-3.3; SOT-23-5
Y1: 6 MHz; Crystal_HC18-U_Vertical

Connections:
/Fuentes/+5VUSB: C34.1, C35.1, Q5.5 (D), Q5.6 (D), Q5.7 (D), Q5.8 (D); also elsewhere on the board
/Placa DSP/Socket Interfaces/SCI-RX: U14.24 (D1/RXD); also elsewhere on the board
/Placa DSP/Socket Interfaces/SCI-TX: U14.25 (D0/TXD); also elsewhere on the board
/Placa DSP/USB-UART/3V3OUT: C47.2, U14.6 (3V3OUT)
/Placa DSP/USB-UART/AVCC: C45.2, R30.1, U14.30 (AVCC)
/Placa DSP/USB-UART/DM: P12.3 (D+), R32.1
/Placa DSP/USB-UART/DP: P12.2 (D-), R33.1
/Placa DSP/USB-UART/PWREN#: R29.1, U14.15 (~PWREN)
/Placa DSP/USB-UART/RESET#: C36.1, R31.1, SW5.2, U14.4 (~RESET)
/Placa DSP/USB-UART/RSTOUT#: R34.2, U14.5 (~RSTOUT)
/Placa DSP/USB-UART/RXLED#: LED6.1 (K), U14.11 (~RXLED)
/Placa DSP/USB-UART/TXLED#: LED5.1 (K), U14.12 (~TXLED)
/Placa DSP/USB-UART/U5V: C39.1, C40.2, C41.2, C42.2, C43.1, P12.1 (VBUS), Q5.1 (S), Q5.2 (S), Q5.3 (S), R30.2, R31.2, U14.3 (VCC), U14.26 (VCC), U15.1 (VIN), U15.3 (ON/~OFF)
/Placa DSP/USB-UART/USBDM: R32.2, U14.8 (USBDM)
/Placa DSP/USB-UART/USBDP: R33.2, R34.1, U14.7 (USBDP)
/Placa DSP/USB-UART/VCCIO: C46.1, R35.1, R36.1, U14.13 (VCCIO), U15.5 (VOUT)
/Placa DSP/USB-UART/XTIN: C37.1, U14.27 (XTIN), Y1.1
/Placa DSP/USB-UART/XTOUT: C38.1, U14.28 (XTOUT), Y1.2
GNDD: C35.2, C36.2, C37.2, C38.2, C39.2, C40.1, C41.1, C42.1, C43.2, C44.2, C45.1, C46.2, C47.1, P12.4 (GND), P12.5 (Shield), SW5.1, U14.9 (GND), U14.14 (PWRCTL), U14.17 (GND), U14.29 (AGND), U14.31 (TEST), U15.2 (GND); also elsewhere on the board
unnamed: C34.2, Q5.4 (G), R29.2
unnamed: C44.1, U15.4 (BP)
unnamed: LED5.2 (A), R35.2
unnamed: LED6.2 (A), R36.2

Notes on the sheet:
Por la datasheet del FTDI, VCCIO (3V3) tiene que venir del USB (U5V) y no de fuente externa
Soft Start Circuit
##### FT232BL configuration ##### PWREN# -> GND ==> Bus powered RESET# ==> Active low TEST -> GND ==> For normal operation XTIN/XOUT => 6MHz Crystal Oscillator 3V3OUT max current (< 5mA)
Reset Circuit
