tomas-tavella/Proyecto-Final/Conversor/Proyecto-KiCAD/Proyecto-KiCAD.kicad_pcb

## KiCad design Conversor/Proyecto-KiCAD/Proyecto-KiCAD.kicad_pcb (continued)

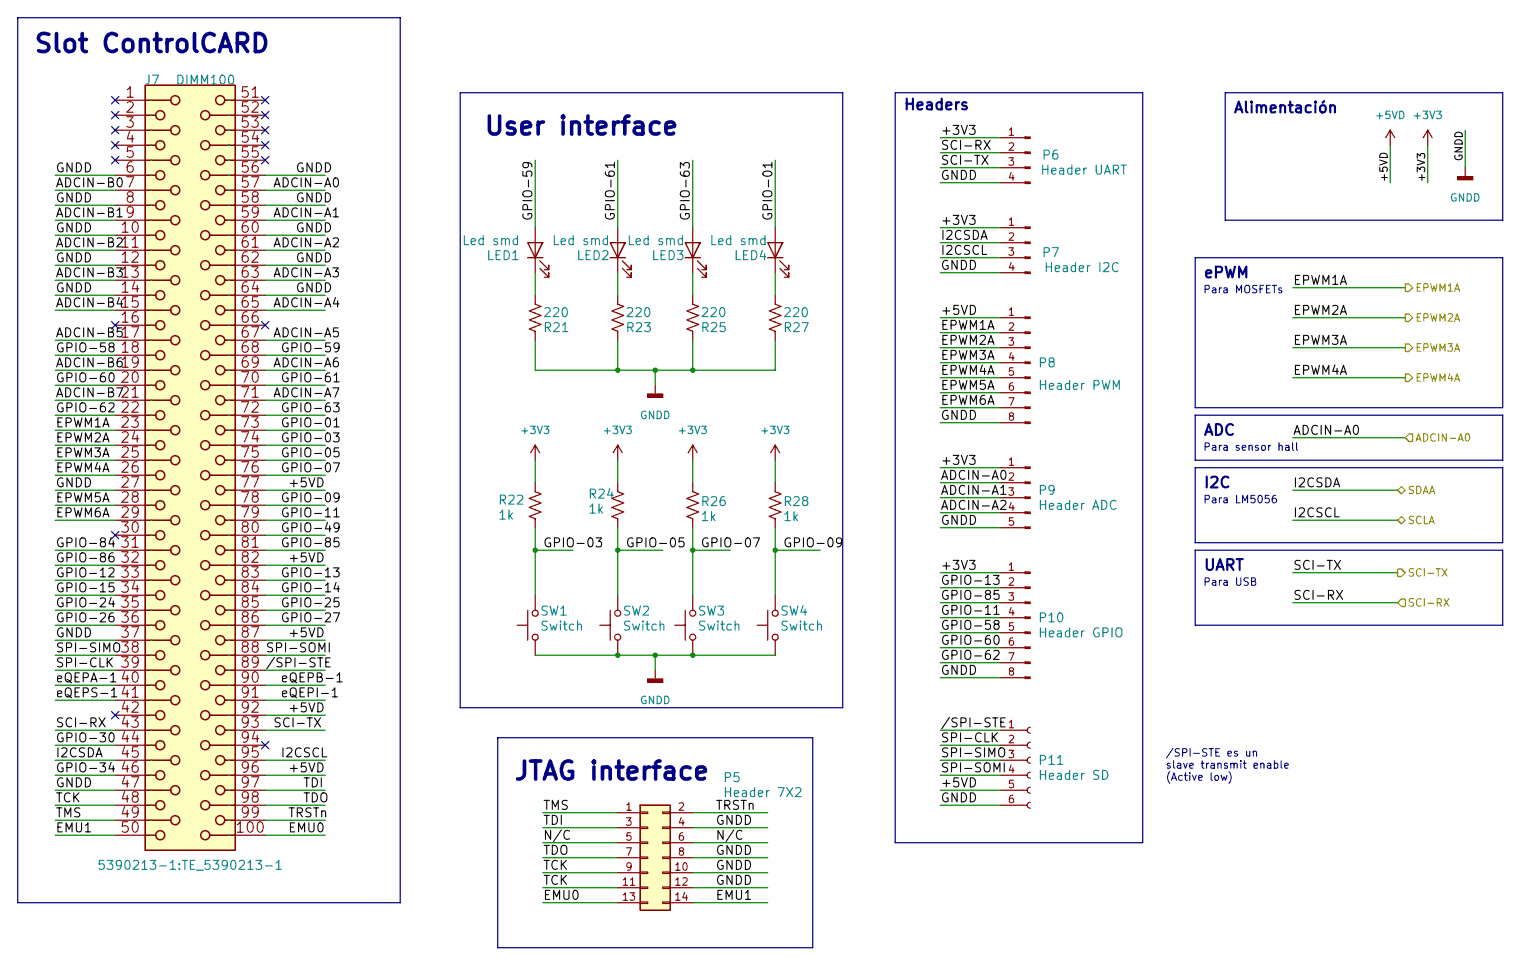
[picture p252: schematic socket-interfaces.kicad_sch]

Parts:
J7: DIMM100; TE_5390213-1
LED1, LED2, LED3, LED4: Led smd; D_1206_3216Metric_Pad1.42x1.75mm_HandSolder
P5: Header 7X2; PinSocket_2x07_P2.54mm_Vertical
P6: Header UART; PinHeader_1x04_P2.54mm_Vertical
P7: Header I2C; PinHeader_1x04_P2.54mm_Vertical
P8: Header PWM; PinHeader_1x08_P2.54mm_Vertical
P9: Header ADC; PinHeader_1x05_P2.54mm_Vertical
P10: Header GPIO; PinHeader_1x08_P2.54mm_Vertical
P11: Header SD; PinSocket_1x06_P2.54mm_Horizontal
R21, R23, R25, R27: 220; R_1206_3216Metric_Pad1.30x1.75mm_HandSolder
R22, R24, R26, R28: 1k; R_1206_3216Metric_Pad1.30x1.75mm_HandSolder
SW1, SW2, SW3, SW4: Switch; SW_PUSH_6mm

Connections:
+3V3: P6.1, P7.1, P9.1, P10.1, R22.2, R24.2, R26.2, R28.2; also elsewhere on the board
+5VD: J7.77 (p77), J7.82 (p82), J7.87 (p87), J7.92 (p92), J7.96 (p96), P8.1, P11.5; also elsewhere on the board
/Drivers y Optos/PWM1: J7.23 (p23), P8.2; also elsewhere on the board
/Drivers y Optos/PWM2: J7.24 (p24), P8.3; also elsewhere on the board
/Drivers y Optos//PWM3: J7.25 (p25), P8.4; also elsewhere on the board
/Drivers y Optos//PWM4: J7.26 (p26), P8.5; also elsewhere on the board
/Placa DSP/Socket Interfaces/ADCIN-A0: J7.57 (p57), P9.2; also elsewhere on the board
/Placa DSP/Socket Interfaces/ADCIN-A1: J7.59 (p59), P9.3
/Placa DSP/Socket Interfaces/ADCIN-A2: J7.61 (p61), P9.4
/Placa DSP/Socket Interfaces/ADCIN-A3: J7.63 (p63)
/Placa DSP/Socket Interfaces/ADCIN-A4: J7.65 (p65)
/Placa DSP/Socket Interfaces/ADCIN-A5: J7.67 (p67)
/Placa DSP/Socket Interfaces/ADCIN-A6: J7.69 (p69)
/Placa DSP/Socket Interfaces/ADCIN-A7: J7.71 (p71)
/Placa DSP/Socket Interfaces/ADCIN-B0: J7.7 (p7)
/Placa DSP/Socket Interfaces/ADCIN-B1: J7.9 (p9)
/Placa DSP/Socket Interfaces/ADCIN-B2: J7.11 (p11)
/Placa DSP/Socket Interfaces/ADCIN-B3: J7.13 (p13)
/Placa DSP/Socket Interfaces/ADCIN-B4: J7.15 (p15)
/Placa DSP/Socket Interfaces/ADCIN-B5: J7.17 (p17)
/Placa DSP/Socket Interfaces/ADCIN-B6: J7.19 (p19)
/Placa DSP/Socket Interfaces/ADCIN-B7: J7.21 (p21)
/Placa DSP/Socket Interfaces/EMU0: J7.100 (p100), P5.13
/Placa DSP/Socket Interfaces/EMU1: J7.50 (p50), P5.14
/Placa DSP/Socket Interfaces/EPWM5A: J7.28 (p28), P8.6
/Placa DSP/Socket Interfaces/EPWM6A: J7.29 (p29), P8.7
/Placa DSP/Socket Interfaces/GPIO-01: J7.73 (p73), LED4.2 (A)
/Placa DSP/Socket Interfaces/GPIO-03: J7.74 (p74), R22.1, SW1.2
/Placa DSP/Socket Interfaces/GPIO-05: J7.75 (p75), R24.1, SW2.2
/Placa DSP/Socket Interfaces/GPIO-07: J7.76 (p76), R26.1, SW3.2
/Placa DSP/Socket Interfaces/GPIO-09: J7.78 (p78), R28.1, SW4.2
/Placa DSP/Socket Interfaces/GPIO-11: J7.79 (p79), P10.4
/Placa DSP/Socket Interfaces/GPIO-12: J7.33 (p33)
/Placa DSP/Socket Interfaces/GPIO-13: J7.83 (p83), P10.2
/Placa DSP/Socket Interfaces/GPIO-14: J7.84 (p84)
/Placa DSP/Socket Interfaces/GPIO-15: J7.34 (p34)
/Placa DSP/Socket Interfaces/GPIO-24: J7.35 (p35)
/Placa DSP/Socket Interfaces/GPIO-25: J7.85 (p85)
/Placa DSP/Socket Interfaces/GPIO-26: J7.36 (p36)
/Placa DSP/Socket Interfaces/GPIO-27: J7.86 (p86)
/Placa DSP/Socket Interfaces/GPIO-30: J7.44 (p44)
/Placa DSP/Socket Interfaces/GPIO-34: J7.46 (p46)
/Placa DSP/Socket Interfaces/GPIO-49: J7.80 (p80)
/Placa DSP/Socket Interfaces/GPIO-58: J7.18 (p18), P10.5
/Placa DSP/Socket Interfaces/GPIO-59: J7.68 (p68), LED1.2 (A)
/Placa DSP/Socket Interfaces/GPIO-60: J7.20 (p20), P10.6
/Placa DSP/Socket Interfaces/GPIO-61: J7.70 (p70), LED2.2 (A)
/Placa DSP/Socket Interfaces/GPIO-62: J7.22 (p22), P10.7
/Placa DSP/Socket Interfaces/GPIO-63: J7.72 (p72), LED3.2 (A)
/Placa DSP/Socket Interfaces/GPIO-84: J7.31 (p31)
/Placa DSP/Socket Interfaces/GPIO-85: J7.81 (p81), P10.3
/Placa DSP/Socket Interfaces/GPIO-86: J7.32 (p32)
/Placa DSP/Socket Interfaces/I2CSCL: J7.95 (p95), P7.3; also elsewhere on the board
/Placa DSP/Socket Interfaces/I2CSDA: J7.45 (p45), P7.2; also elsewhere on the board
/Placa DSP/Socket Interfaces/SCI-RX: J7.43 (p43), P6.2; also elsewhere on the board
/Placa DSP/Socket Interfaces/SCI-TX: J7.93 (p93), P6.3; also elsewhere on the board
/Placa DSP/Socket Interfaces/SPI-CLK: J7.39 (p39), P11.2
/Placa DSP/Socket Interfaces/SPI-SIMO: J7.38 (p38), P11.3
/Placa DSP/Socket Interfaces/SPI-SOMI: J7.88 (p88), P11.4
/Placa DSP/Socket Interfaces/TCK: J7.48 (p48), P5.9, P5.11
/Placa DSP/Socket Interfaces/TDI: J7.97 (p97), P5.3
/Placa DSP/Socket Interfaces/TDO: J7.98 (p98), P5.7
/Placa DSP/Socket Interfaces/TMS: J7.49 (p49), P5.1
/Placa DSP/Socket Interfaces/TRSTn: J7.99 (p99), P5.2
/Placa DSP/Socket Interfaces/eQEPA-1: J7.40 (p40)
/Placa DSP/Socket Interfaces/eQEPB-1: J7.90 (p90)
/Placa DSP/Socket Interfaces/eQEPI-1: J7.91 (p91)
/Placa DSP/Socket Interfaces/eQEPS-1: J7.41 (p41)
/Placa DSP/Socket Interfaces//SPI-STE: J7.89 (p89), P11.1
GNDD: J7.6 (p6), J7.8 (p8), J7.10 (p10), J7.12 (p12), J7.14 (p14), J7.27 (p27), J7.37 (p37), J7.47 (p47), J7.56 (p56), J7.58 (p58), J7.60 (p60), J7.62 (p62), J7.64 (p64), P5.4, P5.8, P5.10, P5.12, P6.4, P7.4, P8.8, P9.5, P10.8, P11.6, R21.2, R23.2, R25.2, R27.2, SW1.1, SW2.1, SW3.1, SW4.1; also elsewhere on the board
unnamed: LED1.1 (K), R21.1
unnamed: LED2.1 (K), R23.1
unnamed: LED3.1 (K), R25.1
unnamed: LED4.1 (K), R27.1

Notes on the sheet:
Para LM5056
UART
Para MOSFETs
Para USB
ADC
/SPI-STE es un slave transmit enable (Active low)
Headers
JTAG interface
Slot ControlCARD
I2C
Para sensor hall
ePWM
User interface
Alimentación

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
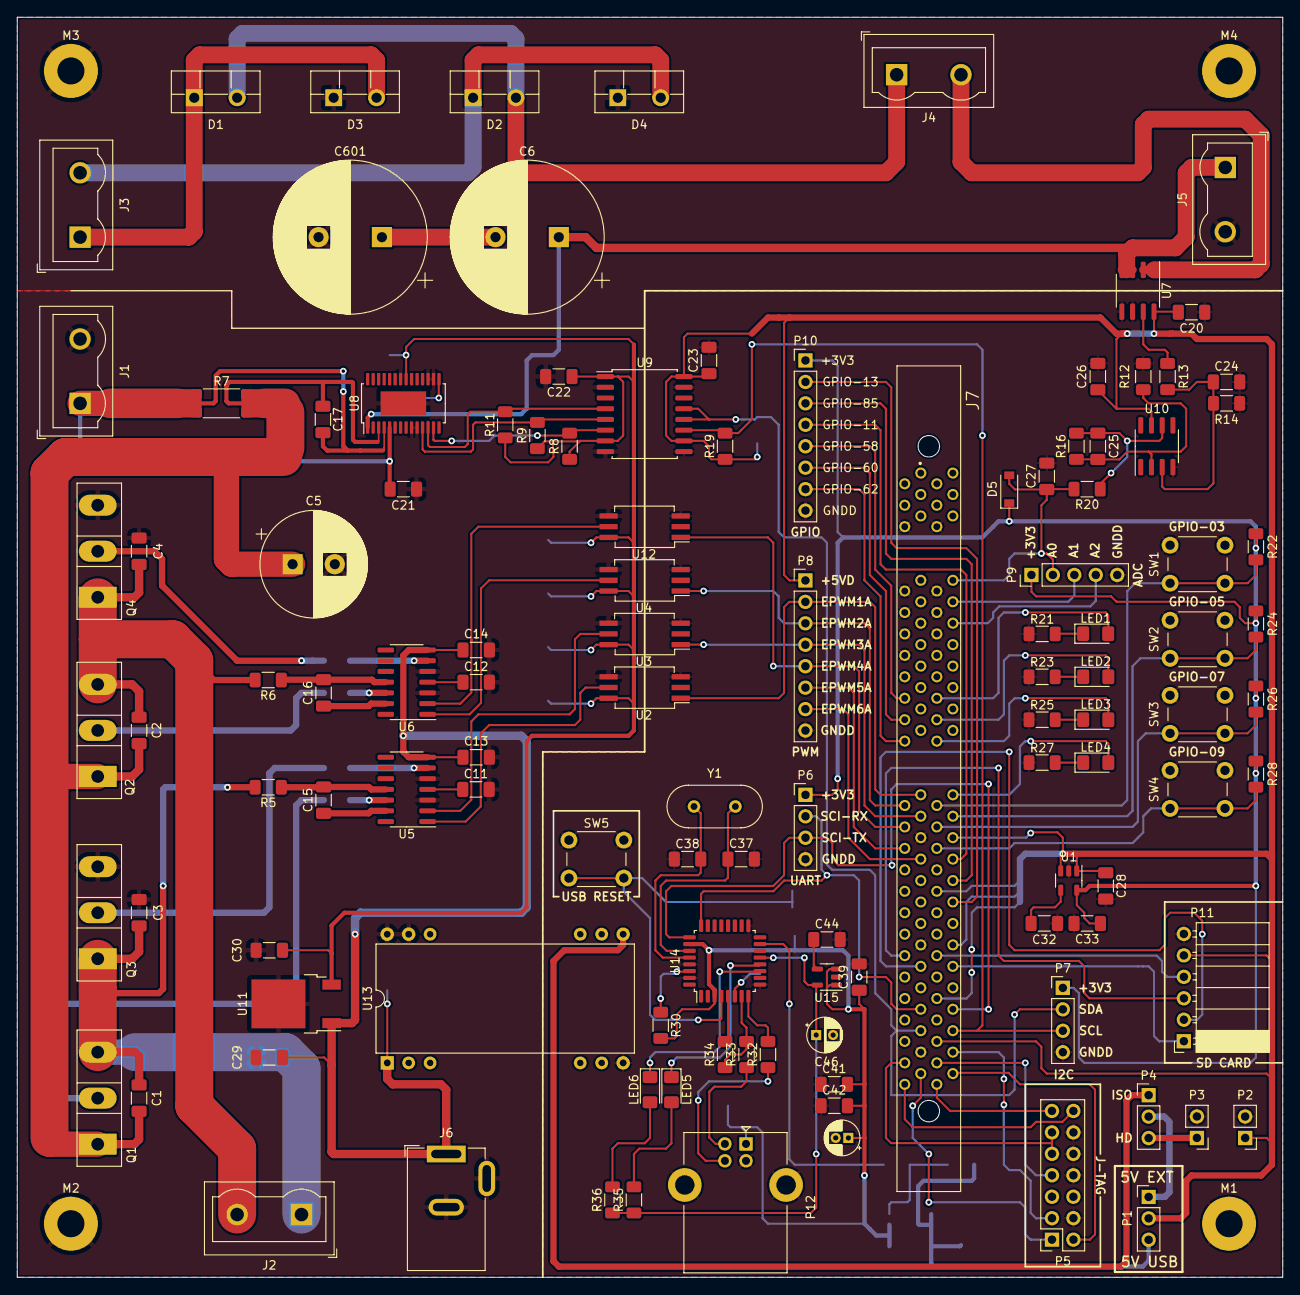
[picture p253: board Proyecto-KiCAD.kicad_pcb from above]

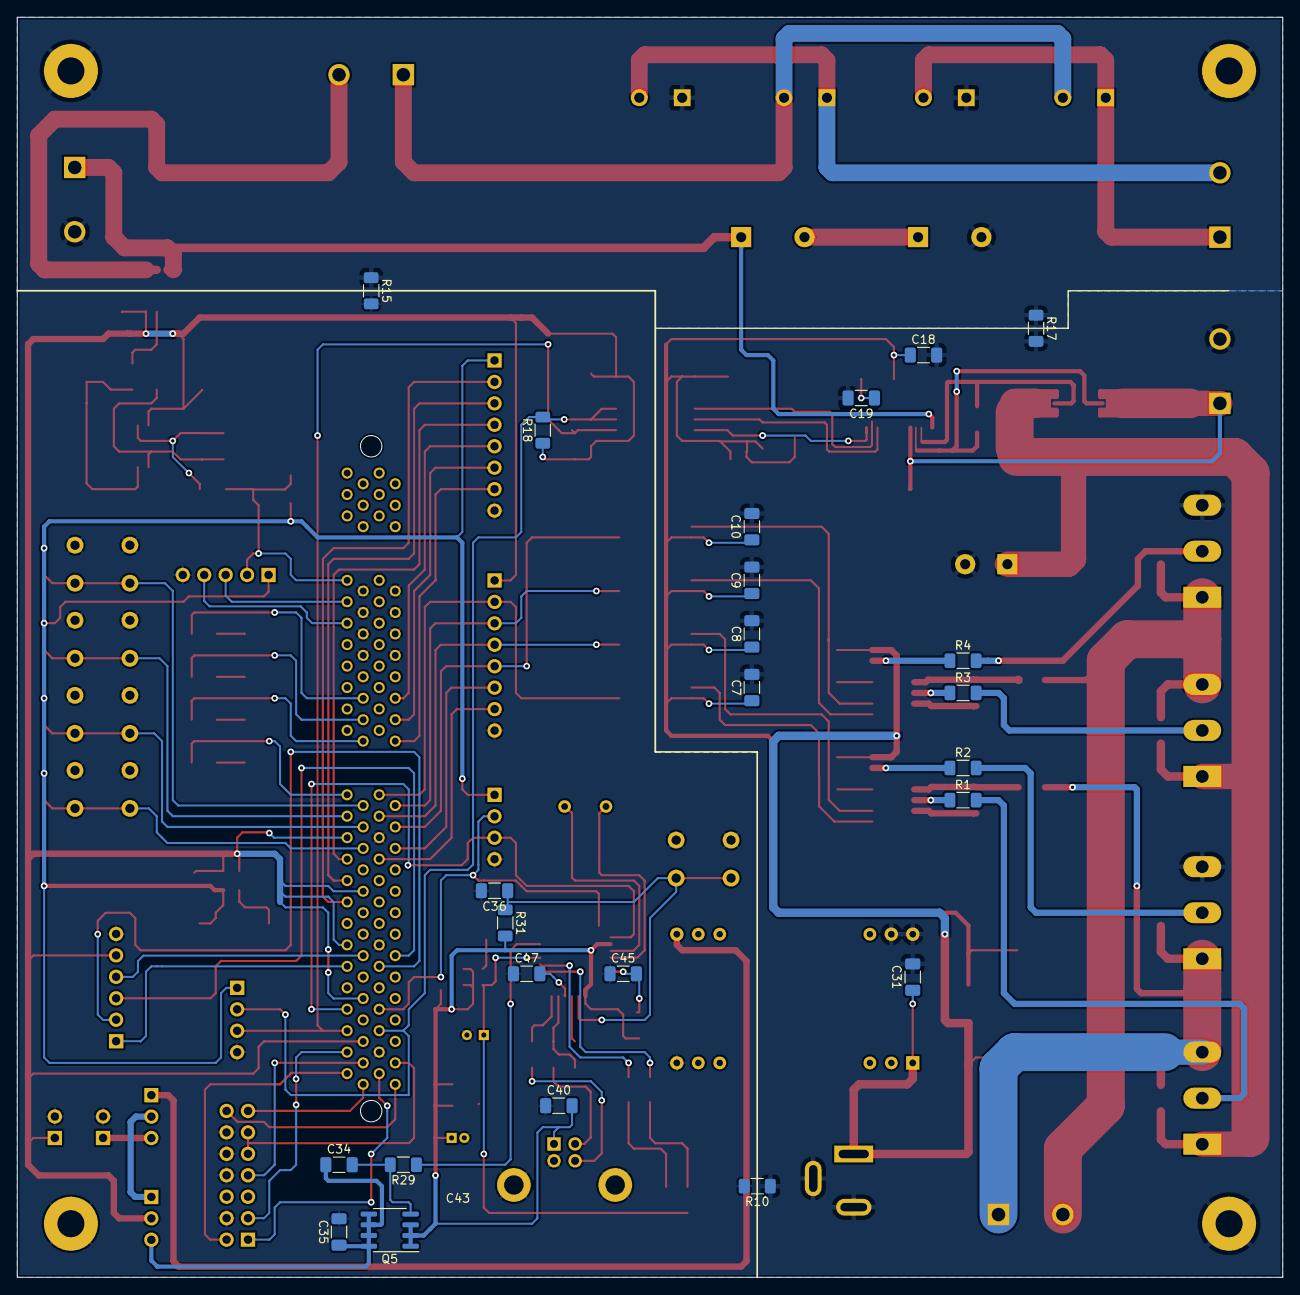
[picture p254: board Proyecto-KiCAD.kicad_pcb from below]

Board: 2 copper layers, 149.9 x 149.2 mm, 144 parts (24 on the bottom side), 110 nets.

Other parts of the board:
M1, M2, M3, M4: MountingHole_3.2mm_M3_Pad

Their connections:
GND1: M2.2; also elsewhere on the board
GND2: M3.3, M4.4; also elsewhere on the board
GNDD: M1.1; also elsewhere on the board
