tomas-tavella/Proyecto-Final/Reference Designs/Placa adaptadora TMS320F28335/Proyecto importado KiCad/principal.kicad_pcb

## KiCad design Reference Designs/Placa adaptadora TMS320F28335/Proyecto importado KiCad/principal.kicad_pcb (2022-06-13)

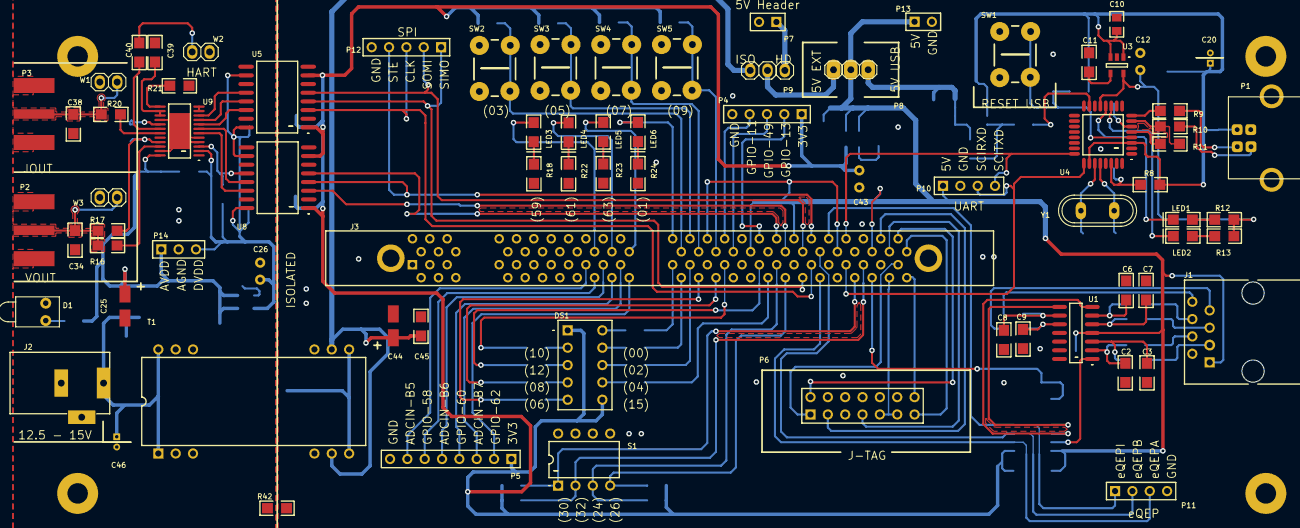
[picture p255: board principal.kicad_pcb from above]

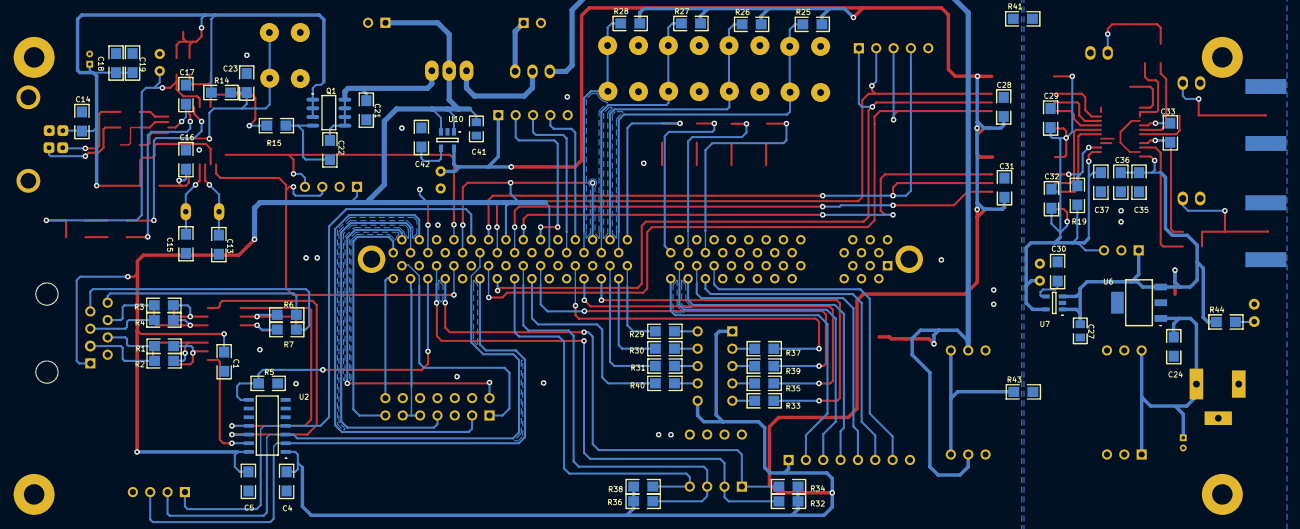
[picture p256: board principal.kicad_pcb from below]

Board: 2 copper layers, 137 parts (60 on the bottom side), 125 nets.

Parts:
C1, C2, C3, C4, C5, C6, C7, C8, C9, C11, C13, C14, C15, C16, C17, C18, C19, C21, C22, C23, C24, C28, C29, C30, C31, C32, C33, C34, C35, C36, C37, C38, C39, C40, C42, C45: Capacitor; C 1206
C10, C27, C41: Capacitor; 0805
C12, C26, C43: Tantalum capacitor; Tantalum
C20, C46: Capacitor polarzado; CAP4x7x1.5mm
C25, C44: Capacitor polarzado; Almn cap
D1: Typical RED GaAs LED; LED-1
DS1: 7.62 mm Black Surface Orange 7-Segment Display: C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; A
J1: RJ-45 connector, 8-pins, ethernet; 15-43-6588
J2: jack
J3: Vertical, DIMM 2P Low Insertion Force, 100 Positi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; 390213-1
LED1: LED red; LED 1206
LED2: LED green; LED 1206
LED3, LED5: Led green; LED 1206
LED4, LED6: Led yellow; LED 1206
P1: Conector USB tipo B; USBB
P2, P3: sma
P4, P12: Header, 5-Pin; HDR1X5
P5: Header, 8-Pin; HDR1X8
P6: Header, 7-Pin, Dual row; HDR2X7
P7, P13: Header, 2-Pin; HDR1X2
P8: Toggle sw
P9: Jumper 2
P10, P11: Header, 4-Pin; HDR1X4
P14: Header, 3-Pin; HDR1X3
Q1: HEXFET Power MOSFET; SO-8_L
R1, R2, R3, R4, R5, R6, R7, R8, R9, R10, R11, R12, R13, R14, R15, R16, R17, R18, R19, R20, R21, R22, R23, R24, R25, R26, R27, R28, R29, R30, R31, R32, R33, R34, R35, R36, R37, R38, R39, R40, R41, R42, R43, R44: Resistencia; R 1206
S1: DIP Switch; DIP-8
SW1, SW2, SW3, SW4, SW5: TACT SW
T1: DIL24
U1: Low Power Quad Operational Amplifier, 14-pin Narr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; M14A_N
U2: IC VOLT-LEVEL TRANSLATOR 14-SOIC; SOIC-14
U3, U7, U10: Single Output Low Noise LDO, 150 mA, Fixed 3.3 V 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; TI-DBV5_N
U4: USB UART Asynchronous Serial Data Transfer Chip, 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; LQFP-32_N
U5, U8: 150 Mbps 6 kVpk Low Power Quad Channels, Digital 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; DW0016A_N
U6: DCY4
U9: DAC8760; PWP
W1, W2, W3: Jumper Wire; Jumper
Y1: Cristal de 6Mhz; Y TRHU

Connections:
3V3: C4.2, C28.1, C31.1, C43.1, DS1.1, DS1.6, P4.1, P5.1, R25.2, R26.2, R27.2, R28.2, R32.1, R34.1, R36.1, R38.1, U2.1, U5.1, U5.7, U8.1, U8.7, U10.5
3V3OUT: C17.2, U4.6
5V: C1.2, C5.1, C41.1, J1.1, J3.77, J3.82, J3.87, J3.92, J3.96, P8.2, P10.1, P13.1, U1.4, U2.14, U10.1, U10.3
5V HEADER: P7.1, P9.3
5V SUPPLY: C44.1, C45.2, P9.1, T1.11, T1.14
5V USB: C21.1, C22.1, P8.1, Q1.5, Q1.6, Q1.7, Q1.8
+VSENSE: R16.2, U9.22
A: U1.1, U2.13
A+: J1.3, R2.2
A-: J1.4, R1.2
ADCIN-B5: J3.17, P5.7
ADCIN-B6: J3.19, P5.5
ADCIN-B7: J3.21, P5.3
AGND: C24.1, C25.2, C26.2, C27.1, C29.2, C30.2, C32.2, C34.2, C35.2, C36.2, C37.2, C38.2, C39.2, C46.2, D1.2, J2.2, J2.3, P2.2, P3.2, P14.2, R21.2, R41.2, R42.2, R43.1, U5.9, U5.15, U6.2, U6.4, U7.2, U8.9, U8.15, U9.1, U9.4, U9.5, U9.11, U9.12, U9.16, U9.23, U9.25, W1.2, W2.2, W3.2
AGND1: R43.2, T1.12, T1.13
ALARM#: R19.2, U8.12, U9.3
AVCC: C16.2, R8.2, U4.30
AVDD: C25.1, C27.2, C35.1, C36.1, P14.1, R44.2, U6.3, U7.1, U7.3, U9.24
B: U1.7, U2.12
B+: J1.5, R4.2
B-: J1.6, R3.2
CLR: U8.14, U9.6
CS#: U8.13, U9.7
DM: P1.2, R9.2
DP: P1.3, R10.2
DVDD: C26.1, C29.1, C32.1, C37.1, P14.3, R19.1, U5.10, U5.16, U7.5, U8.10, U8.16, U9.2
EMU0: J3.100, P6.13
EMU1: J3.50, P6.14
EQEPA-1: J3.40, P11.3, U2.2
EQEPB-1: J3.90, P11.2, U2.3
EQEPI-1: J3.91, P11.1, U2.4
EXTERN 5V: P8.3, P9.2
FA+: C3.2, R2.1, U1.3
FA-: C2.1, R1.1, U1.2
FB+: C7.2, R4.1, U1.5
FB-: C6.1, R3.1, U1.6
FZ+: C9.2, R7.1, U1.10
FZ-: C8.1, R6.1, U1.9
GND: C1.1, C2.2, C3.1, C4.1, C5.2, C6.2, C7.1, C8.2, C9.1, C10.2, C11.2, C12.2, C13.2, C14.2, C15.2, C16.1, C17.1, C18.1, C19.1, C20.2, C21.2, C23.2, C28.2, C31.2, C41.2, C42.2, C43.2, C44.2, C45.1, J1.2, J3.6, J3.8, J3.10, J3.12, J3.14, J3.27, J3.37, J3.47, J3.56, J3.58, J3.60, J3.62, J3.64, P1.0, P1.4, P4.5, P5.8, P6.4, P6.8, P6.10, P6.12, P7.2, P10.2, P11.4, P12.5, P13.2, R5.1, R18.2, R22.2, R23.2, R24.2, R41.1, R42.1, S1.5, S1.6, S1.7, S1.8, SW1.1, SW2.1, SW3.1, SW4.1, SW5.1, T1.10, T1.15, U1.11, U2.7, U3.2, U4.9, U4.14, U4.17, U4.29, U4.31, U5.2, U5.8, U8.2, U8.8, U10.2
GPIO-00: J3.23, R29.1
GPIO-01: J3.73, LED6.1
GPIO-02: J3.24, R30.1
GPIO-03: J3.74, R25.1, SW2.2
GPIO-04: J3.25, R31.1
GPIO-05: J3.75, R26.1, SW3.2
GPIO-06: J3.26, R33.1
GPIO-07: J3.76, R27.1, SW4.2
GPIO-08: J3.28, R35.1
GPIO-09: J3.78, R28.1, SW5.2
GPIO-10: J3.29, R37.1
GPIO-11: J3.79, P4.4
GPIO-12: J3.33, R39.1
GPIO-13: J3.83, P4.2
GPIO-15: J3.34, R40.1
GPIO-24: J3.35, R36.2, S1.3
GPIO-25: J3.85, U8.5
GPIO-26: J3.36, R38.2, S1.4
GPIO-27: J3.86, U8.3
GPIO-30: J3.44, R32.2, S1.1
GPIO-32: J3.45, R34.2, S1.2
GPIO-34: J3.46, R5.2, U2.8
GPIO-49: J3.80, P4.3
GPIO-58: J3.18, P5.6
GPIO-59: J3.68, LED3.1
GPIO-60: J3.20, P5.4
GPIO-61: J3.70, LED4.1
GPIO-62: J3.22, P5.2
GPIO-63: J3.72, LED5.1
HART-IN: C40.1, U9.18
IOUT: R20.2, U9.19
MISO: U5.12, U9.10
MOSI: U5.13, U9.9
NetC11_1: C11.1, U3.4
NetC22_2: C22.2, Q1.4, R15.2
NetC30_1: C30.1, U7.4
NetC33_2: C33.2, U9.17
NetC34_1: C34.1, P2.1, R16.1, R17.1, W3.1
NetC38_1: C38.1, P3.1, R20.1, W1.1
NetC40_2: C40.2, W2.1
NetC42_1: C42.1, U10.4
NetD1_1: D1.1, R44.1
NetDS1_2: DS1.2, R37.2
NetDS1_3: DS1.3, R39.2
NetDS1_4: DS1.4, R35.2
NetDS1_5: DS1.5, R33.2
NetDS1_7: DS1.7, R40.2
NetDS1_8: DS1.8, R31.2
NetDS1_9: DS1.9, R30.2
NetDS1_10: DS1.10, R29.2
NetLED1_1: LED1.1, R12.2
NetLED2_1: LED2.1, R13.2
NetLED3_2: LED3.2, R18.1
NetLED4_2: LED4.2, R22.1
NetLED5_2: LED5.2, R23.1
NetLED6_2: LED6.2, R24.1
NetR21_1: R21.1, U9.13
PWREN#: R15.1, U4.15
REFIN: C39.1, U9.14, U9.15
RESET#: C23.1, R14.1, SW1.2, U4.4
RSTOUT#: R11.1, U4.5
RXD: J3.93, P10.4, U4.24
RXLED#: LED2.2, U4.11
SCIRX-A: J3.43, P10.3, U4.25
SCLK: U5.14, U9.8
SPICLK-A: J3.39, P12.3, U5.3
SPISIMO-A: J3.38, P12.1, U5.4
SPISOMI-A: J3.88, P12.2, U5.5
SPISTE-A: J3.89, P12.4, U8.4
SUPPLY: C24.2, C46.1, J2.1, T1.1, T1.24, U6.1
TCK: J3.48, P6.9, P6.11
TDI: J3.97, P6.3
TDO: J3.98, P6.7
TMS: J3.49, P6.1
TRSTN: J3.99, P6.2
TXLED#: LED1.2, U4.12
U5V: C10.1, C14.1, C18.2, C19.2, C20.1, P1.1, Q1.1, Q1.2, Q1.3, R8.1, R14.2, U3.1, U3.3, U4.3, U4.26
USBDM: R9.1, U4.8
USBDP: R10.1, R11.2, U4.7
VCCIO: C12.1, R12.1, R13.1, U3.5, U4.13
VOUT: C33.1, R17.2, U9.21
XTIN: C13.1, U4.27, Y1.1
XTOUT: C15.1, U4.28, Y1.2
Z: U1.8, U2.11
Z+: J1.7, R7.2
Z-: J1.8, R6.2
