tomas-tavella/Proyecto-Final/Reference Designs/Firmware DSP/Librerias/f2833x/examples/adc_seq_ovd_test/Example_2833xAdcSeq_ovdTest.c

//###########################################################################
//
// FILE:   Example_2833xAdcSeq_ovdTest.c
//
// TITLE:  ADC Seq Override Mode Test Example
//
//! \addtogroup f2833x_example_list
//! <h1> ADC Seq Override Mode Test (add_seq_ovd_test)</h1>
//!
//! In this example, channel A0 is converted forever and logged in a buffer
//! (SampleTable) using sequencer1 in sequence override mode. Sequencer is
//! Sequential mode with sample rate of 1/(3*40ns) = 8.3 MHZ.
//!
//! \b Watch \b Variables \n
//! - SampleTable - Log of converted values.
//! - GPIO34      - Toggles on every ADC sequencer flag
//
//###########################################################################
// $TI Release: F2833x Support Library v2.00.00.00 $
// $Release Date: Thu Dec  7 18:50:20 CST 2017 $
// $Copyright:
// Copyright (C) 2009-2017 Texas Instruments Incorporated - http://www.ti.com/
//
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
//   Redistributions of source code must retain the above copyright 
//   notice, this list of conditions and the following disclaimer.
// 
//   Redistributions in binary form must reproduce the above copyright
//   notice, this list of conditions and the following disclaimer in the 
//   documentation and/or other materials provided with the   
//   distribution.
// 
//   Neither the name of Texas Instruments Incorporated nor the names of
//   its contributors may be used to endorse or promote products derived
//   from this software without specific prior written permission.
// 
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
//
// Included Files
//
#include "DSP28x_Project.h"     // Device Headerfile and Examples Include File

//
// Defines
//

//
// Determine when the shift to right justify the data takes place
// Only one of these should be defined as 1.
// The other two should be defined as 0.
//
#define POST_SHIFT   0  // Shift results after the entire sample table is full

//
// Shift results as the data is taken from the results regsiter
//
#define INLINE_SHIFT 1

#define NO_SHIFT     0  // Do not shift the results

//
// ADC start parameters
//
#if (CPU_FRQ_150MHZ)     // Default - 150 MHz SYSCLKOUT
    //
    // HSPCLK = SYSCLKOUT/2*ADC_MODCLK2 = 150/(2*3)   = 25.0 MHz
    //
    #define ADC_MODCLK 0x3 
#endif
#if (CPU_FRQ_100MHZ)
    //
    // HSPCLK = SYSCLKOUT/2*ADC_MODCLK2 = 100/(2*2)   = 25.0 MHz
    //
    #define ADC_MODCLK 0x2
#endif

//
// ADC module clock = HSPCLK/1      = 25.5MHz/(1)   = 25.0 MHz
//
#define ADC_CKPS   0x0   

//
// S/H width in ADC module periods = 2 ADC cycle
//
#define ADC_SHCLK  0x1 
 
#define AVG        1000  // Average sample limit
#define ZOFFSET    0x00  // Average Zero offset
#define BUF_SIZE   1024  // Sample buffer size

//
// Globals
//
Uint16 SampleTable[BUF_SIZE];

//
// Main
//
void main(void)
{
    Uint16 i;
    Uint16 array_index;

    //
    // Step 1. Initialize System Control:
    // PLL, WatchDog, enable Peripheral Clocks
    // This example function is found in the DSP2833x_SysCtrl.c file.
    //
    InitSysCtrl();

    //
    // Specific clock setting for this example:
    //
    EALLOW;
    SysCtrlRegs.HISPCP.all = ADC_MODCLK;	// HSPCLK = SYSCLKOUT/ADC_MODCLK
    EDIS;

    //
    // Step 2. Initialize GPIO:
    // This example function is found in the DSP2833x_Gpio.c file and
    // illustrates how to set the GPIO to it's default state.
    //
    // InitGpio();  // Skipped for this example
    
    //
    // Enable the pin GPIO34 as output
    //
    EALLOW;
    GpioCtrlRegs.GPBMUX1.bit.GPIO34 = 0;    // GPIO pin
    GpioCtrlRegs.GPBDIR.bit.GPIO34 = 1;     // Output pin
    EDIS;

    //
    // Step 3. Clear all interrupts and initialize PIE vector table:
    // Disable CPU interrupts
    //
    DINT;

    //
    // Initialize the PIE control registers to their default state.
    // The default state is all PIE interrupts disabled and flags
    // are cleared.
    // This function is found in the DSP2833x_PieCtrl.c file.
    //
    InitPieCtrl();

    //
    // Disable CPU interrupts and clear all CPU interrupt flags:
    //
    IER = 0x0000;
    IFR = 0x0000;

    //
    // Initialize the PIE vector table with pointers to the shell Interrupt
    // Service Routines (ISR).
    // This will populate the entire table, even if the interrupt
    // is not used in this example.  This is useful for debug purposes.
    // The shell ISR routines are found in DSP2833x_DefaultIsr.c.
    // This function is found in DSP2833x_PieVect.c.
    //
    InitPieVectTable();

    //
    // Step 4. Initialize all the Device Peripherals:
    // This function is found in DSP2833x_InitPeripherals.c
    //
    // InitPeripherals(); // Not required for this example
    InitAdc();         // For this example, init the ADC

    //
    // Specific ADC setup for this example:
    //
    
    //
    // Sequential mode: Sample rate   = 1/[(2+ACQ_PS)*ADC clock in ns]
    //                      = 1/(3*40ns) =8.3MHz (for 150 MHz SYSCLKOUT)
    //                     = 1/(3*80ns) =4.17MHz (for 100 MHz SYSCLKOUT)
    // If Simultaneous mode enabled: Sample rate=1/[(3+ACQ_PS)*ADC clock in ns]
    //
    AdcRegs.ADCTRL1.bit.ACQ_PS = ADC_SHCLK;
    
    AdcRegs.ADCTRL3.bit.ADCCLKPS = ADC_CKPS;
    AdcRegs.ADCTRL1.bit.SEQ_CASC = 1;     // 1  Cascaded mode
    AdcRegs.ADCCHSELSEQ1.bit.CONV00 = 0x0;
    AdcRegs.ADCTRL1.bit.CONT_RUN = 1;     // Setup continuous run

    AdcRegs.ADCTRL1.bit.SEQ_OVRD = 1;     // Enable Sequencer override feature
    AdcRegs.ADCCHSELSEQ1.all = 0x0; // Initialize all ADC channel selects to A0
    AdcRegs.ADCCHSELSEQ2.all = 0x0;
    AdcRegs.ADCCHSELSEQ3.all = 0x0;
    AdcRegs.ADCCHSELSEQ4.all = 0x0;
    
    //
    // convert and store in 8 results registers
    //
    AdcRegs.ADCMAXCONV.bit.MAX_CONV1 = 0x7;

    //
    // Step 5. User specific code, enable interrupts:
    //

    //
    // Clear SampleTable
    //
    for (i=0; i<BUF_SIZE; i++)
    {
        SampleTable[i] = 0;
    }

    //
    // Start SEQ1
    //
    AdcRegs.ADCTRL2.all = 0x2000;

    for(;;)
    { 
        //
        // Take ADC data and log them in SampleTable array
        //

        //
        // Initialize the array index.  This points to the current
        // location within the SampleTable
        //
        array_index = 0;

        for (i=0; i<(BUF_SIZE/16); i++)
        {
            //
            // Wait for int1
            //
            while (AdcRegs.ADCST.bit.INT_SEQ1== 0)
            {
                
            }
            
            //
            // Set GPIO34 for monitoring  -optional
            //
            GpioDataRegs.GPBSET.bit.GPIO34 = 1;

            AdcRegs.ADCST.bit.INT_SEQ1_CLR = 1;

    #if INLINE_SHIFT
            SampleTable[array_index++]= ( (AdcRegs.ADCRESULT0)>>4);
            SampleTable[array_index++]= ( (AdcRegs.ADCRESULT1)>>4);
            SampleTable[array_index++]= ( (AdcRegs.ADCRESULT2)>>4);
            SampleTable[array_index++]= ( (AdcRegs.ADCRESULT3)>>4);
            SampleTable[array_index++]= ( (AdcRegs.ADCRESULT4)>>4);
            SampleTable[array_index++]= ( (AdcRegs.ADCRESULT5)>>4);
            SampleTable[array_index++]= ( (AdcRegs.ADCRESULT6)>>4);
            SampleTable[array_index++]= ( (AdcRegs.ADCRESULT7)>>4);

    #endif //-- INLINE_SHIFT

    #if NO_SHIFT || POST_SHIFT
            SampleTable[array_index++]= ( (AdcRegs.ADCRESULT0));
            SampleTable[array_index++]= ( (AdcRegs.ADCRESULT1));
            SampleTable[array_index++]= ( (AdcRegs.ADCRESULT2));
            SampleTable[array_index++]= ( (AdcRegs.ADCRESULT3));
            SampleTable[array_index++]= ( (AdcRegs.ADCRESULT4));
            SampleTable[array_index++]= ( (AdcRegs.ADCRESULT5));
            SampleTable[array_index++]= ( (AdcRegs.ADCRESULT6));
            SampleTable[array_index++]= ( (AdcRegs.ADCRESULT7));
    #endif //-- NO_SHIFT || POST_SHIFT

            while (AdcRegs.ADCST.bit.INT_SEQ1== 0)
            {
                
            }
            
            //
            // Clear GPIO34 for monitoring  -optional
            //
            GpioDataRegs.GPBCLEAR.bit.GPIO34 = 1;
            AdcRegs.ADCST.bit.INT_SEQ1_CLR = 1;

    #if INLINE_SHIFT
            SampleTable[array_index++]= ( (AdcRegs.ADCRESULT8)>>4);
            SampleTable[array_index++]= ( (AdcRegs.ADCRESULT9)>>4);
            SampleTable[array_index++]= ( (AdcRegs.ADCRESULT10)>>4);
            SampleTable[array_index++]= ( (AdcRegs.ADCRESULT11)>>4);
            SampleTable[array_index++]= ( (AdcRegs.ADCRESULT12)>>4);
            SampleTable[array_index++]= ( (AdcRegs.ADCRESULT13)>>4);
            SampleTable[array_index++]= ( (AdcRegs.ADCRESULT14)>>4);
            SampleTable[array_index++]= ( (AdcRegs.ADCRESULT15)>>4);

    #endif //-- INLINE_SHIFT

    #if NO_SHIFT || POST_SHIFT
            SampleTable[array_index++]= ( (AdcRegs.ADCRESULT8));
            SampleTable[array_index++]= ( (AdcRegs.ADCRESULT9));
            SampleTable[array_index++]= ( (AdcRegs.ADCRESULT10));
            SampleTable[array_index++]= ( (AdcRegs.ADCRESULT11));
            SampleTable[array_index++]= ( (AdcRegs.ADCRESULT12));
            SampleTable[array_index++]= ( (AdcRegs.ADCRESULT13));
            SampleTable[array_index++]= ( (AdcRegs.ADCRESULT14));
            SampleTable[array_index++]= ( (AdcRegs.ADCRESULT15));
    #endif // -- NO_SHIFT || POST_SHIFT
        }

    #if POST_SHIFT
        //
        // For post shifting, shift the ADC results
        // in the SampleTable buffer after the buffer is full.
        //
        for (i=0; i<BUF_SIZE; i++)
        {
            SampleTable[i] = ((SampleTable[i]) >>4);
        }
    #endif // -- POST_SHIFT

        //
        // Clear GPIO34 for monitoring  -optional
        //
        GpioDataRegs.GPBCLEAR.bit.GPIO34 = 1;
    }
}

//
// End of File
//
