tomas-tavella/Proyecto-Final/Reference Designs/Firmware DSP/Librerias/f2833x/examples/sw_prioritized_interrupts/Example_2833xSWPrioritizedInterrupts.c

//###########################################################################
//
// FILE:	Example_2833xSWPrioritizedInterrupts.c
//
// TITLE:	Software Prioritized Interrupts Example
//
//!  \addtogroup f2833x_example_list
//!  <h1>Software Prioritized Interrupts (sw_prioritized_interrupts)</h1>
//!
//!  For most applications, the hardware prioritizing of the
//!  the PIE module is sufficient.  For applications that need custom
//!  prioritizing, this example illustrates how this can be done
//!  through software.
//!
//!  This program simulates interrupt conflicts by writing to the
//!  PIEIFR registers.  This will cause multiple interrupt requests to come 
//!  into the PIE block at the same time.
//!
//!  The interrupt service routines are software prioritized as per
//!  the table found in the DSP2833x_SWPrioritizedIsrLevels.h file.
//!
//!  \b Running \b the \b Application
//!  -# Before compiling you must set the Global and Group interrupt priorities
//!  in the DSP2833x_SWPrioritizedIsrLevels.h file.
//!  -# Select which test case you'd like to run with the
//!     \#define CASE directive (1-9, default 1).
//!  -# Compile the code, load, and run
//!  -# At the end of each test there is a hard coded breakpoint (ESTOP0).
//!     When code stops at the breakpoint, examine the ISRTrace buffer to
//!     see the order in which the ISR's completed. All PIE interrupts will
//!     be added to the ISRTrace.
//!     The ISRTrace will consist of a list of hex values as shown: \n
//!     0x00wx    <- PIE Group w interrupt x finished first \n
//!     0x00yz    <- PIE Group y interrupt z finished next \n
//!  -# If desired, set a new set of Global and Group interrupt priorities
//!  and repeat the test to see the change.
//!
//!  \b Watch \b Variables \n
//!  - ISRTrace - Trace of ISR's in the order they complete.
//!
//!  After each test, examine this buffer to determine if the ISR's completed 
//!  in the order desired.
//
//###########################################################################
// $TI Release: F2833x Support Library v2.00.00.00 $
// $Release Date: Thu Dec  7 18:50:20 CST 2017 $
// $Copyright:
// Copyright (C) 2009-2017 Texas Instruments Incorporated - http://www.ti.com/
//
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
//   Redistributions of source code must retain the above copyright 
//   notice, this list of conditions and the following disclaimer.
// 
//   Redistributions in binary form must reproduce the above copyright
//   notice, this list of conditions and the following disclaimer in the 
//   documentation and/or other materials provided with the   
//   distribution.
// 
//   Neither the name of Texas Instruments Incorporated nor the names of
//   its contributors may be used to endorse or promote products derived
//   from this software without specific prior written permission.
// 
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
//
// Included Files
//
#include "DSP28x_Project.h"     // Device Headerfile and Examples Include File
#include "DSP2833x_SWPrioritizedIsrLevels.h"

//
// Defines
//
#define TEST 1 // Select a test number: 1 through 10

//
// Defines the interrupts that are used in the PIE for each group
//
#define ISRS_GROUP1  (M_INT1|M_INT2|M_INT4|M_INT5|M_INT6|M_INT7|M_INT8)
#define ISRS_GROUP2  (M_INT1|M_INT2|M_INT3|M_INT4|M_INT5|M_INT6)
#define ISRS_GROUP3  (M_INT1|M_INT2|M_INT3|M_INT4|M_INT5|M_INT6)
#define ISRS_GROUP4  (M_INT1|M_INT2|M_INT3|M_INT4|M_INT5|M_INT6)
#define ISRS_GROUP5  (M_INT1|M_INT2)
#define ISRS_GROUP6  (M_INT1|M_INT2|M_INT3|M_INT4|M_INT5|M_INT6)
#define ISRS_GROUP7  (M_INT1|M_INT2|M_INT3|M_INT4|M_INT5|M_INT6)
#define ISRS_GROUP8  (M_INT1|M_INT2|M_INT5|M_INT6)
#define ISRS_GROUP9  (M_INT1|M_INT2|M_INT3|M_INT4|M_INT5|M_INT6|M_INT7|M_INT8)
#define ISRS_GROUP12 (M_INT1|M_INT2|M_INT3|M_INT4|M_INT5|M_INT7|M_INT8)

//
// This array will be used as a trace to check the order that the
// interrupts were serviced
//
Uint16  ISRTrace[50];
Uint16  ISRTraceIndex;  // used to update an element in the trace buffer

//
// Main
//
void main(void)
{
    Uint16 i;

    //
    // Step 1. Initialize System Control:
    // PLL, WatchDog, enable Peripheral Clocks
    // This example function is found in the DSP2833x_SysCtrl.c file.
    //
    InitSysCtrl();

    //
    // Step 2. Initialize GPIO:
    // This example function is found in the DSP2833x_Gpio.c file and
    // illustrates how to set the GPIO to it's default state.
    //
    // InitGpio();  // Skipped for this example

    //
    // Step 3. Clear all interrupts and initialize PIE vector table:
    // Disable CPU interrupts
    //
    DINT;

    //
    // Initialize PIE control registers to their default state.
    // The default state is all PIE interrupts disabled and flags
    // are cleared.
    // This function is found in the DSP2833x_PieCtrl.c file.
    //
    InitPieCtrl();

    //
    // Disable CPU interrupts and clear all CPU interrupt flags
    //
    IER = 0x0000;
    IFR = 0x0000;

    //
    // Initialize the PIE vector table with pointers to the shell Interrupt
    // Service Routines (ISR).
    // This will populate the entire table, even if the interrupt
    // is not used in this example.  This is useful for debug purposes.
    // The shell ISR routines are found in DSP2833x_DefaultIsr.c.
    // This function is found in DSP2833x_PieVect.c.
    //
    InitPieVectTable();

    //
    // Step 4. Initialize all the Device Peripherals:
    // This function is found in DSP2833x_InitPeripherals.c
    //
    // InitPeripherals(); // Not required for this example

    //
    // Step 5. User specific code, enable interrupts
    //

#if (TEST == 1)
    //
    // Force all group 1 interrupts at once by writing to the PIEIFR1 register
    //

    //
    // Prepare for the test: Disable interrupts
    // Clear the trace buffer, PIE Control Register, CPU IER and IFR registers
    //
    DINT;
    for(i = 0; i < 50; i++)
    {
        ISRTrace[i] = 0;
    }
    ISRTraceIndex = 0;
    InitPieCtrl();
    IER = 0;
    IFR &= 0;

    //
    // Enable the PIE block
    //
    PieCtrlRegs.PIECTRL.bit.ENPIE = 1;

    //
    // Enable PIE group 1 interrupt 1-8
    //
    PieCtrlRegs.PIEIER1.all = 0x00FF;

    //
    // Make sure PIEACK for group 1 is clear (default after reset)
    //
    PieCtrlRegs.PIEACK.all = M_INT1;

    //
    // Enable CPU INT1
    //
    IER |= M_INT1;

    //
    // Force all valid interrupts for Group 1
    //
    PieCtrlRegs.PIEIFR1.all = ISRS_GROUP1;

    //
    // Enable global Interrupts CPU level:
    //
    EINT;                   // Enable Global interrupt INTM

    //
    // Wait for all Group 1 interrupts to be serviced
    //
    while(PieCtrlRegs.PIEIFR1.all != 0x0000 )
    {
        
    }

    //
    // Stop here and check the ISRTrace to determine which order the
    // ISR Routines completed.  The order is dependant on the priority
    // assigned in the DSP2833x_SWPrioritizedIsrLevels.h file
    //
    // The ISRTrace will contain a list of values corresponding to the
    // interrupts serviced in the order they were serviced.
    // For example if the ISRTrace looks like this
    //        0x0014     ISR Group 1 interrupt 4
    //        0x0017     ISR Group 1 interrupt 7
    //        0x0016     ISR Group 1 interrupt 6
    //        0x0015     ISR Group 1 interrupt 5
    //        0x0018     ISR Group 1 interrupt 8
    //        0x0012     ISR Group 1 interrupt 2
    //        0x0011     ISR Group 1 interrupt 1
    //        0x0000     end of trace
    //
    __asm("        ESTOP0");
#endif
#if (TEST == 2)
    //
    // CASE 2: Force all group 2 interrupts at once by writing to the PIEIFR2 
    // register
    //

    //
    // Prepare for the test: Disable interrupts
    // Clear the trace buffer, PIE Control Register, CPU IER and IFR registers
    //
    DINT;
    for(i = 0; i < 50; i++)
    {
        ISRTrace[i] = 0;
    }
    ISRTraceIndex = 0;
    InitPieCtrl();
    IER = 0;
    IFR &= 0;

    //
    // Enable the PIE block
    //
    PieCtrlRegs.PIECTRL.bit.ENPIE = 1;

    //
    // Enable PIE group 2 interrupts 1-8
    //
    PieCtrlRegs.PIEIER2.all = 0x00FF;

    //
    // Enable CPU INT2
    //
    IER |= (M_INT2);

    //
    // Make sure PIEACK for group 2 is clear (default after reset)
    //
    PieCtrlRegs.PIEACK.all = M_INT2;

    //
    // Force all valid interrupts for Group 2
    //
    PieCtrlRegs.PIEIFR2.all = ISRS_GROUP2;

    //
    // Enable Global interrupts
    //
    EINT;

    //
    // Wait for all group 2 interrupts to be serviced
    //
    while(PieCtrlRegs.PIEIFR2.all != 0x0000 )
    {
        
    }

    //
    // Stop here and check the order the ISR's were serviced in the
    // ISRTrace
    //
    __asm("        ESTOP0");

#endif
#if (TEST == 3)
    //
    // CASE 3: Force all group 3 interrupts at once by writing to the PIEIFR3
    // register
    //

    //
    // Prepare for the test: Disable interrupts
    // Clear the trace buffer, PIE Control Register, CPU IER and IFR registers
    //
    DINT;
    for(i = 0; i < 50; i++)
    {
        ISRTrace[i] = 0;
    }
    ISRTraceIndex = 0;
    InitPieCtrl();
    IER = 0;
    IFR &= 0;

    //
    // Enable the PIE block
    //
    PieCtrlRegs.PIECTRL.bit.ENPIE = 1;

    //
    // Enable PIE group 3 interrupts 1-8
    //
    PieCtrlRegs.PIEIER3.all = 0x00FF;

    //
    // Make sure PIEACK for group 3 is clear (default after reset)
    //
    PieCtrlRegs.PIEACK.all = M_INT3;

    //
    // Enable CPU INT3
    //
    IER |= (M_INT3);

    //
    // Force all valid interrupts for Group 3
    //
    PieCtrlRegs.PIEIFR3.all = ISRS_GROUP3;

    //
    // Enable Global interrupts
    //
    EINT;

    //
    // Wait for all group 3 interrupts to be serviced
    //
    while(PieCtrlRegs.PIEIFR3.all != 0x0000 )
    {
        
    }

    //
    // Stop here and check the order the ISR's were serviced in the
    // ISRTrace
    //
    __asm("        ESTOP0");
#endif
#if (TEST == 4)
    //
    // CASE 4: Force all group 4 interrupts at once by writing to the PIEIFR4
    // register
    //

    //
    // Prepare for the test: Disable interrupts
    // Clear the trace buffer, PIE Control Register, CPU IER and IFR registers
    //
    DINT;
    for(i = 0; i < 50; i++)
    {
        ISRTrace[i] = 0;
    }
    ISRTraceIndex = 0;
    InitPieCtrl();
    IER = 0;
    IFR &= 0;

    //
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
    while(PieCtrlRegs.PIEIFR9.all != 0x0000 )
    {
        
    }

    //
    // Stop here and check the order the ISR's were serviced in the
    // ISRTrace
    //
    __asm("        ESTOP0");
#endif
#if (TEST == 8)
    //
    // CASE 8: Force all group 1 and group 2 interrupts at once
    //

    //
    // Setup next test - fire interrupts from Group 1 and Group 2
    //

    //
    // Prepare for the test: Disable interrupts
    // Clear the trace buffer, PIE Control Register, CPU IER and IFR registers
    //
    DINT;
    for(i = 0; i < 50; i++)
    {
        ISRTrace[i] = 0;
    }
    ISRTraceIndex = 0;
    InitPieCtrl();
    IER = 0;
    IFR &= 0;

    //
    // Enable the PIE block
    //
    PieCtrlRegs.PIECTRL.bit.ENPIE = 1;

    //
    // Enable PIE group 1 and group 2 interrupts 1-8
    //
    PieCtrlRegs.PIEIER1.all = 0x00FF;
    PieCtrlRegs.PIEIER2.all = 0x00FF;

    //
    // Make sure PIEACK for group 1 & 2 are clear (default after reset)
    //
    PieCtrlRegs.PIEACK.all = (M_INT3 | M_INT2);

    //
    // Enable CPU INT1 and INT2
    //
    IER |= (M_INT1|M_INT2);

    //
    // Force all valid interrupts for Group 1 and from Group 2
    //
    PieCtrlRegs.PIEIFR1.all = ISRS_GROUP1;
    PieCtrlRegs.PIEIFR2.all = ISRS_GROUP2;

    //
    // Enable Global interrupts
    //
    EINT;

    //
    // Wait for all group 1 and group 2 interrupts to be serviced
    //
    while(PieCtrlRegs.PIEIFR1.all != 0x0000
          || PieCtrlRegs.PIEIFR2.all != 0x0000)
    {

    }

    //
    // Check the ISRTrace to determine which order the ISR Routines completed
    //
    __asm("        ESTOP0");

#endif
#if (TEST == 9)
    //
    // CASE 9: Force all group 1 and group 2 and group 3 interrupts at once
    //

    //
    // Prepare for the test: Disable interrupts
    // Clear the trace buffer, PIE Control Register, CPU IER and IFR registers
    //
    DINT;
    for(i = 0; i < 50; i++)
    {
        ISRTrace[i] = 0;
    }
    ISRTraceIndex = 0;
    InitPieCtrl();
    IER = 0;
    IFR &= 0;

    //
    // Enable the PIE block
    //
    PieCtrlRegs.PIECTRL.bit.ENPIE = 1;

    //
    // Enable PIE group 1, 2 and 3 interrupts 1-8
    //
    PieCtrlRegs.PIEIER1.all = 0x00FF;
    PieCtrlRegs.PIEIER2.all = 0x00FF;
    PieCtrlRegs.PIEIER3.all = 0x00FF;

    //
    // Make sure PIEACK for group 1, 2 & 3 are clear (default after reset)
    //
    PieCtrlRegs.PIEACK.all = (M_INT3|M_INT2|M_INT3);

    //
    // Enable CPU INT1, INT2 & INT3
    //
    IER |= (M_INT1|M_INT2|M_INT3);

    //
    // Force all valid interrupts for Group1, 2 and 3
    //
    PieCtrlRegs.PIEIFR1.all = ISRS_GROUP1;
    PieCtrlRegs.PIEIFR2.all = ISRS_GROUP2;
    PieCtrlRegs.PIEIFR3.all = ISRS_GROUP3;

    //
    // Enable Global interrupts
    //
    EINT;

    //
    // Wait for all group 1 and group 2 and group 3 interrupts to be serviced
    //
    while(PieCtrlRegs.PIEIFR1.all != 0x0000
    || PieCtrlRegs.PIEIFR2.all != 0x0000
    || PieCtrlRegs.PIEIFR3.all != 0x0000)
    {
        
    }

    //
    // Check the ISRTrace to determine which order the ISR Routines completed
    //
    __asm("        ESTOP0");
#endif
#if (TEST == 10)
    //
    // CASE 10: Force all used PIE interrupts at once
    //

    //
    // Prepare for the test: Disable interrupts
    // Clear the trace buffer, PIE Control Register, CPU IER and IFR registers
    //
    DINT;
    for(i = 0; i < 50; i++)
    {
        ISRTrace[i] = 0;
    }
    ISRTraceIndex = 0;
    InitPieCtrl();
    IER = 0;
    IFR &= 0;

    //
    // Enable the PIE block
    //
    PieCtrlRegs.PIECTRL.bit.ENPIE = 1;

    //
    // Enable all PIE group interrupts 1-8
    //
    PieCtrlRegs.PIEIER1.all = 0x00FF;
    PieCtrlRegs.PIEIER2.all = 0x00FF;
    PieCtrlRegs.PIEIER3.all = 0x00FF;
    PieCtrlRegs.PIEIER4.all = 0x00FF;
    PieCtrlRegs.PIEIER5.all = 0x00FF;
    PieCtrlRegs.PIEIER6.all = 0x00FF;
    PieCtrlRegs.PIEIER9.all = 0x00FF;

    //
    // Make sure PIEACK for group 1, 2, 3, 4, 5, 6 and 9 are clear
    // (default after reset)
    //
    PieCtrlRegs.PIEACK.all = (M_INT1|M_INT2|M_INT3|M_INT4|M_INT5|
                              M_INT6|M_INT9);

    //
    // Enable CPU INT1, INT2, INT3, INT4, INT5, INT6 and INT9
    //
    IER |= (M_INT1|M_INT2|M_INT3|M_INT4|M_INT5|M_INT6|M_INT9);

    //
    // Force all valid interrupts for all PIE groups
    //
    PieCtrlRegs.PIEIFR1.all = ISRS_GROUP1;
    PieCtrlRegs.PIEIFR2.all = ISRS_GROUP2;
    PieCtrlRegs.PIEIFR3.all = ISRS_GROUP3;
    PieCtrlRegs.PIEIFR4.all = ISRS_GROUP4;
    PieCtrlRegs.PIEIFR5.all = ISRS_GROUP5;
    PieCtrlRegs.PIEIFR6.all = ISRS_GROUP6;
    PieCtrlRegs.PIEIFR9.all = ISRS_GROUP9;

    //
    // Enable Global interrupts - CPU level
    //
    EINT;

    //
    // Wait for all group interrupts to be serviced
    //
    while(PieCtrlRegs.PIEIFR1.all != 0x0000
    || PieCtrlRegs.PIEIFR2.all != 0x0000
    || PieCtrlRegs.PIEIFR3.all != 0x0000
    || PieCtrlRegs.PIEIFR4.all != 0x0000
    || PieCtrlRegs.PIEIFR5.all != 0x0000
    || PieCtrlRegs.PIEIFR6.all != 0x0000
    || PieCtrlRegs.PIEIFR9.all != 0x0000 )
    {
        
    }

    //
    // Check the ISRTrace to determine which order the ISR Routines completed
    //
    __asm("        ESTOP0");
#endif
}

//
// End of File
//
