tomas-tavella/Proyecto-Final/Reference Designs/Firmware DSP/Librerias/f2833x/examples/sw_prioritized_interrupts/Example_2833xSWPrioritizedDefaultIsr.c

//###########################################################################
//
// FILE:    Example_2833xSWPrioritizedDefaultIsr.c
//
// TITLE:   DSP2833x Device Default Software Prioritized Interrupt 
//          Service Routines.
//
//          This file is based on the standard 
//          DSP2833x_SWPrioritizedDefaultIsr.c. The ISR routines have been
//          modified slightly to provide a trace mechanism used for this 
//          example
//
//###########################################################################
// $TI Release: F2833x Support Library v2.00.00.00 $
// $Release Date: Thu Dec  7 18:50:20 CST 2017 $
// $Copyright:
// Copyright (C) 2009-2017 Texas Instruments Incorporated - http://www.ti.com/
//
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
//   Redistributions of source code must retain the above copyright 
//   notice, this list of conditions and the following disclaimer.
// 
//   Redistributions in binary form must reproduce the above copyright
//   notice, this list of conditions and the following disclaimer in the 
//   documentation and/or other materials provided with the   
//   distribution.
// 
//   Neither the name of Texas Instruments Incorporated nor the names of
//   its contributors may be used to endorse or promote products derived
//   from this software without specific prior written permission.
// 
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
//
// Included Files
//
#include "DSP28x_Project.h"     // Device Headerfile and Examples Include File
#include "DSP2833x_SWPrioritizedIsrLevels.h"

//
// Defined in the Example_28xSWPrioritizedInterrupts.c file
// for this example only
//
extern Uint16 ISRTrace[50];
extern Uint16 ISRTraceIndex;

//
// Global used for ISR delays
//
Uint16 i;

//
// INT13_ISR - INT13 or CPU-Timer1 is connected to INT13 of CPU 
// (use MINT13 mask): Note CPU-Timer1 is reserved for TI use, however XINT13
// ISR can be used by the user.
//
#if (INT13PL != 0)
__interrupt void 
INT13_ISR(void)
{
    IER |= MINT13;                 // Set "global" priority
    EINT;

    //
    // Insert ISR Code here
    //

    //
    // Next two lines for debug only to halt the processor here
    // Remove after inserting ISR Code
    //
    __asm ("      ESTOP0");
    for(;;);
}
#endif

//
// INT14_ISR - CPU-Timer2 is connected to INT14 of CPU (use MINT14 mask)
//
#if (INT14PL != 0)
__interrupt void 
INT14_ISR(void)
{
    IER |= MINT14;                  // Set "global" priority
    EINT;

    //
    // Insert ISR Code here
    //

    //
    // Next two lines for debug only to halt the processor here
    // Remove after inserting ISR Code
    //
    __asm ("      ESTOP0");
    for(;;);
}
#endif

//
// DATALOG_ISR - Datalogging interrupt is connected to int15 of CPU
// (use MINT15 mask)
//
#if (INT15PL != 0)
__interrupt void 
DATALOG_ISR(void)
{
	IER |= MINT15;                 // Set "global" priority
	EINT;

  	// Insert ISR Code here.......

    // Next two lines for debug only to halt the processor here
    // Remove after inserting ISR Code
    __asm ("      ESTOP0");
    for(;;);
}
#endif

//
// RTOSINT_ISR - RTOS interrupt is connected to int16 of CPU (use MINT16 mask)
//
#if (INT16PL != 0)
__interrupt void 
RTOSINT_ISR(void)
{
    IER |= MINT16;                 // Set "global" priority
    EINT;

    //
    // Insert ISR Code here
    //

    //
    // Next two lines for debug only to halt the processor here
    // Remove after inserting ISR Code
    //
    __asm ("      ESTOP0");
    for(;;);
}
#endif

//
// EMUINT_ISR - Emulation interrupt is connected to EMUINT of CPU 
// (non-maskable)
//
__interrupt void
EMUINT_ISR(void)
{
    EINT;

    //
    // Insert ISR Code here
    //

    //
    // Next two lines for debug only to halt the processor here
    // Remove after inserting ISR Code
    //
    __asm ("      ESTOP0");
    for(;;);
}

//
// NMI_ISR - Non-maskable interrupt is connected to NMI of CPU (non-maskable)
//
__interrupt void
NMI_ISR(void)
{
    EINT;

    //
    // Insert ISR Code here
    //

    //
    // Next two lines for debug only to halt the processor here
    // Remove after inserting ISR Code
    //
    __asm ("      ESTOP0");
    for(;;);
}

//
// ILLEGAL_ISR - Illegal operation TRAP is connected to ITRAP of CPU 
// (non-maskable)
//
__interrupt void
ILLEGAL_ISR(void)
{
    EINT;

    //
    // Insert ISR Code here
    //

    //
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
    PieCtrlRegs.PIEACK.all = 0xFFFF;   // Enable PIE interrupts
    __asm("  NOP");
    EINT;

    //
    // Insert ISR Code here
    //
    for(i = 1; i <= 10; i++)
    {
        
    }

    //
    // Restore registers saved
    //
    DINT;
    PieCtrlRegs.PIEIER12.all = TempPIEIER;

    //
    // Add ISR to Trace
    //
    ISRTrace[ISRTraceIndex] = 0x0128;
    ISRTraceIndex++;
}
#endif

//
// Catch All Default ISRs
//

//
// PIE_RESERVED - 
//
__interrupt void
PIE_RESERVED(void)
{
    __asm ("      ESTOP0");
    for(;;);
}

//
// INT_NOTUSED_ISR - 
//
__interrupt void 
INT_NOTUSED_ISR(void)
{
    __asm ("      ESTOP0");
    for(;;);
}

//
// rsvd_ISR - 
//
__interrupt void
rsvd_ISR(void)
{
    __asm ("      ESTOP0");
    for(;;);
}

//
// End of File
//
