tomas-tavella/Proyecto-Final/(commit log)

2022-03-07 Comenzar el intento de simular en Simscape
    Estan implementados generadores de PWM para las gates de cada IGBT, pero no anda la simulacion al correrla (alguna derivada infinita de corriente o tension).
2022-03-07 Mas intentos de arreglar la simulacion
    Cambio a PWM con bloque de delay por cantidad de muestras. Probe con capacitor snubber y diodo freewheel y no arreglo el problema.
2022-03-15 Agregar archivo con fuentes para informe
    Un archivo de texto para ir agregando los libros y otros documentos que voy usando para sacar informacion (para recordar al momento de hacer el informe).
2022-03-16 Actualizar la simulacion, usando MOSFETs
    Sin Lr, Lf y los capacitores de los MOSFET, anda el circuito y puedo generar tension DC a la salida. Si pongo esos elementos no simula.
2022-03-18 Finalmente funciona la simulacion
    Estaba mal el tiempo de muestra en el solver de Simscape y por eso no se conmutaban los MOSFETs.
    Faltaria la parte de hacer un control del desfase entre patas (con un PID o algo asi) para regular la potencia de salida.
2022-03-22 Pruebas para intentar hacer un control del conversor
    Tambien pase el generador de PWM a un subsitema que tiene como entrada el % de desfase de las patas del puente.
2022-03-24 Intento de control con PID
    No funciona porque la planta (conversor) no es lineal. Tambien puse todo el conversor como un subsistema.
2022-03-28 Agregar lo charlado con Jorge
    Filtro pasabajo de segundo orden para filtrar la corriente que circula por la pila.
    Bateria a la salida para mantener la tension como si hubiera un bus de DC (no estoy seguro si anda del todo).
    Tambien aumente 10 veces el valor del inductor de salida para mejorar el ripple de Iout.
2022-03-31 Ponerle valores basados en mis datos al conversor
    Agregado un pdf con las cuentas en hoja para obtener los valores que estan en la simulacion. Parece tener un DC secundario efectivo de alrededor de 60% como calcule, pero falta hacer mas verificaciones del funcionamiento.
    Para la pila use una aproximacion lineal de la verdadera Horizon H-300.
2022-04-04 Funciona la variacion de fase para modificar Iout
    La solucion era que el bloque de delay tenia un limite en 100 muestras de delay, simplemente lo cambie a 2500.
2022-04-04 Cambiar valores de los MOSFET a los de los IRFP150
    Agregadas datasheets de IRFP150, 240 y 250 de Vishay (todos se consiguen en negocios como Elemon y SyC)
2022-04-06 Cambiar valores de diodos a los del MUR1620CT
    Agregada tambien la datasheet del MUR1620CT, un paquete de dos diodos superfast con catodo comun.
2022-04-07 Agregar diseños de referencia de plaqueta y lista de componentes seleccionados
    Tambien se cambio la eleccion de diodo de MUR1620CT a MUR1640CT porque los 200V de Vrmax del 1620 son muy bajos para los 150V de la onda cuadrada del secundario.
    [Esquematico de componentes.SchLib, Etapa de potencia.PrjPcb, Footprints.PcbLib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]
2022-04-11 Agregar algunos componentes faltantes
    - Sensor I/V/P LM5056A y su datasheet
    - Idea general del isolator
2022-04-12 Agregar las dos posibilidades de isolators
2022-04-15 Agregar el driver aislado UCC2154x con su datasheet
2022-04-18 Agregar alternativa para el driver a la lista
2022-04-20 Agregar un diagrama de bloques esquematico de Ycircuit
    [Esquematico.sch]
2022-04-22 Empezar archivo de KiCAD del proyecto
    Se agrego una biblioteca con los componentes que se van a utilizar.
    [Proyecto-KiCAD.kicad_pcb, Proyecto-KiCAD.kicad_sch]
2022-04-29 Importar esquematicos y PCBs de referencia a KiCAD
    [11386.stp, 1206 SMD Capacitor.STEP, 1206 SMD Resistor.STEP, 12664.stp, 14062.stp, 4186.stp, 6239.stp, DIP-14-HC7400.STEP]
2022-04-29 Comenzar el diseño de la plaqueta en KiCAD
    - Empece a ver el diseño de los drivers para los MOSFETs
    - Agregue la datasheet de la fuente aislada TRACO
    - Hay que leer la nota de aplicacion para el diseño del circuito de bootstrap a la salida y elegir Cboot, Rboot y Dboot
    [Diseno_referencia.kicad_pcb, Proyecto-KiCAD.kicad_sch]
2022-05-02 Completados (preliminarmente) los circuitos de los drivers
    -Todos los componentes puestos y conectados en el esquematico (valores preliminares).
    -Agregadas un par de datasheets de diodos del circuito del driver.
    [Proyecto-KiCAD.kicad_sch]
2022-05-03 Continuar con el esquematico del conversor
    -Completada el lado del primario + emprolijado un poco
    -Hay que ver los diodos del secundario, porque los MUR1640CT son catodo comun y requeriria alguno de anodo comun para la parte de abajo del puente.
    [Proyecto-KiCAD.kicad_sch]
2022-05-04 Terminar el esquematico del conversor
    - Arrancado el esquematico de los sensores de tension/corriente/potencia
    - Agregado el sensor Hall (ACS709) a la biblioteca de KiCAD y su datasheet
    - Agregada datasheet de diodos MUR860 y SF86
    - Mandado mail a Elemon consultando stock de diodos y transistores
    [Proyecto-KiCAD.kicad_sch, Sensores.kicad_sch]
2022-05-05 Comenzar con la conexion del LM5056A
    - Hay que ver el valor de la resistencia shunt RS
    - Fijarse si se puede poner los sensores en un archivo distinto
    [Proyecto-KiCAD.kicad_sch, Sensores.kicad_sch]
2022-05-06 Continuar la conexion del esuqematico de sensores
    - Agregado y leido un tutorial de I2C de TI
    - Pasar de conexiones a la sheet auxiliar -> Global labels
    - Aregada la datasheet del DSP que faltaba
    [Proyecto-KiCAD.kicad_sch, Sensores.kicad_sch]
2022-05-07 Reestructurar carpetas y corregir nombres de archivos
    [11386.stp, 1206 SMD Capacitor.STEP, 1206 SMD Resistor.STEP, 12664.stp, 14062.stp, 4186.stp, 6239.stp, DIP-14-HC7400.STEP]
2022-05-09 Seguir con el esquematico de los sensores
    - Terminadas las conexiones del LM5056A para Iin/Vin/Vout
    - Para el sensor de efecto hall ACS709, falta el acondicionamiento:
    - La tension de salida para 0A (Quiescent output voltage) es Vcc/2=2.5V.
    - Para X20BB, 4.5A (Imax+10%) se traducen a 252mV y 344 valores del ADC
    (osea de 2.5V a 2.752V).
    - Para X6BB, 4.5A se traducen a 474mV y 647 valores del ADC.
    (osea de 2.5V a 2.974V)
    - Preguntar si conviene restarle 2.5V y luego amplificar la señal a los
    3V del ADC para aumentar la resolucion, o quedarse con los 250/500 mV.
    [Proyecto-KiCAD.kicad_sch, Sensores.kicad_sch]
2022-05-11 Casi terminada la parte de sensores (faltan valores)
    - Faltan valores del circuito de acondicionamiento del ACS709 (difference amp.).
    - Ver si se usa el mismo TLC2272 que en el diseño de referencia (agregada su datasheet).
    - Agregada la bibliografia usada para entender el circuito de acondicionamiento.
    - Agregadas las footprints de los integrados.
    - Creada la sheet para las fuentes de alimentación.
    [Fuentes.kicad_sch, Proyecto-KiCAD.kicad_sch, Sensores.kicad_sch]
2022-05-12 Completar las fuentes aisladas del lado digital
    - Falta hacer las fuentes del lado de potencia (sin las TRACO).
    - Se tiene que tomar la entrada de 12V-18V y pasarla por un regulador de 15V.
    - Despues esa salida de 15V se pasa por un regulador que la baje a 5V.
    - Agregadas datasheets y notas:
    - Datasheets de regulador LM1117 para pasar de 5V a 3.3V para alimentar el DSP.
    - Notas de aplicacion de la fuente TRACO y explicaciones de corrientes sink y source.
    - Hay que ver las cosas que me tiene que pasar Jorge de la alimentacion del DSP.
    [Fuentes.kicad_sch, Proyecto-KiCAD.kicad_sch, Sensores.kicad_sch]
2022-05-13 Seguir el trabajo en el esquematico de las fuentes
    - Agregado un resumen de los consumos de corriente de todos los
    integrados.
    - Agregado un regulador para obtener +1.8VD, que al final no es
    necesario porque la plaqueta del DSP se alimenta con 3.3 y 5
    aparentemente (preguntar).
    - Agregar el proyecto de Altium de la placa adaptadora para el DSP.
    [11386.stp, 1206 SMD Capacitor.STEP, 1206 SMD Resistor.STEP, 12664.stp, 14062.stp, 14640.stp, 19623.stp, 29207.stp]
2022-05-16 Modificar las fuentes de alimentacion
    - Falta la fuente regulada de 15V para Vdd de los drivers (Sale a partir de alimentacion de 24V?)
    - El DSP se alimenta por +5V a traves de la placa de prueba
    - 3.3V para la proteccion a la salida del AO del ACS709
    - Agregada datasheet del regulador MC7805 de 12-18V a 5VP
    - Uso el pin de dead-time (DT) de los drivers para evitar corto en una pata del
    puente de MOSFETs (200ns de dead-time)
    [Fuentes.kicad_sch, Proyecto-KiCAD.kicad_sch, Sensores.kicad_sch]
2022-05-17 Cambiar drivers por ADuM4221 de Analog y completar alimentacion
    - UCC21540 y UCC27200 sin stock:
    - Reemplazado por el ADuM4221/ADuM4221-1 de Analog, que es muy similar
    - Alternativa el LTC7061, que tiene DT pero no es aislado
    - Aisladores sin stock, falta buscar un reemplazo
    - Agregadas las hojas de datos
    - LM5056A con poco stock (Hay que comprar muy pronto)
    - Completada la lista de componentes con todos los integrados/diodos/transistores
    - Agregada nota de aplicacion sobre peak source y sink current
    - Agregadas bibliotecas del ADuM4421 y LM5056A bajadas de las paginas de Analog y TI respectivamente
    [Fuentes.kicad_sch, Proyecto-KiCAD.kicad_sch, Sensores.kicad_sch]
2022-05-19 Reemplazar ISO1641 por aislador SI8642 (en stock)
    - Agregar su datasheet y incluirlo en la lista de componentes
    - Conectar tambien la linea de recepcion de datos del LM5056A
    [Fuentes.kicad_sch, Proyecto-KiCAD.kicad_sch, Sensores.kicad_sch]
2022-05-21 Reemplazar aislador por ISO7242 (4 canales 2/2)
    - Hay ISO7242 en el LEICI, asi que se puede usar ese directamente
    - Ver de comprar los drivers aca y como mucho ponerle optoacopladores si no se consiguen drivers aislados
    - Conectado tambien el pin de alerta de SMBus del LM5056A
    - Reemplazar el ACS709 por otro sensor, porque el ACS del laboratorio es el X35BB (35A de corriente)
    [Proyecto-KiCAD.kicad_sch, Sensores.kicad_sch]
2022-05-23 Seleccion definitiva de drivers y sensores (ya comprados)
    - Driver Infineon 2ED21834-S06J: Con DT y sin asilamiento
    - Optoacopladores ACPL-P480 para aislarlos
    - Falta implementarlos (drivers y optos) en el esquematico
    - LM5056 como sensor de corriente de entrada y tension de entrada/salida
    - Sensor de efecto hall TMCS1100A4 para corriente de salida
    - Ya esta agregado al esquematico (reemplazo ACS709)
    [Fuentes.kicad_sch, Proyecto-KiCAD.kicad_sch, Sensores.kicad_sch]
2022-05-25 Reemplazar drivers aislados por driver+optos
    - Solo faltaria ver la alimentacion de +15V para los dos drivers
    [Fuentes.kicad_sch, Proyecto-KiCAD.kicad_sch]
2022-05-27 Agregar alimentacion de 10V para los drivers
    - Usar LM2576T-ADJ para obtener salida de 10V con 3A de Iout_max (1.1A
    por driver se necesitan)
    - Preguntar si esta bien, porque requiere un inductor de 100uH, si no
    usar alimentacion externa de 24V y un regulador normal de 15V
    [Fuentes.kicad_sch, Proyecto-KiCAD.kicad_sch]
2022-05-30 Empezar a arreglar los errores del ERC de KiCad
    - Quedan muchos warnings pero un error de input power pin not driven
    - Hay que hacer el esquematico general con alimentacion y preguntar
    sobre el regulador de 10V
    [Fuentes.kicad_sch, Proyecto-KiCAD.kicad_sch, Sensores.kicad_sch]
2022-06-01 Comenzar el diagrama mas detallado (en draw.io)
    - Remover el regulador de 10V para los drivers, ahora se alimentan
    directamente desde los 12-18V sin regulación
    - Por hacer:
    - Falta agregar la alimentación y algunos labels en el diagrama
    - Remover la hoja de datos del regulador de 10V
    - Pasar todos los componentes a subsheets como en la placa adaptadora,
    de manera que quede como un diagrama de bloques
    - Una vez hecho eso, agregar el circuito de la placa adaptadora al
    proyecto (tiene que ser todo una plaqueta)
    [Fuentes.kicad_sch, Proyecto-KiCAD.kicad_sch]
2022-06-02 Finalizar el diagrama detallado
    Por hacer:
    - Reoriganizar el esquemático de KiCad como pidió Jorge
    - Preguntar sobre la alimentación de la placa adaptadora
    - Incorporar la placa adaptadora al diseño
    [Diagrama.sch, Proyecto-KiCAD.kicad_sch, Sensores.kicad_sch]
2022-06-03 Reestructurar el esquemático, con todo en heirarchical sheets
    - Agregar la sheet de la placa adaptadora del DSP
    - Completar la sheet del DSP con el proyecto de la placa adaptadora
    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
    [Conversor.kicad_sch, DriversOptos.kicad_sch, Fuentes.kicad_sch, PlacaDSP.kicad_sch, Proyecto-KiCAD.kicad_sch, Sensores.kicad_sch]
2022-06-07 Comenzar a pasar la placa adaptadora al proyecto
    - Agregar a bibliografia info sobre la ControlCARD del TMS320F28335
    (pinout del DIMM100 incluido)
    - Agregar el proyecto importado a KiCad de la placa adaptadora
    - Terminar de pasar la placa adaptadora, viendo que cosas no son
    necesarias (como la entrada de 12V separada)
    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
    [14640.stp, 19623.stp, 29207.stp, 5915.stp, 712515101.stp, C-1206.STEP, CircuitWorks-SO-8.step, CircuitWorks-SOT-223.step]
2022-06-08 Seleccionar componentes de los que me dieron y seguir con la placa adaptadora
    - OpAmp OPA365AID para acondicionamiento de señales del sensor de efecto
    hall
    - Los optos que hay son ACPL-P343 en vez de P480, que necesitan 15-30V
    de alimentación. Preguntar si no es mejor cambiarlos por 6N137, de 5V de
    Vcc
    - Regulador solo hay LM7805 de 5Vout pero también necesito 3.3Vout
    - No hay ningún diodo en las cosas que me dieron
    - Preguntar por los 6N137 y algun regulador de 3V3 out
    - Preguntar por los diodos del puente del conversor
    - Terminar de pasar la placa adaptadora del DSP
    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
    [Diseno_referencia.kicad_pcb, Diseno_referencia.kicad_sch, DriversOptos.kicad_sch, Fuentes.kicad_sch, PlacaDSP.kicad_sch, Proyecto-KiCAD.kicad_sch, Sensores.kicad_sch, driver y convertidor.kicad_sch]
2022-06-08 Agregar simbolo, footprint y modelo 3D del slot DIMM100
    [Proyecto-KiCAD.kicad_sch, socket-interfaces.kicad_sch]
2022-06-09 Continuar el paso de la placa adaptadora al proyecto
    - El bloque de encoder y DAC se eliminan, no son necesarios
    - Hay que agregar un selector entre 5V externo y por USB para el DSP, y ver como compatibilizarlo con la alimentación general
    - Para el regulador de 3.3V se usa el mismo integrado que en la placa adaptadora (TI LP2985-3.3)
    - Los optos son los ACPL-P480 en vez de los P343
    - Terminar la placa adaptadora (USB-UART, Power Supply e I2C)
    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
    [14640.stp, 19623.stp, 712515101.stp, C-1206.STEP, CircuitWorks-SO-8.step, CircuitWorks-SOT-223.step, CircuitWorks-SOT-23-5.step, DriversOptos.kicad_sch]
2022-06-10 Terminar (casi) el traspaso de la placa adaptadora al proyecto
    - Queda el selector entre 5V USB y 5V extern, pero todo esta en la hoja
    de alimetación general, no dentro de la hoja del DSP
    - Cambiar un poco los headers para poder testear (separado en Headers
    5V, PWM, ADC, UART, I2C y GPIO)
    - Agregar la hoja de datos del LP2985-3.3 (regulador de +3V3)
    - Ver el tema de la asilacion de las lineas de datos I2C del LM5056,
    porque tiene que unirse a una sola linea de datos bidireccional a la
    salida del aislador (estan separadas para facilitar la aislación)
    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
    [DriversOptos.kicad_sch, Fuentes.kicad_sch, PlacaDSP.kicad_sch, Proyecto-KiCAD.kicad_sch, Sensores.kicad_sch, USB-UART.kicad_sch, power-supply.kicad_sch, power_supply.kicad_sch]
2022-06-10 Unir las lineas de SDAI y SDAO a la salida del ISO7242C
    - Espejar el esquemático en la hoja de sensores, para que sea consistente la separación de Digital/Potencia
    - Verificar si es correcta la forma de conectar las lineas de datos a la salida del aislador
    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
    [DriversOptos.kicad_sch, PlacaDSP.kicad_sch, Proyecto-KiCAD.kicad_sch, Sensores.kicad_sch]
2022-06-13 Arreglar todos los errores del ERC
    - Agregar flags de 'Not Connected' a pines flotantes
    - Agregar resistencias 'falsas' para eliminar los errores de 'Power
    input pin not connected to Power output pin'
    - Agregar un GND1 conectado a PWR_FLAG para arreglar errores
    - Además, agregar bien al proyecto la placa adaptadora importada a KiCad
    [DAC.kicad_sch, DriversOptos.kicad_sch, Fuentes.kicad_sch, Proyecto-KiCAD.kicad_sch, Sensores.kicad_sch, USB-UART.kicad_sch, USB-uart.kicad_sch, encoder.kicad_sch]
2022-06-13 Comenzar a asignar footprints a todos los componentes
    - Agregado un header para conectar el módulo de tarjeta SD de Arduino
    por SPI
    - Los GNDs conectados por resistencias nulas son para conectar los GNDs
    en caso de que fuera necesario
    - Agregar una nota de aplicaión de aislación para I2C (creo que como
    estan conectados SDAO y SDAI está bien)
    [Conversor.kicad_sch, DriversOptos.kicad_sch, Fuentes.kicad_sch, PlacaDSP.kicad_sch, Proyecto-KiCAD.kicad_sch, Sensores.kicad_sch, USB-UART.kicad_sch, socket-interfaces.kicad_sch]
2022-06-13 Agregar template de informe
    - Solo cambiar la información de la carátula
2022-06-15 Comenzar el layout de componentes de la PCB
    - Todos los componentes con footprints asignados (preliminar)
    - Organizados los componentes de la placa adaptadora en el esquema del
    PCB (usando como guia aproximada la placa adaptadora)
    [Conversor.kicad_sch, DriversOptos.kicad_sch, Fuentes.kicad_sch, Proyecto-KiCAD.kicad_pcb, Proyecto-KiCAD.kicad_sch, Sensores.kicad_sch, USB-UART.kicad_sch, socket-interfaces.kicad_sch]
2022-06-16 Reempezar el ordenado de componentes del PCB
    - Intentar copiar mas a la placa adaptadora en la parte del DSP (digital)
    - Algunas cosas (como los headers y la parte de USB) se movieron para hacer entrar mejor las cosas
    - Layout bastante completo
    - Agregados algunos modelos 3D faltantes
    - Mover y reorganizar la parte del LM5056, porque tiene una pata que va al secundario, y ahora esta muy lejos del area de GND2
    - Ver como reorganizar un poco para que no queden esquinas vacias
    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
    [Conversor.kicad_sch, DriversOptos.kicad_sch, Fuentes.kicad_sch, Proyecto-KiCAD.kicad_pcb, Proyecto-KiCAD.kicad_sch, Sensores.kicad_sch, USB-UART.kicad_sch, socket-interfaces.kicad_sch]
2022-06-21 Terminar la parte digital de la PCB (incluidas las pistas)
    - Hay que ver si la clearance de 0.254mm para el plano de GNDD esta bien
    - Cambiar la footprint del FTDI por la version correcta
    - Borrar R37, R38 y R39 (usadas para corregir errores del ERC)
    - Terminar las otras dos partes de la placa
    - Consultar si esta bien lo que hice hasta ahora
    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
    [Conversor.kicad_sch, Fuentes.kicad_sch, Proyecto-KiCAD.kicad_pcb, Proyecto-KiCAD.kicad_sch, Sensores.kicad_sch, USB-UART.kicad_sch, socket-interfaces.kicad_sch]
2022-06-22 Continuar con el diseño de la PCB
    - Agregar los agujeros de tornillos
    - Terminar la parte del secundario
    - Agregar el borde en Egde.cuts que causaba problema
    - Corregir las pista que no entran derechas a los pads
    - Cambiar las footprints de los conectores
    - Consultar de componentes como headers a Claus
    - Una vez terminada pedir cotización en las paginas que me pasó Jorge (Bookmarks de Firefox)
    - Ver de agrear un selector para la alimentación externa por header en la entrada de 12-18V (preguntar a Claus)
    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
    [Conversor.kicad_sch, Fuentes.kicad_sch, Proyecto-KiCAD.kicad_pcb, Proyecto-KiCAD.kicad_sch, Sensores.kicad_sch, socket-interfaces.kicad_sch]
2022-06-22 Cambiar el grosor de las pistas del primario de 1mm a 1.5mm
    [Proyecto-KiCAD.kicad_pcb]
2022-06-23 Terminar de rutear todas las pistas de cobre de la placa
    - Pistas de 4.5mm para las partes de 9A (primario) y 2mm para las de 4A (secundario)
    - Agregar doble capacitor en serie a la salida, para disminuir los requerimientos de tensión de cada capacitor
    - Falta ver si es necesario a la entrada
    - Agregar el circuito de medición de corriente a la entrada como recomienda la hoja de datos del LM5056
    - Agregar modelos 3D de los conectores (sacados de Irusta-Caravelli)
    - Preguntar por los componentes disponibles a Claus
    - Ver como entran los disipadores para MOSFETs y diodos
    - Asegurarse de la conexión de las dos líneas de datos de I2C despues del aislador
    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
    [Conversor.kicad_sch, Fuentes.kicad_sch, Proyecto-KiCAD.kicad_pcb, Proyecto-KiCAD.kicad_sch, Sensores.kicad_sch, socket-interfaces.kicad_sch]
2022-06-24 Continuar el emprolijado de la PCB
    - Agregar modelos faltantes y reemplazar incorrectos
    - Agregar los constraints de MayerPCB
    - Corregir los errores y warnings de DRC no relacionados con Silkscreen Overlap
    - Lo mismo del anterior commit
    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
    [Proyecto-KiCAD.kicad_sch, USB-UART.kicad_sch]
2022-06-27 Agregar el selector de alim. de 12V y seguir emprolijando la placa
    - Agregar modelos de los switches
    - Agregar algunos test points
    - Todo lo de los dos anteriores commits
    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
    [Conversor.kicad_sch, DriversOptos.kicad_sch, Fuentes.kicad_sch, Proyecto-KiCAD.kicad_sch, Sensores.kicad_sch, USB-UART.kicad_sch, socket-interfaces.kicad_sch]
2022-06-28 Arreglar según recomendaciones de componetes y generales de PCB
    - Cambiar todas las esquinas de las pistas por esquinas redondeadas
    - Aumentar la distancia de separación entre GNDD, GND1 y GND2
    - Lo mismo que los anteriores commits
    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
2022-06-29 Agregar archivos temporarios de KiCad al gitignore
    - No se trackean los archivos de backup
2022-06-29 Emprolijar la PCB
    - Agregar logo de FI
    - Redondear pistas faltantes
    - Aumentar la distancia del cobre al borde
    - acraca racuca
    [Conversor.kicad_sch, Proyecto-KiCAD.kicad_sch, Sensores.kicad_sch]
2022-06-29 Escribir primer párrafo del resumen
    - Falta la traducción a inglés y el segundo párrafo (usando como guía el
    trabajo de Irusta-Caravelli)
    - Cambiar nombre de 'Informe TPI' a 'Informe Trabajo Final'
2022-06-30 Terminar el resumen y hacer la versión en inglés (abstract)
2022-06-30 Commit para escribir que habría que hacer
    - Mantener el ancho de las pistas de alimentación constante
    - Ver las layout recommendation de todos los reguladores y resto de los
    integrados
    - Ver de hacer la footprint de la resistencia shunt con dos pads
    separados como esta en la hoja de datos
    - Falta ver el espacio para disipadores y las correcciones de Jorge
    [Proyecto-KiCAD.kicad_sch, socket-interfaces.kicad_sch]
2022-06-30 Progresar con los recomendaciones de Claus
    - Arreglar resistencia shunt y pistas de alimentación
    - Cambiados los simbolos de conectores de trafo, pila, inductor y carga
    por screw terminals, todavía no está actualizado en la PCB
    - Tambien terminar de ver las layout recommendations
    [Conversor.kicad_sch, Proyecto-KiCAD.kicad_sch, main.kicad_pcb, main.kicad_sch]
2022-07-02 Cambiar los conectores de trafo, inductor, pila y carga
    - Cambiar el 12V HD por el conector que mostró Claus
    - Ver las layout recommendations de los reguladores lineales
    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
    [Conversor.kicad_sch, Proyecto-KiCAD.kicad_sch]
2022-07-04 Agregar conectores de 12V y 5V, y seguir mas layout recommendations
    - Ademas, seguir emprolijando la placa
    - Agregar esquinas redondeadas a la placa
    - Ver las recomendaciones de Jorge
    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
    [Fuentes.kicad_sch, Proyecto-KiCAD.kicad_sch]
2022-07-04 Empezar con lar recomendaciones de Jorge
    - Agregar nota que contiene todas las recomendaciones (ticks en las que
    ya hice)
    [Conversor.kicad_sch, DriversOptos.kicad_sch, Fuentes.kicad_sch, Proyecto-KiCAD.kicad_sch]
2022-07-05 Corregir las cosas que me indico Jorge
    - Verificar las correcciones con Jorge
    - Ver si se consigue un capacitor mas chico (~20mm) para la entrada
    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
    [Conversor.kicad_sch, Fuentes.kicad_sch, Proyecto-KiCAD.kicad_sch]
2022-07-05 Arreglar modelos 3D faltantes y conector 5V externo
2022-07-06 Seguir emprolijando la plaqueta
    - Rehacer el layout de resistencias de pull-up del lado primario
    - Mover el LM5056 mas arriba para permitir que entre el capacitor de 25mm de diametro
    - Cambiar cosas para seguir las layout recommendations de componentes:
    - Sacar todo el cobre de abajo del ISO7242M y re-rutear acordemente
    - Reorganizar las R y C del Op-Amp según indica la hoja de datos
    - Últimas verificaciones y ya mandar mail a MayerPCB para ir cotizando todo (cotización lista en una semana?)
    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
    [Conversor.kicad_sch, Proyecto-KiCAD.kicad_sch]
2022-07-06 Agregar a la lista de cosas por cambiar
    - Hacer bien la conexión del bus I2C al ISO7242, según explica la nota
    de aplicación SLYT403
2022-07-07 Solucionar la union de las lineas de datos I2C
    - Segun una evaluation board de Texas, si ya estan separadas las lineas
    de I2C como en este caso, solo hay que agregar un adaptador de push-pull
    a opne-drain a la salida del aislador
    - Se mandó el mail a MayerPCB
    [Fuentes.kicad_sch, Proyecto-KiCAD.kicad_sch, Sensores.kicad_sch, socket-interfaces.kicad_sch]
2022-07-08 Agrandar las vias para cumplir bien con los limites de MayerPCB
2022-07-08 Corregir pads de transistores y agregar gerbers al gitignore
2022-07-12 Poner el SN74LS06 (inversores open-collector) a la salida del ISO
    - Cambiar los planos de cobre de la zona digital:
    - Plano de cobre superior: +5VD
    - Plano de cobre inferior: GNDD
    [Proyecto-KiCAD.kicad_sch, Sensores.kicad_sch]
2022-07-12 Agregar resistencias de pull-up faltantes
    - Agregar resistencias de pull-up a la salida de cada inversor del
    74LS06
    - Crear plano de U5V en la capa superior alrededor del FTDI
    - Ponerle los valores a los componentes para poder generar correctamente
    el BOM (Bill of Materials)
    [Conversor.kicad_sch, DriversOptos.kicad_sch, Fuentes.kicad_sch, Proyecto-KiCAD.kicad_sch, Sensores.kicad_sch, socket-interfaces.kicad_sch]
2022-07-13 Eliminar resistencias de pull-up de SCL y SDAI
    - Se pueden remover las Rpu del lado del sensor ya que las Rpu de esas
    lineas estan del otro lado (la barrera de aislación proteje de daños).
    La de SDAO tiene que quedar por la salida open-drain del LM5056.
    - También cambiar las Rpu de 10k a 4k7, porque la capacidad del bus es
    muy baja (un solo esclavo y pistas cortas). Así se disminuye es rise
    time (Rpu*Cbus) a la mitad.
    [Conversor.kicad_sch, DriversOptos.kicad_sch, Fuentes.kicad_sch, Proyecto-KiCAD.kicad_sch, Sensores.kicad_sch, USB-UART.kicad_sch, socket-interfaces.kicad_sch]
2022-07-14 Cambiar las pistas del sensor hall por la planos de cobre
    - Según la recomendacion de la hoja de datos, es mejor que sean dos
    grandes planos de cobre desde el integrado hasta los pines donde
    proviene la corriente
    - Habría que tratar de acomodar las cosas para que la corriente venga
    directamente de arriba del integrado, como en la placa de evaluación del
    TMCS1100
2022-07-14 Cirregir planos de cobre de sensor hall para que entren mas verticales
    - Versión final (?)
2022-07-14 Emprolijar un par de pistas y acomodar según layout rec.
2022-07-15 Emprolijar pistas y asegurarse de que pase el DRC
2022-07-15 Seguir emprolijado innecesario
    [PlacaDSP.kicad_sch]
2022-07-16 Arreglar los primeros dos items marcados por Jorge
    - Usar EPWM1A/B y EPWM2A/B para poder usar la función de phase-shift de
    los modulos PWM y ahorrarse la sincronización manual
    - Agregar diodos de descarga D8 y D9 a la salida de los drivers
    - Agregar el Technical Reference Manual del DSP a la bibliografía
    (descripción ultra detallada de todas las funciones del DSP)
    [Conversor.kicad_sch, DriversOptos.kicad_sch, PlacaDSP.kicad_sch, Proyecto-KiCAD.kicad_sch, socket-interfaces.kicad_sch]
2022-07-16 Terminar el resto de los cambios de Jorge
    - Capacitores electroliticos para el circuito de bootstrap, en paralelo
    a los cerámicos
    - Cambiar el I2C a 3V3 del lado digital
    - Hacer la separacion de linea de datos de I2C del lado digital como en
    la nota de aplicación SLYT403A
    - Dejar el Vaux del LM5056A con un jumper por si acaso
    - Lo mismo con la resistencia de dead-time RDT de los drivers, dejar una
    footprint de resistencia SMD para poder cambiarlas de ser necesario
    [Conversor.kicad_sch, DriversOptos.kicad_sch, Fuentes.kicad_sch, Proyecto-KiCAD.kicad_sch, Sensores.kicad_sch, USB-UART.kicad_sch, socket-interfaces.kicad_sch]
2022-07-20 Empezar (lentamente) con el informe
    - Mayormente refine el template, como titulos de seccion en small-caps
2022-07-20 Poner estilo a la carátula
    - Fondo todo del color del logo de la FI
    - Logo de la FI con colores invertidos
    - Texto blanco
2022-07-20 Conectar la entrada en desuso del ISO a tierra
    - Las entradas no se tienen que dejar flotantes. Salida flotante.
    [Sensores.kicad_sch]
2022-07-20 Seguir emprolijando el informe en vez de escribirlo
2022-07-20 Finalizar la PCB y mandarla a fabricar
    - Agregar cambios sugeridos por Jorge el 2022/07/22
    - Bloqueados todos los componentes de la PCB (no modificar más)
    [Conversor.kicad_sch, DriversOptos.kicad_sch, Proyecto-KiCAD.kicad_sch, Sensores.kicad_sch]
2022-07-22 Empezar a escribir en serio el informe
    - Escribir la parte de cambio climático de la introducción
    - Hacer el diagrama de la plataforma epxperimental (FC + Conversor +
    Carga + Control)
    Agregar una carpeta de diagramas de draw.io
2022-07-22 Arreglar el comentario incorrecto en una figura
2022-07-22 Continuar escribiendo la introducción
    - Ya está casi terminada
    - Falta un poco del texto, y hacer el diagrama definitivo para la figura
    1.3
    - Agregar dos cosas más a la bibliografía del proyecto
2022-07-23 Terminar el capítulo de introducción
    - Solo falta poner el diagrama del SHGE definitivo
    - Arrancar el archivo del segundo capítulo
2022-07-23 Agregar el diagrama definitivo del SHGE en la intro
    - Terminada la introducción
2022-07-27 Empezar el análisis de la plataforma (informe)
    - Pasar la explicación de la plataforma y la figura al segundo capítulo
2022-07-27 Empezar a escribir la parte de celdas de combustible
    - Figura 2.2 placeholder, hay que hacer una propia
2022-07-29 Continuar la subseccion de FC del capitulo 2
    - Figura placeholder del stack de celdas
    - Tambien corregir errores en Abstract
    - Agregar bibliografía
2022-08-01 Terminar la sub-subseccion de tipos de celdas
2022-08-02 Comenzar sección del modelo eléctrico de la celda
    - Siguen habiendo varias figuras placeholder indicadas en el informe
2022-08-03 Agregar información de la placa de evaluación del DSP
    - También hacer andar el proyecto ejemplo FlashingLeds
    [BH28xxxDockingStn-BOM[R2].xls, BH28xxxDockingStn[R2].pcb, BH28xxxDockingStn[R2].sch, BH28xxxQuickSpinTemplate.pcb, USB-DockingStn[R3].pcb, USB-DockingStn[R3].sch, USBDockingStation_BOM [R3].xls]
2022-08-08 (Informe) Empezar la descripción de las regiones de la curva
2022-08-08 (Informe) Empezar con las pérdidas de activación
2022-08-09 Guardar la BOM en formato de Excel/Calc
    [Proyecto-KiCAD.ods]
2022-08-09 (Informe) Terminar la parte del modelo electrico de la celda
2022-08-09 (Informe) Empezar la subsección del convertidor CC-CC
    - Tambien cambiar todas las instancias de conversor --> convertidor
2022-08-10 Pasar todo de PDFLaTeX a XeLaTeX/XeTeX
    - Usar Montserrat para la tipografía del informe y diagramas
2022-08-10 (Informe) Terminar de formatear bien los pesos de Montserrat
    - Agregar los 9 pesos distintos de la tipografía en vez de solo usar bf
    - Emprolijar el .tex principal
2022-08-10 (Informe) Terminar los párrafos intro. de convertidores
    - Funciona de vuelta XeLaTeX
2022-08-11 (Informe) Arrancar con el análisis de convertidores conmutados
2022-08-11 (Informe) Seguir la parte de Conv. conmutados
    - Agregar header y footer (falta ver el título de sección en el header)
    - Agregar libros a la bibliografía (Hart y Rashid)
    - Diagrama de Duty Cycle
2022-08-12 (Informe) Comenzar con la explicación del reductor
    - Figuras de los circuitos placeholder
    - Agregar una grilla al gráfico del duty cycle
    - Hay que ver como agregar distintos pesos a la tipografia en modo math
2022-08-12 (Informe) Arreglar el contador de páginas
    - Estaba adelantado 1, el índice era 6 y tenía que ser 5
    - Invertir los lados de los contadores porque habian quedado al revés
2022-08-13 (Informe) Cambios menores
    - Cambiar título de seccion 2 a 'Análisis de la Plataforma' y cambiar
    los nombres de archivos y carpetas correspondientes
    - Varias modificaciones menores de aspecto:
    - Texto 'Figura x.y' en small caps, sin italics y con espacio como
    separador
    - Secciones en indice en small caps y azul oscuro
    - Títulos de subsecciones en small caps
2022-08-13 (Informe) Agregar párrafo de diodo flyback en reductor
    - Modificar layout de título de sección
    - Secciones en \large en ToC
    - Cambiar el azul de titulos a uno mas claro
    - Emprolijar el archivo principal (comentarios y eliminar duplicados)
2022-08-14 (Informe) Seguir con el reductor y empezar a llenar el .bib
    - Cambiar títulos de subsecciones y subsubsecciones
    - Agregar la seccion de referencias a la ToC
2022-08-14 (Informe) Arreglar hyperref, faltaba un paquete de MikTeX
    - Emprolijar comentarios
    - Mejorar el código de las páginas en blanco
2022-08-15 (Informe) Seguir con la bibliografía
    - Terminado hasta la parte escrita que hay de celdas (Faltan las fuentes
    de la parte de convertidores)
2022-08-15 (Informe) Varios cambios no de contenido
    - Agregar LEICI a la carátula
    - Cambiar el espaciado del índice
    - Cambiar subtítulos de capítulos
2022-08-15 (Informe) Empezar análisis detallado del reductor
    - Agregar Hart, Rashid y Ruan a las referencias (todavía no hay citas en
    el texto)
2022-08-15 (Informe) Algunos cambios de origanizacion
    - Cambiar los itemize de tipos de celdas a \paragraph
    - Cambiar los enumerate de las regiones de la curva V-I a \subparagraph
2022-08-16 (Informe) Empezar la seccion de no aislados
    - Cambiado el estilo de header y footer (Está el viejo comentado por las
    dudas)
2022-08-16 (Informe) Empezar con el convertidor forward
    - Hacer mis propias figuras para los circuitos reductores, y para el
    primero del desarrollo del forward
2022-08-16 (Informe) Arreglar el orden de header y footer
    - Después de probar imprimirlo, hay que invertir el footer en paginas
    pares/impares, pero no el header
2022-08-17 (Informe) Empezar con el forward de dos llaves
    - Ordenar un poco el código de header y footer
2022-08-18 (Informe) Saltar del forward al push-pull
    - Ignoro el forward de dos llaves, porque se puede desarrollar el
    push-pull partiendo del forward
2022-08-18 (Informe) Pequeñas correcciones
    - Centrar texto en diagrama de plataforma
    - Agregar espacio entre párrafos faltante
    - Eliminar mención del elevador
2022-08-18 (Informe) Terminar el subparrafo del forward double-ended
    - Al final hay que desarrollarlo para poder derviar el puente completo
    - Va Forward -> Double Ended -> Push-Pull
2022-08-18 Arreglar algunas cosas del BOM
    [Proyecto-KiCAD.ods]
2022-08-19 (Informe) Empezar la sección del full-bridge
    - Ahora se usa \highlight además de \boxed para las ecuaciones que son
    directamente relevantes al trabajo (como la de la curva de la celda)
    - Hacer las figuras de todos los convertidores hasta el push-pull
    - \newpage entre subsecciones (siempre arranca subseccion en una página
    nueva)
    - Título de subsubseccion en Bold en vez de SemiBold
2022-08-19 (Informe) Hacer la parte del emulador de celdas
    - Terminada la seccion de celdas del cap 2
2022-08-19 (Informe) Llegar al circuito de full-bridge (faltan figuras)
    - Agregar \\ al final de todos los parrafos a los que le siguen figuras
    (ya sean con [h] o [H])
2022-08-19 (Informe) Usar [h] para la mayoría de las figuras
2022-08-20 (Informe) Agregar forma de resistencia a la carátula
    - Usando el paquete eso-pic para poner imagenes de fondo
    - Agregado una imagen para los capitulos
2022-08-20 (Informe) Agregar una resistencia blanca en la carátula
    - Agregar dos caratulas alternativas, con inductor y onda cuadrada
    - Cambiar los tamaños de texto de autor, director y co-director
2022-08-20 (Informe) Cambiar resistencia por inductor en carátula
2022-08-21 (Informe) Usar Fraunces para el subtítulo de la carátula
2022-08-22 (Informe) Reestructuración de la carátula
    - Agregar el paquete morsize para tener \HUGE
2022-08-22 (Informe) Empezar el tercer capítulo (Diseño)
    - El segundo capítulo no está terminado
2022-08-23 (Informe) Arreglar diseño de carátula
    - Inductor (invertido) arriba en vez de abajo, y usando un mejor símbolo
    - Centrar bien los logos de abajo y cortar el logo de FI para que llegue
    hasta los bordes
2022-08-23 Agregar información de cada componente en la BOM
    - Está todo en la última columna
    [Proyecto-KiCAD.ods]
2022-08-24 (Informe) Espaciar más la carátula
2022-08-24 (Informe) Seguir con el capítulo 3
    - Detallar los 6 bloques que componen el diseño de la plataforma
    - Escribir una sección de consideraciones generales de diseño
2022-08-25 (Informe) Terminar la parte de Consideraciones Generales del Cap 3
    - LLEGO LA PLACA
2022-08-25 (Informe) Agregar archivos para cada subsección de cada cap.
    - Anotado el modelo de la carga variable
2022-08-26 Emprolijar el excel de componentes
    [Proyecto-KiCAD.ods]
2022-08-26 (Informe) Empezar la parte de diseño del convertidor
    - Empezar la búsqueda de componentes a partir de la BOM
2022-08-29 (Informe) Empezar la selección de las llaves
2022-08-30 (Informe) Casi terminada la parte de selección de llaves
    - Ver bien como organizar la tabla con los datos de IRFP150
2022-08-30 (Informe) Terminar la parte de seleccion de las llaves
2022-08-31 (Informe) Terminar la parte necesaria del driver
    - Falta la explicación del circuito interno, para después
2022-08-31 (Informe) Terminar la parte de seleccion de diodos rect.
2022-09-01 (Informe) Empezar con el diseño de sist. de medición
2022-09-01 (Informe) Explicar medición de corriente por shunt
2022-09-02 (Informe) Terminar la explicación de tipos de sensores
    - Ahora la selección
2022-09-05 (Informe) Terminar parte del TMCS1100A, empezar LM5056A
    - Después falta acondicionamiento de la salida del TMCS y transmisión de
    datos por I2C del LM5056A
2022-09-06 (Informe) Casi terminar la parte de sensores de la 3.4
2022-09-06 (Informe) Terminar sensores y empezar acondicionamiento
    - Agregado un scan con las cuentas, esta vez correctas, del circuito de
    acondicionamiento
    - Actualizar la lista de componentes del Drive con resistores de 33k en
    vez de 27.4k
2022-09-06 (Informe) Terminar la parte de cálculos de acondicionamiento
    - Falta la selección del OPA365
2022-09-07 (Informe) Empezar con la etapa de aislación
    - Agregar indicadores de placeholders en las secciones que se van a
    dejar sin completar para la entrega intermedia
2022-09-08 (Informe) Empezar con la parte de los ACPL-P480
2022-09-08 (Informe) Casi terminar la parte de aislación
    - Falta la parte de la separación de líneas de datos de I2C
2022-09-08 (Informe) Terminar la parte de la etapa de aislación
    - En realidad falta una explicación de las tecnologías de aislación,
    pero queda para el informe final.
2022-09-09 (Informe) Casi terminar la sección de alimentación
    - Falta la parte del lado digital, y algún comentario de los selectores
    de alimentación
    - Falta la sección de diseño del controlador
    - Agregar sección de resumen al final de cada capítulo
2022-09-11 (Informe) Terminar la sección del circuito de alimentación
    - Todas las partes del sistema de control quedan para el informe final
    - Agregar texto que aclare que esa sección esta incompleta o sin empezar
    (donde corresponda)
    - Terminar sección de diseño del convertidor
    - Agregar algunas figuras que quedaron placeholder (la 2.2, 2.3, 2.4,
    2.16, 2.17, 2.18, 3.1, 3.5)
    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
2022-09-12 (Informe) Versiones definitivas de figuras 2.2, 2.3 y 2.4
    - Agregar fondo para la primer hoja de cada capítulo
    - Cambiar figuras 2.16, 2.17, 2.18, 3.1, 3.5 por versiones definitivas
    - Terminar la sección de diseño del convertidor
    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
2022-09-12 (Informe) Agregar todas las figuras que faltaban
    - Terminar sección de diseño de convertidor
    - Completar la parte de I2C de la sección de sistema de medición
    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
2022-09-15 (Informe) Remover el párrafo de la corrección de Kike
    - Es el par de párrafos que van junto con la ecuación del divisor
    resistivo de la sección del convertidor del capítulo 2
    - No es necesario tanto detalle, no tienen que ser más de 100 páginas.
2022-09-15 Empezar el informe de PPS
    - Copiado el informe final y cambiada la portada
    - Cambiar tamaño de Director y Co-Director en la portada del informe
    final
2022-09-16 Hacer placa adaptadora
    - Puede que necesite más espacio para el disipador
    [Placa-Adaptadora.kicad_pcb, Placa-Adaptadora.kicad_sch]
2022-09-19 Poner transistores en el borde la placa adaptadora
    - Ahora la pista de Drain va entre los dos transitores
    - La pista de Gate rodea por atrás del footprint correcto y entra por el
    costado del footprint correcto
    - Esto permite pegar la parte de atrás de los transistores al borde de
    la placa y se puede montar el disipador en el piso, asi no le hace peso
    a la placa y soldaduras
    - Dist. minima 0.5mm
2022-09-20 Borrar la placa grande del archivo
2022-09-20 (Informe PPS) Terminar el capítulo de introducción
2022-09-21 (Informe PPS) Empezar el capítulo de desarrollo del informe
    - Sección de Consideraciones Generales
2022-09-22 (Informe PPS) Agregar imagenes de PCB, en 3D y capas de cobre
    - Reestructurar el desarrollo:
    - Primero una seccion con una descripción circuital (breve) de cada
    bloque de la plataforma
    - Después la sección de implementación en PCB
2022-09-23 (Informe PPS) Empezar con la parte de implementación en PCB
    - Dejo el detalle de los circuitos para después
2022-09-26 (Informe PPS) Hacer tabla de componentes
    - Empezar sección de posicionamiento de componentes
2022-09-27 Agregar lista de componentes a comprar
    - Cambiar el valor de dos capacitores (filtro de salida del regulador de
    3.3 y filtro de salida de la alimentación no regulada)
    [Componentes DICOMSE.xlsx, Componentes Microelectronica.xlsx, Fuentes.kicad_sch, Proyecto-KiCAD.kicad_sch]
2022-09-27 (Informe PPS) Empezar la parte de posicionamiento de componentes
    - Hay una versión vieja del repositorio en Downloads para sacar imágenes
    del progreso
2022-09-27 (Informe PPS) Seguir con la parte de ubicación de componentes
    - Reorganizar un poco las secciones del capítulo 2
    - Modificar ligeramente la figura de las capas de cobre
    - Agregar archivos terminados en # al gitignore
2022-09-28 Terminar las listas de componentes de ambos vendedores
    [Componentes DICOMSE.xlsx, Componentes Microelectronica.xlsx]
2022-09-28 (Informe PPS) Terminar la parte del convertidor en PCB
    - Modificar la imagen de la medicion Kelvin en ambos informes
2022-09-29 (Informe PPS) Reestructurar todo el informe
    - Tiene que ser alrededor de 5 páginas de texto, que contenga las
    actividades realizadas y las dificultades y contratiempos
    - La conclusión va en la sexta página
2022-09-30 (Informe PPS) Falta la parte de Dificultades y Contratiempos
    - También la Conclusión y poner la figura definitiva de los encapsulados
2022-09-30 (Informe PPS) Empezar la parte de Contratiempos
2022-10-06 Agregar firmware de DSP de ejemplo de Jorge
    [Example_freqcal.xls, Example_posspeed.xls]
2022-10-06 Agregar proyecto de PWM para phase-shift
    - Modificar algunos comentarios para entender mejor como anda
2022-10-06 Bajar notas de aplicación sobre cosas del C2000
    - Sacados del Resource Explorer dentro del CCS
    - Ahí también hay videos sobre bibliotecas de control y otras cosas
    del DSP
2022-10-11 Empezar el proyecto del firmware del DSP
    - Configurar GPIO y PWM
    - Todas las funciones de configuración en 'ConfigInit.h'
2022-10-12 Agregar más cosas a las funciones de setup
2022-10-13 Probar la salida PWM en el osciloscopio
    - Tanto para el PWMxA y PWMxB, se toma el ciclo de trabajo de CMPA (CAD
    y CAU iguales para AQCTLA y AQCTLB).
    - Setear bien el CTRMODE de ePWM2
    - Funciona, captura en el celu
2022-10-13 Agregar la funcionalidad de dead-band
    - Dead-Band de 200ns (Active High, porque el driver invierte la señal de
    abajo)
    - Con esta funcionalidad, no es necesario setear acciones en ePWMxB
    cuando llega a CMPA, se encarga de eso el modulo de DB
    - Agregar un loop en main que cicla entre fase 0° y 180°, ida y vuelta
    - Organizar un poco las funciones de seteo de PWM
2022-10-17 Comprobar los componentes y empezar a soldar
    [Componentes DICOMSE.xlsx, Componentes Microelectronica.xlsx]
2022-10-19 Corregir Informe PPS según recomendaciones de Claus
    - También cambiar una figura compartida con el Informe Final
2022-10-20 Agregar capturas de pruebas de drivers con el osciloscopio
    [F0000CH1.CSV, F0000CH2.CSV, F0001CH1.CSV, F0001CH2.CSV, F0002CH1.CSV, F0002CH2.CSV, F0003CH1.CSV, F0003CH2.CSV]
2022-10-25 Hacer placa adaptadora en ATEI
    [Placa-Adaptadora.kicad_pcb]
2022-11-02 Agregar pruebas de conmutacion de llaves
    - Nombres temporarios
    [F0000CH1.CSV, F0000CH2.CSV, F0001CH1.CSV, F0001CH2.CSV, F0002CH1.CSV, F0002CH2.CSV, F0003CH1.CSV, F0003CH2.CSV]
2022-11-02 Poner nombres adecuados a las capturas de los ensayos
    [F0012CH1.CSV, F0012CH2.CSV, F0012MTH.CSV, F0013CH1.CSV, F0013CH2.CSV, F0013MTH.CSV, F0014CH1.CSV, F0014CH2.CSV]
2022-11-03 Agregar script inicialde gráfico de MATLAB para informe
    [F0015CH1.CSV, F0015CH2.CSV, F0015MTH.CSV, F0022CH1.CSV]
2022-11-03 Seguir el script de gráficos de MATLAB
    [F0015MTH.CSV, LEG1-0.CSV, LEG1-120.CSV, LEG1-150.CSV, LEG1-180.CSV, LEG1-30.CSV, LEG1-60.CSV, LEG1-90.CSV]
2022-11-04 Agregar código para cambiar fase con pulsadores
    - Utiliza los interrupts externos XINT1 y XINT2
    - Implementa indicador de fase con los 4 LEDs
    - Se queda en modo Idle (Low Power Mode) mientras espera
2022-11-04 Debuggear y corregir código del DSP
    - Funcionan las interrupciones externas y se cambia bien el DC con los
    botones
    - Faltaría un código anti-rebote
2022-11-04 Agregar capturas de las pruebas del sistema completo con carga
    [F0001CH1.CSV, F0002CH1.CSV, F0004CH1.CSV, F0004CH2.CSV, F0008CH1.CSV, F0008CH2.CSV, F0009CH1.CSV, F0009CH2.CSV]
2022-11-08 (Informe) Completar la parte de la carga variable (2.4)
2022-11-11 (Informe) Seguir con la sección de convertidores del Cap 2
2022-11-14 (Informe) Terminar la parte del convertidor del cap. 2
2022-11-18 (Informe) Empezar la sección del controlador del cap. 2
2022-11-20 (Informe) Seguir la parte del DSP del cap 2
2022-11-22 (Informe) Terminar la sección del sist. de control (cap. 2)
2022-11-22 (Informe) Terminar el capítulo 2
    Completar la sección de resumen del capítulo
2022-11-24 (Informe) Terminar la parte del transformador
2022-11-24 (Informe) Terminar la sección 3.2 (diseño convertidor)
2022-11-24 (Informe) Terminar el faltante de la sección 3.3 (Driver)
2022-11-24 (Informe) Empezar la sección de I2C de 3.4
2022-11-25 (Informe) Commit intermedio de la parte de I2C (sin compilar)
2022-11-25 (Informe) Terminar la subsección de I2C de la seccion 3.4
    - Corregir algun par de errores de redacción y formateo en el resto del
    informe
2022-11-25 (Informe) Terminar (casi) el cap 3 y armar el esqueleto del 4
2022-11-25 (Informe) Terminar sección 4.1 de diseño de PCB
2022-11-26 (Informe) Terminar el capítulo 4
2022-11-26 (Informe) Comenzar la parte del sistema de control del cap 3
2022-11-26 (Informe) Seguir con la seccion 3.6 (Sistema de Control)
    - Completar la parte correspondiente del resumen
    - Agregar el esqueleto del capítulo de ensayos
2022-11-27 (Informe) Entrega preliminar a Jorge y Paul
    - Falta completar el capítulo de los ensayos, y las conclusiones
    [F0027CH1.CSV, F0027CH2.CSV, F0028CH1.CSV]
2022-11-27 (Informe) Empezar el capitulo final (ensayos)
    - Refinar el script de MATLAB para gráficos
    [7 - ILf.CSV, 7 - Vp.CSV, 7 - Vrect.CSV, F0027CH1.CSV, F0027CH2.CSV, F0028CH1.CSV]
2022-11-28 (Informe) Corregir error de abstract (falta compilar)
2022-11-28 (Informe) Terminar la sección 5.1
    - Compilar la corrección del abstract
2022-11-28 (Informe) Corregir las indicaciones de Paul
2022-11-28 (Informe) Seguir con el capítulo de ensayos
    - Completados los scripts para los gráficos
    [1 - DC50.RL100 - ILF.CSV, 1 - DC50.RL100 - IOUT(VRECT).CSV, 1 - DC50.RL100 - IOUT.CSV, 1 - DC50.RL100 - VOUT.CSV, 1 - DC50.RL100 - VRECT.CSV, 1 - DC50.RL100 - VS.CSV, 10 - DC25.RL30 - ILF.CSV, 10 - DC25.RL30 - VRECT.CSV]
2022-11-28 (Informe) Cambiar los archivos de los graficos
2022-11-29 (Informe) Commit intermedio para agregar un grafico
2022-11-29 (Informe) Agregar grafico para el caso 3 con carga
2022-11-29 (Informe) Solo falta la seccion 5.3 y las correcciones de Jorge
2022-11-29 (Informe) Terminar de escribir el informe
    - Faltan las correcciones de Jorge
2022-12-05 Cambiar el firmware por el que hizo Jorge
    - Tiene lo mismo que hice yo + los sensores
